bigtreetech/BIGTREETECH-SKR-PRO-V1.1/manual/SKR-PRO-V1.1-Wiring diagram.jpg

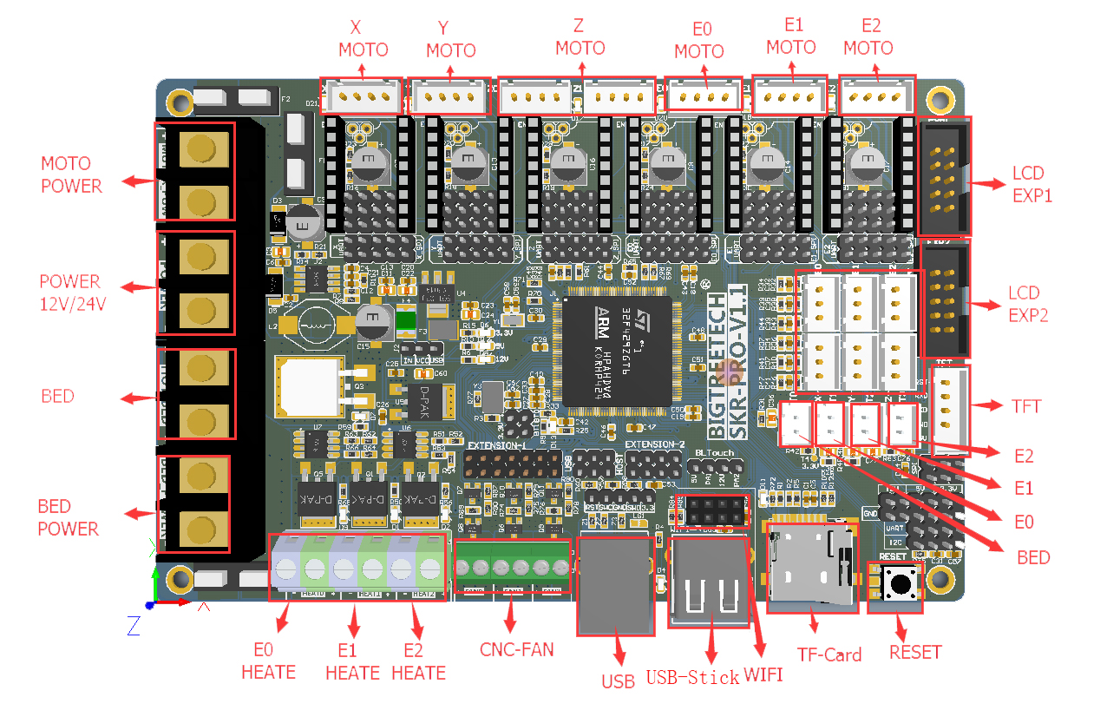
manual/SKR-PRO-V1.1-Wiring diagram.jpg
