bigtreetech/BIGTREETECH-SKR-PRO-V1.1/SKR-PRO-V1.2/manual/SKR-PRO-V1.2-Wiring diagram.jpg

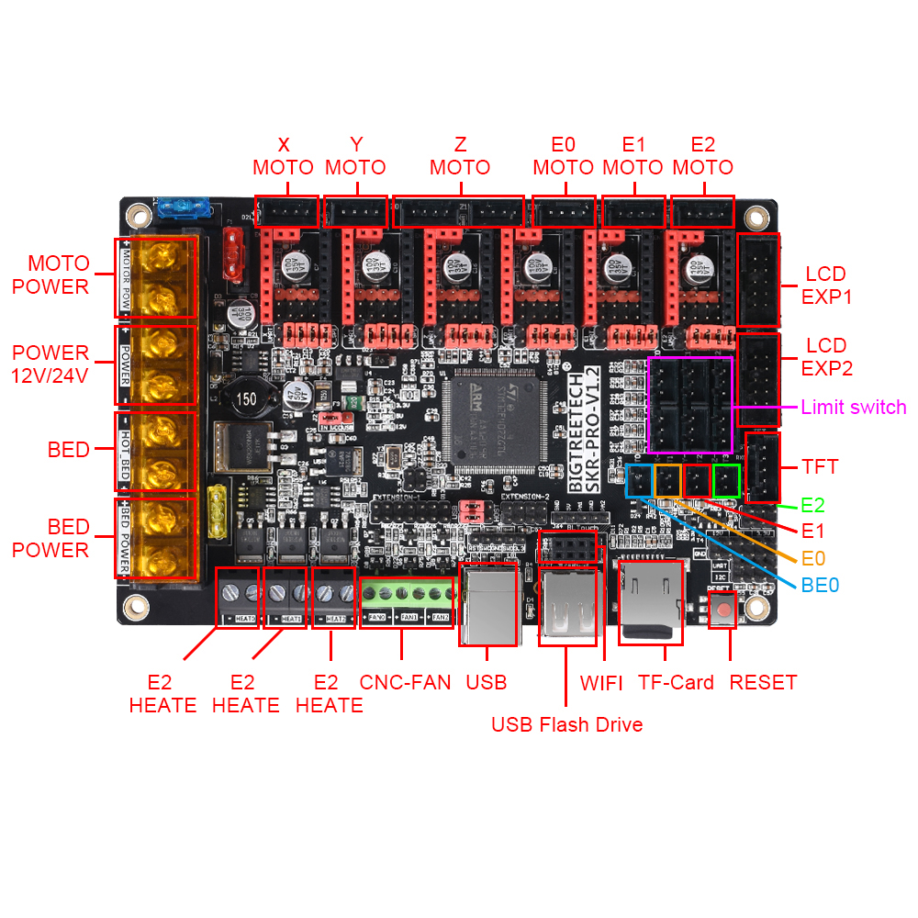
SKR-PRO-V1.2/manual/SKR-PRO-V1.2-Wiring diagram.jpg
