bigtreetech/BIGTREETECH-SKR-PRO-V1.1/README.md

# BIGTREETECH-SKR-PRO-V1.1
Aiming at some problems existing in 3D printed motherboards in the market. Bigtree Technology Co., Ltd. launched a high performance 3D printer master board with STM32F407ZGT6 as the core controller, BIGTREETECH-SKR-PRO-V1.1.
