bigtreetech/BIGTREETECH-SKR-PRO-V1.1/firmware/Readme.md

1. Sometimes an error occurs when compiling this branch for the first time. Please Close vscode and reopen, then compiling will be normal.
2. if you are downloaded from Marlin bugfix-2.0.x Official version. Please modify [here](https://github.com/bigtreetech/BIGTREETECH-SKR-PRO-V1.1/blob/9ae95e478c74dc1e5c7fec6d94e13c3bedf2169f/firmware/Marlin-SKR-Pro/platformio.ini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) from `TMCStepper@<1.0.0` to `https://github.com/bigtreetech/TMCStepper`. 
This is because the UART of tmc2208/2209 has not yet been merged into the official version, please use this method before merged

Note: if you want to design your own version naming rules, folder names must not exceed 64 characters in length, 
marlin 2.0 project files in other folders, folder nesting depth can not exceed 3, 
otherwise, when opening the project compilation project, there will be unexpected compilation errors!
It is recommended that the file name should not be named too long, the shorter the better. 
File nesting depth should not be too much, the less nesting, the better.
