bigtreetech/BIGTREETECH-SKR-PRO-V1.1/picture/BIGTREETECH-SKR-PRO-V1.1.jpg

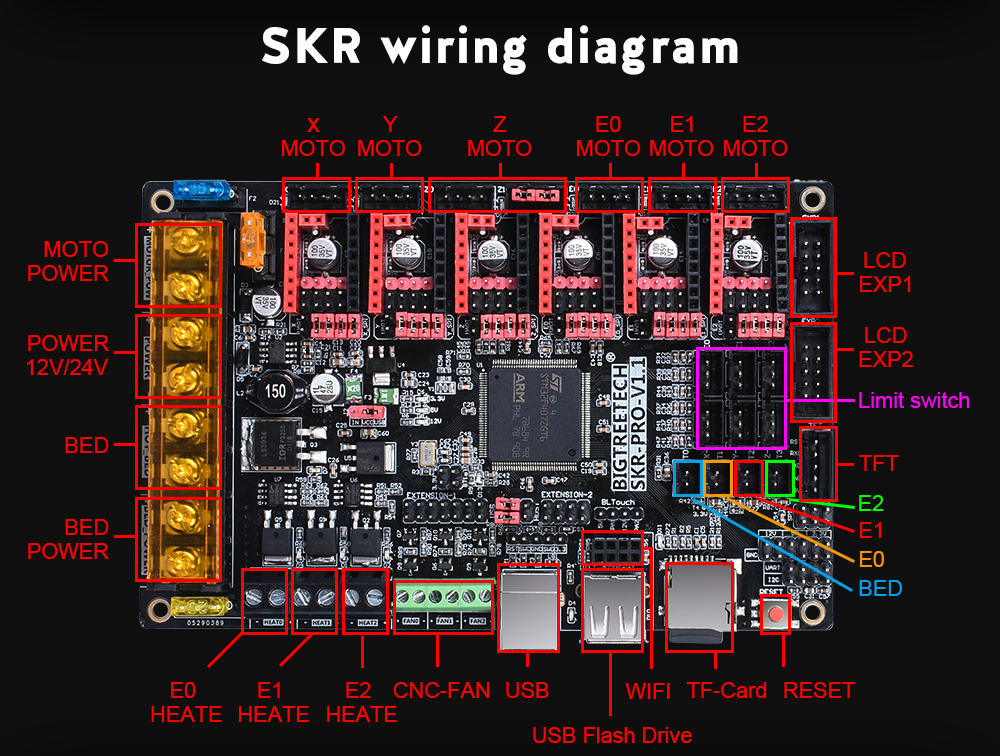
picture/BIGTREETECH-SKR-PRO-V1.1.jpg
