bigtreetech/BIGTREETECH-SKR-PRO-V1.1/picture/SKR PRO V1.1-1.png

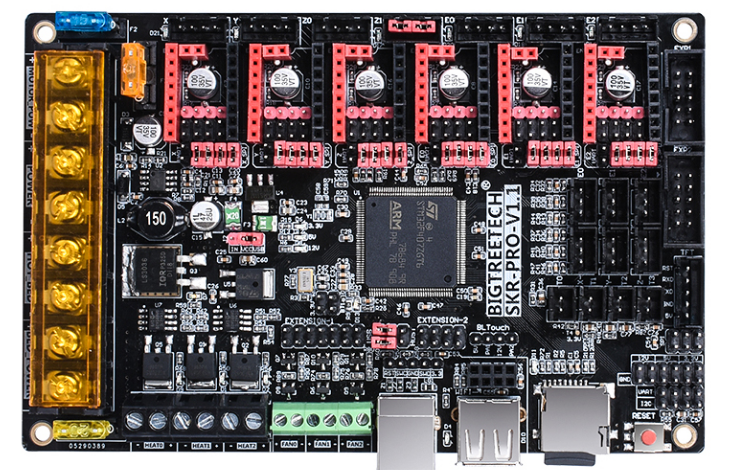
picture/SKR PRO V1.1-1.png
