bigtreetech/BIGTREETECH-SKR-PRO-V1.1/picture/SKR PRO V1.1-BOTTOM.png

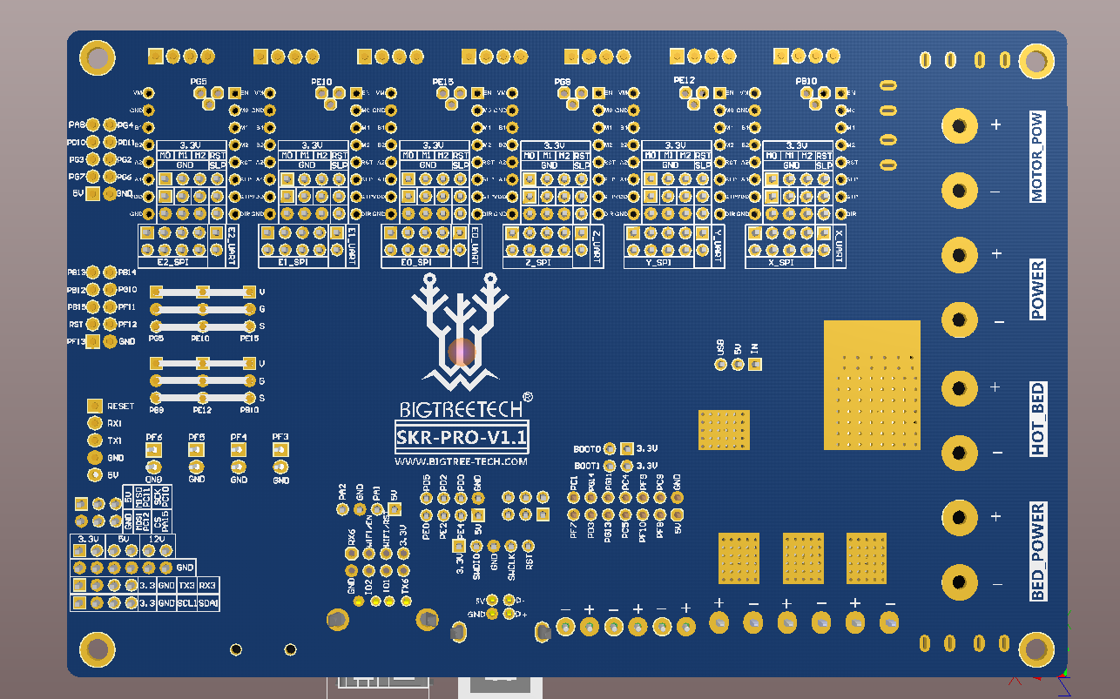
picture/SKR PRO V1.1-BOTTOM.png
