bigtreetech/BIGTREETECH-SKR-PRO-V1.1/picture/SKR PRO V1.1-TOP.png

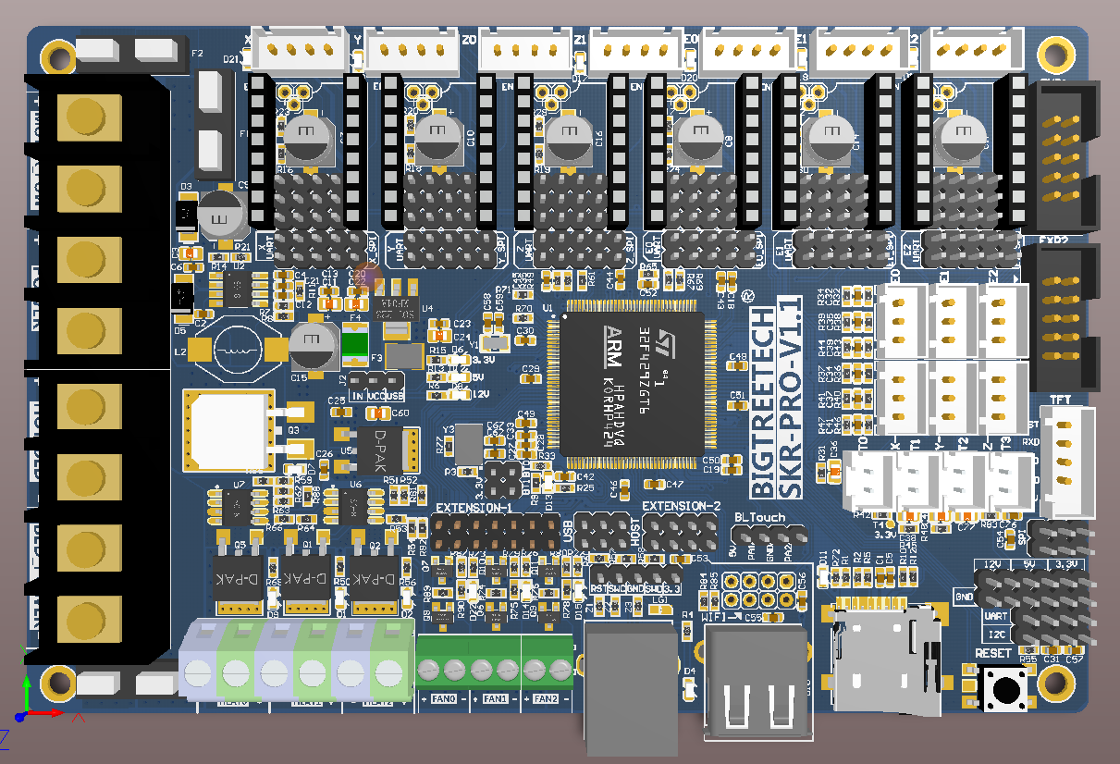
picture/SKR PRO V1.1-TOP.png
