bigtreetech/BIGTREETECH-SKR-PRO-V1.1/SKR-PRO-V1.2/picture/BIGTREETECH-SKR-PRO-V1.2_02.png

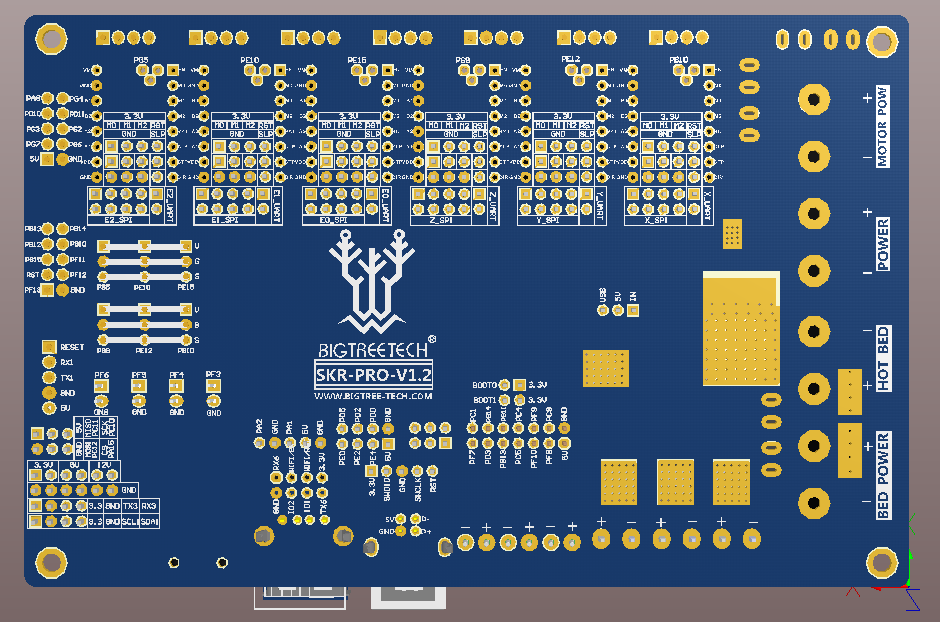
SKR-PRO-V1.2/picture/BIGTREETECH-SKR-PRO-V1.2_02.png
