bigtreetech/BIGTREETECH-SKR-PRO-V1.1/models/SKR-Pro-1.1-Complete-board.stl

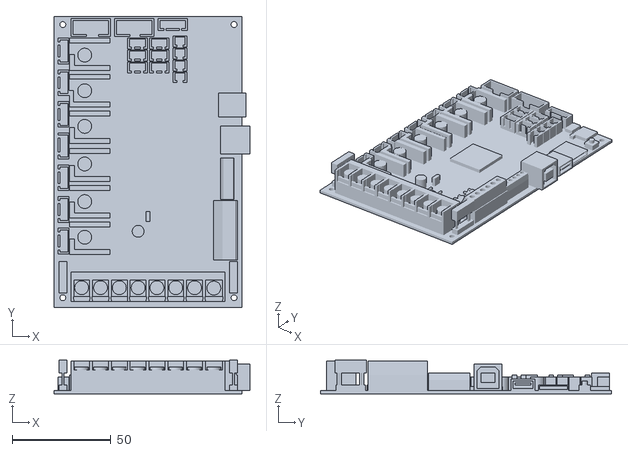
[picture p12: CAD file, 2019-07-18]
models/SKR-Pro-1.1-Complete-board.stl
99.0 x 147.0 x 17.1
