bigtreetech/BIGTREETECH-SKR-PRO-V1.1/SKR-PRO-V1.2/manual/SKR-PRO-V1.2-user manual.pdf

SKR-PRO-V1.2 User Manual Shenzhen Biqu Technology Co., Ltd.

Shenzhen City Fun Technology 1/18 | Website: www.BIGTREE-TECH.com

SHENZHEN BIGTREE TECHNOLOGY CO., LTDBIG TREE TECH

# BIGTREETECH

# SKR-PRO-V1.2

# user manual

SKR Pro V1.2 User Manual Shenzhen Biqu Technology Co., Ltd.

2 / 18

### Ⅰ、Product introduction

Aiming at some problems existing in 3D printed motherboards in

the market. Bigtree Technology Co., Ltd. launched a high

performance 3D printer master board with STM32F407ZGT6 as the

core controller, BIGTREETECH-SKR-PRO-V1.2.

### Ⅱ、the motherboard features

1) The main control uses the ARM-level Cortex-M4 series with a 32-bit dominant frequency of 168 MHz STM32F407ZGT6 chip, performance is greatly improved;
2) Equipped with highly modular open source firmware Marlin2.0, it

is convenient for users to DIY and further-development, to avoid

the worry of not being able to master the core code;

3) Visual Studio Code is a powerful development tool for Marlin2.0.

Its integrated development environment has the following

advantages: it supports online debugging, which is more helpful for

product development and performance optimization, and uses C

language for development, which is easy to get started.

4)The PCB board layout is rigorous and beautiful, and it is specially designed for heat dissipation.

5)Using a dedicated power chip, support 12-24V power input,

3 / 18

output current 3A.

6)With 24V input and the same power, the hot bed current can be

reduced to 1/4, effectively solving the heating problem of hot bed

MOS tube.

7) BIGTREETECH-2.8-inchTFT, and BIGTREETECH-3.5-inchTFT color touch screens are compatible, as are LCD2004 and LCD12864 screens.
8) The system supports Chinese simplified Chinese, English and other languages, which can be switched by itself.

9)The firmware is upgraded by SD card, which is simple, convenient and efficient.

10) Support Serial WIFI Online Printing.
11) 6 motor drives, 3 extruders, 3 CNC fans.
12) It has the following functions: data can be saved when power is cut off, materials can be discovered when broken, and works can be turned off when finished.
13) High performance MOSFET tube, better heat dissipation effect.
14) Using removable fuse to make the replacement process easier.
15) Reserve extended ports of BL Touch, PWM, ADC, UART, I2C and SPI.
16) Use the power supply option to separate the USB power supply from the switching power supply, which can effectively prevent the

4 / 18

computer USB port from being burnt due to a short circuit.
17) The special function interface uses a color-conspicuous row

pin to greatly reduce the error rate of the wiring.

18) As many as 20 expansion ports can be reserved, and extended ports can be used to add more features to the printer without worrying about the shortage of motherboard ports.

19)Support offline printing and online printing.

20) Support for dual Z axis printers (series dual Z).

### Ⅲ、Motherboard parameters

1)Appearance size: 147*95mm

2) Installation size:138 * 86.5 mm
3) Microprocessor: ARM 32-bit Cortex / M4 CPU
4) Input voltage: DC12V-DC24V

5)Motor driver support :TMC5160,TMC2208,TMC2130,ST820,LV8729,

DRV8825,A4988, etc.

6) Driving mode support: TMC2130SPI, TMC5160SPI, TMC2208 UART

5 / 18

7)Motor drive interface: X, Y, Z, E0, E1, E2,total 6 channels.

8) Temperature sensor interface: T0, T1, T2, T3 total 4 channels

100K NTC .(thermal resistance)

9) Display screen: BIGTREETECH- 2.8 inch TFT,BIGTREETECH-3.5

inch TFT, LCD2004,LCD12864

10) PC communication interface: square USB, convenient to plug and unplug, communication baud rate is 11520
11) Support Expansion Port: Automatic Shutdown Module After Printing , Power Off Resume Print Module , Filament break detection and Automatic leveling,
BL Touch, WIFI, PWM, ADC, UART, I2C and SPI,etc.

12)Support file format: g-code

13) Support machine structure: XYZ, delta, kossel, Ultimaker, corexy

14)Recommended software: Cura, Simplify3D, pronterface, Repetier-host, Makerware

15) multiple power supply, sharing the pressure of single power line under current.

### Ⅳ、Content of the upgrade

1） Change the hot bed interface screen printing;

6 / 18

2） | Change the position of the hot bed fuse, effectively deal
| with the overheating of the PCB at the bottom of the fuse
| when the hot bed is heated;
3） | Analog quantity (AD) input increased clamping diode,
| effectively protect the chip;

### Ⅴ、mainboard power selection

1. Power jumper cap selection
①USB power supply | ↓ | ②12/24 v power supply↓

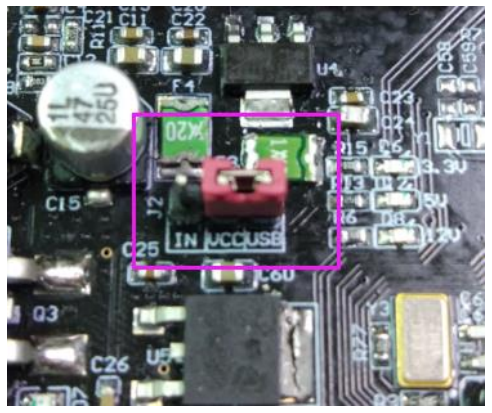
[picture p21: figure]
mainboard power selection
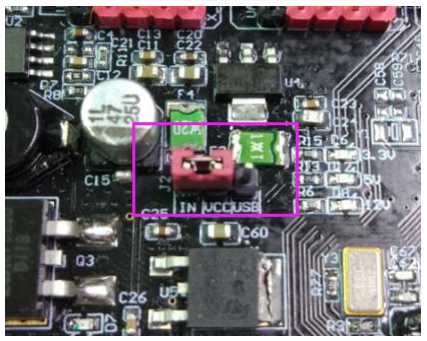
[picture p22: figure]

1)As shown in the red box, when the jumper cap is

connected to IN and VCC, the motherboard selects 12V/24V

power supply; when the jumper cap is connected to USB

and VCC, the motherboard selects USB power supply.

2) If the jumper cap has USB power selected, the 5V and

3.3V indicators will also light.

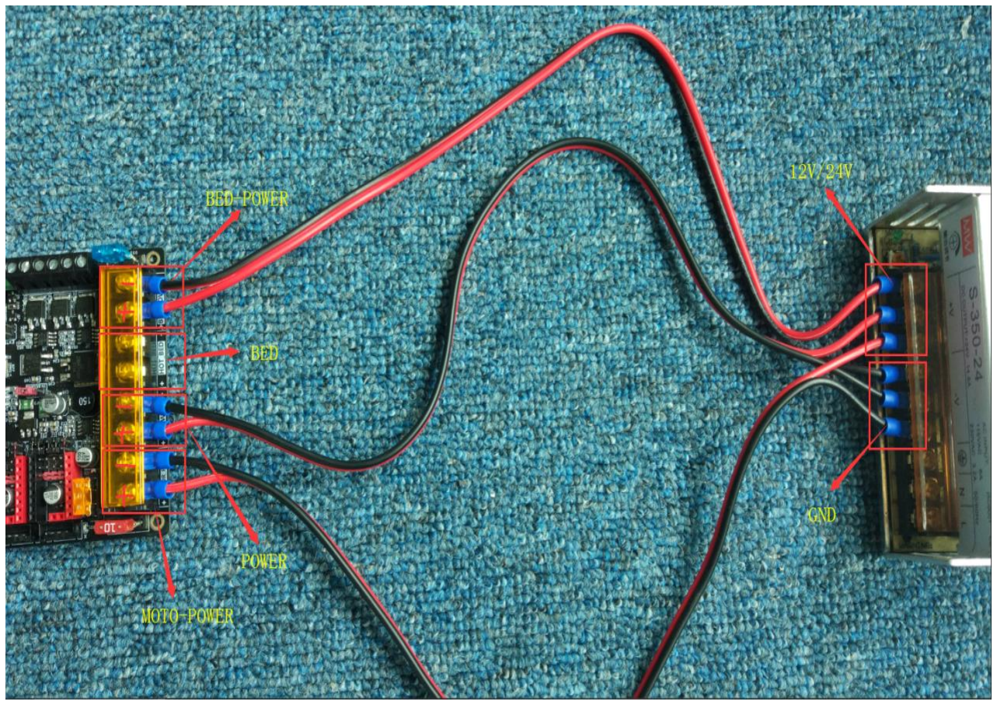
[picture p23: figure]

7 / 18

3) When the main board is powered by 12V/24V, the 12V

indicator will be lit. If the jumper cap has 12V/24V power

supply, the 3.3V, 5V and 12V indicators will be illuminated.

### Ⅵ、mainboard power wiring methods

1. Three Power supply method of switching Power supply

As shown above, three sets of power lines need to be

connected to the motherboard, namely, motor power supply,

hot bed power supply and motherboard power supply, and

the extra group is hot bed interface.

8 / 18

When connecting, be sure to disconnect the 220V power

supply and distinguish the positive and negative electrodes so

as not to burn out the motherboard.

### Ⅶ 、 Communication between motherboard and

### computer

After the motherboard is connected to the computer

through the USB cable, the computer will automatically install

the driver. In this case,the motherboard can be identified for

data transmission. If the installation fails, we can go to our

open source Web site:

https://github.com/bigtreetech?tab=repositories to find the

corresponding motherboard download driver.

After the drive installation is completed, open

the``Device Manager ”to see the port as shown in the figure

below, which indicates that the system board is properly

connected to the computer.

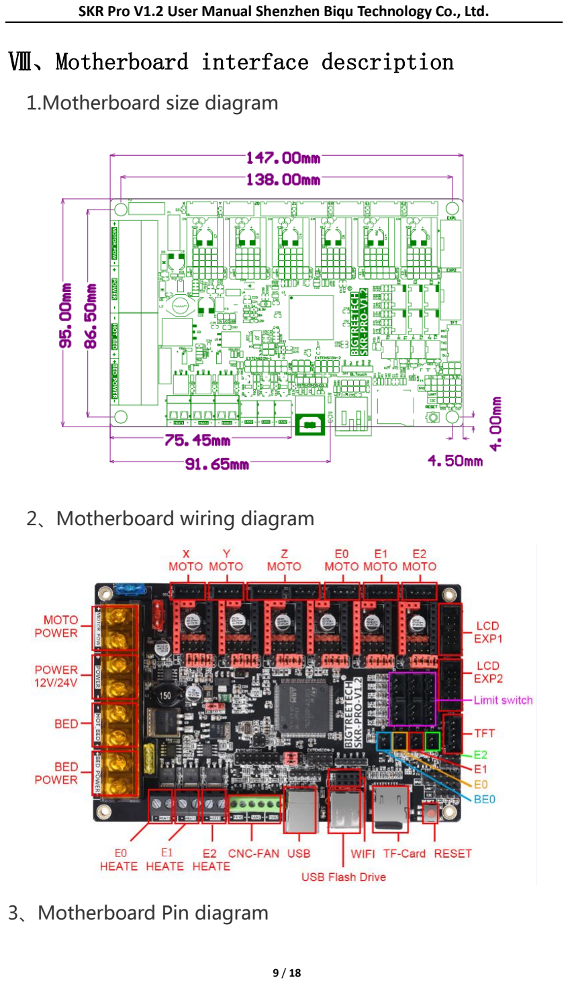
[picture p24: page 9]

9 / 18

### Ⅷ、Motherboard interface description

1.Motherboard size diagram

2、Motherboard wiring diagram

3、Motherboard Pin diagram

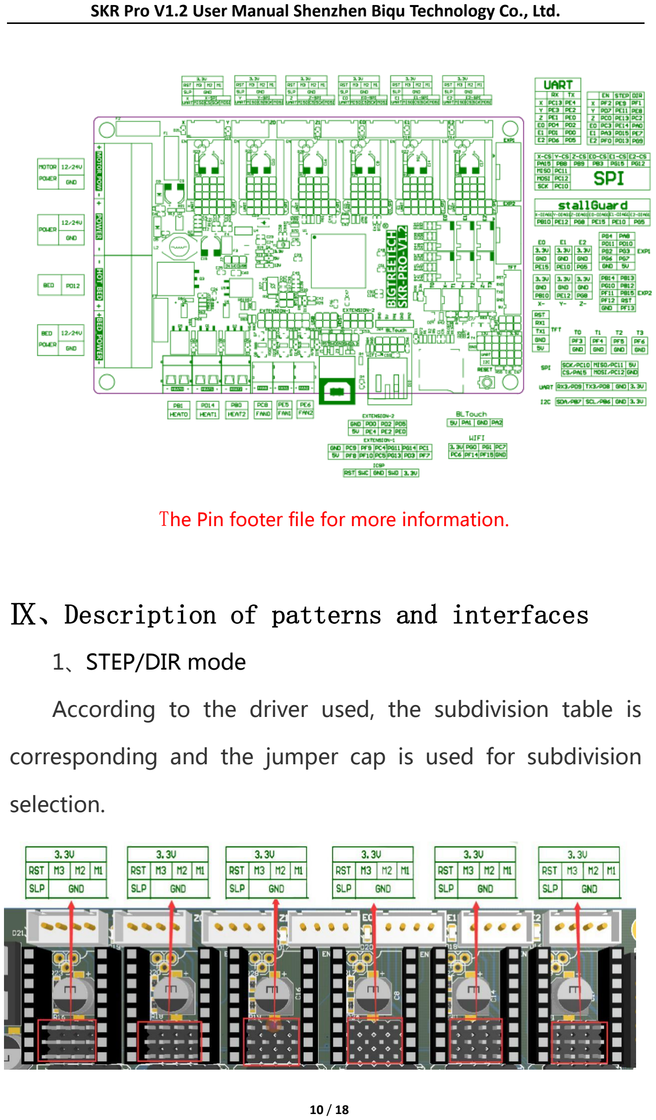
[picture p25: page 10]

10 / 18

The Pin footer file for more information.

### Ⅸ、Description of patterns and interfaces

1、STEP/DIR mode

According to the driver used, the subdivision table is

corresponding and the jumper cap is used for subdivision

selection.

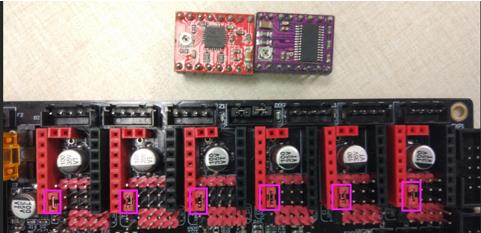
[picture p26: figure]

11 / 18

Note: the high level is connected to the above two row

needles, and the low level is connected to the following two

rows of needles.

2、A4988 and 8825 driver instructions

If the drive is using A4988 or 8825, it is necessary to short

the two pins in the purple box with the jumper cap (as shown).

If it is not A4988 or 8825, the jumper cap in the box needs to

be pulled out.

3、UART mode

When using UART mode, you need to short the needle in

the red box with a jumper cap.

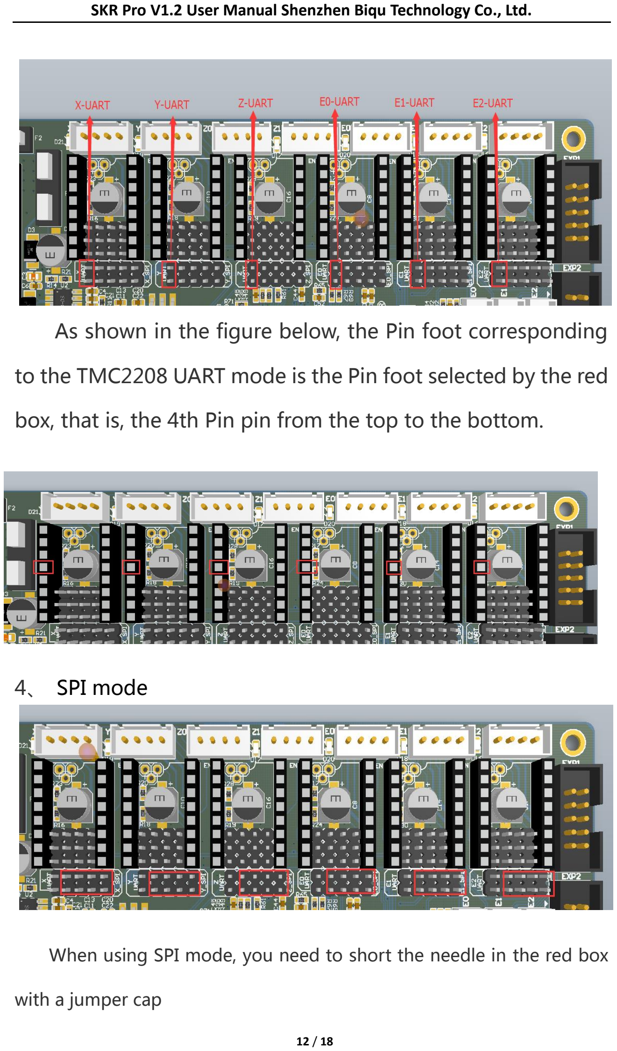
[picture p27: page 12]

12 / 18

As shown in the figure below, the Pin foot corresponding

to the TMC2208 UART mode is the Pin foot selected by the red

box, that is, the 4th Pin pin from the top to the bottom.

4、 SPI mode

When using SPI mode, you need to short the needle in the red box

with a jumper cap

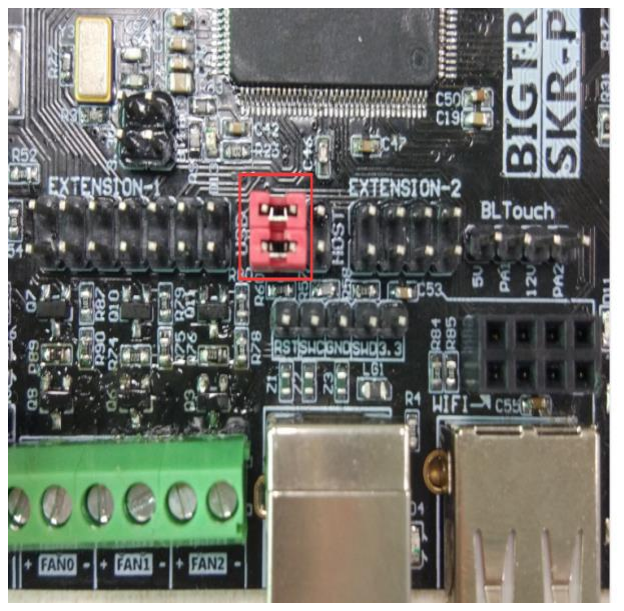
[picture p28: figure]

13 / 18

5, USB and U disk selection

As shown in the picture, when the jumper cap is

connected to the left, the USB function is turned on while

the USB flash drive function is turned off; when the jumper

cap is connected to the right, the USB flash drive function is

turned on, and the USB function is turned off.

Note: at present, the firmware does not support the USB disk

function for the time being.

①USB online printing function↓ | ② U disk function↓

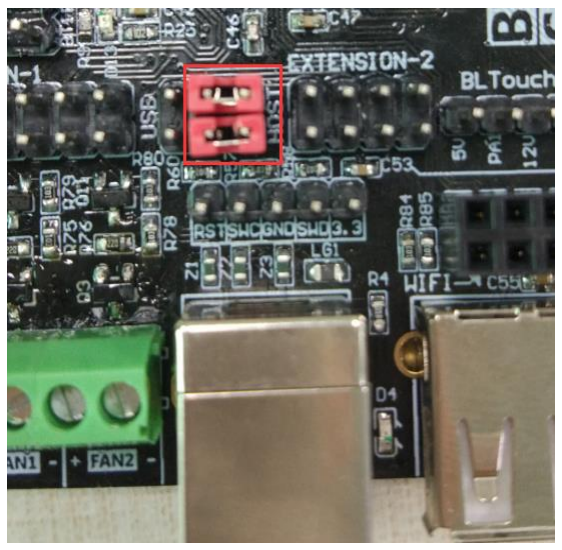
[picture p29: figure]

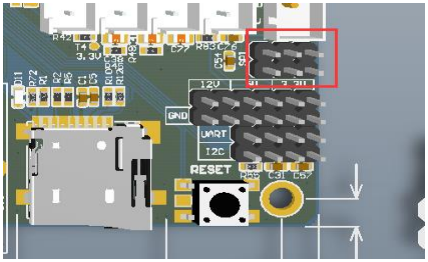
[picture p30: figure]
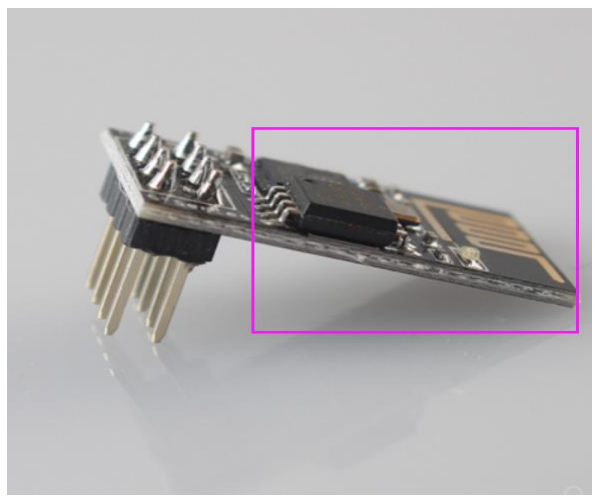
[picture p31: figure]

14 / 18

6、SPI expansion port.

The SPI expansion port shares IO with the SPI mode of the

driver and can only be used if the SPI mode driver is not used.

7、WIFI interface

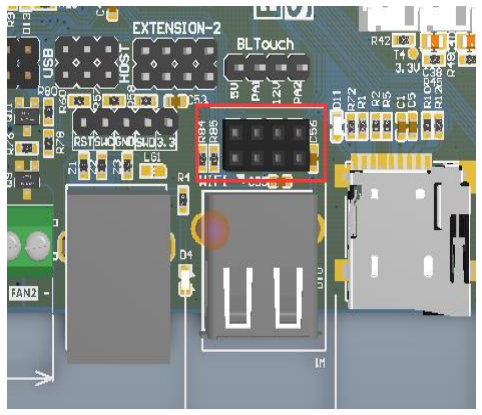
[picture p32: figure]

The WIFI interface is as shown in the picture above. When

the WIFI is inserted, the edge of the board shown by the purple

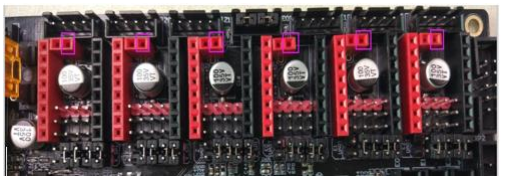
[picture p33: figure]
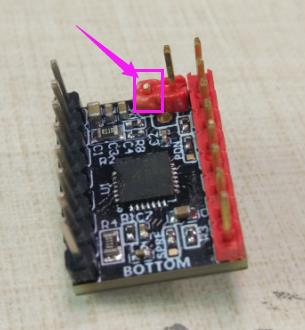
[picture p34: figure]

15 / 18

box on the right side faces outward and is inserted vertically.

8、stallguard pin description

As shown in the picture below, the purple box is the stall pin

corresponding to the stall detection.

Take the TMC2209 as an example. When the stallguard

function is not used, the stallguard pin of the TMC2209 needs

to be cut off so that the mechanical switch can work normally.

The operation method is as shown below:

①Before cutting↓ | ②After cutting↓

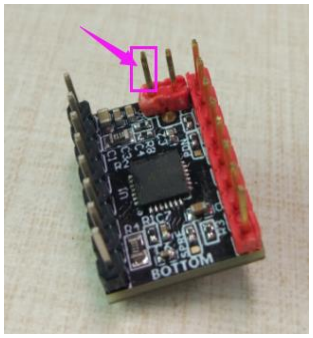
[picture p35: figure]

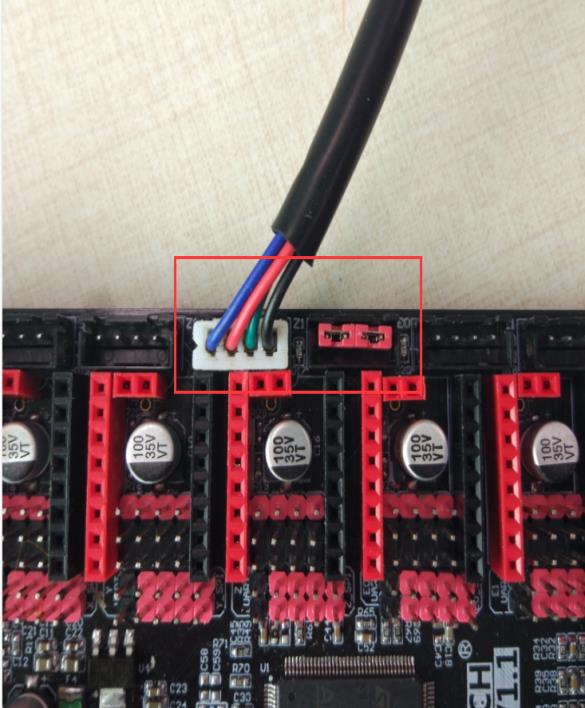
[picture p36: figure]
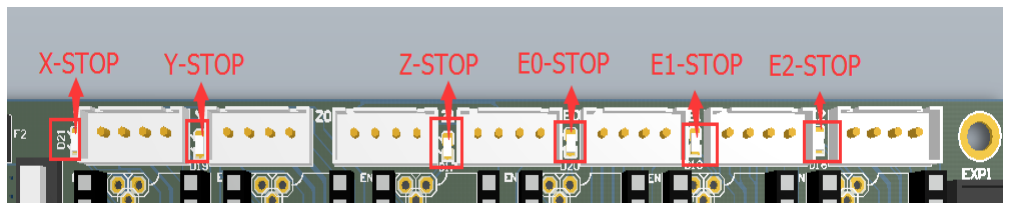
[picture p37: figure]

16 / 18

This function pin needs to be trimmed only when the

stallguard function is not used.

9、Double Z-axis connection description

①Single Z connection↓ | ②Double Z-axis connection ↓

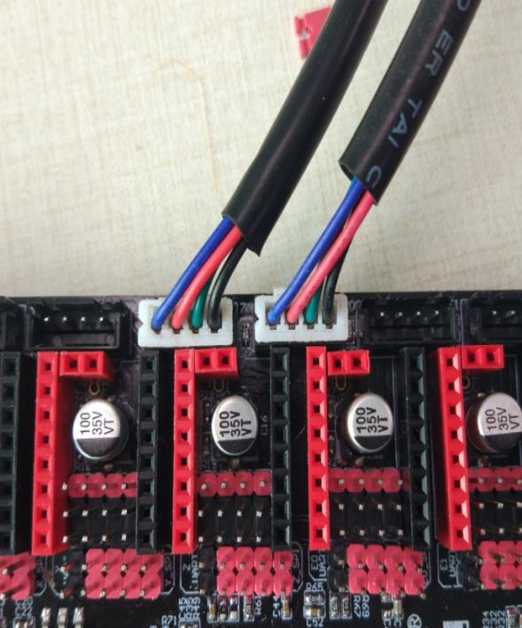
[picture p38: figure]

10、Description of the indicator light for the limit switch

The status indicator is the normally closed limit switch

indicator.

First: The indicator light is always on when the limit switch is

not connected

Second: When the normally closed limit switch is connected,

17 / 18

the indicator light is off, and when it is triggered, the indicator

light is illuminated.

Third: When the normally open limit switch is connected,

the indicator light is always on, and when it is triggered, the

indicator light is off.

### Ⅹ、motherboard firmware description

1) Currently only supports our open source Marlin2.0 firmware,

please go to our open source website:

https://github.com/bigtreetech?tab=repositories

Find the corresponding motherboard to download.

2) Marlin2.0 firmware update method:

After downloading our open source Marlin2.0 firmware, use

Visual Studio Code to open the project for compilation, then

find the firmware.bin file, copy it to the SD card, and then reset

the motherboard for about 10 seconds. (You can also

download firmware.bin directly)

For detailed steps, please refer to the tutorial:

https://www.dropbox.com/s/ppjfflhf3j5yzh2/MarlinV2.0%20SKRV

1.1%20instruction.docx?dl=0 (https://www.dropbox.com/s/ppjfflhf3j5yzh2/MarlinV2.0%20SKRV1.1%20instruction.docx?dl=0)

18 / 18

### XI 、Notes

1、Currently, only our company's open source firmware

Marlin2.0 is supported.

2、U-disk functionality is not supported for the time being.

so stay tuned!

3、 The power of the hot bed connected to the motherboard

must be less than or equal to 180W ( the thermal bed

resistance value is greater than 0.8)

4、when the motherboard is supplied with 12V/24V power

supply, be sure to pay attention to the positive and negative

poles of the power supply.

5、The firmware file name in the SD card cannot be changed,

including capitalization.

6. Ensure that all wires, jumper caps and drivers are correctly

plugged in before power-on.

7. Do not plug or unplug the drive module with power to

avoid damage.

8. When wiring the motherboard, be sure to pay attention to

the positive and negative power supply, drive direction, power

supply selection, etc., in order to power on.
