bigtreetech/BIGTREETECH-SKR-PRO-V1.1/(threads)

Thread 1 (2019-07-04):

I can not compile Marlin 2

sn0wrider, 2019-07-04:
Hello to all,
 I can not compile Marlin 2 for BIGTREETECH-SKR-PRO-V1.1:

In file included from Marlin\src\module/stepper.h:221:0,
from Marlin\src\Marlin.cpp:37:
Marlin\src\module/stepper_indirection.h:59:12: fatal error: TMCStepper.h: No such file or directory

********************************************************************
* Looking for TMCStepper.h dependency? Check our library registry!

*
* CLI  > platformio lib search "header:TMCStepper.h"
* Web  > https://platformio.org/lib/search?query=header:TMCStepper.h
*
********************************************************************

#include <TMCStepper.h>
^~~~~~~~~~~~~~
compilation terminated.
*** [.pioenvs\black_stm32f407ve\src\src\Marlin.cpp.o] Error 1
In file included from Marlin\src\core\utility.cpp:25:0:
Marlin\src\core\../Marlin.h:363:29: error: 'pin_t' does not name a type; did you mean 'pid_t'?
bool pin_is_protected(const pin_t pin);
^~~~~
pid_t
*** [.pioenvs\black_stm32f407ve\src\src\core\utility.cpp.o] Error 1
 [ERROR] Took 31.72 seconds

but if you do a search in platformi:

platformio lib search "header:TMCStepper.h"
>>
Found 1 libraries:

TMCStepper
==========
#ID: 5513
Arduino library for configuring Trinamic stepper drivers.

Keywords: tmc, trinamic, stepper, driver, spi, uart, tmc2130, tmc2160, tmc2208, tmc2224, tmc2660, tmc5130, tmc5160, tmc5161
Compatible frameworks: Arduino
Compatible platforms: Atmel AVR, Atmel SAM, Espressif 32, Espressif 8266, Infineon XMC, Intel ARC32, Kendryte K210, Microchip PIC32, Nordic nRF51, Nordic nRF52, ST STM3
2, ST STM8, Teensy, TI MSP430
Authors: teemuatlut

what could be the problem????
Best rgs
Alex

gyutacs0804, 2019-07-04:
I have the same issue.

gyutacs0804, 2019-07-04:
That is what I get when try to compile:

^~~~~
pid_t
*** [.pioenvs\BIGTREE_SKR_PRO\src\src\core\utility.cpp.o] Error 1
Marlin\src\Marlin.cpp:249:29: error: 'pin_t' does not name a type; did you mean 'pid_t'?
bool pin_is_protected(const pin_t pin) {
^~~~~
pid_t

Marlin\src\Marlin.cpp: In function 'bool pin_is_protected(int)':
Marlin\src\Marlin.cpp:250:16: error: 'pin_t' does not name a type; did you mean 'pid_t'?
static const pin_t sensitive_pins[] PROGMEM = SENSITIVE_PINS;
^~~~~
pid_t
In file included from Marlin\src\inc/MarlinConfigPre.h:32:0,
from Marlin\src\inc/MarlinConfig.h:28,
from Marlin\src\Marlin.h:24,
from Marlin\src\Marlin.cpp:31:
Marlin\src\Marlin.cpp:251:33: error: 'sensitive_pins' was not declared in this scope
for (uint8_t i = 0; i < COUNT(sensitive_pins); i++) {
^
Marlin\src\inc/../core/macros.h:193:37: note: in definition of macro 'COUNT'
#define COUNT(a)            (sizeof(a)/sizeof(*a))
^
compilation terminated due to -fmax-errors=5.
*** [.pioenvs\BIGTREE_SKR_PRO\src\src\Marlin.cpp.o] Error 1

yangwenxiong, 2019-07-05:
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

[](url)

yangwenxiong, 2019-07-05:
@gyutacs0804  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

yangwenxiong, 2019-07-05:
@gyutacs0804   In fact, this place should not be changed here. When using tmc2208uart mode, this place needs to be shielded.Since the original marlin 2.0 firmware does not support tmc2208 uart, it is now implemented in Pro. However, a new 2208 SoftwareSerial port driver file needs to be added. The files to be added are already in the SoftwareSerial folder.C:\Users\BiQu_\. PlatformIO \packages\framework-arduinoststm32\cores\arduino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

yangwenxiong, 2019-07-05:
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
@sn0wrider Hi, I have encountered this compilation error on your side. It is likely that there are other bugs in marlin 2.0. This may need to be tested by marlin officials, but I later found that the compilation passed by adding an electric hangar file.The files that need to be added are all uploaded to the firmware folder, and the add path is as follows 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

Msq001, 2019-07-05:
sorry, it be updated， and it should be ok now, please download the Latest version, and Pay attention to the Readme.md

gyutacs0804, 2019-07-05:
There is no Marlin in the Firmware folder now.

sn0wrider, 2019-07-05:
Hi i'm dowwnload latest Marlin from BIGTREETECH and fully compiled

Msq001, 2019-07-05:
Thank you for your patience. This weekend we will create a PR to merge SKR Pro into the main branch of marlin 2.0.x. and we will also create a PR to TMC library file to support the UART mode of tmc2208. Before this, you need to manually copy the files in the SoftwareSerial folder to the platformio library directory, see [readme.md](https://github.com/bigtreetech/BIGTREETECH-SKR-PRO-V1.1/blob/master/firmware/Readme.md)

Closed 2019-07-05.

Thread 3 (2019-07-06):

Compiling SUCCESSFULL

apohl23, 2019-07-06:
Hello,

I have some problems with compiling the firmware. I followed the instructions as they described. However, there are also errors (letters exchanged) within some files which I could correct to some extent.
I still don't get the board compiled because there is always a Collect2.exe error. Also in the line 166:40 in the tmc_util.h where it probably goes over the TX and RX channels...

Exact description:

Marlin\src\module\.../feature/tmc_util.h:166:40: error: no matching function for call to 'TMC2208Stepper: :TMC2208Stepper(const uint16_t&, const uint16_t&, const float&, const bool&)'
TMC2208Stepper(RX, TX, RS, has_rx)

Msq001, 2019-07-06:
hello.  are you use tmc2208 uart mode?  have you copy the 3 softwareserial files to platformio install path and comment out pin_t in hal.h file according the readme.md.

Msq001, 2019-07-06:
oh. maybe the sw_capability_platform need be updated too.  i will creat a pr for tmc220x uart in tmc library code. and it will solve this issue.   this pr will creat a softwareserial in tmc library. and it will be a generic code for most of 32 bit motherboard.

apohl23, 2019-07-07:
Hello and thank you for your reply.

I am using the Bigtreetech TMC2208 v3 UART driver
please help me thank you

I have reinstalled all libraries and PlatformIO...
i have followed all instructions as described in their description
I keep getting these mistakes

In file included from C:\users\apohl\.platformio\packages\framework-arduinoststm32\cores\arduino\SoftwareSerial.cpp:47:0:
C:\users\apohl\.platformio\packages\framework-arduinoststm32\cores\arduino/SoftwareSerial.h:52:3: error: 'pin_t' does not name a type; did you mean 'pid_t'?
pin_t _receivePin;
^~~~~
pid_t
C:\users\apohl\.platformio\packages\framework-arduinoststm32\cores\arduino/SoftwareSerial.h:53:3: error: 'pin_t' does not name a type; did you mean 'pid_t'?
pin_t _transmitPin;
^~~~~
pid_t
C:\users\apohl\.platformio\packages\framework-arduinoststm32\cores\arduino/SoftwareSerial.h:91:24: error: expected ')' before 'receivePin'
SoftwareSerial(pin_t receivePin, pin_t transmitPin, bool inverse_logic = false);
^~~~~~~~~~
C:\users\apohl\.platformio\packages\framework-arduinoststm32\cores\arduino\SoftwareSerial.cpp: In member function 'bool SoftwareSerial::listen()':
C:\users\apohl\.platformio\packages\framework-arduinoststm32\cores\arduino\SoftwareSerial.cpp:100:7: error: '_receivePin' was not declared in this scope
if (_receivePin >= 0) {
Compiling .Firmware\BIGTREE_SKR_PRO\FrameworkArduino\stm32\HAL\stm32yyxx_hal_flash.c.o^~~~~~~~~~~

C:\users\apohl\.platformio\packages\framework-arduinoststm32\cores\arduino\SoftwareSerial.cpp:100:7: note: suggested alternative: 'active_in'
if (_receivePin >= 0) {
^~~~~~~~~~~
active_in
C:\users\apohl\.platformio\packages\framework-arduinoststm32\cores\arduino\SoftwareSerial.cpp: In member function 'void SoftwareSerial::setTX()':
C:\users\apohl\.platformio\packages\framework-arduinoststm32\cores\arduino\SoftwareSerial.cpp:143:18: error: '_transmitPin' was not declared in this scope
digitalWrite( _transmitPin,   _inverse_logic ? LOW : HIGH);
^~~~~~~~~~~~
compilation terminated due to -fmax-errors=5.
Compiling .Firmware\BIGTREE_SKR_PRO\FrameworkArduino\stm32\HAL\stm32yyxx_hal_flash_ex.c.o
*** [.Firmware\BIGTREE_SKR_PRO\FrameworkArduino\SoftwareSerial.cpp.o] Error 1

davidbilly, 2019-07-07:
> oh. maybe the sw_capability_platform need be updated too. i will creat a pr for tmc220x uart in tmc library code. and it will solve this issue. this pr will creat a softwareserial in tmc library. and it will be a generic code for most of 32 bit motherboard.

@Msq001 what are the value for TMC 2009

#define SW_CAPABLE_PLATFORM defined(__AVR__) || defined(TARGET_LPC1768) || defined(ARDUINO_ARCH_ESP32) || defined(WHAT IS THE VALUE FOR THIS??)

It's ridiculous release product such way, I have to debug 1 by 1 and fixing ur bug.

davidbilly, 2019-07-07:
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

@apohl23 for this you have to uncomment typedef int16_t pin_t; at line 44 on SoftwareSerial.h

and go HAL_STM32/HAL.h line 135 change typedef int8_t pin_t;  to typedef int16_t pin_t;

apohl23, 2019-07-07:
@davidbilly I followed the instructions.

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

davidbilly, 2019-07-07:
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

Its remove errors for me, did you replace to C:\Users\xxxxx\.platformio\packages\framework-arduinoststm32\cores\arduino ?

Msq001, 2019-07-09:
have update firmware, tmc2208 now is tested ok, and tmc2009 Compiling success,  But the actual work seems abnormal.

apohl23, 2019-07-10:
Hi I'm still getting bugs for the TMC2208 UART drivers.

I'm already despairing if it works at all...

i also tested it with the DRV8825 because everything went through without problems, but it is not shown on the display after flashing. it only lights up, but no text

here is the complete error code

> Executing task: C:\Users\apohl\.platformio\penv\Scripts\platformio.exe run <

Processing BIGTREE_SKR_PRO (platform: ststm32; board: BigTree_SKR_Pro; framework: arduino)
---------------------------------------------------------------------------------------------------------------------------------------------------------------------------------------------------------------------------------------------------------------------------------------------------------------------
Verbose mode can be enabled via `-v, --verbose` option
CONFIGURATION: https://docs.platformio.org/page/boards/ststm32/BigTree_SKR_Pro.html
PLATFORM: ST STM32 > STM32F407ZG (192k RAM. 1024k Flash)
HARDWARE: STM32F407ZGT6 168MHz 192KB RAM (1MB Flash)
DEBUG: CURRENT(cmsis-dap) EXTERNAL(cmsis-dap, jlink, stlink)
Converting Marlin.ino
Library Dependency Finder -> http://bit.ly/configure-pio-ldf
LDF MODES: FINDER(chain) COMPATIBILITY(soft)
Collected 20 compatible libraries
Scanning dependencies...
Dependency Graph
|-- <U8glib-HAL> 0.4
|   |-- <SPI> 1.0
|   |-- <Wire> 1.0
|-- <LiquidCrystal> 1.3.4
|   |-- <Wire> 1.0
|-- <TMCStepper> 0.4.5 #7fda12f
|   |-- <SPI> 1.0
|-- <30aa480>
|   |-- <Wire> 1.0
|-- <Arduino-L6470> 0.7.0
|-- <SPI> 1.0
|-- <EEPROM> 2.0.1
|-- <IWatchdog> 1.0.0
|-- <Servo> 1.1.4
|-- <Wire> 1.0
Compiling .pioenvs\BIGTREE_SKR_PRO\FrameworkArduinoVariant\PeripheralPins.c.o
Compiling .pioenvs\BIGTREE_SKR_PRO\FrameworkArduinoVariant\variant.cpp.o
Compiling .pioenvs\BIGTREE_SKR_PRO\FrameworkArduino\HardwareSerial.cpp.o
Compiling .pioenvs\BIGTREE_SKR_PRO\FrameworkArduino\IPAddress.cpp.o
Compiling .pioenvs\BIGTREE_SKR_PRO\FrameworkArduino\Print.cpp.o
Compiling .pioenvs\BIGTREE_SKR_PRO\FrameworkArduino\RingBuffer.cpp.o
Compiling .pioenvs\BIGTREE_SKR_PRO\FrameworkArduino\Stream.cpp.o
Compiling .pioenvs\BIGTREE_SKR_PRO\FrameworkArduino\Tone.cpp.o
Compiling .pioenvs\BIGTREE_SKR_PRO\FrameworkArduino\USBSerial.cpp.o
Compiling .pioenvs\BIGTREE_SKR_PRO\FrameworkArduino\WInterrupts.cpp.o
Compiling .pioenvs\BIGTREE_SKR_PRO\FrameworkArduino\WMath.cpp.o
Compiling .pioenvs\BIGTREE_SKR_PRO\FrameworkArduino\WSerial.cpp.o
Compiling .pioenvs\BIGTREE_SKR_PRO\FrameworkArduino\WString.cpp.o
Compiling .pioenvs\BIGTREE_SKR_PRO\FrameworkArduino\abi.cpp.o
Compiling .pioenvs\BIGTREE_SKR_PRO\FrameworkArduino\avr\dtostrf.c.o
Compiling .pioenvs\BIGTREE_SKR_PRO\FrameworkArduino\board.c.o
Compiling .pioenvs\BIGTREE_SKR_PRO\FrameworkArduino\hooks.c.o
Compiling .pioenvs\BIGTREE_SKR_PRO\FrameworkArduino\itoa.c.o
Compiling .pioenvs\BIGTREE_SKR_PRO\FrameworkArduino\main.cpp.o
Compiling .pioenvs\BIGTREE_SKR_PRO\FrameworkArduino\new.cpp.o
Compiling .pioenvs\BIGTREE_SKR_PRO\FrameworkArduino\pins_arduino.c.o
Compiling .pioenvs\BIGTREE_SKR_PRO\FrameworkArduino\stm32\HAL\stm32yyxx_hal.c.o
Compiling .pioenvs\BIGTREE_SKR_PRO\FrameworkArduino\stm32\HAL\stm32yyxx_hal_adc.c.o
Compiling .pioenvs\BIGTREE_SKR_PRO\FrameworkArduino\stm32\HAL\stm32yyxx_hal_adc_ex.c.o
Compiling .pioenvs\BIGTREE_SKR_PRO\FrameworkArduino\stm32\HAL\stm32yyxx_hal_can.c.o
Compiling .pioenvs\BIGTREE_SKR_PRO\FrameworkArduino\stm32\HAL\stm32yyxx_hal_cec.c.o
Compiling .pioenvs\BIGTREE_SKR_PRO\FrameworkArduino\stm32\HAL\stm32yyxx_hal_comp.c.o
Compiling .pioenvs\BIGTREE_SKR_PRO\FrameworkArduino\stm32\HAL\stm32yyxx_hal_comp_ex.c.o
Compiling .pioenvs\BIGTREE_SKR_PRO\FrameworkArduino\stm32\HAL\stm32yyxx_hal_cortex.c.o
Compiling .pioenvs\BIGTREE_SKR_PRO\FrameworkArduino\stm32\HAL\stm32yyxx_hal_crc.c.o
Compiling .pioenvs\BIGTREE_SKR_PRO\FrameworkArduino\stm32\HAL\stm32yyxx_hal_crc_ex.c.o
Compiling .pioenvs\BIGTREE_SKR_PRO\FrameworkArduino\stm32\HAL\stm32yyxx_hal_cryp.c.o
Compiling .pioenvs\BIGTREE_SKR_PRO\FrameworkArduino\stm32\HAL\stm32yyxx_hal_cryp_ex.c.o
Compiling .pioenvs\BIGTREE_SKR_PRO\FrameworkArduino\stm32\HAL\stm32yyxx_hal_dac.c.o
Compiling .pioenvs\BIGTREE_SKR_PRO\FrameworkArduino\stm32\HAL\stm32yyxx_hal_dac_ex.c.o
Compiling .pioenvs\BIGTREE_SKR_PRO\FrameworkArduino\stm32\HAL\stm32yyxx_hal_dcmi.c.o
Compiling .pioenvs\BIGTREE_SKR_PRO\FrameworkArduino\stm32\HAL\stm32yyxx_hal_dcmi_ex.c.o
Compiling .pioenvs\BIGTREE_SKR_PRO\FrameworkArduino\stm32\HAL\stm32yyxx_hal_dfsdm.c.o
Compiling .pioenvs\BIGTREE_SKR_PRO\FrameworkArduino\stm32\HAL\stm32yyxx_hal_dfsdm_ex.c.o
Compiling .pioenvs\BIGTREE_SKR_PRO\FrameworkArduino\stm32\HAL\stm32yyxx_hal_dma.c.o
Compiling .pioenvs\BIGTREE_SKR_PRO\FrameworkArduino\stm32\HAL\stm32yyxx_hal_dma2d.c.o
Compiling .pioenvs\BIGTREE_SKR_PRO\FrameworkArduino\stm32\HAL\stm32yyxx_hal_dma_ex.c.o
Compiling .pioenvs\BIGTREE_SKR_PRO\FrameworkArduino\stm32\HAL\stm32yyxx_hal_dsi.c.o
Compiling .pioenvs\BIGTREE_SKR_PRO\FrameworkArduino\stm32\HAL\stm32yyxx_hal_eth.c.o
Compiling .pioenvs\BIGTREE_SKR_PRO\FrameworkArduino\stm32\HAL\stm32yyxx_hal_eth_ex.c.o
Compiling .pioenvs\BIGTREE_SKR_PRO\FrameworkArduino\stm32\HAL\stm32yyxx_hal_exti.c.o
Compiling .pioenvs\BIGTREE_SKR_PRO\FrameworkArduino\stm32\HAL\stm32yyxx_hal_fdcan.c.o
Compiling .pioenvs\BIGTREE_SKR_PRO\FrameworkArduino\stm32\HAL\stm32yyxx_hal_firewall.c.o
Compiling .pioenvs\BIGTREE_SKR_PRO\FrameworkArduino\stm32\HAL\stm32yyxx_hal_flash.c.o
Compiling .pioenvs\BIGTREE_SKR_PRO\FrameworkArduino\stm32\HAL\stm32yyxx_hal_flash_ex.c.o
Compiling .pioenvs\BIGTREE_SKR_PRO\FrameworkArduino\stm32\HAL\stm32yyxx_hal_flash_ramfunc.c.o
Compiling .pioenvs\BIGTREE_SKR_PRO\FrameworkArduino\stm32\HAL\stm32yyxx_hal_fmpi2c.c.o
Compiling .pioenvs\BIGTREE_SKR_PRO\FrameworkArduino\stm32\HAL\stm32yyxx_hal_fmpi2c_ex.c.o
Compiling .pioenvs\BIGTREE_SKR_PRO\FrameworkArduino\stm32\HAL\stm32yyxx_hal_gfxmmu.c.o
Compiling .pioenvs\BIGTREE_SKR_PRO\FrameworkArduino\stm32\HAL\stm32yyxx_hal_gpio.c.o
Compiling .pioenvs\BIGTREE_SKR_PRO\FrameworkArduino\stm32\HAL\stm32yyxx_hal_gpio_ex.c.o
Compiling .pioenvs\BIGTREE_SKR_PRO\FrameworkArduino\stm32\HAL\stm32yyxx_hal_hash.c.o
Compiling .pioenvs\BIGTREE_SKR_PRO\FrameworkArduino\stm32\HAL\stm32yyxx_hal_hash_ex.c.o
Compiling .pioenvs\BIGTREE_SKR_PRO\FrameworkArduino\stm32\HAL\stm32yyxx_hal_hcd.c.o
Compiling .pioenvs\BIGTREE_SKR_PRO\FrameworkArduino\stm32\HAL\stm32yyxx_hal_hrtim.c.o
Compiling .pioenvs\BIGTREE_SKR_PRO\FrameworkArduino\stm32\HAL\stm32yyxx_hal_hsem.c.o
Compiling .pioenvs\BIGTREE_SKR_PRO\FrameworkArduino\stm32\HAL\stm32yyxx_hal_i2c.c.o
Compiling .pioenvs\BIGTREE_SKR_PRO\FrameworkArduino\stm32\HAL\stm32yyxx_hal_i2c_ex.c.o
Compiling .pioenvs\BIGTREE_SKR_PRO\FrameworkArduino\stm32\HAL\stm32yyxx_hal_i2s.c.o
Compiling .pioenvs\BIGTREE_SKR_PRO\FrameworkArduino\stm32\HAL\stm32yyxx_hal_i2s_ex.c.o
Compiling .pioenvs\BIGTREE_SKR_PRO\FrameworkArduino\stm32\HAL\stm32yyxx_hal_irda.c.o
Compiling .pioenvs\BIGTREE_SKR_PRO\FrameworkArduino\stm32\HAL\stm32yyxx_hal_iwdg.c.o
Compiling .pioenvs\BIGTREE_SKR_PRO\FrameworkArduino\stm32\HAL\stm32yyxx_hal_jpeg.c.o
Compiling .pioenvs\BIGTREE_SKR_PRO\FrameworkArduino\stm32\HAL\stm32yyxx_hal_lcd.c.o
Compiling .pioenvs\BIGTREE_SKR_PRO\FrameworkArduino\stm32\HAL\stm32yyxx_hal_lptim.c.o
Compiling .pioenvs\BIGTREE_SKR_PRO\FrameworkArduino\stm32\HAL\stm32yyxx_hal_ltdc.c.o
Compiling .pioenvs\BIGTREE_SKR_PRO\FrameworkArduino\stm32\HAL\stm32yyxx_hal_ltdc_ex.c.o
Compiling .pioenvs\BIGTREE_SKR_PRO\FrameworkArduino\stm32\HAL\stm32yyxx_hal_mdios.c.o
Compiling .pioenvs\BIGTREE_SKR_PRO\FrameworkArduino\stm32\HAL\stm32yyxx_hal_mdma.c.o
Compiling .pioenvs\BIGTREE_SKR_PRO\FrameworkArduino\stm32\HAL\stm32yyxx_hal_mmc.c.o
Compiling .pioenvs\BIGTREE_SKR_PRO\FrameworkArduino\stm32\HAL\stm32yyxx_hal_mmc_ex.c.o
Compiling .pioenvs\BIGTREE_SKR_PRO\FrameworkArduino\stm32\HAL\stm32yyxx_hal_msp_template.c.o
Compiling .pioenvs\BIGTREE_SKR_PRO\FrameworkArduino\stm32\HAL\stm32yyxx_hal_nand.c.o
Compiling .pioenvs\BIGTREE_SKR_PRO\FrameworkArduino\stm32\HAL\stm32yyxx_hal_nor.c.o
Compiling .pioenvs\BIGTREE_SKR_PRO\FrameworkArduino\stm32\HAL\stm32yyxx_hal_opamp.c.o
Compiling .pioenvs\BIGTREE_SKR_PRO\FrameworkArduino\stm32\HAL\stm32yyxx_hal_opamp_ex.c.o
Compiling .pioenvs\BIGTREE_SKR_PRO\FrameworkArduino\stm32\HAL\stm32yyxx_hal_ospi.c.o
Compiling .pioenvs\BIGTREE_SKR_PRO\FrameworkArduino\stm32\HAL\stm32yyxx_hal_pccard.c.o
Compiling .pioenvs\BIGTREE_SKR_PRO\FrameworkArduino\stm32\HAL\stm32yyxx_hal_pcd.c.o
Compiling .pioenvs\BIGTREE_SKR_PRO\FrameworkArduino\stm32\HAL\stm32yyxx_hal_pcd_ex.c.o
Compiling .pioenvs\BIGTREE_SKR_PRO\FrameworkArduino\stm32\HAL\stm32yyxx_hal_pwr.c.o
Compiling .pioenvs\BIGTREE_SKR_PRO\FrameworkArduino\stm32\HAL\stm32yyxx_hal_pwr_ex.c.o
Compiling .pioenvs\BIGTREE_SKR_PRO\FrameworkArduino\stm32\HAL\stm32yyxx_hal_qspi.c.o
Compiling .pioenvs\BIGTREE_SKR_PRO\FrameworkArduino\stm32\HAL\stm32yyxx_hal_ramecc.c.o
Compiling .pioenvs\BIGTREE_SKR_PRO\FrameworkArduino\stm32\HAL\stm32yyxx_hal_rcc.c.o
Compiling .pioenvs\BIGTREE_SKR_PRO\FrameworkArduino\stm32\HAL\stm32yyxx_hal_rcc_ex.c.o
Compiling .pioenvs\BIGTREE_SKR_PRO\FrameworkArduino\stm32\HAL\stm32yyxx_hal_rng.c.o
Compiling .pioenvs\BIGTREE_SKR_PRO\FrameworkArduino\stm32\HAL\stm32yyxx_hal_rtc.c.o
Compiling .pioenvs\BIGTREE_SKR_PRO\FrameworkArduino\stm32\HAL\stm32yyxx_hal_rtc_ex.c.o
Compiling .pioenvs\BIGTREE_SKR_PRO\FrameworkArduino\stm32\HAL\stm32yyxx_hal_sai.c.o
Compiling .pioenvs\BIGTREE_SKR_PRO\FrameworkArduino\stm32\HAL\stm32yyxx_hal_sai_ex.c.o
Compiling .pioenvs\BIGTREE_SKR_PRO\FrameworkArduino\stm32\HAL\stm32yyxx_hal_sd.c.o
Compiling .pioenvs\BIGTREE_SKR_PRO\FrameworkArduino\stm32\HAL\stm32yyxx_hal_sd_ex.c.o
Compiling .pioenvs\BIGTREE_SKR_PRO\FrameworkArduino\stm32\HAL\stm32yyxx_hal_sdadc.c.o
Compiling .pioenvs\BIGTREE_SKR_PRO\FrameworkArduino\stm32\HAL\stm32yyxx_hal_sdram.c.o
Compiling .pioenvs\BIGTREE_SKR_PRO\FrameworkArduino\stm32\HAL\stm32yyxx_hal_smartcard.c.o
Compiling .pioenvs\BIGTREE_SKR_PRO\FrameworkArduino\stm32\HAL\stm32yyxx_hal_smartcard_ex.c.o
Compiling .pioenvs\BIGTREE_SKR_PRO\FrameworkArduino\stm32\HAL\stm32yyxx_hal_smbus.c.o
Compiling .pioenvs\BIGTREE_SKR_PRO\FrameworkArduino\stm32\HAL\stm32yyxx_hal_spdifrx.c.o
Compiling .pioenvs\BIGTREE_SKR_PRO\FrameworkArduino\stm32\HAL\stm32yyxx_hal_spi.c.o
Compiling .pioenvs\BIGTREE_SKR_PRO\FrameworkArduino\stm32\HAL\stm32yyxx_hal_spi_ex.c.o
Compiling .pioenvs\BIGTREE_SKR_PRO\FrameworkArduino\stm32\HAL\stm32yyxx_hal_sram.c.o
Compiling .pioenvs\BIGTREE_SKR_PRO\FrameworkArduino\stm32\HAL\stm32yyxx_hal_swpmi.c.o
Compiling .pioenvs\BIGTREE_SKR_PRO\FrameworkArduino\stm32\HAL\stm32yyxx_hal_tim.c.o
Compiling .pioenvs\BIGTREE_SKR_PRO\FrameworkArduino\stm32\HAL\stm32yyxx_hal_tim_ex.c.o
Compiling .pioenvs\BIGTREE_SKR_PRO\FrameworkArduino\stm32\HAL\stm32yyxx_hal_timebase_rtc_alarm_template.c.o
Compiling .pioenvs\BIGTREE_SKR_PRO\FrameworkArduino\stm32\HAL\stm32yyxx_hal_timebase_rtc_wakeup_template.c.o
Compiling .pioenvs\BIGTREE_SKR_PRO\FrameworkArduino\stm32\HAL\stm32yyxx_hal_timebase_tim_template.c.o
Compiling .pioenvs\BIGTREE_SKR_PRO\FrameworkArduino\stm32\HAL\stm32yyxx_hal_tsc.c.o
Compiling .pioenvs\BIGTREE_SKR_PRO\FrameworkArduino\stm32\HAL\stm32yyxx_hal_uart.c.o
Compiling .pioenvs\BIGTREE_SKR_PRO\FrameworkArduino\stm32\HAL\stm32yyxx_hal_uart_ex.c.o
Compiling .pioenvs\BIGTREE_SKR_PRO\FrameworkArduino\stm32\HAL\stm32yyxx_hal_usart.c.o
Compiling .pioenvs\BIGTREE_SKR_PRO\FrameworkArduino\stm32\HAL\stm32yyxx_hal_usart_ex.c.o
Compiling .pioenvs\BIGTREE_SKR_PRO\FrameworkArduino\stm32\HAL\stm32yyxx_hal_wwdg.c.o
Compiling .pioenvs\BIGTREE_SKR_PRO\FrameworkArduino\stm32\LL\stm32yyxx_ll_adc.c.o
Compiling .pioenvs\BIGTREE_SKR_PRO\FrameworkArduino\stm32\LL\stm32yyxx_ll_bdma.c.o
Compiling .pioenvs\BIGTREE_SKR_PRO\FrameworkArduino\stm32\LL\stm32yyxx_ll_comp.c.o
Compiling .pioenvs\BIGTREE_SKR_PRO\FrameworkArduino\stm32\LL\stm32yyxx_ll_crc.c.o
Compiling .pioenvs\BIGTREE_SKR_PRO\FrameworkArduino\stm32\LL\stm32yyxx_ll_crs.c.o
Compiling .pioenvs\BIGTREE_SKR_PRO\FrameworkArduino\stm32\LL\stm32yyxx_ll_dac.c.o
Compiling .pioenvs\BIGTREE_SKR_PRO\FrameworkArduino\stm32\LL\stm32yyxx_ll_delayblock.c.o
Compiling .pioenvs\BIGTREE_SKR_PRO\FrameworkArduino\stm32\LL\stm32yyxx_ll_dma.c.o
Compiling .pioenvs\BIGTREE_SKR_PRO\FrameworkArduino\stm32\LL\stm32yyxx_ll_dma2d.c.o
Compiling .pioenvs\BIGTREE_SKR_PRO\FrameworkArduino\stm32\LL\stm32yyxx_ll_exti.c.o
Compiling .pioenvs\BIGTREE_SKR_PRO\FrameworkArduino\stm32\LL\stm32yyxx_ll_fmc.c.o
Compiling .pioenvs\BIGTREE_SKR_PRO\FrameworkArduino\stm32\LL\stm32yyxx_ll_fsmc.c.o
Compiling .pioenvs\BIGTREE_SKR_PRO\FrameworkArduino\stm32\LL\stm32yyxx_ll_gpio.c.o
Compiling .pioenvs\BIGTREE_SKR_PRO\FrameworkArduino\stm32\LL\stm32yyxx_ll_hrtim.c.o
Compiling .pioenvs\BIGTREE_SKR_PRO\FrameworkArduino\stm32\LL\stm32yyxx_ll_i2c.c.o
Compiling .pioenvs\BIGTREE_SKR_PRO\FrameworkArduino\stm32\LL\stm32yyxx_ll_lptim.c.o
Compiling .pioenvs\BIGTREE_SKR_PRO\FrameworkArduino\stm32\LL\stm32yyxx_ll_lpuart.c.o
Compiling .pioenvs\BIGTREE_SKR_PRO\FrameworkArduino\stm32\LL\stm32yyxx_ll_mdma.c.o
Compiling .pioenvs\BIGTREE_SKR_PRO\FrameworkArduino\stm32\LL\stm32yyxx_ll_opamp.c.o
Compiling .pioenvs\BIGTREE_SKR_PRO\FrameworkArduino\stm32\LL\stm32yyxx_ll_pwr.c.o
Compiling .pioenvs\BIGTREE_SKR_PRO\FrameworkArduino\stm32\LL\stm32yyxx_ll_rcc.c.o
Compiling .pioenvs\BIGTREE_SKR_PRO\FrameworkArduino\stm32\LL\stm32yyxx_ll_rng.c.o
Compiling .pioenvs\BIGTREE_SKR_PRO\FrameworkArduino\stm32\LL\stm32yyxx_ll_rtc.c.o
Compiling .pioenvs\BIGTREE_SKR_PRO\FrameworkArduino\stm32\LL\stm32yyxx_ll_sdmmc.c.o
Compiling .pioenvs\BIGTREE_SKR_PRO\FrameworkArduino\stm32\LL\stm32yyxx_ll_spi.c.o
Compiling .pioenvs\BIGTREE_SKR_PRO\FrameworkArduino\stm32\LL\stm32yyxx_ll_swpmi.c.o
Compiling .pioenvs\BIGTREE_SKR_PRO\FrameworkArduino\stm32\LL\stm32yyxx_ll_tim.c.o
Compiling .pioenvs\BIGTREE_SKR_PRO\FrameworkArduino\stm32\LL\stm32yyxx_ll_usart.c.o
Compiling .pioenvs\BIGTREE_SKR_PRO\FrameworkArduino\stm32\LL\stm32yyxx_ll_usb.c.o
Compiling .pioenvs\BIGTREE_SKR_PRO\FrameworkArduino\stm32\LL\stm32yyxx_ll_utils.c.o
Compiling .pioenvs\BIGTREE_SKR_PRO\FrameworkArduino\stm32\PortNames.c.o
Compiling .pioenvs\BIGTREE_SKR_PRO\FrameworkArduino\stm32\analog.c.o
Compiling .pioenvs\BIGTREE_SKR_PRO\FrameworkArduino\stm32\clock.c.o
Compiling .pioenvs\BIGTREE_SKR_PRO\FrameworkArduino\stm32\core_callback.c.o
Compiling .pioenvs\BIGTREE_SKR_PRO\FrameworkArduino\stm32\hw_config.c.o
Compiling .pioenvs\BIGTREE_SKR_PRO\FrameworkArduino\stm32\interrupt.cpp.o
Compiling .pioenvs\BIGTREE_SKR_PRO\FrameworkArduino\stm32\low_power.c.o
Compiling .pioenvs\BIGTREE_SKR_PRO\FrameworkArduino\stm32\pinmap.c.o
Compiling .pioenvs\BIGTREE_SKR_PRO\FrameworkArduino\stm32\rtc.c.o
Compiling .pioenvs\BIGTREE_SKR_PRO\FrameworkArduino\stm32\spi_com.c.o
Compiling .pioenvs\BIGTREE_SKR_PRO\FrameworkArduino\stm32\startup_stm32yyxx.S.o
Compiling .pioenvs\BIGTREE_SKR_PRO\FrameworkArduino\stm32\stm32_def.c.o
Compiling .pioenvs\BIGTREE_SKR_PRO\FrameworkArduino\stm32\stm32_eeprom.c.o
Compiling .pioenvs\BIGTREE_SKR_PRO\FrameworkArduino\stm32\system_stm32yyxx.c.o
Compiling .pioenvs\BIGTREE_SKR_PRO\FrameworkArduino\stm32\timer.c.o
Compiling .pioenvs\BIGTREE_SKR_PRO\FrameworkArduino\stm32\twi.c.o
Compiling .pioenvs\BIGTREE_SKR_PRO\FrameworkArduino\stm32\uart.c.o
Compiling .pioenvs\BIGTREE_SKR_PRO\FrameworkArduino\stm32\usb\cdc\cdc_queue.c.o
Compiling .pioenvs\BIGTREE_SKR_PRO\FrameworkArduino\stm32\usb\cdc\usbd_cdc.c.o
Compiling .pioenvs\BIGTREE_SKR_PRO\FrameworkArduino\stm32\usb\cdc\usbd_cdc_if.c.o
Compiling .pioenvs\BIGTREE_SKR_PRO\FrameworkArduino\stm32\usb\hid\usbd_hid_composite.c.o
Compiling .pioenvs\BIGTREE_SKR_PRO\FrameworkArduino\stm32\usb\hid\usbd_hid_composite_if.c.o
Compiling .pioenvs\BIGTREE_SKR_PRO\FrameworkArduino\stm32\usb\usb_device_core.c.o
Compiling .pioenvs\BIGTREE_SKR_PRO\FrameworkArduino\stm32\usb\usb_device_ctlreq.c.o
Compiling .pioenvs\BIGTREE_SKR_PRO\FrameworkArduino\stm32\usb\usb_device_ioreq.c.o
Compiling .pioenvs\BIGTREE_SKR_PRO\FrameworkArduino\stm32\usb\usbd_conf.c.o
Compiling .pioenvs\BIGTREE_SKR_PRO\FrameworkArduino\stm32\usb\usbd_desc.c.o
Compiling .pioenvs\BIGTREE_SKR_PRO\FrameworkArduino\stm32\usb\usbd_if.c.o
Compiling .pioenvs\BIGTREE_SKR_PRO\FrameworkArduino\syscalls.c.o
Compiling .pioenvs\BIGTREE_SKR_PRO\FrameworkArduino\wiring_analog.c.o
Compiling .pioenvs\BIGTREE_SKR_PRO\FrameworkArduino\wiring_digital.c.o
Compiling .pioenvs\BIGTREE_SKR_PRO\FrameworkArduino\wiring_pulse.cpp.o
Compiling .pioenvs\BIGTREE_SKR_PRO\FrameworkArduino\wiring_shift.c.o
Compiling .pioenvs\BIGTREE_SKR_PRO\FrameworkArduino\wiring_time.c.o
Compiling .pioenvs\BIGTREE_SKR_PRO\src\src\HAL\HAL_STM32\HAL.cpp.o
Compiling .pioenvs\BIGTREE_SKR_PRO\src\src\HAL\HAL_STM32\HAL_Servo_STM32.cpp.o
Compiling .pioenvs\BIGTREE_SKR_PRO\src\src\HAL\HAL_STM32\HAL_spi_STM32.cpp.o
Compiling .pioenvs\BIGTREE_SKR_PRO\src\src\HAL\HAL_STM32\HAL_timers_STM32.cpp.o
Compiling .pioenvs\BIGTREE_SKR_PRO\src\src\HAL\HAL_STM32\fastio_STM32.cpp.o
Compiling .pioenvs\BIGTREE_SKR_PRO\src\src\HAL\HAL_STM32\persistent_store_impl.cpp.o
Compiling .pioenvs\BIGTREE_SKR_PRO\src\src\HAL\HAL_STM32\watchdog_STM32.cpp.o
Compiling .pioenvs\BIGTREE_SKR_PRO\src\src\HAL\shared\HAL_spi_L6470.cpp.o
Compiling .pioenvs\BIGTREE_SKR_PRO\src\src\HAL\shared\I2cEeprom.cpp.o
Compiling .pioenvs\BIGTREE_SKR_PRO\src\src\HAL\shared\SpiEeprom.cpp.o
Compiling .pioenvs\BIGTREE_SKR_PRO\src\src\HAL\shared\backtrace\backtrace.cpp.o
Compiling .pioenvs\BIGTREE_SKR_PRO\src\src\HAL\shared\backtrace\unwarm.cpp.o
Compiling .pioenvs\BIGTREE_SKR_PRO\src\src\HAL\shared\backtrace\unwarm_arm.cpp.o
Compiling .pioenvs\BIGTREE_SKR_PRO\src\src\HAL\shared\backtrace\unwarm_thumb.cpp.o
Compiling .pioenvs\BIGTREE_SKR_PRO\src\src\HAL\shared\backtrace\unwarmbytab.cpp.o
Compiling .pioenvs\BIGTREE_SKR_PRO\src\src\HAL\shared\backtrace\unwarmmem.cpp.o
Compiling .pioenvs\BIGTREE_SKR_PRO\src\src\HAL\shared\backtrace\unwinder.cpp.o
Compiling .pioenvs\BIGTREE_SKR_PRO\src\src\HAL\shared\backtrace\unwmemaccess.cpp.o
Compiling .pioenvs\BIGTREE_SKR_PRO\src\src\HAL\shared\persistent_store_api.cpp.o
Compiling .pioenvs\BIGTREE_SKR_PRO\src\src\HAL\shared\servo.cpp.o
Compiling .pioenvs\BIGTREE_SKR_PRO\src\src\Marlin.cpp.o
Compiling .pioenvs\BIGTREE_SKR_PRO\src\src\core\serial.cpp.o
Compiling .pioenvs\BIGTREE_SKR_PRO\src\src\core\utility.cpp.o
Compiling .pioenvs\BIGTREE_SKR_PRO\src\src\feature\I2CPositionEncoder.cpp.o
Compiling .pioenvs\BIGTREE_SKR_PRO\src\src\feature\Max7219_Debug_LEDs.cpp.o
Compiling .pioenvs\BIGTREE_SKR_PRO\src\src\feature\babystep.cpp.o
Compiling .pioenvs\BIGTREE_SKR_PRO\src\src\feature\backlash.cpp.o
Compiling .pioenvs\BIGTREE_SKR_PRO\src\src\feature\baricuda.cpp.o
Compiling .pioenvs\BIGTREE_SKR_PRO\src\src\feature\bedlevel\abl\abl.cpp.o
Compiling .pioenvs\BIGTREE_SKR_PRO\src\src\feature\bedlevel\bedlevel.cpp.o
Compiling .pioenvs\BIGTREE_SKR_PRO\src\src\feature\bedlevel\mbl\mesh_bed_leveling.cpp.o
Compiling .pioenvs\BIGTREE_SKR_PRO\src\src\feature\bedlevel\ubl\ubl.cpp.o
Compiling .pioenvs\BIGTREE_SKR_PRO\src\src\feature\bedlevel\ubl\ubl_G29.cpp.o
Compiling .pioenvs\BIGTREE_SKR_PRO\src\src\feature\bedlevel\ubl\ubl_motion.cpp.o
Compiling .pioenvs\BIGTREE_SKR_PRO\src\src\feature\bltouch.cpp.o
Compiling .pioenvs\BIGTREE_SKR_PRO\src\src\feature\caselight.cpp.o
Compiling .pioenvs\BIGTREE_SKR_PRO\src\src\feature\closedloop.cpp.o
Compiling .pioenvs\BIGTREE_SKR_PRO\src\src\feature\controllerfan.cpp.o
Compiling .pioenvs\BIGTREE_SKR_PRO\src\src\feature\dac\dac_dac084s085.cpp.o
Compiling .pioenvs\BIGTREE_SKR_PRO\src\src\feature\dac\dac_mcp4728.cpp.o
Compiling .pioenvs\BIGTREE_SKR_PRO\src\src\feature\dac\stepper_dac.cpp.o
Compiling .pioenvs\BIGTREE_SKR_PRO\src\src\feature\digipot\digipot_mcp4018.cpp.o
Compiling .pioenvs\BIGTREE_SKR_PRO\src\src\feature\digipot\digipot_mcp4451.cpp.o
Compiling .pioenvs\BIGTREE_SKR_PRO\src\src\feature\emergency_parser.cpp.o
Compiling .pioenvs\BIGTREE_SKR_PRO\src\src\feature\fanmux.cpp.o
Compiling .pioenvs\BIGTREE_SKR_PRO\src\src\feature\filwidth.cpp.o
Compiling .pioenvs\BIGTREE_SKR_PRO\src\src\feature\fwretract.cpp.o
Compiling .pioenvs\BIGTREE_SKR_PRO\src\src\feature\host_actions.cpp.o
Compiling .pioenvs\BIGTREE_SKR_PRO\src\src\feature\leds\blinkm.cpp.o
Compiling .pioenvs\BIGTREE_SKR_PRO\src\src\feature\leds\leds.cpp.o
Compiling .pioenvs\BIGTREE_SKR_PRO\src\src\feature\leds\neopixel.cpp.o
Compiling .pioenvs\BIGTREE_SKR_PRO\src\src\feature\leds\pca9632.cpp.o
Compiling .pioenvs\BIGTREE_SKR_PRO\src\src\feature\leds\printer_event_leds.cpp.o
Compiling .pioenvs\BIGTREE_SKR_PRO\src\src\feature\leds\tempstat.cpp.o
Compiling .pioenvs\BIGTREE_SKR_PRO\src\src\feature\mixing.cpp.o
Compiling .pioenvs\BIGTREE_SKR_PRO\src\src\feature\pause.cpp.o
Compiling .pioenvs\BIGTREE_SKR_PRO\src\src\feature\power.cpp.o
Compiling .pioenvs\BIGTREE_SKR_PRO\src\src\feature\power_loss_recovery.cpp.o
Compiling .pioenvs\BIGTREE_SKR_PRO\src\src\feature\prusa_MMU2\mmu2.cpp.o
Compiling .pioenvs\BIGTREE_SKR_PRO\src\src\feature\runout.cpp.o
Compiling .pioenvs\BIGTREE_SKR_PRO\src\src\feature\snmm.cpp.o
Compiling .pioenvs\BIGTREE_SKR_PRO\src\src\feature\solenoid.cpp.o
Compiling .pioenvs\BIGTREE_SKR_PRO\src\src\feature\spindle_laser.cpp.o
Compiling .pioenvs\BIGTREE_SKR_PRO\src\src\feature\tmc_util.cpp.o
Compiling .pioenvs\BIGTREE_SKR_PRO\src\src\feature\twibus.cpp.o
Compiling .pioenvs\BIGTREE_SKR_PRO\src\src\gcode\bedlevel\G26.cpp.o
Compiling .pioenvs\BIGTREE_SKR_PRO\src\src\gcode\bedlevel\G42.cpp.o
Compiling .pioenvs\BIGTREE_SKR_PRO\src\src\gcode\bedlevel\M420.cpp.o
Compiling .pioenvs\BIGTREE_SKR_PRO\src\src\gcode\bedlevel\abl\G29.cpp.o
Compiling .pioenvs\BIGTREE_SKR_PRO\src\src\gcode\bedlevel\abl\M421.cpp.o
Compiling .pioenvs\BIGTREE_SKR_PRO\src\src\gcode\bedlevel\mbl\G29.cpp.o
Compiling .pioenvs\BIGTREE_SKR_PRO\src\src\gcode\bedlevel\mbl\M421.cpp.o
Compiling .pioenvs\BIGTREE_SKR_PRO\src\src\gcode\bedlevel\ubl\G29.cpp.o
Compiling .pioenvs\BIGTREE_SKR_PRO\src\src\gcode\bedlevel\ubl\M421.cpp.o
Compiling .pioenvs\BIGTREE_SKR_PRO\src\src\gcode\calibrate\G28.cpp.o
Compiling .pioenvs\BIGTREE_SKR_PRO\src\src\gcode\calibrate\G33.cpp.o
Compiling .pioenvs\BIGTREE_SKR_PRO\src\src\gcode\calibrate\G34_M422.cpp.o
Compiling
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

Thread 8 (2019-07-11):

SKR PRO Ender 3 Display

ilakuli, 2019-07-11:
I fitted my SKR Pro to my Ender 3 with LV8729 Steppers. I connected the Ender 3 Display (1 Ribbon cable) to EXP 1 on the Board and used #define CR10STOCKDISPLAY in the Firmware. The Display lights up and shows something but it is full of graphical faults. Is this a Marlin bug? (Picture from Facebook Group for illustration)
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

Msq001, 2019-07-11:
this is because of delay of spi sequence
STM32F407 I have tested it [delay](https://github.com/MarlinFirmware/Marlin/blob/3218c4b33f5322e385eafb536bbcf3b557f2b04e/Marlin/src/pins/stm32/pins_BIGTREE_SKR_PRO_V1.1.h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)

>       #define ST7920_DELAY_1 DELAY_NS(96)
>       #define ST7920_DELAY_2 DELAY_NS(48)
>       #define ST7920_DELAY_3 DELAY_NS(600)

is worked ok.
but if defined `#define CR10STOCKDISPLAY`, this will set all delay in [`Conditionals_LCD.h`](https://github.com/MarlinFirmware/Marlin/blob/948c3f580b16c53f1f75f480fe7d9c028f94dd23/Marlin/src/inc/Conditionals_LCD.h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) to DELAY_NS(125),  it will not work
if you want to work normal, Please modify [here](https://github.com/MarlinFirmware/Marlin/blob/3218c4b33f5322e385eafb536bbcf3b557f2b04e/Marlin/src/pins/stm32/pins_BIGTREE_SKR_PRO_V1.1.h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)

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
to
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
and it will be ok,  I can't test this now, because I was at home and I don't have SKR Pro right now.  I will test this tomorrow. and create a PR to Marlin to fix this issue

ilakuli, 2019-07-11:
I will test tonight and report back. Thanks

ilakuli, 2019-07-11:
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

This change has worked perfectly. Stock Ender 3 Display is working fine now.

Msq001, 2019-07-13:
thanks for your test and feedback， I have created a PR in Marlin2.0 to fix this issue,  and update source code in this repository

ilakuli, 2019-07-14:
Perfect. Will close this. Thanks for your help :)

Closed 2019-07-14.

Thread 10 (2019-07-12):

if enable LASER_FEATURE compiling fail!!!

sn0wrider, 2019-07-12:
Hi if if enable LASER_FEATURE. Where is PIN PWM 5v?
Im try #define SPINDLE_LASER_PWM_PIN SERVO0_PIN
not working !!!!

.platformio\packages\framework-arduinoststm32\cores\arduino/pins_arduino.h:223:51: error: missing
binary operator before token "("
#define digitalPinHasPWM(p) (pin_in_pinmap(digitalPinToPinName(p), PinMap_PWM))
^
Marlin\src\HAL\HAL_STM32../../inc/../HAL/./HAL_STM32/fastio_STM32.h:83:33: note: in expansion of macro 'digitalPinHasPWM'
#define PWM_PIN(P) digitalPinHasPWM(P)
^~~~~~~~~~~~~~~~
Marlin\src\HAL\HAL_STM32../../inc/SanityCheck.h:2332:12: note: in expansion of macro 'PWM_PIN'
#elif !PWM_PIN(SPINDLE_LASER_PWM_PIN)
^~~~~~~
In file included from C:\users\administrator.home.platformio\packages\framework-arduinoststm32\cores\arduino/Arduino.h:48:0,
from Marlin\src\HAL\HAL_STM32../../inc/../HAL/./HAL_STM32/../shared/Marduino.h:34,
from Marlin\src\HAL\HAL_STM32../../inc/../HAL/./HAL_STM32/HAL.h:28,
from Marlin\src\HAL\HAL_STM32../../inc/../HAL/HAL.h:52,
from Marlin\src\HAL\HAL_STM32../../inc/MarlinConfig.h:30,
from Marlin\src\HAL\HAL_STM32\fastio_STM32.cpp:25:

Msq001, 2019-07-13:
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
hello， comment out here， Can compile normally
this issue is because of here
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

> digitalPinHasPWM(p)

It's a function, and the return value is a variable, not a const. So there are errors in precompiling.
You can also modifiy

> # define PWM_PIN (P) true

to fix this issue，  But not all pins of STM32 have PWM capability，So you need to use it carefully to make sure that the pins you use are PWM.
You can do this way before we find a better way to do it.

sn0wrider, 2019-07-13:
Thanks, PA1 or PA2 is a PWM pins?

Msq001, 2019-07-13:
both PA1 and PA2 is PWM pins

sn0wrider, 2019-07-13:
write the transcript of all the pins, there will be less stupid questions like mine

sn0wrider, 2019-07-13:
Thank for all, pls close the issue

Haschtl, 2019-10-17:
@sn0wrider
You can find all PWM-pins (and all other special pins) in this file:
buildroot\share\PlatformIO\variants\BIGTREE_GENERIC_STM32F407_5X\PeripheralPins.c

MinSoeVertex, 2019-12-30:
or you can set Fan speed to 255 and it will works fine

Closed 2019-07-15.

Thread 12 (2019-07-14):

Compile Error when using E0_AUTO_FAN_PIN.

SnowMB, 2019-07-14:
Hello,

I tried to use the 2nd fan pin as hotend cooling fan with the AUTO_FAN_PIN Feature. However this results in a compilation error:

Configuration_adv.h:
```
#define E0_AUTO_FAN_PIN PE5
```

Error:
```
...

In file included from Marlin/src/HAL/HAL_STM32/../../inc/MarlinConfig.h:41:0,
                 from Marlin/src/HAL/HAL_STM32/HAL_timers_STM32.h:29,
                 from Marlin/src/HAL/HAL_STM32/HAL.h:103,
                 from Marlin/src/HAL/HAL_STM32/HAL.cpp:26:
Marlin/src/HAL/HAL_STM32/../../inc/SanityCheck.h:1825:5: error: non-constant condition for static assertion
     static_assert(PWM_PIN(E0_AUTO_FAN_PIN), "E0" AF_ERR_SUFF);
     ^~~~~~~~~~~~~
In file included from /home/marc/.platformio/packages/framework-arduinoststm32/cores/arduino/Arduino.h:48:0,
                 from Marlin/src/HAL/HAL_STM32/../shared/Marduino.h:33,
                 from Marlin/src/HAL/HAL_STM32/HAL.h:32,
                 from Marlin/src/HAL/HAL_STM32/HAL.cpp:26:
/home/marc/.platformio/packages/framework-arduinoststm32/cores/arduino/pins_arduino.h:223:51: error: call to non-constexpr function 'bool pin_in_pinmap(PinName, const PinMap*)'
 #define digitalPinHasPWM(p)         (pin_in_pinmap(digitalPinToPinName(p), PinMap_PWM))
                                     ~~~~~~~~~~~~~~^~~~~~~~~~~~~~~~~~~~~~~~~~~~~~~~~~~~~
Marlin/src/HAL/HAL_STM32/fastio_STM32.h:83:33: note: in expansion of macro 'digitalPinHasPWM'
 #define PWM_PIN(P)              digitalPinHasPWM(P)
                                 ^~~~~~~~~~~~~~~~
Marlin/src/HAL/HAL_STM32/../../inc/SanityCheck.h:1825:19: note: in expansion of macro 'PWM_PIN'
     static_assert(PWM_PIN(E0_AUTO_FAN_PIN), "E0" AF_ERR_SUFF);
                   ^~~~~~~
In file included from Marlin/src/HAL/HAL_STM32/../../inc/MarlinConfig.h:41:0,
                 from Marlin/src/HAL/HAL_STM32/HAL_Servo_STM32.cpp:25:
Marlin/src/HAL/HAL_STM32/../../inc/SanityCheck.h:1825:5: error: non-constant condition for static assertion
     static_assert(PWM_PIN(E0_AUTO_FAN_PIN), "E0" AF_ERR_SUFF);
     ^~~~~~~~~~~~~
In file included from /home/marc/.platformio/packages/framework-arduinoststm32/cores/arduino/Arduino.h:48:0,
                 from Marlin/src/HAL/HAL_STM32/../../inc/../HAL/HAL_STM32/../shared/Marduino.h:33,
                 from Marlin/src/HAL/HAL_STM32/../../inc/../HAL/HAL_STM32/HAL.h:32,
                 from Marlin/src/HAL/HAL_STM32/../../inc/MarlinConfig.h:30,
                 from Marlin/src/HAL/HAL_STM32/HAL_Servo_STM32.cpp:25:
/home/marc/.platformio/packages/framework-arduinoststm32/cores/arduino/pins_arduino.h:223:51: error: call to non-constexpr function 'bool pin_in_pinmap(PinName, const PinMap*)'
 #define digitalPinHasPWM(p)         (pin_in_pinmap(digitalPinToPinName(p), PinMap_PWM))
                                     ~~~~~~~~~~~~~~^~~~~~~~~~~~~~~~~~~~~~~~~~~~~~~~~~~~~
Marlin/src/HAL/HAL_STM32/../../inc/../HAL/HAL_STM32/fastio_STM32.h:83:33: note: in expansion of macro 'digitalPinHasPWM'
 #define PWM_PIN(P)              digitalPinHasPWM(P)
                                 ^~~~~~~~~~~~~~~~
Marlin/src/HAL/HAL_STM32/../../inc/SanityCheck.h:1825:19: note: in expansion of macro 'PWM_PIN'
     static_assert(PWM_PIN(E0_AUTO_FAN_PIN), "E0" AF_ERR_SUFF);
                   ^~~~~~~
*** [.pioenvs/BIGTREE_SKR_PRO/src/src/HAL/HAL_STM32/HAL.cpp.o] Error 1
*** [.pioenvs/BIGTREE_SKR_PRO/src/src/HAL/HAL_STM32/HAL_Servo_STM32.cpp.o] Error 1
In file included from Marlin/src/HAL/HAL_STM32/../../inc/MarlinConfig.h:41:0,
                 from Marlin/src/HAL/HAL_STM32/HAL_spi_STM32.cpp:30:
Marlin/src/HAL/HAL_STM32/../../inc/SanityCheck.h:1825:5: error: non-constant condition for static assertion
     static_assert(PWM_PIN(E0_AUTO_FAN_PIN), "E0" AF_ERR_SUFF);
     ^~~~~~~~~~~~~
In file included from /home/marc/.platformio/packages/framework-arduinoststm32/cores/arduino/Arduino.h:48:0,
                 from Marlin/src/HAL/HAL_STM32/../../inc/../HAL/HAL_STM32/../shared/Marduino.h:33,
                 from Marlin/src/HAL/HAL_STM32/../../inc/../HAL/HAL_STM32/HAL.h:32,
                 from Marlin/src/HAL/HAL_STM32/../../inc/MarlinConfig.h:30,
                 from Marlin/src/HAL/HAL_STM32/HAL_spi_STM32.cpp:30:
/home/marc/.platformio/packages/framework-arduinoststm32/cores/arduino/pins_arduino.h:223:51: error: call to non-constexpr function 'bool pin_in_pinmap(PinName, const PinMap*)'
 #define digitalPinHasPWM(p)         (pin_in_pinmap(digitalPinToPinName(p), PinMap_PWM))
                                     ~~~~~~~~~~~~~~^~~~~~~~~~~~~~~~~~~~~~~~~~~~~~~~~~~~~
Marlin/src/HAL/HAL_STM32/../../inc/../HAL/HAL_STM32/fastio_STM32.h:83:33: note: in expansion of macro 'digitalPinHasPWM'
 #define PWM_PIN(P)              digitalPinHasPWM(P)
                                 ^~~~~~~~~~~~~~~~
Marlin/src/HAL/HAL_STM32/../../inc/SanityCheck.h:1825:19: note: in expansion of macro 'PWM_PIN'
     static_assert(PWM_PIN(E0_AUTO_FAN_PIN), "E0" AF_ERR_SUFF);
                   ^~~~~~~
In file included from Marlin/src/HAL/HAL_STM32/../../inc/MarlinConfig.h:41:0,
                 from Marlin/src/HAL/HAL_STM32/HAL_timers_STM32.h:29,
                 from Marlin/src/HAL/HAL_STM32/HAL.h:103,
                 from Marlin/src/HAL/HAL_STM32/HAL_timers_STM32.cpp:29:
Marlin/src/HAL/HAL_STM32/../../inc/SanityCheck.h:1825:5: error: non-constant condition for static assertion
     static_assert(PWM_PIN(E0_AUTO_FAN_PIN), "E0" AF_ERR_SUFF);
     ^~~~~~~~~~~~~
In file included from /home/marc/.platformio/packages/framework-arduinoststm32/cores/arduino/Arduino.h:48:0,
                 from Marlin/src/HAL/HAL_STM32/../shared/Marduino.h:33,
                 from Marlin/src/HAL/HAL_STM32/HAL.h:32,
                 from Marlin/src/HAL/HAL_STM32/HAL_timers_STM32.cpp:29:
/home/marc/.platformio/packages/framework-arduinoststm32/cores/arduino/pins_arduino.h:223:51: error: call to non-constexpr function 'bool pin_in_pinmap(PinName, const PinMap*)'
 #define digitalPinHasPWM(p)         (pin_in_pinmap(digitalPinToPinName(p), PinMap_PWM))
                                     ~~~~~~~~~~~~~~^~~~~~~~~~~~~~~~~~~~~~~~~~~~~~~~~~~~~
Marlin/src/HAL/HAL_STM32/fastio_STM32.h:83:33: note: in expansion of macro 'digitalPinHasPWM'
 #define PWM_PIN(P)              digitalPinHasPWM(P)
                                 ^~~~~~~~~~~~~~~~
Marlin/src/HAL/HAL_STM32/../../inc/SanityCheck.h:1825:19: note: in expansion of macro 'PWM_PIN'
     static_assert(PWM_PIN(E0_AUTO_FAN_PIN), "E0" AF_ERR_SUFF);
                   ^~~~~~~
*** [.pioenvs/BIGTREE_SKR_PRO/src/src/HAL/HAL_STM32/HAL_spi_STM32.cpp.o] Error 1
*** [.pioenvs/BIGTREE_SKR_PRO/src/src/HAL/HAL_STM32/HAL_timers_STM32.cpp.o] Error 1
========================================== [ERROR] Took 10.12 seconds ==========================================

================================================== [SUMMARY] ==================================================
Environment megaatmega2560              [IGNORED]
Environment megaatmega1280              [IGNORED]
Environment at90usb1286_cdc             [IGNORED]
Environment at90usb1286_dfu             [IGNORED]
Environment DUE                         [IGNORED]
Environment DUE_USB                     [IGNORED]
Environment DUE_debug                   [IGNORED]
Environment LPC1768                     [IGNORED]
Environment LPC1769                     [IGNORED]
Environment melzi                       [IGNORED]
Environment melzi_optiboot              [IGNORED]
Environment rambo                       [IGNORED]
Environment sanguino_atmega644p         [IGNORED]
Environment sanguino_atmega1284p        [IGNORED]
Environment STM32F1                     [IGNORED]
Environment fysetc_STM32F1              [IGNORED]
Environment BIGTREE_SKR_MINI            [IGNORED]
Environment STM32F4                     [IGNORED]
Environment ARMED                       [IGNORED]
Environment mks_robin                   [IGNORED]
Environment mks_robin_mini              [IGNORED]
Environment mks_robin_nano              [IGNORED]
Environment JGAURORA_A5S_A1             [IGNORED]
Environment black_stm32f407ve           [IGNORED]
Environment BIGTREE_SKR_PRO             [FAILED]
Environment teensy35                    [IGNORED]
Environment malyanm200                  [IGNORED]
Environment esp32                       [IGNORED]
Environment fysetc_f6_13                [IGNORED]
Environment linux_native                [IGNORED]
==================================== 1 failed, 0 succeeded in 10.13 seconds ====================================
The terminal process terminated with exit code: 1

Terminal will be reused by tasks, press any key to close it.

```

Msq001, 2019-07-15:
please according to here, https://github.com/bigtreetech/BIGTREETECH-SKR-PRO-V1.1/issues/10
This is because of PWM_PIN

ledfreak3d, 2019-07-30:
works just fine for me

MinSoeVertex, 2019-12-30:
Don't change fan speed from 255 and it will work fine.

oldman4U, 2020-06-08:
Hello snow.

@SnowMB Please close this ticket in case you do not need it any more.

Thank you

SnowMB, 2020-06-08:
sure. this is resolved :D

Closed 2020-06-08.

Thread 13 (2019-07-16):

SKR Pro v1.1

SkuterGaming, 2019-07-16:
### Help,
**how to fix this problem ?**

GNU MCU Eclipse OpenOCD, 64-bitOpen On-Chip Debugger 0.10.0+dev-00593-g23ad80df4 (2019-04-22-20:25)
Licensed under GNU GPL v2
For bug reports, read
        http://openocd.org/doc/doxygen/bugs.html
debug_level: 1
swd
adapter speed: 2000 kHz
adapter_nsrst_delay: 100
none separate
cortex_m reset_config sysresetreq
### **Error: unable to find CMSIS-DAP device**
### **Error: No Valid JTAG Interface Configured.**
### ***** [upload] Error -1**

Evg33, 2019-07-16:
> how to fix this problem ?

1. Build (only build. w/o upload)
2. Copy \firmware\Marlin-SKR-Pro\.pioenvs\BIGTREE_SKR_PRO\firmware.bin  to SD-Card.
3. Insert SD-Card into board
4. reboot board

golfromeo-fr, 2019-07-31:
please close this issue

jeffkarney, 2019-08-03:
This is by no means a solution to the problem.... do not close this until the problem is solved.

farmstar72, 2019-08-05:
I just got my SKR Pro and don't see the SD Card like I do with my SKR V1.3 (It shows up as drive D:). However, I can upload to the SKR Pro using Upload_Protocol = dfu . But that doesn't put the firmware on the SD - I guess it's going to the board's memory? I also copied the firmware directly to the SD card with a card reader then put it into the SKR Pro and that seemed to work.
I still feel like I'm missing something because I don't see the SD card as drive D: when I plug the board into my computer with the USB cable.
 - Is that by design or am I missing a step?

Scott

farmstar72, 2019-08-05:
Kingprint answered my question - It's by design. Unlike other Arm based control boards, you cannot access the SD Card via the boards USB

rflulling, 2019-10-13:
Going to kick up a bit of dust by saying that I have two SD cards. The internal is seen as a FLASH, and is set to behave in this way by pins_BIGTREE_SKR_PRO.h
```
// Use one of these or SDCard-based Emulation will be used
//#define SRAM_EEPROM_EMULATION   // Use BackSRAM-based EEPROM emulation
#define FLASH_EEPROM_EMULATION  // Use Flash-based EEPROM emulation
```

Neither show up on the desktop. This might also be due to the fact I have not configured SD communication I think are needed to talk to the storage device. In this case I honestly expect ONLY that SD card 1 will show if at all.

Honestly I care not if it shows, only that the software we use can see it to upload files. I care not if we can see SD card 0, but that PlatformIO or ArduinoIDE can program the card when we generate new firmware.

The reason we cannot flash the firmware is a factory installed bootloader that manages the Controller. I believe the presence of the bootloader is obvious. I believe the way to resolve this is to ask BIGTREETECH aka BIQU to fix the bootloader.

jgwinner, 2019-12-11:
I realize the instructions say to copy to the SD Card and put it in the Pro, but that is a PITA. It also doesn't allow developers to do on-device debugging or programming.

BIQU/BIGTREETECH, is there any way to make the device remote upload work? This is a much needed feature.

@farmstar72 I tried the dfu upload, but got the error "No DFU capable USB device available" Doing more research ...

Thread 14 (2019-07-16):

parts cooling fan control?

fenyx13, 2019-07-16:
I have hotend cooling on fan0 but when I have fans attached to fan 1 or 2 they don't start and I can't control them with m106.
thanks

rlvanhuis, 2019-09-14:
@fenyx13, What were the steps used to solve.  I am at the same point.

Thanks

fenyx13, 2019-09-15:
@rlvanhuis
I ended up using one of the sets of heater pins for the parts cooling fan and reassigning the pins in the firmware. Worked for me.

rlvanhuis, 2019-09-15:
Not fully understanding how to trace the input to the output yet.  I hope
this is what you did to solve your issue.
I will remap the pins located in the file "pins_BIGRTEE_SKR_RRO_V1.1.h".  I
will swap PE5 for PD14.  If I follow correctly the output will move to the
heater 1 location?

Thanks

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

fenyx13, 2019-09-16:
Yup, that’s what I did. Good luck! 🙂

Closed 2019-07-21.

Thread 15 (2019-07-17):

BLTOUCH

p1234321, 2019-07-17:
Hello,

I always get an error when using bltouch.

> Error:STOP called because of BLTouch error - restart with M999
[ERROR] Error:STOP called because of BLTouch error - restart with M999 <

please help

Tarot67, 2019-07-17:
There some explaination on this error:

http://marlinfw.org/docs/gcode/M999.html

p1234321, 2019-07-18:
thanks, but there is not really useful information. i still dont get it to work. I dont get an error, but nothing is happening when homing z axis. i can sied all bltouch commands and they work (M280 S0 P120....).
Anybody who has this setup working? SKR Pro and bltouch?
thanks
paul

Tarot67, 2019-07-18:
Ok! you say with M280 S0 P120 the pin of BLTouch move!.
Your BL-Touch work on SET mode the servo work
but there are another mode "GET" retrive information of your BL-Touch it's difficulte to test this feature. Perharps it's existe a sketch for testing BL-Touch retrive information on arduino uno for example.

There are a lot of issue with BL-Touch! even it's brand new!

You are tested another BL-Touch ?

I see that

This is a arduino sketch to test BL-Touch

#include <Servo.h>

Servo servo;

void setup(){
  Serial.begin(115200);
  servo.attach(D2);
}

void loop() {
  servo.write(120);
  Serial.println(servo.read());
  delay(5000);
  servo.write(121);
  Serial.println(servo.read());
  delay(5000);
}

The output result is like the following:

119
120
119
120
119
120
119
120

p1234321, 2019-07-18:
I tried two different BLtouch, wihich worked perfectly under marlin 1.1.4 and an mks gen board.
so i really dont know whats the issue. maybe its got something to do with marlin 2.0?

thanks

paul

dant220, 2019-07-18:
This seems an excellent Tutorial here:
https://www.youtube.com/watch?v=5cSzFCv7K4Q

On an SKR 1.3. covers settings and hardware config. (it will be a bit different on the pro board). But worth a watch.

albrk2902, 2019-07-21:
I do have a working solution. Just ignore the picture in the manual and connect the black wire to GND on the ZMin connector ( middle_Pin) and the with wire to ZMin Signal   and it will work, at least for me it does

p1234321, 2019-08-05:
Thanks! that also works for me!

Closed 2019-08-05.

Thread 16 (2019-07-20):

SKR PRO - ENV_DEFAULT = LCP1768 or BIGTREE_SKR_PRO?

ruttenfam, 2019-07-20:
Hi,

The manual states that in platfrom.io the default_env is set as LCP1768 but that the processor of the SKR 1.3 not the PRO. It now shows the BIGTREE_SKR_PRO as an environment so do I use this?
thanks

dant220, 2019-07-26:
See compile issues thread
https://github.com/bigtreetech/BIGTREETECH-SKR-PRO-V1.1/issues/17

Black6spdZ, 2019-08-16:
can't this be closed as its pretty well documented this uses an STM micro and not a LCP1768 like older SKR boars

omahena, 2019-08-20:
I vote that the issue remains opened until the documentation is fixed. The manual for SKR Pro 1.1 points to a dropbox file for Marlin building instructions:
https://www.dropbox.com/s/ppjfflhf3j5yzh2/MarlinV2.0%20SKRV1.1%20instruction.docx?dl=0

The document clearly states that LPC1768 should be used. It also suggests to use the obsolete `env_default` variable and not the `default_envs`. Documentation is pretty poor and increasingly obsolete.

Haschtl, 2019-08-20:
The referred building manual is for the SKR 1.1 Not the Pro. Its almost the same for the Pro. Maybe they will Update the building manual, even if Its almost identically

omahena, 2019-08-21:
I hear you and agree with you. But... The doc is referenced directly in the SKR Pro 1.1 manual and points to SKR 1.1 (Pro... one could assume) Marlin building instructions.

Even with 20+ years of (non arduino / platformio) development experience they had me staring at the LPC1768 value for a few seconds before I decided that it is likely for the SKR 1.1. Watching a few videos from Teaching Tech on YouTube on the subject also helped gather some hints.

So having a manual like this may be better than nothing... But when the manual is misleading in more than one way... The manual benefit becomes arguable. The manual is also increasingly obsolete and lacking. The English is fine as it is because my Chinese is definitely worst than the English in the manual - so thank you BTT for writing the manual in a language hopefully... More people can understand.

tphan26363, 2020-02-03:
I don't believe  that is the right chip.  defined here is STM32F407ZG
#
# BIGTREE_SKR_PRO (STM32F407ZGT6 ARM Cortex-M4)
#
[env:BIGTREE_SKR_PRO]
platform = ststm32@5.4.3
framework = arduino
board = BigTree_SKR_Pro
extra_scripts = pre:buildroot/share/PlatformIO/scripts/generic_create_variant.py
build_flags = ${common.build_flags}
  -DUSBCON -DUSBD_USE_CDC -DUSBD_VID=0x0483 -DUSB_PRODUCT=\"STM32F407ZG\"
  -DTARGET_STM32F4 -DSTM32F407_5ZX -DVECT_TAB_OFFSET=0x8000 -DHAVE_HWSERIAL6
lib_deps = ${common.lib_deps}
lib_ignore = Adafruit NeoPixel, c1921b4, TMC26XStepper, SailfishLCD, SailfishRGB_LED, SlowSoftI2CMaster
src_filter = ${common.default_src_filter} +<src/HAL/HAL_STM32> +<src/HAL/HAL_STM32_F4_F7> -<src/HAL/HAL_STM32_F4_F7/*> +<src/HAL/HAL_STM32_F4_F7/STM32F4>
monitor_speed = 250000

Thread 17 (2019-07-20):

Compile Error for environment BIGTREE_SKR_PRO

ruttenfam, 2019-07-20:
This is probably related to my previous issue.
Documentation doesn't seem to be quite up to date with the files here.

I used SKR PRO firmware files, and it uses; env_default  = BIGTREE_SKR_PRO

However, on compiling the file I get an error: Environment BIGTREE_SKR_PRO             [FAILED]
==================== 1 failed, 0 succeeded in 1.22 seconds ====================
See screenshot
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

Thanks

golfromeo-fr, 2019-07-21:
same here PinNames.h
error: 'PortA' (and others) undeclared here

Compiling .pioenvs\BIGTREE_SKR_PRO\FrameworkArduino\stm32\core_callback.c.o
In file included from C:\users\romagnyg\.platformio\packages\framework-arduinoststm32\cores\arduino\stm32/pinmap.h:22:0,
                 from C:\users\romagnyg\.platformio\packages\framework-arduinoststm32\cores\arduino\stm32/PeripheralPins.h:34,
Compiling .pioenvs\BIGTREE_SKR_PRO\FrameworkArduino\stm32\dwt.c.o
                 from C:\users\romagnyg\.platformio\packages\framework-arduinoststm32\variants\BIGTREE_GENERIC_STM32F407_5X/variant.h:37,
                 from C:\users\romagnyg\.platformio\packages\framework-arduinoststm32\system\STM32F4xx/stm32f4xx_hal_conf.h:4,
                 from C:\users\romagnyg\.platformio\packages\framework-arduinoststm32\system\Drivers\STM32F4xx_HAL_Driver\Inc/stm32f4xx_hal.h:30,
                 from C:\users\romagnyg\.platformio\packages\framework-arduinoststm32\system\Drivers\CMSIS\Device\ST\STM32F4xx\Include/stm32f4xx.h:250,
                 from C:\users\romagnyg\.platformio\packages\framework-arduinoststm32\cores\arduino\stm32\stm32_def.h:35,
                 from C:\users\romagnyg\.platformio\packages\framework-arduinoststm32\cores\arduino\stm32\PortNames.h:33,
                 from C:\users\romagnyg\.platformio\packages\framework-arduinoststm32\cores\arduino\stm32\PortNames.c:30:
C:\users\romagnyg\.platformio\packages\framework-arduinoststm32\cores\arduino\stm32/PinNames.h:16:12: error: 'PortA' undeclared here (not in a function)

ruttenfam, 2019-07-21:
UPDATE: Reinstalled GIT (soooo slow. not sure whats wrong with that software!) Finally managed to make ATOM the default reader and the code now ran a bit further. Still Not completing. Now the errors start with the Port packages.

Any support from Bigtreetech?

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

ruttenfam, 2019-07-21:
BIGTREETECH: pls update your manual for the SKR PRO inline with where your Marlin merge is up to. Also, should we use ATOM or Microsoft as the reader? Does it matter?

Thanks

Evg33, 2019-07-22:
platformio.ini

```
[env:BIGTREE_SKR_PRO]
#platform = ststm32
platform = ststm32@5.4.3

```

NickMilton, 2019-07-22:
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

I am having identical issue - very frustrating. Need help or the board goes in the bin!

ruttenfam, 2019-07-22:
Bigtreetech please respond with a full answer to allow customers to compile the firmware successfully.
Without proper customer support, the industry will turn their backs to your products and company pretty quickly. Already pretty pissed off customers in this thread!

golfromeo-fr, 2019-07-22:
I guess we can stop using this repository for now

I have managed to install vscode + plateformio and MarlinFirmware/Marlin
on bugfix-2.0.x

using
env_default  = BIGTREE_SKR_PRO
I can compile with
#define REPRAP_DISCOUNT_FULL_GRAPHIC_SMART_CONTROLLER
but my MKS version of the screen doesn't light up
I am trying to buy the
LCD 12864 LCD Control from BigTreeTech if case it works better

But anyway I can send Gcode command from the USB connection with pronterface
so there are positive things happening. I need a working screen

note : vscode and platformio can become very messy as all the configuration and stored package are much hidden. I have deleted .plateformio local folder

NickMilton, 2019-07-23:
> Bigtreetech please respond with a full answer to allow customers to compile the firmware successfully.
> Without proper customer support, the industry will turn their backs to your products and company pretty quickly. Already pretty pissed off customers in this thread!

To be fair - I am a first time user of VCS/Platformio so I might be making a basic mistake? However as I followed the Bigtreetech guides and used their version of Marlin 2.0 I would have expected it at leat to compile... I don't know enough about this error to be able to proceed -

NickMilton, 2019-07-23:
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

Ahh - I have a Bigtreetech LCD 12864 so I can test....once I can get the f/w to compile LOL

NickMilton, 2019-07-23:
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

Great news - I replicated what you did. I am getting Environment BIGTREE_SKR_PRO  [FAILED]. Can you tell me how you deleted the local folder and other things? I'll see if I can replciate on my end..

cheers

bigtreetech, 2019-07-23:
Please according to here https://github.com/MarlinFirmware/Marlin/issues/14672 and here https://github.com/MarlinFirmware/Marlin/pull/14674
this if because of the STM32 platform dependency libraries have be updated，But it's not sure whether the latest version is incompatible or have bugs.  so will Limited Version to 5.4.3， This will solve this issue.

bigtreetech, 2019-07-23:
https://github.com/bigtreetech/BIGTREETECH-SKR-PRO-V1.1/commit/21356040541a08aedf731c7e7be9c43f9250b678 have be updated

NickMilton, 2019-07-24:
> [2135604](https://github.com/bigtreetech/BIGTREETECH-SKR-PRO-V1.1/commit/21356040541a08aedf731c7e7be9c43f9250b678) have be updated

Thank you! This works now
Kind regards

dant220, 2019-07-26:
I am stuck...I am getting:
<command-line>:0:0: note: this is the location of the previous definition
*** [.pioenvs/BIGTREE_SKR_PRO/src/src/HAL/HAL_STM32/HAL_Servo_STM32.cpp.o] Error 1
*** [.pioenvs/BIGTREE_SKR_PRO/src/src/HAL/HAL_STM32/HAL_timers_STM32.cpp.o] Error 1
*** [.pioenvs/BIGTREE_SKR_PRO/src/src/HAL/HAL_STM32/HAL.cpp.o] Error 1
*** [.pioenvs/BIGTREE_SKR_PRO/src/src/HAL/HAL_STM32/HAL_spi_STM32.cpp.o] Error 1

[Configurations.zip](https://github.com/bigtreetech/BIGTREETECH-SKR-PRO-V1.1/files/3433649/Configurations.zip)

Any clues?

golfromeo-fr, 2019-07-26:
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

does your bigtreetech LCD 12864 work please?

NickMilton, 2019-07-26:
Yes it works fine and the SD card slot works too. What I found are 2 things:

1 The LCD lights up on power up but does not display boot screen until I plug the USB cable into  computer

2 The LCD will not move off the boot screen until I connect the host (In this case Repetier Host) running on the computer.

The board is configured for external power. Looking through forums to see if this problem is known

Ta

DavidThijs, 2019-07-29:
@NickMilton This is indeed my observation too. I'm wondering why it only starts working when the USB connector is plugged in. Tought about a ground loop, but +5v and GND are there on EXP1, but when using only EXP1 and EXP2, the display is dim. Only when adding the TFT connector, then it is bright. The 12864 emulation only seems to work when USB plugged in. Strange indeed.

chasinreno, 2019-07-31:
I downloaded the current BIGTREE_PRO firmware with the changes above but still get the BITGREE_SKR_PRO environment error.
ARGGG!  bigtreetech SKR v1.3 usb-driver won't install on my win8.1 so that board is wasted and now SKR PRO won't compile.

dant220, 2019-07-31:
Use the marlin latest release instead.

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

ruttenfam, 2019-08-01:
@Bigtreetech can you please ensure that the files available here are a combination of marlin 2.0 and the board specific changes are all reflected in the firmware. If the base file should still be the latest marlin 2.0 code from marlin and not the one you have posted here, then the files should be deleted from GitHub and only the required changes to the stock code should be shown.

Also please answer the USB/LCD question/above. The reason user post here on the @bigtreetech GitHub page and not a general Forum, is because we expect answers from the manufacturer to support their product all these users paid for. If other users can help that is great, but the answers should first come from @bigtreetech in the first place. Thank you.

chasinreno, 2019-08-01:
My issue was solved by deleting git in control panel.  I wonder if it was a conflict between git desktop and git client.  I can't explain it but bugfix 2.0 now compiles without error.
Thanks to everyone who helped including Bit Tree Tech support. ;)

rlvanhuis, 2019-08-02:
Unable to compile.  Keep getting numerous errors.
Windows 10 Home Edition
VSCode with Platformio
Approximately 20 minutes to have a fail.
I have tried just compiling the code as given from the Bigtreetech GitHub SKR V1.1 Pro location
Epic Fail.
Support from Bigtreetech is telling me the code is good and I am modifying it.
No to sure but unzip does not modify the code.
I have installed Git, VSCode, Platformio.  Am I missing something?
Pretty new to troubleshooting code problems.  Passable at entering parameter changes and pressing buttons.
Any help would be appreciated.  Thanks

RudiBlubb, 2019-08-02:
Dear All,
i just compile it minutes before with the the same Platformio and the results are 1 Warning (i am not sure if relevant) and 4 compile PROBLEMS (but all 4 the same thing)

I seems some one has use an outdated notation "boolean".
I corrected it to "bool" for times.
See attached pdf !

Bigtreetech guys, please check and change for all others the relevant file !

Happy programming !

wesk-ms, 2019-08-02:
Hard to help without knowing the errors or your config.  :)

Please zip your platformio.ini, configuration.h, configuration_adv.h, and the complete output from your compile attempt.

rlvanhuis, 2019-08-02:
I am very new at this, sorry for the unconventional approach.  Something
has changed from this morning.  I am now getting this error set.  I do not
even know where to start.  The project seemed simple at first, then nothing
wanted to compile.  So I tried to just compile the image from their site
...no changes.  still fails

Warning! `env_default` configuration option in section [platformio] is
deprecated and will be removed in the next release! Please use
`default_envs` instead
Processing BIGTREE_SKR_PRO (platform: ststm32@5.4.3; board:
BigTree_SKR_Pro; framework: arduino)
--------------------------------------------------------------------------------------------------------------------------------------------------------------
Verbose mode can be enabled via `-v, --verbose` option
CONFIGURATION:
https://docs.platformio.org/page/boards/ststm32/BigTree_SKR_Pro.html
PLATFORM: ST STM32 5.4.3 > STM32F407ZG (192k RAM. 1024k Flash)
HARDWARE: STM32F407ZGT6 168MHz, 192KB RAM, 1MB Flash
DEBUG: Current (cmsis-dap) External (cmsis-dap, jlink, stlink)
PACKAGES: framework-arduinoststm32 3.10500.190327 (1.5.0),
toolchain-gccarmnoneeabi 1.70201.0 (7.2.1)
Converting Marlin.ino
LDF: Library Dependency Finder -> http://bit.ly/configure-pio-ldf
LDF Modes: Finder ~ chain, Compatibility ~ soft
LibraryManager: Installing c1921b4
Using cache:
C:\Users\rlvan\.platformio\.cache\8c\f244bfa38b7bfff5e9042f5d9f9f5c8c
WindowsError: [Error 206] The filename or extension is too long:
'c:\\Users\\rlvan\\Desktop\\New folder
(2)\\BIGTREETECH-SKR-PRO-V1.1\\firmware\\Marlin-SKR-Pro\\.piolibdeps\\BIGTREE_SKR_PRO\\_tmp_installing-cr6pke-package\\TMC26XStepper-c1921b4856a5ef4b659b661b8cb5dd56f3075e57\\examples\\TMC26XMotorTester\\processing\\TMC26XMotorTest':
  File
"C:\Users\rlvan\.platformio\penv\lib\site-packages\platformio\builder\main.py",
line 126:
    env.SConscript("$BUILD_SCRIPT")
  File
"C:\Users\rlvan\.platformio\packages\tool-scons\script\..\engine\SCons\Script\SConscript.py",
line 541:
    return _SConscript(self.fs, *files, **subst_kw)
  File
"C:\Users\rlvan\.platformio\packages\tool-scons\script\..\engine\SCons\Script\SConscript.py",
line 250:
    exec _file_ in call_stack[-1].globals
  File "C:\Users\rlvan\.platformio\platforms\ststm32@5.4.3\builder\main.py",
line 91:
    target_elf = env.BuildProgram()
  File
"C:\Users\rlvan\.platformio\packages\tool-scons\script\..\engine\SCons\Environment.py",
line 224:
    return self.method(*nargs, **kwargs)
  File
"C:\Users\rlvan\.platformio\penv\lib\site-packages\platformio\builder\tools\platformio.py",
line 124:
    _build_project_deps(env)
  File
"C:\Users\rlvan\.platformio\penv\lib\site-packages\platformio\builder\tools\platformio.py",
line 49:
    project_lib_builder = env.ConfigureProjectLibBuilder()
  File
"C:\Users\rlvan\.platformio\packages\tool-scons\script\..\engine\SCons\Environment.py",
line 224:
    return self.method(*nargs, **kwargs)
  File
"C:\Users\rlvan\.platformio\penv\lib\site-packages\platformio\builder\tools\piolib.py",
line 1043:
    project.install_dependencies()
  File
"C:\Users\rlvan\.platformio\penv\lib\site-packages\platformio\builder\tools\piolib.py",
line 878:
    lm.install(uri)
  File
"c:\users\rlvan\.platformio\penv\lib\site-packages\platformio\managers\lib.py",
line 353:
    force=force)
  File
"c:\users\rlvan\.platformio\penv\lib\site-packages\platformio\managers\package.py",
line 724:
    track=True)
  File
"c:\users\rlvan\.platformio\penv\lib\site-packages\platformio\managers\package.py",
line 506:
    self.unpack(dlpath, tmp_dir)
  File
"c:\users\rlvan\.platformio\penv\lib\site-packages\platformio\managers\package.py",
line 214:
    return fu.unpack(dest_dir, with_progress=with_progress)
  File
"c:\users\rlvan\.platformio\penv\lib\site-packages\platformio\unpacker.py",
line 123:
    self._unpacker.extract_item(item, dest_dir)
  File
"c:\users\rlvan\.platformio\penv\lib\site-packages\platformio\unpacker.py",
line 38:
    self._afo.extract(item, dest_dir)
  File "C:\Users\rlvan\.platformio\python27\Lib\zipfile.py", line 1031:
    return self._extract_member(member, path, pwd)
  File "C:\Users\rlvan\.platformio\python27\Lib\zipfile.py", line 1082:
    os.mkdir(targetpath)
================================================================= [ERROR]
Took 1.36 seconds
=================================================================

=========================================================================
[SUMMARY]
=========================================================================
Environment megaatmega2560              [IGNORED]
Environment megaatmega1280              [IGNORED]
Environment at90usb1286_cdc             [IGNORED]
Environment at90usb1286_dfu             [IGNORED]
Environment DUE                         [IGNORED]
Environment DUE_USB                     [IGNORED]
Environment DUE_debug                   [IGNORED]
Environment LPC1768                     [IGNORED]
Environment LPC1769                     [IGNORED]
Environment melzi                       [IGNORED]
Environment melzi_optiboot              [IGNORED]
Environment rambo                       [IGNORED]
Environment sanguino_atmega644p         [IGNORED]
Environment sanguino_atmega1284p        [IGNORED]
Environment STM32F1                     [IGNORED]
Environment fysetc_STM32F1              [IGNORED]
Environment BIGTREE_SKR_MINI            [IGNORED]
Environment STM32F4                     [IGNORED]
Environment STM32F7                     [IGNORED]
Environment ARMED                       [IGNORED]
Environment alfawise_U20                [IGNORED]
Environment mks_robin                   [IGNORED]
Environment mks_robin_mini              [IGNORED]
Environment mks_robin_nano              [IGNORED]
Environment JGAURORA_A5S_A1             [IGNORED]
Environment black_stm32f407ve           [IGNORED]
Environment BIGTREE_SKR_PRO             [FAILED]
Environment teensy35                    [IGNORED]
Environment malyanm200                  [IGNORED]
Environment esp32                       [IGNORED]
Environment fysetc_f6_13                [IGNORED]
Environment linux_native                [IGNORED]
=========================================================== 1 failed, 0
succeeded in 1.50 seconds
===========================================================
The terminal process terminated with exit code: 1

Terminal will be reused by tasks, press any key to close it.

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

rlvanhuis, 2019-08-02:
Here are the other files you were looking for.

I really appreciate you looking at this for me.
I am using VScode Platformio.
Thank You!

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

wesk-ms, 2019-08-03:
@rlvanhuis I've tried two different browsers and I'm not seeing any attached files in your last response.  Are you sure they are getting attached to your message?
If you're attaching them in an email response, it doesn't appear to be working.  You might try attaching the files through the Github website.

What stepper drivers do you have plugged into the SKR pro board?  Platformio is trying to process anything and everything related to a long list of dependencies bigtreetech has specified in the platformio.ini file.  I doubt you actually need all that excess baggage.  The problem causing the compile failure is that platformio is trying to process the TMC26XStepper library and the folder structure is so nested that it's hitting a path limitation.

'c:\\Users\\rlvan\\Desktop\\New folder
(2)\\BIGTREETECH-SKR-PRO-V1.1\\firmware\\Marlin-SKR-Pro\\.piolibdeps\\BIGTREE_SKR_PRO\\_tmp_installing-cr6pke-package\\TMC26XStepper-c1921b4856a5ef4b659b661b8cb5dd56f3075e57\\examples\\TMC26XMotorTester\\processing\\TMC26XMotorTest':

The fix is probably real easy, we just need to know what stepper drivers you're using.

@bigtreetech , your most recent commit that changed the TMCStepper library to your branch is causing this folder to be created on the local disk:  **TMC26XStepper-c1921b4856a5ef4b659b661b8cb5dd56f3075e57**

jeffkarney, 2019-08-03:
Whats sad is this is the worst thread I have ever seen. Absolutely no information from anyone as to what their problem is.
"Failed"
is not a description of a problem. A screenshot of your config helps none without the real error.

Unfortunately I think this is the closest thing I can find to a possible problem I can not find anything on.

Trying to compile Marlin on OSX for this board...
```
AVAILABLE: dfu, jlink, stlink
CURRENT: upload_protocol = stlink
Uploading .pioenvs/BIGTREE_SKR_PRO/firmware.elf
GNU MCU Eclipse OpenOCD, 64-bitOpen On-Chip Debugger 0.10.0+dev-00593-g23ad80df4
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

Thread 18 (2019-07-23):

SKR PRO Serial Ports

ilakuli, 2019-07-23:
Hello

when I set the Serial Ports for the SKR Pro like in the Firmware provided here on GitHub, my board would not boot up until a USB Connection is established. It would wait for USB Connection to boot up.

Fixed this issue by changing the Serial Ports in Configuration.h [here](https://github.com/bigtreetech/BIGTREETECH-SKR-PRO-V1.1/blob/979d0b338d3f15887463eb8dcdb6ca13e3919f4a/firmware/Marlin-SKR-Pro/Marlin/Configuration.h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) as follows:

#define SERIAL_PORT -1
#define SERIAL_PORT_2 1

omahena, 2019-08-20:
This works. for me as well. But some hints are strewn in the issue #9 .

It is stated that it is better to use:
```
#define SERIAL_PORT 1   // Port for TFT
#define SERIAL_PORT_2 6  // Port 6 for ESP-01s
```

On the other hand the comment for `SERIAL_PORT` says:
`Select the serial port on the board to use for communication with the host.`

And for `SERIAL_PORT_2`:
`Select a secondary serial port on the board to use for communication with the host.`

Serial port:
-1 is for USB CDC
1 is for TFT
6 is for ESP-01S

So.. If one reads between the lines... I guess it is no surprise that with `SERIAL_PORT` defined as 1 and `SERIAL_PORT_2` as 6... This will connect Marlin's command interface to these two ports and accept commands from the TFT screen and the ESP3D WiFi module... But this will render the USB serial port useless so you cannot use Octoprint for example.

So...
```
#define SERIAL_PORT -1
#define SERIAL_PORT_2 1
```
Seems to make sense until SERIAL_PORT_3 is added and I can throw my BTT WiFi module in the waste BCPs box it seems for future use. The LCD seems more useful after all if you already have OctoPrint.

jimhiggs, 2020-04-18:
Glad I found this comment I was pulling my hair out trying to find the right combination to get both the usb and esp01 Wifi working together. So its one or the other onboard. Previously I had the esp01 plugged into the TFT and that gave me both . Problem I have been having is that running pronterface over USB it cant see files on the onboard sd and running ESP3D on wifi it cant read the SD card on the TFT.... I just want to be able to stop having to copy files by loading them onto an sd card on my PC and plugging it into the TFT.

TechnicalWorld2016, 2020-11-04:
I had uploaded marlin 2.0 firmware on my Bigtree tech SKR PRO V1.1 board successfully and connected with pronterface and checked the motor orientations. Next day I am about to do the PID tuning, but the board was not connecting to my PC, no COM port is detected my PC, I have tried to connect with other laptops in my office, but there is no result. The board is getting power on and taking input supply. When I try to press ENDSTOP manually, the respective led near stepper driver is blinking, resulting in normal functionality. But I am unable communicate with the board neither with Pronterface nor with TFT 2.8. I have tried changing the serial_port, Serial_port 2 in marlin and tried to upload the firmware, but no change in the result, finally I am unable to cummunicate with the Board.

If anyone have a solution, please do reply.

gafillll, 2021-04-04:
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
check the image

Thread 23 (2019-08-04):

E3D Thermocoule E1 Thermal Runaway

hopeinformer, 2019-08-04:
I'm not sure if this is a bug or operator error.
I have tried many combinations of setting up the thermocouple for the E3D V6 hotend on the Bigtreeteck MKR Pro board. I am using the thermocouple amplifier board and reassigned the pin for Temp Sensor 0 in the PINS.h to use one of the Expansion pins (PF8). I also tried to use the original sensor 0 pin (PF4) but none of these work.
I followed the E3D instructions found here: https://reprap.org/wiki/ExtThermoCouple_1.0

AnHardt, 2019-08-04:
Neither nor.
This part of Marlin was never ported to 3.3V processors.

This module needs 5V to work - 3.3V is not enough.
It also will produce up to 5V at its output.
5V is to much for the 3.3 processors and will destroy the processors ADC.

**Using this Modules with 3.3V processors is not a good idea!**

Even if we ignore that problem and never exceed 330°C and for that stay below 3.3V we do need an other table because now not 5V is 500°C == 1023ADC, but 3.3V is 330°C == 1023ADC.

Haschtl, 2019-08-04:
I have the same Problem with my E3d Pt100 amplifier Board.
I will supply this Board with 5V and add a voltage divider to the output, that the maximum output voltage is 3,3V. As I know, we wouldnt need to modify the LUT... But maybe i'm wrong.
Anyway I will calibrate my thermistors manually and adjust the lookuptable, so thats Not a Real Problem for me

hopeinformer, 2019-08-06:
Thank you for your comments AnHardt and Haschtl.
Based on that feedback, I'll stick with the traditional thermistor and forget about the higher temperatures until this gets worked out.

evandene, 2019-10-06:
> I have the same Problem with my E3d Pt100 amplifier Board.
> I will supply this Board with 5V and add a voltage divider to the output, that the maximum output voltage is 3,3V. As I know, we wouldnt need to modify the LUT... But maybe i'm wrong.
> Anyway I will calibrate my thermistors manually and adjust the lookuptable, so thats Not a Real Problem for me

Dear Haschtl,
I have the same problem but because I'm quite a hardware dummy, could you please explain how you installed the E3D PT100 sensors and the amplifier board to the SKR Pro v1.1?
What pins are you using for hooking up the amplifier(s)
I have two extruders and two hot-ends

tphan26363, 2019-10-06:
I did have the same problem with PT100 amp.  How ever this happen to all other hardware as well since the rail voltages of all chips are not the same.  For all 32 bit some of them max out and 3.2 V some of them is 3.25V ect. So the PT100 board can not really adapt to all of them.  It just an analog amplification so it is not accurate to scale with an AD converter.  I just use the 3.3V as the VCC for the PT100( it's ok the chip could works at much lower voltages) and compensate for the different of the AD voltage range(3.0 for some chip mine is 3.2V) by multiply the temperature table to a 3.2/3.3V ratio( you must look at the data sheet of your chip to find out max Voltage for you AD converter).  Or you can use 100 ohm resistor reference to recalculate the table.  Practically it is easier to use a buck converter to lower the 5V to 3.3V to PT100 board and adjust until you read correctly ADC values

hopeinformer, 2019-10-06:
Thank you tphan26363. That's the most helpful information on these PT100 and amp board. I will use the buck converter. Which pins are best used for this on the Pro v1.1?

tphan26363, 2019-10-06:
Just use the existing pin for e0.  it has a pull up resistor but should not
affecting the PT100  much since the board should be able to dive much more
current than that

On Sun, Oct 6, 2019 at 2:45 PM hopeinformer <notifications@github.com>
wrote:

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

evandene, 2019-10-08:
For your information: I use MARLIN 2.0 from BIGTREE-TECH because of some pin and stepper corrections. https://github.com/bigtreetech/BIGTREETECH-SKR-PRO-V1.1

It works, ... BUT do not connect the amplifier output signal with the thermistor input E1, E2, etc .. my board froze up.

I use E3D PT100 sensor and E3D amplifier.
Will change this later by a Adafruit amplifier because of the 5V input and the 3.3V output signal of the board.
T0 is responding on my E3D amplifier with PT100 sensor
I use PF8 from EXTENSION1 as signal pin.
I use GND and 3.3V from a free limit switch connector
Do not forget to change pin settings in the:
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

tphan26363, 2019-10-08:
That does not sound right.  Froze up when connect the amp to the T0 input?
I think it can't froze up when connect the amp board to the T0 input.
Unless your amp board is freaking weird.  But I think it more like a
firmware reaction to shutdown the board when it received weird temperature
reading from the amp board.  I have no problem with mine what so ever.  The
Adafruit look good to me because it does have a part number Max31865 and
clear label to the board.  That can help .  But for me I think this board
is  totally different from the amp board mine you.
This is actually is a A-D converter not an amp board. The T0 and T1
actually is a analog input so I don't know how you can configure it.  But
it probably that you have to change it to a digital input instead.  Good
luck.

On Mon, Oct 7, 2019 at 11:00 PM Ed van den Enden <notifications@github.com>
wrote:

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

evandene, 2019-10-08:
T0 is NOT responding on my E3D amplifier with PT100 sensor
I use PF8 from EXTENSION1 as signal pin.
I use GND and 3.3V from a free limit switch connector.

settings in configuration.h
#define TEMP_SENSOR_0 20
#define TEMP_SENSOR_1 20

ALL Works fine now. I installed also my second extruder and hot-end.
I also have my WiFi working
Good luck

emilhse, 2019-11-11:
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

Can you please explain what changes you made in pins_BIGTREE_SKR_PRO_V1.1.h?

emilhse, 2019-11-29:
> That does not sound right. Froze up when connect the amp to the T0 input? I think it can't froze up when connect the amp board to the T0 input. Unless your amp board is freaking weird. But I think it more like a firmware reaction to shutdown the board when it received weird temperature reading from the amp board. I have no problem with mine what so ever. The Adafruit look good to me because it does have a part number Max31865 and clear label to the board. That can help . But for me I think this board is totally different from the amp board mine you. This is actually is a A-D converter not an amp board. The T0 and T1 actually is a analog input so I don't know how you can configure it. But it probably that you have to change it to a digital input instead. Good luck.
> […](#)
> On Mon, Oct 7, 2019 at 11:00 PM Ed van den Enden ***@***.***> wrote: For your information: I use MARLIN 2.0 from BIGTREE-TECH because of some pin and stepper corrections. https://github.com/bigtreetech/BIGTREETECH-SKR-PRO-V1.1 It works, ... BUT do not connect the amplifier output signal with the thermistor input E1, E2, etc .. my board froze up. I use E3D PT100 sensor and E3D amplifier. Will change this later by a Adafruit amplifier because of the 5V input and the 3.3V output signal of the board. T0 is responding on my E3D amplifier with PT100 sensor I use PF8 from EXTENSION1 as signal pin. I use GND and 3.3V from a free limit switch connector Do not forget to change pin settings in the: [image: Amplifier signal pins] <https://user-images.githubusercontent.com/8578321/66370509-d939e500-e9a0-11e9-90e7-655c2f4c5d98.JPG> [image: adafruit amplifier] <https://user-images.githubusercontent.com/8578321/66370587-13a38200-e9a1-11e9-9bd9-9236b0a5f618.JPG> — You are receiving this because you commented. Reply to this email directly, view it on GitHub <#23?email_source=notifications&email_token=AMXYTRGFD4AJN67IWNNOJW3QNQOZDA5CNFSM4IJFILN2YY3PNVWWK3TUL52HS4DFVREXG43VMVBW63LNMVXHJKTDN5WW2ZLOORPWSZGOEAS46NI#issuecomment-539348789>, or mute the thread <https://github.com/notifications/unsubscribe-auth/AMXYTRDQ6Q3PZN2MKZSL24TQNQOZDANCNFSM4IJFILNQ> .

Can you please share, what amplifier board you used, and which pins you used?

AnHardt, 2019-11-29:
The Tx connectors are made for comparing a thermistors **resistance** to a on-board 4K7 pull-up resistor.

The E3d Pt100 amplifier Boards have an proportional to the temperature **voltage** at their output. You can connect them to the T connectors, but the measured temperature will be wrong because the pull up resistor changes the measured voltage. Better connect them to a ADC-pin with no pull-up resistor.

The MAX31865 are completely different and connected to a SPI-bus. They have an ADC on board.

evandene, 2019-11-29:
The Adafruit PT100 board do work fine for me as well as the E3D Pt100 board

emilhse, 2019-11-29:
Thank you very much guys. Did anyone tried connecting max31865? If yes how? I'm quite dummy in all of this .And which board is more accurate? The reason I'm asking because I have no choice, I have built pellet extruder which needs accurate and stable temperature. I can of course use external temperature regulator but I want to control directly from the board

emilhse, 2019-11-29:
> The Adafruit PT100 board do work fine for me as well as the E3D Pt100 board

What type of stepper drivers do you use , do you use spi for them at the same time?

evandene, 2019-11-29:
> > The Adafruit PT100 board do work fine for me as well as the E3D Pt100 board
>
> What type of stepper drivers do you use , do you use spi for them at the same time?

Okay,
Please find my configuration file, my configuration_adv and my pins_BIGTREE_SKR_PRO_V1,1 file.
I us TMC5160 drivers.
The pins file need to be renamed as ........ V1.1

[configuration.txt](https://github.com/bigtreetech/BIGTREETECH-SKR-PRO-V1.1/files/3906049/configuration.txt)
[configuration_adv.txt](https://github.com/bigtreetech/BIGTREETECH-SKR-PRO-V1.1/files/3906050/configuration_adv.txt)
[pins_BIGTREE_SKR_PRO_V11.txt](https://github.com/bigtreetech/BIGTREETECH-SKR-PRO-V1.1/files/3906053/pins_BIGTREE_SKR_PRO_V11.txt)

emilhse, 2019-11-29:
thank you very much sir.

emilhse, 2019-12-01:
do i need to remove pull up resistor?

evandene, 2019-12-01:
PF9 will be okay

emilhse, 2019-12-01:
thanks

AnHardt, 2019-12-01:
> do i need to remove pull up resistor?

You could - but using any of these ADC-pins is much easier.

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

evandene, 2019-12-01:
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

emilhse, 2019-12-04:
thank you very much guys for great support

johnny49r, 2020-03-17:
Hi, You can use the E3D PT100 board without modification on the BigTreeTech boards but should work for other 3.3V / 32 bit controllers.
First you need to run the E3D board at 3.3V since the BTT analog inputs are not 5V tolerant. The E3D PT100 [INA826] amp will run fine down to 3V.
Second you will need to compile the Marlin FW with the attached thermistor_22.h file. This has correct translation for 3.3V operation and also offset caused by the <standard> 4.7K pullup on the BTT thermistor inputs.
Limitations: Due to the limited voltage swing of the amplifier at 3.3V the max temperature it can report is approx 360 C but I think that is useful for most folks.
Please see the attached file for more details. You will need to change the file extension from .txt to .h.
[thermistor_22.txt](https://github.com/bigtreetech/BIGTREETECH-SKR-PRO-V1.1/files/4343517/thermistor_22.txt)

TheMiguelBi, 2020-04-13:
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

Thanks for this info **johnny49r** !
I am trying to operate my PT100 amplifier. But I use another card, **BTT GTR v1.0**
The no-load measurement is 31°C, when it should measure 20-21°C.
I am feeding the electronics with a powerbank via USB. The power supply of the amplifier is not 3.3v but slightly lower (3.25v).

_Something escapes me ....._

johnny49r, 2020-04-14:
Hi,

Please verify that you are using this PT100 amplifier:
https://wiki.e3d-online.com/E3D_PT100_Amplifier_Documentation#Schematic
This works fine with the BTT V1.3/V1.4 boards.

I couldn't find a schematic for the BTT GTR board but the thermistor table
calculation assumes that the thermistor analog input has a 4.7K ohm pullup
to VCC (in your case 3.25V). If the pullup value is different this would
account for the discrepancy.

I have attached the THERMISTOR_22.h file and it shows the calculations for
the Marlin lookup table using a PT100 temperature vs resistance chart as
described here:
http://www.manoraz.com/_Uploads/dbsAttachedFiles/PT-100_Table.pdf

The Marlin lookup table has data points for every 10 degrees C associating
raw ADC values for each point. Finer resolution is derived by
interpolation.
I hope this helps. Please let me know if you need further info.

John

On Mon, Apr 13, 2020 at 11:09 PM TheMiguelBi <notifications@github.com>
wrote:

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

johnny49r, 2020-04-14:
Hi,

Sorry, one small detail I might have forgotten to mention: You need to add
the following text to the thermistors.h file located in the
Marlin/src/module/thermistor directory:

#if ANY_THERMISTOR_IS(22) // Pt100 with E3D amp @ 3.3v w/4.7K pullup
(BigTreeTech, etc.). Abbycus 2020
  #include "thermistor_22.h"
#endif

Also make sure the thermistor_22.h file is installed in that same directory.

Then recompile with the latest Marlin 2.0.x bugfix.

Good luck!

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

Symbyos83, 2020-04-14:
> Hi, Sorry, one small detail I might have forgotten to mention: You need to add the following text to the thermistors.h file located in the Marlin/src/module/thermistor directory: #if ANY_THERMISTOR_IS(22) // Pt100 with E3D amp @ 3.3v w/4.7K pullup (BigTreeTech, etc.). Abbycus 2020 #include "thermistor_22.h" #endif Also make sure the thermistor_22.h file is installed in that same directory. Then recompile with the latest Marlin 2.0.x bugfix. Good luck!
> […](#)

Hi johnny49r, I have found perhaps the problem that says TheMiguelBi, in the GTR wiring diagram there is a 22 ohm resistor in series, perhaps it is what creates temperature differences ...
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

johnny49r, 2020-04-14:
Hi symbyos83,

The 22 ohm shouldn't make any difference since it is connected to the ADC
input which is high impedance. The 22 ohm resistor and the two diodes are
there to protect the analog input from incorrect voltages that could damage
the chip but normally there is almost no current flow through the resistor.
Maybe TheMiguelBi might be using a different PT100 amplifier or perhaps he
forgot to compile the firmware using my lookup table (thermistor_22.h).
If the lookup table is wrong I can make another if I know what the PT100
amp circuit looks like.

Thanks, John

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

tiros76, 2020-05-15:
@johnny49r

Man, a huge thanks to you for sharing this!  I was initially having the same issue with my SKR1.4 Turbo as @TheMiguelBi  was with my E3D pt100 board and your thermistor_22.h file and thermistor.h edit. I was consistently showing 7 degrees over ambient with the PT100 powered from the 3.3v rail.  So I decided to use an adjustable buck  converter connected to Vin to tune the supply voltage until I was getting correct temp. the PT100 board seems to be incredibly sensitive to variations in the 3.3v supply voltage.

I pulled Vin (in my case 12v) from one of the extra always-on fan headers on the SKR1.4. Connected the 12v supply to the input on the buck converter and output to the PT100 board.  You will need to tune the converter before you wire it up to avoid torching the thermistor inputs. I my case I just attached the converter to a benchtop power supply (you can use Vin)  and adjusted until I had exactly 3.3v on the output.  From there I connected it up to the printer and tweaked in real time so that it matched ambient on the LCD. All it took was around 0.03v  to bring it into spec.

Confirmed accuracy with a K-type thermocouple stuffed under the silicone sock. Compared and verified the temps from 80-220C to an identical hotend setup measured in the exact same fashion. The readings were spot on.

I got the adjustable buck converter from amazon. just search Mini MP1584EN DC-DC Buck Converter

Not sure if this is the safest setup considering the source of the 3.3 volts, although it seemed very steady on my meter. Perhaps someone else has a better idea for a cleaner power source for the PT100 board since the 3.3v from the SKR1.4 was not working.

Hopefully this provides something helpful. I will update when I get around to clearing out the PLA and testing to a higher temp with this setup.

panecki, 2020-05-18:
Hi, does anyone have a working version 2.0.5.3(skr pro 1.1) with the MAX31865 amplifier? I've been working on the launch for several days and I'm still getting Err MAXTEMP: E1. I've also tested MAX31855 and MAX6675 I get the same error everywhere.

GadgetAngel, 2020-07-28:
> Hi, does anyone have a working version 2.0.5.3(skr pro 1.1) with the MAX31865 amplifier? I've been working on the launch for several days and I'm still getting Err MAXTEMP: E1. I've also tested MAX31855 and MAX6675 I get the same error everywhere.

I would like this information also

GadgetAngel, 2020-07-28:
When using 21 as the setting for TEMP_SENSOR_0 in Configuration.h for Marlin 2.0.x, is the 4.7K ohm resistor on the T1 (E0) port taken into account when using this table at 3.3VDC (with PT100 and PT100 amplifier board)?

johnny49r, 2020-07-28:
Hi,

Please check here: https://github.com/johnny49r/BigTreeTech

The calculated table is for the E3D PT100 amp using the INA826 which has a
diff gain of 10. You can modify the calculations to create your own
thermistor table. Please let me know if you need help.
John H

On Tue, Jul 28, 2020 at 12:07 PM GadgetAngel <notifications@github.com>
wrote:

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

GadgetAngel, 2020-07-29:
> Hi, Please check here: https://github.com/johnny49r/BigTreeTech The calculated table is for the E3D PT100 amp using the INA826 which has a diff gain of 10. You can modify the calculations to create your own thermistor table. Please let me know if you need help. John H
> […](#)
> On Tue, Jul 28, 2020 at 12:07 PM GadgetAngel ***@***.***> wrote: When using 21 as the setting for TEMP_SENSOR_0 in Configuration.h for Marlin 2.0.x, is the 4.7K ohm resistor on the T1 (E0) port taken into account when using this table at 3.3VDC (with PT100 and PT100 amplifier board)? — You are receiving this because you were mentioned. Reply to this email directly, view it on GitHub <[#23 (comment)](https://github.com/bigtreetech/BIGTREETECH-SKR-PRO-V1.1/issues/23#issuecomment-664779528)>, or unsubscribe <https://github.com/notifications/unsubscribe-auth/AEY4LQ4U2BDRZZTHZZYVOYDR5ZMKPANCNFSM4IJFILNQ> .

@johnny49r In the newest version of Marlin 2.0.6 they added new temperature sensor tables to the firmware.  You use table number 22 when setting up your table.  Why not change your table number to 222?

Marlin version 2.0.6's  definitions for PT100:                                                     
 *    -5 : PT100 / PT1000 with MAX31865 (only for sensors 0-1)                                                                                                     
 *    20 : Pt100 with circuit in the Ultimainboard V2.x with 5v excitation (AVR)
 *    21 : Pt100 with circuit in the Ultimainboard V2.x with 3.3v excitation (STM32 \ LPC176x....)                                                    
 *   201 : Pt100 with circuit in Overlord, similar to Ultimainboard V2.x                                                                                         
 *   147 : Pt100 with 4k7 pullup
 *   110 : Pt100 with 1k pullup (non standard)

Newest edition to temperature sensor tables (but these do not affect PT100 sensor they just use number 22 and 23 and are for 100k Thermistor sensors):
*    22 : 100k (hotend) with 4.7k pullup to 3.3V and 220R to analog input (as in GTM32 Pro vB)
*    23 : 100k (bed) with 4.7k pullup to 3.3v and 220R to analog input (as in GTM32 Pro vB)

## BUT, I am confused, what are the differences between table 20, table 21, table 201,  table 147 and table 110 beyond the obvious pull-up resistors?
## What is table 201 used for??  What
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

Thread 25 (2019-08-07):

Bootloader

AnHardt, 2019-08-07:
I'm looking for the bootloader - ideally for its sources - even if not *Arduino*.

golfromeo-fr, 2019-08-12:
afaik you can only update the firmware from the sdcard as of now.
I am not sure you need a bootloader

AnHardt, 2019-08-12:
I also can upload software via ST-Link. But then the risk of overwriting the bootloader is high.
Would be nice if there would be a way to repair the board in that case. Especially for those who have not saved the bootloader before.

> I am not sure you need a bootloader

You do. The custom bootloader is the piece of software reading from SD and burning into flash. The build into all ST-processors bootloader can't do that.

----------------

The custom bootloader seems to be an interesting piece of software. According to the contained strings it's seemingly able to update the WiFi board.

golfromeo-fr, 2019-08-13:
>  WiFi board.

ok now you made the point, that's needed! no wifi firmware loaded, no wifi at all!

omahena, 2019-08-20:
I can confirm that the bootloader can update the ESD3D (or rather the ESP01S WiFi module) by placing the esp3d.bin file on the SD card. It still won't make the WiFi module work, but it results in a pretty light show.

I was actually contemplating on getting an ST-Link module to allow remote updates of firmware. Can you give any insights into ST-Link parameters / procedure? Thank you in advance.

I can't seem to convince the board to accept a firmware upload through the USB connection- not sure the BOOT0 pin and reset pins are connected to the USB serial link... Some hints here: https://github.com/OctoPrint/OctoPrint-FirmwareUpdater/blob/master/README.md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

But I also cannot get the USB drive to appear when I connect it to my PC / RaspberryPi. That actually never worked for me - not even out of the box. I always have to remove the SD card and plug it into my computer, copy the firmware.bin and back to the printer it goes... reset... wait... try... retry... It gets old fast.

Any hints would be very welcome. I am using the latest version of Marlin.

redone00, 2019-08-27:
trying to compile and send firmware to sd card get error
ploading .pio\build\BIGTREE_SKR_PRO\firmware.elf
GNU MCU Eclipse OpenOCD, 64-bitOpen On-Chip Debugger 0.10.0+dev-00593-g23ad80df4 (2019-04-22-20:25)
Licensed under GNU GPL v2
For bug reports, read
        http://openocd.org/doc/doxygen/bugs.html
debug_level: 1
embedded:startup.tcl:56: Error: Can't find scripts/interface/stlink.cfg

in procedure 'script'
at file "embedded:startup.tcl", line 56
*** [upload] Error 1

AnHardt, 2019-08-27:
Right.
But seems to be a PlatfornIO setup problem. Try "start debugging" - that worked for me. Else use the card method. That works out of the box.
To *work* with the bootloader better use ST-Link directly. At first save 0x0000 to 0x8000 somewhere - that's the bootloader. Than write protect these two blocks.

redone00, 2019-08-27:
cannot get it to load to the sdcard seen to be not looking for the card  works fine with other firmware just not the  ran debug only a watch dog error

AnHardt, 2019-08-27:
> But I also cannot get the USB drive to appear when I connect it to my PC ...

For the used core not even a example composite USB CDC/MSC device seems to exist. No wonder BTT can't do that now on this board.

redone00, 2019-08-27:
I can read the usb card in a adapter but refuses to put the firmware on it get the error above

AnHardt, 2019-08-27:
Don't click "run" or "upload but "verify" to avoid the error. Than copy the "firmware.bin" file by hand per explorer. The file resides in ...\Marlin\Marlin\.pio\build\BIGTREE_SKR_PRO\firmware.bin now. (I'm talking MarlinFirmware/Marlin always.)

redone00, 2019-08-27:
looks like it flashed it does it need full power for the lcd to work

AnHardt, 2019-08-27:
For me it works with RRDFGSC or RRDSC plus ESP01S but without stepsticks powered over USB only. TFT35 3.0 is still over the ocean.

redone00, 2019-08-27:
trying it with riprap screens still waiting on my steppers

nvip12041994, 2019-09-27:
Dear, my Micro processor get issues, I need to replace new one, can I use ST link to save bootloader and upload to other processor and replace broken processor on board?

rflulling, 2019-10-13:
Hello all. I be the newest sucker to invest in this board. So it seem that they have a very real and active bootloader that is factory installed. It handles of course the firmware.bin from SD card, or rather it stores the location needed for the hardware to look for the data. Basically, it's two sets of firmware. Theirs, then ours.

The problem I think we all see is that there is of course missing information that we all need to communicate with the Controller Card. This is at every level, effect every software we know.

But the less discussed is that this may be less a matter of missing data and more a mater of an intentionally locked door. I cannot even talk to the chip through STM32CubeProgrammer which should be able to at least read the chip, but it cannot. Attempts to open a link are rejected or lockup.

I think the quest we are on as users is to pursued BIGTREETECH aka BIQU to adjust the bootloader so that we are able to flash/upload firmware files, even if it is just a copy to the onboard SD card through drag and drop to the device from desktop.

I think we can mostly agree that we do not want to pull the card every time we update firmware. I update often as Marlin is being developed. I know from experience that constant removal of any device including SD cards increases the odds of ESD, damage to the card, or the slot. I also have a SD card on the LCD that works just fine, and is far easier to access.

From this point forward, I am going to push for this fix. I hope all of you are with me.

Franchelli, 2019-10-29:
@bigtreetech
I hope bigtreetech does something very soon, otherwise I will have to change the card with another company's product

rflulling, 2019-10-30:
I cannot say what BTT is doing. They have ignored all attempts to contact. However, I can say that gears are turning and there are more than a few coders working on this from various angles. For the moment there is I think no more pushing I can do. I can only ask we all be patient for now. Hour by hour, they are working on the fixes.

However, apart from whatever unknown code lurks in the BTT bootloader that we cannot know... I have noticed conversation that may indicate that BTT has left off resistors needed for communication of serial lanes. This could be to support the jumpers that switch between SD card and USB card. I don't know. With luck a IEEE gets a look at the hardware and determine if the resisters need to be added (MOD) to enable desired functions.

Anyway. Help is coming. We just need to hold out.

sjasonsmith, 2019-10-30:
> BTT has left off resistors needed for communication of serial lanes.

If you are referring to my comments, it was regarding the TX lines documented as going to the stepper drivers. You just have to use the RX pin in half-duplex mode. TMC drivers use half-duplex serial anyway.

robustini, 2019-12-22:
@bigtreetech it would be useful if you could release the bootloader sources, thanks.

rflulling, 2019-12-22:
You may find more on this in the Marlin/Marlin git

On Sun, Dec 22, 2019, 7:02 AM Marco Robustini <notifications@github.com>
wrote:

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

Bob-the-Kuhn, 2020-04-01:
Thanks for the bootloader info.

I tanked my board by using ST-Link to upload Marlin.  I have a second board so I was able to download the bootloader and move it to the tanked board.  After inserting a disk with firmware.bin on it the board is now fully functional.

FYI - here's the bootloader:
[bootloader_0x_0000_0000.zip](https://github.com/bigtreetech/BIGTREETECH-SKR-PRO-V1.1/files/4411937/bootloader_0x_0000_0000.zip)

npmomchev, 2020-04-03:
Is possible send bootloader.bin.
Thank You

skypuppy, 2020-04-03:
What if you use the 32k offset to store your functions?  Read how klipper does it.

pecherskiy-v, 2020-04-05:
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

I tried to flash your bootloader, but got an error: "Programming error @: 0x00000000."
maybe I'm doing something wrong.
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

pecherskiy-v, 2020-04-05:
https://www.youtube.com/watch?v=cUn_A5N9mMc - working dump.

microhell, 2020-04-10:
> https://www.youtube.com/watch?v=cUn_A5N9mMc - рабочий дамп.
> https://www.dropbox.com/s/dd4r8n2oo4v00qn/SKR_PRO.zip?dl=0

осенило меня после просмотра твоего видео. и заливки твоего дампа(я понял что плата жива ну или по крайней мере  com port).
у меня gtr плата. в момент прошивки марлина пропало питание. и начались приключения.
при подсовывании на sd карте прошивки марлина - boot диод мигает, файл на карте переименовывается, диод остается гореть зеленым а не тухнет. плата не видит дисплей, компьютер не видит плату.
 я логично предположил что испортился bootloader. пришлось купить st-link.  но оригинальный bootloader не найдет, китайцы мило улыбаются на просьбы выслать.
хотел уже заказывать новую плату.
не буду описывать весь процесс метода научного тыка скажу лишь выводы.
1. что бы заработал марлин, нужно привести, перед передачей управления марлину, плату в какое то определенное состояние.
2. этим занимается bootloader. иначе марлин не работает.
3. если bootloader во flash процессора есть. то он передает управление по определенному адресу и там должен быть марлин. тогда все работает даже если прописать марлин программатором. для gtr это 0x08008000.
4. сняв дамп после сбоя питания я выяснил что при перепрошивке с sd, bootloader почему то прописывал марлин с 0x0800A000. а управление передавал на 0x08008000. не совсем уверен в этом выводе но выглядит все именно так. загадочная китайская душа программиста.
5. вылечил следующим образом. нашел в дампе где заканчивается bootloader и обрезал файл.
обнулил flash. записал загрузчик с 0x080000000. и прописал марлин по 0x08008000. (можно записать с sd)

pecherskiy-v, 2020-04-13:
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

я не заметил в прошивке марлина инициализации проца, думаю как раз этим и занимается бутлоадер. с помощью st-link можно получить информацию о том что было инициализировано в момент его запуска. думаю нужно попробовать подключиться и пройти по шагам и посмотреть что делаем загрузчик или попробовать дисасамблером пройти по бутлоадеру ( но это нее самая приятная процедура )

Bob-the-Kuhn, 2020-04-13:
I don't quite know what is going on here but just in case it's of any use ...

Here are binary dumps of the bootloader section (0800 0000 - 0800 7FFF) and of all of flash with a Marlin 2.0.5.3 image in it ( 0800 0000 - 08040 3FFFF).
[BTT.zip](https://github.com/bigtreetech/BIGTREETECH-SKR-PRO-V1.1/files/4472171/BTT.zip)

These files were created by the STM32 ST-LINK Utility using a ST-Link V2.1 dongle.

Yes, there are two levels of bootloader.  The ROM based bootloader starts the application at location 0800 0000.  In the our case a FLASH based bootloader has been programmed at 0800 0000 - 0800 552F by BTT.  It's the FLASH based bootloader that eventually starts the user application starting at 0800 8000.

---

Предоставлено Google Translate

Я не совсем знаю, что здесь происходит, но на всякий случай это пригодится ...

Вот двоичные дампы раздела загрузчика (0800 0000 - 0800 7FFF) и всего флэш-памяти с изображением Marlin 2.0.5.3 (0800 0000 - 08040 3FFFF).
[BTT.zip](https://github.com/bigtreetech/BIGTREETECH-SKR-PRO-V1.1/files/4472171/BTT.zip)

Эти файлы были созданы утилитой STM32 ST-LINK с использованием ключа ST-Link V2.1.

Да, есть два уровня загрузчика. Загрузчик на основе ПЗУ запускает приложение в местоположении 0800 0000. В нашем случае загрузчик на основе FLASH был запрограммирован на 0800 0000 - 0800 552F с помощью BTT. Это загрузчик, основанный на FLASH, который в конечном итоге запускает пользовательское приложение, начиная с 0800 до 8000.

microhell, 2020-04-14:
> I don't quite know what is going on here but just in case it's of any use ...
 спасибо. но моя плата gtr v 1.0.  я искал bootloader от моей платы. выше я описал свою проблему с загрузчиком при пропадании питания в момент прошивки с sd.
а pecherskiy-v  хочет прошивать marlin c помощью st-link, без bootloader от btt.

pecherskiy-v, 2020-04-14:
> > I don't quite know what is going on here but just in case it's of any use ...
> > спасибо. но моя плата gtr v 1.0.  я искал bootloader от моей платы. выше я описал свою проблему с загрузчиком при пропадании питания в момент прошивки с sd.
> > а pecherskiy-v  хочет прошивать marlin c помощью st-link, без bootloader от btt.

да все верно, я планирую прошивать его через ST-Link так как планирую производит удаленное обновление прошивки с возможностью свободно сменить прошивку например на smoothy или ещё что. и мне не удобно извлекать плату из устройства для прошивки, также наличие bootloader упрощает обновление марлина, но "закрывает" возможность работать с другими прошивками.
плату удобно использовать для целей не только 3Д печати и хотелось бы оставить возможность легко вернуть её к марлину.

Closed 2024-02-12.

Thread 27 (2019-08-12):

Error on serial connection

Haschtl, 2019-08-12:
I just got my new SKR Pro 1.1 and now tried to flash the marlin firmware.

I cloned the BIGTREETECH-SKR-PRO-V1.1 marlin firmware and made some adjustments in Configuration.h, Configuration_adv.h and pins_BIGTREE_SKR_PRO_V1.1.h.

I have SDSUPPORT and EEPROM enabled. My baudrate is 250000. My serial ports are configured as followed:
#define SERIAL_PORT 1
#define SERIAL_PORT_2 -1

When I try to connect it over serial USB with my PC (host mode), the serial device is recognized by my PC, **but** I cannot connect any client like Pronterface. Here is the serial response:

```
Connecting Machine @ USB,COM3,250000baud
 Machine connected
 echo:EEPROM version mismatch (EEPROM= Marlin=V67)
 echo:Hardcoded Default Settings Loaded
 No supported firmware detected. Closing port COM3
```

I need to say, that I have nothing connected to the board. I just got it and wanted to test Marlin. Btw. Flashing seems to work, as a green led is blinking on the board, when i upload a new firmware to the sd-card.

Haschtl, 2019-08-12:
This is the serial output of the arduino IDE serial monitor
```
start
echo: External Reset
Marlin bugfix-2.0.x

echo: Last Updated: 2019-07-07 | Author: HASCHTL
echo:Compiled: Aug 12 2019
echo: Free Memory: 100199  PlannerBufferBytes: 1792
echo:EEPROM version mismatch (EEPROM=? Marlin=V67)
echo:Hardcoded Default Settings Loaded
```

After this the arduino IDE gets stuck. It reacts again after I push the reset button or disconnect the USB cable

Haschtl, 2019-08-12:
I am now able to connect to the board over serial.
But I needed to disable SDSUPPORT and EEPROM_SETTINGS

Seems that the initialization stucks at EEProm initialization. Did I miss anything?

golfromeo-fr, 2019-08-12:
somewhere it is says 115200 bauds not 250000

from memory
#define SERIAL_PORT -1
#define SERIAL_PORT_2 1

Haschtl, 2019-08-13:
Thanks for your reply!
I can connect to the printer, when setting the serial ports the other way around:
#define SERIAL_PORT 6
#define SERIAL_PORT_2 -1

But I also need to disable
//#SDSUPPORT
and
//#EEPROM_SETTINGS

Do you have EEProm or SD enabled?

golfromeo-fr, 2019-08-13:
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

I have forgotten about something important: I am using MarlinFirmware/Marlin, no longer bigtreetech/BIGTREETECH-SKR-PRO-V1.1

from my config file
#define SERIAL_PORT -1
#define SERIAL_PORT_2 1
(I have tried SERIAL_PORT_2  as 1 or 6)
 I have
#define SDSUPPORT
#define EEPROM_SETTINGS
but I am not sure yet if it is eeprom emulation or real eeprom as I have a file eeprom.dat on the sdcard

Haschtl, 2019-08-13:
Ah! I didn't knew, that the SKR Pro 1.1 is already supported by the official MarlinFirmware repo!
I'm switching right now to the other repo.

I think the default is the eeprom emulation on sdcard as you can see in pins_BIGTREE_SKR_PRO_V1.1.h:

```
// Use one of these or SDCard-based Emulation will be used
//#define SRAM_EEPROM_EMULATION   // Use BackSRAM-based EEPROM emulation
//#define FLASH_EEPROM_EMULATION  // Use Flash-based EEPROM emulation
```
I tried these options on the BIGTREETECH fork, but they didn't change anything - it was not working, but maybe it will work with the official repo

Haschtl, 2019-08-13:
I'm now using MarlinFirmware/Marlin and it is working somehow!

I think the problem was, that I had PRINTCOUNTER enabled, which caused the problems.

I have now SDSUPPORT and EEPROM_SETTINGS enabled, but after connecting over serial, marlin says:

`echo:SD init fail`

And if I try to save the config to the EEProm with M500, it says:

`echo:No EEPROM.`

Any ideas?

dant220, 2019-08-13:
Printcounter has a dependency on EEPROM according to:
https://github.com/MarlinFirmware/Marlin/pull/11689

I am sidelined right now because my board died and I am waiting for a replacement. But I also ordered an "AT24C256 I2C Interface EEPROM Memory Module". I can apparently use this as an EEPROM instead of the SDCARD.

AnHardt, 2019-08-13:
SDSUPPORT seems to work always with an external SDcard - never with the on-board.

Haschtl, 2019-08-13:
Thanks for your reply!

Do you mean, i cannot use the integrated sd-slot, which is used to Flash the stm32, for SDSUPPORT??

Haschtl, 2019-08-14:
My initial problem has been solved.

I now also enabled EEProm Emulation on SD card by uncommenting #define FLASH_EEPROM_EMULATION in pins_BIGTREE_SKR_PRO_V1.1.h, which didn't work before. (I'm now using MarlinFirmware/Marlin)

SDSUPPORT is still not possible

dineshvyas, 2019-10-08:
FLASH EEPROM EMULATION WORKING. NO SDSUPPORT!

Baltazart, 2019-11-05:
Hello, this text is translated to English.
the following is a copy / paste.
Used on the Bigtree-tech SKR PRO V1.1 to deal with saving and remembering EEPROM settings. There was no instructions but I muddled through.

Leave WP jumper to the right, and remove all other jumpers.
Disable SRAM in **Board pins** and enable I2C EEPROM

//#define SRAM_EEPROM_EMULATION
#define I2C_EEPROM
That is all it takes.

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
>>> M500
SENDING:M500
echo:Settings Stored (602 bytes; crc 14044)
>>> M501
SENDING:M501
echo:EEPROM version mismatch (EEPROM=? Marlin=V68)
echo:Hardcoded Default Settings Loaded

it's just the beginning of my tests

LehrChristoph, 2020-01-11:
Hi  @Baltazart ,
I have the same board at home, do you have some documentation how to configure the I2C-EEPROM?

Baltazart, 2020-01-12:
> Hi @Baltazart ,
> I have the same board at home, do you have some documentation how to configure the I2C-EEPROM?

Hello, I configured as written on this link, https://github.com/sky8000/SKR-Pro-TMC5160-Ender-5-Config-Files-Marlin-2

Closed 2019-08-14.

Thread 28 (2019-08-12):

My SKR pro v1.1 with 2130 SPI steppers...

Anehall, 2019-08-12:
Hi!

Just got my Bigtreetech SKR Pro v1.1 with 2130 SPI steppers... my problem is that ive connected the 5 steppers as it show in the manual. 4 jumpers connected on the board for each axis and extruder (X, Y, Z, Z2 and E0)... But it wont work... Got the libs from here to, like it says but all 5 show this:
testing x connection error: all high
testing y connection error: all high
testing z connection error: all high
testing z2 connection error: all high
testing e0 connection error: all high

What am I missing?

Anehall, 2019-08-12:
Forgot to mention that i baught everything from Biqu as a package... Tmc2130 v3.0 spi...

Potociny444, 2019-08-13:
Need #define TMC_USE_SW_SPI in Configuration_adv.h, because TMC is not connected to default SPI (default PB15/PB14/PB13, used for SD card connected to EXP2, declared in ..\Marlin\buildroot\share\PlatformIO\variants\BIGTREE_GENERIC_STM32F407_5X\variant.h,
but TMC uses PC12/PC11/PC10 - declared in pins_BIGTREE_SKR_PRO_V1.1.h)

Also do not use auto power control for motor power, because [https://github.com/MarlinFirmware/Marlin/issues/14558](url)

Haschtl, 2019-08-19:
I fixed this by enabling the 12/24V power supply. With only 5V the TMC (in my case 5160) SPI communication did not work for me

bidmangler, 2019-11-06:
@Potociny444 has nailed it for me (thanks). I uncommented the #define mentioned in his post and all started working.
@bigtreetech - you could easily add this advice to your manual and save people time

GLGShadow, 2020-05-03:
So, I'm having the same issue with my motors not moving, and I also have 2130s but don't understand the explanation/fix. Help?

Thread 29 (2019-08-13):

SKR PRO v1.1 w/TMC2130 = no stall guard

chasinreno, 2019-08-13:

chasinreno, 2019-08-13:
I have my corexy printer xyz moving in the correct directions and have setup the board for TMC2130 SPI according to the manual.  I also have Marlin 2.0-bugfix setup for sensor less  homing but stall guard doesn't work.
Has anyone gotten this work?  Am I missing a library?
configuration.h & configuration_adv.h attached.

[Configuration.zip](https://github.com/bigtreetech/BIGTREETECH-SKR-PRO-V1.1/files/3498786/Configuration.zip)

Potociny444, 2019-08-14:
Try increasing the sensitivity by reducing the STALL_SENSITIVITY value. In my setup is working value '1'

Evovita, 2020-01-18:
Experiencing same issue as @chasinreno. I also tried setting the STALL_SENSITIVITY value to 1 without success. Running Marlin 2.0.1, with TMC2130 V3.0 SPI drivers on SKR Pro V1.1 board.

oldman4U, 2020-06-08:
Hello chasinreno.

Seems this ticket has not been used for a while, so please close it.

Thank you

chasinreno, 2020-06-09:
Thanks for the help. I eventually went back to sensors.  I got it working at a sensitivity setting of 6 but without notice it just quit working again.

oldman4U, 2020-06-09:
Hi.

Maybe it would be worth to give it a try using a newer version of Marlin. I mean it is almost a year ago and Marlin has changed a lot since then.

But the most important thing is that you can use your printer and that you enjoy your hobby.

Thank you for closing the ticket

;-)

Closed 2020-06-09.

Thread 31 (2019-08-15):

3D Touch stows, when homing

christianger, 2019-08-15:
Hello guys,

i connected my 3DTouch to my SKR PRO as shown in the manual.
I have also connected a Z-endstop.

When i go into the config menu and deploy the 3DTouch manually it deploys normally and M119 says the probe is not triggered.
Manually stowing work also as i expect it and M119 returns triggered the whole time. I think this is also not correct. It should send triggered just as a short pulse.

But when i press homing, the printer homes XY first and then stows the 3DTouch and moves the Z-axis downwards.
I tried everything, but i cant get the 3DTouch to deploy while homing.

christianger, 2019-08-15:
M43 S
Servo probe test
. using index:  0, deploy angle: 10, stow angle:   90
. Probe Z_MIN_PROBE_PIN: 11
. Z_MIN_PROBE_ENDSTOP_INVERTING: false
. Check for BLTOUCH
= BLTouch Classic 1.2, 1.3, Smart 1.0, 2.0, 2.2, 3.0, 3.1 detected.
** Please trigger probe within 30 sec **
. Pulse width (+/- 4ms): 4
FAIL: Noise detected - please re-run test
ok

budi67, 2019-08-16:
Hello

How do you active M43 ?
I have try to active #define PINS_DEBUGGING, but i have this error !!
Thanks

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

golfromeo-fr, 2019-08-16:
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

try to use MarlinFirmware/Marlin instead
at least the PINS_DEBUGGING option compiles

budi67, 2019-08-16:
I have already try to compile with the Marlin Firmware but i always have error with TMC26x

golfromeo-fr, 2019-08-16:
>
>
> I have already try to compile with the Marlin Firmware but i always have error with TMC26x
uninstall platformio and close vscode.
save your files Marlin\Configuration.h Marlin\Configuration_adv.h
remove c:\Users\YourName\.vscode and c:\Users\YourName\.platformio folders
restart with a fresh copy of Marlin with a clean platformio.ini
open vscode and install platformio
put in platformio.ini the line
"default_envs  = BIGTREE_SKR_PRO"

budi67, 2019-08-16:
Thanks golfromero-fr
Soryy for this question but how do i close vscode ?

golfromeo-fr, 2019-08-16:
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

I mean : closing the application
File > Exit

budi67, 2019-08-16:
I have download a new Marlin/firmware and it compile fine (i don't know while)
My bfptouch work fine, G29 too

But as the SKR Pro as no Eeprom, where to save the Mesh ?

Servo probe test
. using index:  0, deploy angle: 200, stow angle:   70
. Probe Z_MIN_PIN: 106
. Z_MIN_ENDSTOP_INVERTING: false
. Deploy & stow 4 times
= Mechanical Switch detected
  DEPLOYED state: LOW (logic 0)  STOWED (triggered) state: HIGH (logic 1)

budi67, 2019-08-16:
My G29

      0      1      2      3      4      5      6
 0 +0.449 +0.033 -0.341 -0.583 -0.652 -0.643 -0.602
 1 +0.488 +0.157 -0.123 -0.294 -0.368 -0.371 -0.372
 2 +0.509 +0.227 +0.002 -0.155 -0.225 -0.240 -0.241
 3 +0.547 +0.328 +0.173 +0.027 -0.044 -0.100 -0.169
 4 +0.549 +0.369 +0.244 +0.101 +0.021 -0.042 -0.097
 5 +0.557 +0.419 +0.312 +0.182 +0.107 +0.020 -0.090
 6 +0.482 +0.353 +0.246 +0.131 +0.062 -0.029 -0.120

golfromeo-fr, 2019-08-16:
@christianger
issue solved on my side: the connector on the bltouch (clone) was half disconnected, the signal was connected but no longer connected the z- pin

budi67, 2019-08-16:
@christianger
yes whith your help and another I’m almost at the end

basilfx, 2019-08-30:
@christianger I have the same issue, and this is what they told me on the Marlin support channel (Discord):

"You're trying to do conflicting things. If you're homing with the BLTouch you want Z_MIN_PROBE_USES_Z_MIN_ENDSTOP_PIN to be set and you want to connect the BLTouch to the z-min pin. If you're homing with Stallguard (Z_MIN_PIN) you don't want the BLTouch deploying when homing Z - only when using it to create a leveling mesh."

So, it's not used during homing.

christianger, 2019-08-31:
i thought it would make no difference, whether i use the Z-Min Pin with Z_MIN_PROBE_USES_Z_MIN_ENDSTOP_PIN option
or the PG8-Pin.

But using the Z-Min Pins solved my problem.

Closed 2019-08-31.

Thread 32 (2019-08-16):

Skr Pro v1.1 from GitHub not working

Formation3D, 2019-08-16:
Hello, I am having some issues trying to get the bigtreetech SKR Pro V 1.1 master firmware from GitHub 2 work properly on Visual Studio code. I'm not sure why I'm having such a major issue with this. I have deleted all files and reinstalled all the programs a couple of times. I have looked at different stuff on the forms to try to figure it out and I'm having issues still. For whatever reason I get different errors at different times and my summary ends up being the big tree SKR pro has failed in the environment. Attached are the photos from the terminal and the problems that arise when I try to build Marlin. I'm in need of assistance if anybody has time that they would be able to help me out with the situation.
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

Evg33, 2019-08-16:
https://github.com/MarlinFirmware/Marlin/commits/bugfix-2.0.x

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

Potociny444, 2019-08-16:
Try run VSCode as administrator

Evg33, 2019-08-16:
Use short path to sources.
Move source to c:\Marl\ as example.

golfromeo-fr, 2019-08-16:
you can try this
https://github.com/bigtreetech/BIGTREETECH-SKR-PRO-V1.1/issues/31#issuecomment-521911559

NickMilton, 2019-08-17:
I used the Marlin supplied Marlin 2.0, (not the BBT supplied one).

Of course I had to set up the configuration files myself but it all part of the learnign expereince.

[Configs.zip](https://github.com/bigtreetech/BIGTREETECH-SKR-PRO-V1.1/files/3511466/Configs.zip)

Works fine

Formation3D, 2019-08-17:
Ok, so I have done everything so far that was given to me as advice. Python and Git are both working properly. This is where I am at. I am only working with Marlin 2.0 bug fix. I was trying to use the Marlin by GitHub but was getting to many errors with it. I figure I could build in Marlin everything I need. So, I tried to set Marlin up for my board, the SKR Pro v1.1... once I configured the basics I hit build. I get a couple of errors. The main one is the environment, its saying that BIGTREE_SKR_PRO is a bad env, and that I am to use LPC1768. Now, the funny thing is when I changed the env to the LPC1768 it built the program and it was successful. But this is not my board, and I am confused as to why changing one thing like that it will complete. In closed is some photos of the completed build and the failed build with my board in.
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

NickMilton, 2019-08-17:
The  LPC1768 is for another board/chipset. You must define
#define MOTHERBOARD BOARD_BIGTREE_SKR_PRO_V1_1

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

Formation3D, 2019-08-17:
NickMilton, funny you say that, because in both configurations MOTHERBOARD BOARD_BIGTREE_SKR_PRO_V1_1 is defined as my board in cofiguration.h. All I did was change the environment. That's why I said I dont understand why changing the environment to LCP1768 it works and if I have the env set to BIGTREE_SKR_PRO it dont work.

NickMilton, 2019-08-18:
Ahh...
I defined environment as
default_envs = BIGTREE_SKR_PRO

Noting that platformio.ini has...
#
# BIGTREE_SKR_PRO (STM32F407ZGT6 ARM Cortex-M4)
#
[env:BIGTREE_SKR_PRO]
platform = ststm32@5.4.3
framework = arduino
board = BigTree_SKR_Pro
extra_scripts = pre:buildroot/share/PlatformIO/scripts/generic_create_variant.py
build_flags = ${common.build_flags}
  -DUSBCON -DUSBD_USE_CDC -DUSBD_VID=0x0483 -DUSB_PRODUCT=\"STM32F407ZG\"
  -DTARGET_STM32F4 -DSTM32F407_5ZX -DVECT_TAB_OFFSET=0x8000 -DHAVE_HWSERIAL6
lib_deps = ${common.lib_deps}
lib_ignore = Adafruit NeoPixel, c1921b4, TMC26XStepper, SailfishLCD, SailfishRGB_LED, SlowSoftI2CMaster
src_filter = ${common.default_src_filter} +<src/HAL/HAL_STM32>
monitor_speed = 250000

Formation3D, 2019-08-18:
Got it, thanks for all your help. Now to try an configure the rest in Marlin 2.0

Closed 2019-08-18.

Thread 33 (2019-08-17):

ESP-01S WIFI Module ESP8266 For SKR PRO - No setup guides or documentation?

NickMilton, 2019-08-17:
Problem - lack of documentation so cannot use the WSP-01S WiFi module. The SKR PRO itself is a great board and working properly with Marlin 2.0.

Testing to date - Successfully installed the ESP-01S onto the SKR PRO and loaded the BBT supplied esp3d.bin via the microSD card. I also set up Configuraiton.h for the SKR PRO with
#define SERIAL_PORT_2 6 // (1 for BIQU TFT or 6 for WiFi adapter?)

Problem - The WiFi module blue LED comes on but that's it - what do we do next? How do we access the WiFi and how do we use it!

PS I  am aware of:
https://github.com/luc-github/ESP3D
and
https://github.com/luc-github/ESP3D-WEBUI

but have not gone down that track yet!
kind regards

NickMilton, 2019-08-21:
Bigtreetech - can you please give us some guidance or recommendaitons on this? Loaded with the BTT supplied binary, the WSP-01S does not appear as an access point so there in nothing to wirelessly connect to....

Appreciated

NickMilton, 2019-08-23:
I slogged through this problem over several nights. Now I have an SKR Pro serving webpages to my local network. Way better than a notebook PC and USB cable...

MASSIVE THUMBS UP AND GREAT THANKS to Chris Riley - without who I would have given up!

https://www.youtube.com/watch?v=pJGBRriNc9I

Attached are some notes I made - in part from following Chris' video and in part from the https://github.com/luc-github/ESP3D/wiki/Install-Instructions

Go welll

[Nick guide R000.pdf](https://github.com/bigtreetech/BIGTREETECH-SKR-PRO-V1.1/files/3534588/Nick.guide.R000.pdf)

rlvanhuis, 2019-09-14:
https://github.com/NickMilton
Many thanks for the guide.  After installing and connecting over WiFi, it appears I am only able to get about 1 command per minute to the printer.  I have verified the com rate at 115200 for both the ESP and the main board.  Have I missed anything?

NickMilton, 2019-09-14:
Hmmm

Some commands of course need to complete (eg G29 - a 25point bed level process) before the printer willl act on a subsequent command (eg change hot end temperature). It could be something else too...

I have 2 printers with the BIQU SQK Pro v1.1board. One of them had similar 'slow' WiFi problems - which seemed to 'go away' after plugging the WiFi module in and out a few times. May have been poor electrical contact??? Never found cause.

rlvanhuis, 2019-09-15:
I will try.  I have all but given up on getting the ESP to work on this
board.  Pretty certain I am enhancing the definition of insane.

Thanks for the feedback.

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

NickMilton, 2019-09-15:
Hmmm.....

Maybe try reloading the ESP firmware and file system. Maybe try a different
ESP module in case yours is faulty.

In general I would also check how clean your power supply is. Ripple can do
weird thinks. Run off a battery to test ripple free power.

Just a thought

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

Snakefreak, 2019-10-08:
With esp3d loaded on the esp-01 only red light.   after plugging in.  We have to set enable pin high or something else?

NickMilton, 2019-10-08:
Don't really have enough information from your description of the problem to help...

Snakefreak, 2019-10-09:
Hello Nick my esp01 modul is prepared runs fine on usb serial converter.       when i plug the modul in the 8pin heade,r only the red led lights up.  the ch_pd (enable) pin is not on a high level. (should be high for opperation)  its PG1/FSMC_A11 on the stm32

Snakefreak, 2019-10-13:
Found the error my module is a esp-01   not a esp-01s  so i have to manual pull the pin high trough a 12k resistor  or  make the boot up trough marlin aviable.

jbaribeault, 2019-10-16:
What's the bootup option through marlin look like?

Snakefreak, 2019-10-16:
PIN pg1 high  think someone can code it in the skr pro 1.1 PIN Definition.   Should be compatible with both esp01 and esp01s .

kamahat, 2019-12-02:
I had an issue with esptoll 2.6.2 , I was not able to push it via de Ardunio IDE.
So i've done it manually from the directory where the esptool.py is installed.
Using the infromation from the error windows in the IDE (port, flash start, pathc to bin file)
`cd ~/.arduino15/packages/esp8266/hardware/esp8266/2.6.2/tools/esptool
python ./esptool.py --before default_reset --after hard_reset --port /dev/ttyUSB0 write_flash 0xBB000 /tmp/arduino_build_373729/esp3d.spiffs.bin
`

xkongox, 2020-04-29:
Hi, I have SKR 1.4 mainboard with Marlin 2.0.5 + BT touch and REPRAP_DISCOUNT_FULL_GRAPHIC_SMART_CONTROLLER
I followed instructions with changing options in HardwareSerial.h.
I have tried install ESP-01S. It works in programator I can login via WIFI. But when install to the board, sth goes wrong. Sympthoms.

1. Normally during booting LCD buzzer is loud and annoying. With WIFI it is rather silent, so I suspect it is some power problem or short circuit.
2 .Menu is jumping from Info screen to main screen. I hear clicking and it is loop. I can't stop it.
3. ESP-01S within 10-15 seconds is extremely hot.
When I remove module, all works fine. When I change HardwareSerial definition to default, the problem is still excists.

Maybe somone can say what is relation between LCD and WIFI on SKR 1.4? I work on 12V power.

mattster98, 2020-06-09:
> PIN pg1 high think someone can code it in the skr pro 1.1 PIN Definition. Should be compatible with both esp01 and esp01s .

Looks like the fix is making into the base Marlin repo.  Going to try and merge it into this one and see if it works. :)

https://github.com/MarlinFirmware/Marlin/pull/17679

rudranshsinghmahra, 2024-10-12:
> Found the error my module is a esp-01 not a esp-01s so i have to manual pull the pin high trough a 12k resistor or make the boot up trough marlin aviable.

I have the same issue I have SKR 1.4 board and ESP01 wifi module, module turn on but no wifi light. Between which two pins I have to solder the 12K resistor? If you could share the image it would be great

Snakefreak, 2024-10-12:
> > Found the error my module is a esp-01 not a esp-01s so i have to manual pull the pin high trough a 12k resistor or make the boot up trough marlin aviable.
>
> I have the same issue I have SKR 1.4 board and ESP01 wifi module, module turn on but no wifi light. Between which two pins I have to solder the 12K resistor? If you could share the image it would be great

PG01 from mcu goes to  WiFi en in esp01 Modul (pin3). So solder IT from Pin 3 to vcc 3.3v pin 7 in esp01 Modul

rudranshsinghmahra, 2024-10-12:
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

Thanks for your reply. I am too weak at electronics. I am sharing the image of the connection I could understand from your reply. Please let me know if it is correct.

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

Snakefreak, 2024-10-12:
Yes itstge right place

rudranshsinghmahra, 2024-10-12:
> Yes itstge right place

Thanks, will let you know if it works or not.

rudranshsinghmahra, 2024-10-14:
> Yes itstge right place

Thanks, It's working perfectly. I need a little help from you on my other issue.
The issue I am facing while using the SKR 1.4 board is that when I connect an **optical end-stop** to the X, Y, or Z end-stop port it does not trigger. The red LED on the optical end-stop remains constantly illuminated and the end-stop itself is not functioning as expected it never triggers and always shows open while using M119 command in pronterface.

I have tested the same setup with a **microswitch end-stop, and it works without any issues**. I have double-checked the wiring for the optical end-stop, and everything seems to be correct. I am using this optical endstop.
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

Could you please provide guidance on how to troubleshoot this issue or suggest any steps to resolve it?

Closed 2019-08-31.

Thread 34 (2019-08-18):

Z Homeing not working

bmarl, 2019-08-18:
This happens with both the original Marlin 2.0 branch as well as this.
On sending G28 X1, X2 and Y  home fine, Z moves up, then down and triggers the endstop and just stops. Only after a reset Z move again and only on homing or if i set the Z position to something negative.
After exchanging Y/Z motor and endstop for a test i can rule out electrical problems.

bmarl, 2019-08-19:
Just for clarification, i don't have BLTouch or similar activated.

bmarl, 2019-08-19:
The issue seems to be the board itself. The same Marlin version works fine on the printer with the SKR 1.3

oldman4U, 2020-06-08:
Hi bmarl.

Do we still need this ticket? If not, it would be great if you could close it.

Thank you

oldman4U, 2020-06-15:
@bigtreetech Could you please close this unneeded ticket. Thank you

Closed 2020-06-15.

Thread 35 (2019-08-19):

Printing from SD-Card

Haschtl, 2019-08-19:
As
> SDSUPPORT seems to work always with an external SDcard - never with the on-board.
>
> _Originally posted by @AnHardt in https://github.com/bigtreetech/BIGTREETECH-SKR-PRO-V1.1/issues/27#issuecomment-520928652_

How is it possible to print from SD-Card with the SKR Pro 1.1?
The internal SD-slot does not work (till now?)
I also have an SD-expansion board with SPI-communication, but i'm using the TMC5160, which only support SPI mode, and as the manual says:

> The SPI expansion port shares its I/O pins with the SPI pins of the stepper motor drivers. It can only be used if you are not using a stepper motor driver in SPI mode.

So in the end it is not possible to use an SD-card with the SKR-Pro?

AnHardt, 2019-08-19:
Please verify in the [schematics](https://github.com/bigtreetech/BIGTREETECH-SKR-PRO-V1.1/blob/master/Schematic/SKR-PRO-V1.1%EF%BC%88SCH%EF%BC%89.pdf).
External SD-card (on display panel) schould connect to EXP2-port.
This is not the same SPI-bus as on the dedicated SPI-connector.
The dedicated SPI-port has the same bus as the stepper sockets, but not the same as EXP2 socket.

omahena, 2019-08-20:
OK, great, so it is at least possible in HW. Any clues on how to configure and use either the SD card in the BTT TFT35 3.1 or the on board one? The pins file seems very lacking....

Evg33, 2019-08-21:
@omahena You can see pins on scheme
https://github.com/bigtreetech/BIGTREETECH-SKR-PRO-V1.1/blob/master/Schematic/SKR-PRO-V1.1%EF%BC%88SCH%EF%BC%89.pdf

  SD_DETECT   PB11
  SCK        PA5
  MISO         PA6
  MOSI         PB5
  SS               PA4

Haschtl, 2019-08-23:
Thanks!
This solved my issue.

omahena, 2019-08-23:
@Evg33 Thanks for the pinout and the SD_DETECT hint. Since I am not sure we have a clear understanding, what I was talking about is the Marlin **pins** file:
`Marlin\src\pins\stm32\pins_BIGTREE_SKR_PRO_V1.1.h`
file in particular.

Let's say I would like to enable Marlin to use the on board SD Card. How does one do that?

Since the `pins_BIGTREE_SKR_PRO_V1.1.h `file has just the very basics in there and if I look at `pins_BIGTREE_SKR_MINI_V1.1.h` for inspiration... The following block seems appropriate:

```
  #define SDCARD_CONNECTION ONBOARD
  #define ENABLE_SPI1
  #define SD_DETECT_PIN    PB11
  #define SCK_PIN          PA5
  #define MISO_PIN         PA6
  #define MOSI_PIN         PB5
  #define SS_PIN           PA4
```

The ENABLE_SPI1 is probably wrong or even without meaning. I see no mention of it in the Marlin source files or any other file in the entire Marlin repository. This brings doubts into how legit the pins_BIGTREE_SKR_MINI_V1.1.h file is as well... But being new to the Marlin scene, please correct me if I am wrong.

Next if we look at the SDCARD_CONNECTION usage... It is also just mentioned in mostly config and verification headers:
```
C:\Marlin>findstr /s "SDCARD_CONNECTION" *.h | find /v "examples" | find /v "src\pins"
config\default\Configuration_adv.h:  #if HAS_SDCARD_CONNECTION
config\default\Configuration_adv.h:    //#define SDCARD_CONNECTION LCD
Marlin\Configuration_adv.h:  #ifdef HAS_SDCARD_CONNECTION
Marlin\Configuration_adv.h:    #define SDCARD_CONNECTION ONBOARD
Marlin\Configuration_adv.h:  #endif // HAS_SDCARD_CONNECTION
Marlin\src\core\drivers.h:#define SD_CONNECTION_IS(V) (_SDCARD_ID(SDCARD_CONNECTION) == _SDCARD_ID(V))
Marlin\src\inc\Conditionals_LCD.h:#define HAS_SDCARD_CONNECTION EITHER(TARGET_LPC1768, ADAFRUIT_GRAND_CENTRAL_M4)
Marlin\src\inc\SanityCheck.h:  #error "LPC_SD_(LCD|ONBOARD|CUSTOM_CABLE) are now SDCARD_CONNECTION. Please update your Configuration_adv.h."
```

And no cpp files:
```
C:\Users\alesom\source\SKR Pro 1.1\firmware\Marlin>findstr /s "SDCARD_CONNECTION" *.cpp
```

Furthermore it looks like the condition for the HAS_SDCARD_CONNECTION is limited to LPC1768 and ADAFRUIT_GRAND_CENTRAL_M4:
```
#define HAS_SDCARD_CONNECTION EITHER(TARGET_LPC1768, ADAFRUIT_GRAND_CENTRAL_M4)
```
Hmm... But... There is a `Marlin\Marlin\src\sd\cardreader.cpp` file that gets compiled if `SDSUPPORT` is defined, which I enabled in my `configuration.h`.

Unfortunately the `CardReader::initsd()` function aborts with an error. After a few hours of log based instrumentation and carrying the SD card between my computer and the board... I can see the `sd2card.init(SPI_SPEED, SDSS)` fails to initialise the SPI connection to the SD card and returns an `SD_CARD_ERROR_CMD0`.

```
// Set pin modes
  extDigitalWrite(chipSelectPin_, HIGH);  // For some CPUs pinMode can write the wrong data so init desired data value first
  pinMode(chipSelectPin_, OUTPUT);        // Solution for #8746 by @benlye
  spiBegin();

  // Set SCK rate for initialization commands
  spiRate_ = SPI_SD_INIT_RATE;
  spiInit(spiRate_);

  // Must supply min of 74 clock cycles with CS high.
  for (uint8_t i = 0; i < 10; i++) spiSend(0xFF);

  // Initialization can cause the watchdog to timeout, so reinit it here
  #if ENABLED(USE_WATCHDOG)
    watchdog_reset();
  #endif

  // Command to go idle in SPI mode
  while ((status_ = cardCommand(CMD0, 0)) != R1_IDLE_STATE) {
    if (ELAPSED(millis(), init_timeout)) {
      error(SD_CARD_ERROR_CMD0);
      goto FAIL;
    }
  }
```

`SD init fail. CPU Pins: SS: P13 SCLK: P14 MISO: P15 MOSI: P46 Code: 0x01`

Any ideas?

@Haschtl How did you make it work?

Evg33, 2019-08-23:
Maybe try to change the speed in Configuration.h ?

```
/**
 * SD CARD: SPI SPEED
 *
 * Enable one of the following items for a slower SPI transfer speed.
 * This may be required to resolve "volume init" errors.
 */
//#define SPI_SPEED SPI_HALF_SPEED
//#define SPI_SPEED SPI_QUARTER_SPEED
//#define SPI_SPEED SPI_EIGHTH_SPEED

```

@Haschtl How did you make it work?

Haschtl, 2019-08-23:
I had an old SDCard expansion from my old RAMPS lying around, which i connected to the EXP2-port, as @AnHardt clearified.

I still would like to use the onboard sd-slot, but for now it's ok

omahena, 2019-08-24:
@Haschtl Ah, of course. The EXP2 port SD card alternative. I didn't think of that being too focused on the on-board SD card.

I also read what @AnHardt wrote. If I understand him correctly there are three HW SPI buses on the system. SPI1 is dedicated for motor control (as well as the SPI dedicated port on the board that is just exposing the motor control SPI bus for external wiring or alternative use if SPI is not used to control motors).

Then SPI2 is routed to the EXP2 port to allow connections for (an LCDs with) a SD card or just an external SD card like you are using.

And SPI3 seems to be dedicated to the on-board SD card... That fails to initialise. I have a feeling the SPI3 is in conflict with some CPU feature that was turned on first and that is preventing successful initialisation of the SPI3 bus.

omahena, 2019-08-24:
@AnHardt Considering what we learned in issue #36 ... I tried cleaning up the SPI section.

I think this is correct now:

```
//*** SPI ***

#ifdef HAL_SPI_MODULE_ENABLED
const PinMap PinMap_SPI_MOSI[] = {
  //{PA_7,  SPI1, STM_PIN_DATA(STM_MODE_AF_PP, GPIO_PULLUP, GPIO_AF5_SPI1)},
  {PB_5,  SPI1, STM_PIN_DATA(STM_MODE_AF_PP, GPIO_PULLUP, GPIO_AF5_SPI1)}, // TF_MOSI
  //{PB_5,  SPI3, STM_PIN_DATA(STM_MODE_AF_PP, GPIO_PULLUP, GPIO_AF6_SPI3)},
  {PB_15, SPI2, STM_PIN_DATA(STM_MODE_AF_PP, GPIO_PULLUP, GPIO_AF5_SPI2)},   // EXT2_MOSI
  //{PC_3,  SPI2, STM_PIN_DATA(STM_MODE_AF_PP, GPIO_PULLUP, GPIO_AF5_SPI2)},
  {PC_12, SPI3, STM_PIN_DATA(STM_MODE_AF_PP, GPIO_PULLUP, GPIO_AF6_SPI3)},   // MOTO_MOSI
  {NC,    NP,    0}
};
#endif

#ifdef HAL_SPI_MODULE_ENABLED
const PinMap PinMap_SPI_MISO[] = {
  {PA_6,  SPI1, STM_PIN_DATA(STM_MODE_AF_PP, GPIO_PULLUP, GPIO_AF5_SPI1)}, // TF_MISO
  //{PB_4,  SPI1, STM_PIN_DATA(STM_MODE_AF_PP, GPIO_PULLUP, GPIO_AF5_SPI1)},
  //{PB_4,  SPI3, STM_PIN_DATA(STM_MODE_AF_PP, GPIO_PULLUP, GPIO_AF6_SPI3)},
  {PB_14, SPI2, STM_PIN_DATA(STM_MODE_AF_PP, GPIO_PULLUP, GPIO_AF5_SPI2)}, // EXP2_MISO
  //{PC_2,  SPI2, STM_PIN_DATA(STM_MODE_AF_PP, GPIO_PULLUP, GPIO_AF5_SPI2)},
  {PC_11, SPI3, STM_PIN_DATA(STM_MODE_AF_PP, GPIO_PULLUP, GPIO_AF6_SPI3)}, // MOTO_MISO
  {NC,    NP,    0}
};
#endif

#ifdef HAL_SPI_MODULE_ENABLED
const PinMap PinMap_SPI_SCLK[] = {
  {PA_5,  SPI1, STM_PIN_DATA(STM_MODE_AF_PP, GPIO_PULLUP, GPIO_AF5_SPI1)},  // TF_SCLK
  //{PB_3,  SPI1, STM_PIN_DATA(STM_MODE_AF_PP, GPIO_PULLUP, GPIO_AF5_SPI1)},
  //{PB_3,  SPI3, STM_PIN_DATA(STM_MODE_AF_PP, GPIO_PULLUP, GPIO_AF6_SPI3)},
  //{PB_10, SPI2, STM_PIN_DATA(STM_MODE_AF_PP, GPIO_PULLUP, GPIO_AF5_SPI2)},
  {PB_13, SPI2, STM_PIN_DATA(STM_MODE_AF_PP, GPIO_PULLUP, GPIO_AF5_SPI2)},  // EXP2_SCLK
  {PC_10, SPI3, STM_PIN_DATA(STM_MODE_AF_PP, GPIO_PULLUP, GPIO_AF6_SPI3)},  // MOTO_SCLK
  {NC,    NP,    0}
};
#endif

#ifdef HAL_SPI_MODULE_ENABLED
const PinMap PinMap_SPI_SSEL[] = {
  {PA_4,  SPI1, STM_PIN_DATA(STM_MODE_AF_PP, GPIO_PULLUP, GPIO_AF5_SPI1)},   // TF_SS?
  //{PA_4,  SPI3, STM_PIN_DATA(STM_MODE_AF_PP, GPIO_PULLUP, GPIO_AF6_SPI3)},
  //{PA_15, SPI1, STM_PIN_DATA(STM_MODE_AF_PP, GPIO_PULLUP, GPIO_AF5_SPI1)},
  {PA_15, SPI3, STM_PIN_DATA(STM_MODE_AF_PP, GPIO_PULLUP, GPIO_AF6_SPI3)},   // MOTO_SS
  //{PB_9,  SPI2, STM_PIN_DATA(STM_MODE_AF_PP, GPIO_PULLUP, GPIO_AF5_SPI2)},
  {PB_12, SPI2, STM_PIN_DATA(STM_MODE_AF_PP, GPIO_PULLUP, GPIO_AF5_SPI2)}, // EXP2_SS
  {NC,    NP,    0}
};
#endif
```

Unfortunately still no joy on the SD card SPI. It looks like SD card is actually on SPI1 and not SPI3 as I thought since I could only resolve the pins from the schematic in this way.

Everything else appears to still be working (at least motor control). Any more ideas?

@Evg33 I have tried half speed already but not any of the slower speeds. Will do that when I get the next timeslice.

omahena, 2019-09-11:
@Evg33 Tried Full, Half, Quarter and Eigth. No joy.

I realised I forgot a lot of the other pin conflicts outside the SPI section, so I cleaned those out as well.

Yesterday a completely new pin definition was pushed to this repository in the `variant.h`. Here are just a few of the changes:

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

The pin number changes include the pins for the SD card... So until they figure out the pinout of the CPU they are using I am no longer investing my time into this.

piotrekm7, 2019-10-11:
@omahena
Any progress with it ? I'm struglling too.

omahena, 2019-10-13:
@piotrekm7 Sorry, Piotr, I gave up on the issue. I finished cleaning up the `buildroot\share\PlatformIO\variants\BIGTREE_GENERIC_STM32F407_5X\PeripheralPins.c` and removed all overlapping pins and kept only the stuff that the SKR Pro 1.1 uses... And there was no improvement. Just a huge waste of time.

I also still have "entangled" HEAT0 and HEAT1 mosfets - both get driven by the HEAT0 logic. This also kind of puts a damper on my dual extruder plan.

I did just receive two SD card expansion boards and thought I'd give them a try some time this week.

So from my perspective, we should just give realistic feedback when rating BTT products and perhaps then BTT will listen to their customers and deliver what they promised.

jbaribeault, 2019-10-17:
Any luck with the external SD expansions? I'm trying to get one working on what amounts to SPI3 since I'm using UART for the steppers (2209) and not SPI, I've assigned:
```
// Custom SDCard on SPI3
#define SCK_PIN          PC10
#define MISO_PIN         PC11
#define MOSI_PIN         PC12
#define SS_PIN           PA15
```
But no joy....

AnHardt, 2019-10-17:
@jbaribeault
That's likely the same problem as when trying to redirect the SD to the on-board-slot. If the one is solved also the other.

piotrekm7, 2019-10-17:
I received this reply from customer service:
"Hello，friend.
Sorry, the onboard SD card printing function and the SD card printing function of the display cannot be in the same firmware. If you want to print on an onboard SD card, you will need to modify the firmware.We have no such revision manual yet, sorry."

I have to admit I'm disappointed of this purchase.

jbaribeault, 2019-10-17:
That implies that the onboard function can work....

skypuppy, 2019-10-21:
I tried to avoid all that development with no documentation headache by using octoprint and letting the RPi handle the files.

piotrekm7, 2019-10-21:
@skypuppy I decided for the same solution. I recommend.

jbaribeault, 2019-11-07:
So far that's my solution as well, but I'd love to be able to use an SDCARD - whether internal or external for long printjobs. The Serial tends to drop randomly sometimes ( I think I've got a loose/badly soldered  USB port on the board)

YaMoef, 2019-12-26:
Hello as I bought this board I'm also expirementing with it to get the onboard sd working. So the only thing I got working is that the lcd of my printer shows media insterted when I put my sd in and media removed when I remove the sd card. What I did is put the SD_DETECT_PIN to PB11 and comment the SD_DETECT_INVERTED. But I'm think at this point maybe the pins are not properly configured in the files of marlin since I saw many people use other pins like I did and I lookt into the schematic. What I've got is:
SPI1 (onboard TF)

	MOSI	PB5
	SS	PA4
	MISO	PA6
	CLK	PA5

	TF_SW	PB11

SPI2 (external connector)

	MOSI	PB15
	SS	PB12
	MISO	PB14
	CLK	PB13

	EXP2_SW	PF12

SPI3 (TMC SPI)

	MOSI	PC12
	SS	-> CS	PA15
	MISO	PC11
	CLK	PC10

Can anyone confirm is this is correct? Also is it possible right now to use an external sd slot? because if you maybe change the spi pins from the external sd to the onboard sd you maybe could get it working. Also I found in the marlin folder some files which look very interesting to me: I've found some spi pins in Marlin/src/HAL but I'm not sure which on the SKR Pro uses. Is it also maybe possible to define the spi pins in the pins file in some way like @omahena did? I think this could also make it a bit easier.

YaMoef, 2019-12-26:
Also I forgot to mention:
-I use the Marling bugfix 2.0
-when I instert the SD card it still shows no media
-I put the SD connection to onboard

Evg33, 2019-12-27:
https://github.com/MarlinFirmware/Marlin/pull/16260

YaMoef, 2019-12-27:
Thank you this solves a lot! I didn't think about that it would be this hard to fix the problem.

Closed 2019-08-23.

Thread 36 (2019-08-20):

M42 I P30 S1

tna11, 2019-08-20:
By entering M42 I P30 S1, both Heater2 and Fan0 come on, M42 I P30 S0 switches both off. Only Fan0 should come on.

Entering M42 I P19 S1, Heater 2 only flashes on and off.

Any idea what causes this? All the other heaters and fans are OK using the M42 command

omahena, 2019-08-21:
Hmm... On my SKR Pro 1.1 the
`M42 I P30 S1`
will only turn on the FAN0 (Part cooling fan in my case) to the minimal PWM level - the fan actually stands still as there is not enough power to turn it. Setting it to 255 will turn it on full blast:
`M42 I P30 S255`

I have also verified that no other fans or heaters come on. And LED indicators turn on as expected for all pins:
```
P19	HEAT2
P20	HEAT0
P30	FAN0
P71	HEAT1
P54	FAN1
P55	FAN2
```
So if what you describe happens on your board it is definitely not normal behaviour. I don't think it is firmware related since I believe that pin functions can only be defined in software in terms of what they do... And it is not possible to configure pins to bind two of them together. But... Since you are using firmware that is interpreting gcode... it is in theory possible that the firmware will not allow you to turn on the fan without the heater. Although assuming you are running an extruder on Heater2 then one would expect the Fan2 to come on and also that this would only happen when you turn on Heater2 GPIO pin P19.

Sigh... Actually... Just as I have written all that, I did a board reset and I was retesting the P30 pin it started to behave the way you describe. And now it works correctly again after a second restart and some more gcode...

OK.. I may have discovered a pattern. After a fresh reset the
```
M42 I P30 S1
M42 I P30 S255
M42 I P30 S0
```
works as expected. Then if you do a `M42 I P19 S1` by accident... P19 gets "bound" to P30. So when you are controlling the P30 it will also turn on the Heater2 and provide 12V on the heater pins. It looks like we won't be able to use that third extruder after all... Then again we are also out of fan connectors for cooling it. :P

Looking at the Marlin code:
```
void GcodeSuite::M42() {
  if (!parser.seenval('S')) return;
  const byte pin_status = parser.value_byte();

  const int pin_index = PARSED_PIN_INDEX('P', GET_PIN_MAP_INDEX(LED_PIN));
  if (pin_index < 0) return;

  const pin_t pin = GET_PIN_MAP_PIN(pin_index);

  if (!parser.boolval('I') && pin_is_protected(pin)) return protected_pin_err();

  pinMode(pin, OUTPUT);
  extDigitalWrite(pin, pin_status);
  analogWrite(pin, pin_status);

  #if FAN_COUNT > 0
    switch (pin) {
      #if HAS_FAN0
        case FAN0_PIN: thermalManager.fan_speed[0] = pin_status; break;
      #endif
      #if HAS_FAN1
        case FAN1_PIN: thermalManager.fan_speed[1] = pin_status; break;
      #endif
      #if HAS_FAN2
        case FAN2_PIN: thermalManager.fan_speed[2] = pin_status; break;
      #endif
    }
  #endif
}
```
I can see that you are bypassing the pin protection with the undocumented I(gnore) parameter? We can also see that thermalManager is concerned about the fan speed. So thermalManager is likely binding the fan with the heater trying to protect you from burning down your house in a clumsy and incorrect way...

Controlling the cooling in an incorrect way might be risky and `M42 I` is looking... fishy. M106 might offer a more mainstream approach that Marlin handles in a better way?

That is as deep as I went. I can't tell precisely why that heater 2 behaves the way it does. Perhaps someone with more experience with Marlin and STM32 platform can answer this question better.

tna11, 2019-08-22:
Hello, thanks for taking a look at this.

Will look into it more, but must be a bug somewhere. I changed the #define HEATER_2_PIN to another pin, so in theory marlin isn't controlling P19(PB0) but the same thing is happening.

I'm not using the board on a 3d printer, so no worries about overheating and causing a fire

omahena, 2019-08-22:
My pleasure. I am happy to hear you are not using the board with a 3d printer and are taking proper safety precautions.

Cool idea, to feed a different pin to Marlin's thermalManager. What is interesting is that the HEATER_2_PIN doesn't seem to be mentioned much in the source files anywhere. It is initialised in Temperature::init. Other than that it is not referenced much and mostly in the context of BARICUDA.

I am sure I missed something because HEATER_0_PIN is also hardly mentioned outside the #define scope and heating obviously works on 3D printers. 😋 It would require a lot more time to figure this stuff out. And not having a debugger is also not helping.

Best of luck. I hope you figure it out.

tna11, 2019-08-23:
Think I've sorted the problem, both pins were tied to timer 3 channel 3 output, commenting out line 192 in PeripheralPins.c ( pc_8 tim3) has got it to work. PC_8 is then using timer 8 channel 3

AnHardt, 2019-08-23:
Excellent hint!
Looks as if also in the SPI sections a bit of cleanup is needed .

omahena, 2019-08-24:
@tna11 Ha! Wow. Good catch. How did you find this conflict?

@AnHardt Could this be the problem with SPI3 and the SD card? You seem to have experience with the STM32 platform and configuration. Do the SPI arrays dedicate/configure (multi-purpose) pins to a specific purpose?

So for example:
```
const PinMap PinMap_SPI_SSEL[] = {
  {PA_4,  SPI1, STM_PIN_DATA(STM_MODE_AF_PP, GPIO_PULLUP, GPIO_AF5_SPI1)},
  {PA_4,  SPI3, STM_PIN_DATA(STM_MODE_AF_PP, GPIO_PULLUP, GPIO_AF6_SPI3)},
  {PA_15, SPI1, STM_PIN_DATA(STM_MODE_AF_PP, GPIO_PULLUP, GPIO_AF5_SPI1)},
  {PA_15, SPI3, STM_PIN_DATA(STM_MODE_AF_PP, GPIO_PULLUP, GPIO_AF6_SPI3)},
  {PB_9,  SPI2, STM_PIN_DATA(STM_MODE_AF_PP, GPIO_PULLUP, GPIO_AF5_SPI2)},
  {PB_12, SPI2, STM_PIN_DATA(STM_MODE_AF_PP, GPIO_PULLUP, GPIO_AF5_SPI2)},
  {NC,    NP,    0}
};
```
Says that PA4 can be either SPI1 or SPI3 SS pin? And defining both leaves it up to "chance" what you get in the end (probably first match)?

bmxorcist, 2020-01-27:
Can anyone tell me how to determine what pin number to enter for the letter/number pins on an STM32 based board (SKR Mini E3)?  Trying to activate the HEATBED(PC9), HE0(PC8), and Fan0(PA8) pins on an SKR Mini for a custom application. Entering "M42 PC9 Sxx" just echos "M42 P0 Sxx". Any other combination of numbers that I've tried doesn't work either. Looking in fastio.h led me to try "P29" for PC9... but no luck.

Closed 2019-09-02.

Thread 38 (2019-08-21):

Remote firmware update

omahena, 2019-08-21:
How can the firmware be updated remotely over the USB connection?

That is without having to remove the SD card, take it over to the computer, write the firmware on it and take it back to the board, plug it in and restart the board?

golfromeo-fr, 2019-08-25:
afaik, it is not planned for now. Later?

Evg33, 2019-09-18:
* M997 - Perform in-application firmware update
If you can put the file on the card, then you can use 997.

Evg33, 2019-09-18:
I also think you can connect the st-link to a anoter usb of raspberry/comp.

omahena, 2019-09-24:
I am sorry I wasn't clear in my initial issue report. I am talking about a remote firmware update that is possible to do for the average user. For the SKR Pro 1.1 it would likely require two steps.
1. Uploading the file to the SKR Pro 1.1
2. Flashing the firmware into the right spot in flash memory.

Step 1 is already the problem here. Marlin cannot in any way use the SD card so uploading the file is not possible.

I agree it would require just a reset after the file is placed on the SD card. Did you test if the M997 actually resets your board? Marlin documentation doesn't mention the M997 directly so that usually means it is a little H4x0r.
http://marlinfw.org/meta/gcode/

I do have an ST-Link in the mail and when it arrives I hope I will be able to remote flash a firmware image to the board. But I think we both agree that the manufacturer didn't envision the end users to flash new firmware using ST-Link.

So to be clear, I am sure there is a way to hack the image in remotely. We could for example try to connect the SD card SPI to a RasPi that pretends it's an SD card. That might work. And a reset could be done with a relay controlling the power delivery to the board that is also controlled from the RasPi.

It's just... The SKR Pro 1.1 is the highest priced board from BTT and the board is lacking basic functionality that was promised at the time of sale. A Creality Melzi board will let you use an SD card and offer prints protected from power failure as well as remote flashable firmware if you install a bootloader. One pays money for a high end upgrade expecting more... Not less.

Evg33, 2019-09-25:
M997 - https://github.com/bigtreetech/BIGTREETECH-SKR-PRO-V1.1/blob/master/firmware/Marlin-2.0.x-SKR-Pro/Marlin/src/gcode/gcode.h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
But this does not work with this board. I was wrong.

omahena, 2019-09-26:
I happened to see some changes in Marlin recently that were related to M997 and BTT. Got all excited and then realised that they were for the SKR v1.3. I guess the message is that real professionals don't need a board reset.

We could try for a "in soviet Russia" type joke: "With the SKR Pro board the operator doesn't reset the board, the board resets the operator." Meh.

I suppose the M997 wouldn't be too hard to implement. I am sure the functions are there in HAL.

darknode, 2019-09-28:
M997 has been [added](https://github.com/MarlinFirmware/Marlin/pull/15394), but still we need  USBComposit support to have a full solution :(
I've found [implementation](https://github.com/grafalex82/GPSLogger/tree/master/Libs/USB) for stm32f4 with stm32+cmsis, but I'm not sure how to apply it for Marlin.

sl1pkn07, 2019-09-28:
Hi

other solution (witch i use in my rearm) is install a Toshiba Flashair (SD+WiFi module), put the firmware in it via WebDAV and then reset the machine for update the firmware

robustini, 2019-12-22:
No solution?

Closed 2020-10-12.

Thread 39 (2019-08-24):

TMC5160 not moving

Haschtl, 2019-08-24:
I have an issue with my TMC5160.

The motors are not moving, if i command a movement or homing. They feed some current to the motors if i enable them with M17 (doesnt feel very strong), but they will not move.

I have configured Rsense to 0.075, microstepping to 256 and the current to 1700mA in configuration_adv.h

SENSORLESS_HOMING is not active, but SQUARE_WAVE_STEPPING and TMC_USE_SW_SPI is.

The is the TMC-debug output:
```
Send: M122
Recv: 		X	Y
Recv: Enabled		false	false
Recv: Set current	1000	1000
Recv: RMS current	990	990
Recv: MAX current	1396	1396
Recv: Run current	19/31	19/31
Recv: Hold current	9/31	9/31
Recv: Global scaler	133/256	133/256
Recv: CS actual	14/31	14/31
Recv: PWM scale	13	13
Recv: stealthChop	true	true
Recv: msteps		0	0
Recv: tstep		max	max
Recv: pwm
Recv: threshold	0	0
Recv: [mm/s]		-	-
Recv: OT prewarn	false	false
Recv: OT prewarn has
Recv: been triggered	false	false
Recv: off time	15	15
Recv: blank time	54	54
Recv: hysteresis
Recv: -end		12	12
Recv: -start		8	8
Recv: Stallguard thrs	0	0
Recv: DRVSTATUS	X	Y
Recv: stallguard
Recv: sg_result	0	0
Recv: fsactive
Recv: stst		*	*
Recv: olb
Recv: ola
Recv: s2gb
Recv: s2ga
Recv: otpw
Recv: ot
Recv: Driver registers:
Recv: 		X	0x80:0E:40:00
Recv: 		Y	0x80:0E:40:00
Recv:
Recv:
Recv: Testing X connection... OK
Recv: Testing Y connection... OK
Recv: ok
[...]
Send: M17
Recv: ok
[...]
Send: M122
Recv: 		X	Y
Recv: Enabled		true	true
Recv: Set current	1000	1000
Recv: RMS current	990	990
Recv: MAX current	1396	1396
Recv: Run current	19/31	19/31
Recv: Hold current	9/31	9/31
Recv: Global scaler	133/256	133/256
Recv: CS actual	13/31	13/31
Recv: PWM scale	15532281	15532281
Recv: stealthChop	true	true
Recv: msteps		0	0
Recv: tstep		max	max
Recv: pwm
Recv: threshold	0	0
Recv: [mm/s]		-	-
Recv: OT prewarn	false	false
Recv: OT prewarn has
Recv: been triggered	false	false
Recv: off time	15	15
Recv: blank time	54	54
Recv: hysteresis
Recv: -end		12	12
Recv: -start		8	8
Recv: Stallguard thrs	0	0
Recv: DRVSTATUS	X	Y
Recv: stallguard
Recv: sg_result	0	0
Recv: fsactive
Recv: stst		*	*
Recv: olb
Recv: ola
Recv: s2gb
Recv: s2ga
Recv: otpw
Recv: ot
Recv: Driver registers:
Recv: 		X	0x80:0D:40:00
Recv: 		Y	0x80:0D:40:00
Recv:
```

omahena, 2019-08-24:
@Haschtl I use TMC5160s. I want to say without issues, but it was hard to find the right current settings.

I did not use SQUARE_WAVE_STEPPING so no idea if that will influence it. 1700mA sounds like a lot of current (unless you have about 3.5A stepper motors).

SENSORLESS_HOMING doesn't work for me at all. Just moves the printer head a little in X and Y axis and then stops. If I repeat homing it will reach home position at which point the skipped steps grinding starts.

Which stepper driver modules are you using? BTT V1.1?

Tell us more about your stepper motors (current rating, etc).

Haschtl, 2019-08-24:
My stepper motors are rated at 2.4A. Stepper type: 17HM5424
They are fine, I used them before with DRV8266.
My SKR Board is running at 24V. Therefore i have `#define CHOPPER_TIMING CHOPPER_DEFAULT_24V`.

I did not desolder the stallguard pins, i have only disabled sensorless_homing and am using normal endstops, which are working with M119

My stepper driver modules are from Watterott. I am only using them on X and Y axis till now. The other drivers are DRV8266.
Did you try to increase the X_STALL_SENSITIVITY ? This could fix your sensorless homing issues.

omahena, 2019-08-25:
If you used the same steppers with DRV8266, this means that the connectors, wires and motors are likely working and connected properly.

You M122 output actually shows 1000mA configuration on both steppers and at this point more importantly that SPI communication is enabled and working.

I am currently using:
```
  #define HOLD_MULTIPLIER    0.5  // Scales down the holding current from run current
  #define INTERPOLATE       true  // Interpolate X/Y/Z_MICROSTEPS to 256

  #if AXIS_IS_TMC(X)
    #define X_CURRENT      400  // 760mA still very hot // (mA) RMS current. Multiply by 1.414 for peak current.
    #define X_MICROSTEPS   256  // 0..256
    #define X_RSENSE     0.075
  #endif

#if AXIS_IS_TMC(Y)
    #define Y_CURRENT      400
    #define Y_MICROSTEPS   256
    #define Y_RSENSE     0.075
  #endif

  #if AXIS_IS_TMC(Z)
    #define Z_CURRENT      400 // 800
    #define Z_MICROSTEPS   256 // 16
    #define Z_RSENSE     0.075
  #endif

  #if AXIS_IS_TMC(E0)
    #define E0_CURRENT     500 // With 500 slightly warm to touch //800 reasonable  // 900
    #define E0_MICROSTEPS  256
    #define E0_RSENSE    0.075
  #endif

  #define TMC_USE_SW_SPI

  #define STEALTHCHOP_XY
  #define STEALTHCHOP_Z
  #define STEALTHCHOP_E

  #define CHOPPER_TIMING CHOPPER_DEFAULT_12V
  #define MONITOR_DRIVER_STATUS

  #define HYBRID_THRESHOLD

  //#define SENSORLESS_HOMING // StallGuard capable drivers only

  //#define SQUARE_WAVE_STEPPING
  #define TMC_DEBUG
```

I find myself wondering if perhaps you need to have a Z axis enabled since... Marlin usually drives a 3D printer... Since it is easier to disconnect and test rather than vice versa, I tested X, Y mode for you.

It is definitely outside of normal operation. For me M122 displays:

```
Recv: Driver registers:
Recv: 		X	0x00:00:00:00	 Bad response!
Recv: 		Y	0x00:00:00:00	 Bad response!
Recv:
Recv:
Recv: Testing X connection... Error: All LOW
Recv: Testing Y connection... Error: All LOW
```
Despite that, motors work... A little. Kind of... Well - erratic. It might make an X move immediately and then wait for 15s before allowing an Y move.

I have just empirical evidence to support this... But would you humour me by connecting a Z and E motor as well. I tried X, Y, Z motors only and things also didn't work much better until I connected the E motor as well.

In my case, I had to have all four of them before things got normal again:
#define X_DRIVER_TYPE  TMC5160
#define Y_DRIVER_TYPE  TMC5160
#define Z_DRIVER_TYPE  TMC5160
#define E0_DRIVER_TYPE TMC5160

I find it interesting you got a successful SPI connection reported by M122 at all.

Haschtl, 2019-08-25:
I have now connected all other TMC5160, now no axis is working (before the Z-Axis with the DRV8266 worked fine)

I also decreased the current to 500mA and have the same configuration as you now... only CHOPPER_TIMING  is CHOPPER_DEFAULT_24V in my case.
I think I will need to test the drivers with some simple examples first.

Here is the M122 output

```
Send: M122
Recv: 		X	Y	Z	E
Recv: Enabled		false	false	false	false
Recv: Set current	500	500	500	500
Recv: RMS current	490	490	490	490
Recv: MAX current	691	691	691	691
Recv: Run current	9/31	9/31	9/31	9/31
Recv: Hold current	4/31	4/31	4/31	4/31
Recv: Global scaler	133/256	133/256	133/256	133/256
Recv: CS actual	31/31	4/31	4/31	4/31
Recv: PWM scale	4294967295	4	4	4
Recv: stealthChop	true	true	true	true
Recv: msteps		0	256	256	256
Recv: tstep		4294967295	max	max	max
Recv: pwm
Recv: threshold	0	396	2111	241
Recv: [mm/s]		-	100	3	30
Recv: OT prewarn	true	false	false	false
Recv: OT prewarn has
Recv: been triggered	false	false	false	false
Recv: off time	15	4	4	4
Recv: blank time	54	24	24	24
Recv: hysteresis
Recv: -end		12	2	2	2
Recv: -start		8	1	1	1
Recv: Stallguard thrs	0	0	0	0
Recv: DRVSTATUS	X	Y	Z	E
Recv: stallguard		*
Recv: sg_result	1023	0	0	0
Recv: fsactive		*
Recv: stst		*	*	*	*
Recv: olb		*
Recv: ola		*
Recv: s2gb		*
Recv: s2ga		*
Recv: otpw		*
Recv: ot		*
Recv: Driver registers:
Recv: 		X	0xFF:FF:FF:FF	 Bad response!
Recv: 		Y	0x80:04:40:00
Recv: 		Z	0x80:04:40:00
Recv: 		E	0x80:04:40:00
Recv:
Recv:
Recv: Testing X connection... Error: All HIGH
Recv: Testing Y connection... OK
Recv: Testing Z connection... OK
Recv: Testing E connection... OK
Recv: ok
```

omahena, 2019-08-25:
Thanks for trying what I suggested. I mean... it all looks right. Just no motion you say... Short of offering you my firmware build (or vice versa) as a  ultimate firmware test... I am not sure what to suggest.

We do use different modules though and although I think BTT made an exact copy of Watertott modules (and there was even an angry comment somewhere about atribution)... There could be a difference somewhere.

There... was some talk about certain stepper modules and having to add or remove a certain pin or add a connection... Which version of the Wattertott modules do you have?

https://learn.watterott.com/silentstepstick/pinconfig/tmc5160/

Haschtl, 2019-08-26:
I found the solution for my problem!

I have PSU_CONTROL active. I already figured out, that the SPI communication is dead, if the 24V supply is off. If I enable the PSU, the SPI communication seems correct (M122) but I think the drivers are not initialized correctly, if the power supply was off.
Here is an related issue: https://github.com/MarlinFirmware/Marlin/issues/15055
Btw: I'm using MarlinFirmware/Marlin and not this fork.

I also have a hardware button, which cuts the power for the motors (a safety switch). If i toggle it, the motors will not move.

Now that the motors are moving, I have another problem.
@omahena: You have configured your steppers to run with 256 microstepping.
I encountered some issues, when I had this configuration. The stm32 crashed and rebooted after a fast and long Z-movement. I think this is related to the high step/second rate in this movement. The Z-axis has the biggest step/mm configuration (2000 at 16 microstepping and 32000 at 256 microstepping). If the velocity is high, e.g. 30 mm/s, the steps/second will be 960000, so 960 kHz.
With this list  https://reprap.org/wiki/Step_rates, i think the maximum frequency will be around 96-120kHz. But this is still not enough. Could this cause the firmware crash?

This problem could be solved, if the marlin firmware was capable of using the TMC5160's "Motion Controller" via SPI. This would reduce the workload of the controller board a lot.

omahena, 2019-08-26:
I am glad you figured it out. PSU_CONTROL would mess with your drivers, yes. The issue with driver initialization seems a likely problem in retrospect. I am also now completely on Marlin and only use this fork to double check stuff if something isn't working correctly. Essentially, just to check if BTT had something working but then the future Marlin development broke it.

@Haschtl Thanks for the heads up on the 256 microstepping. So far I didn't have any issues wit it. I did read about interpolation issues on the older version of TMC drivers due to motion extrapolation.

You could be right on the high step rate but I do not know enough to comment on the subject with certainty. I think there are differences between modes of interfacing with the stepper driver. I think that if you use the old STEP/DIR interface the issue you describe is likely to occur since you need to provide one step pulse for any type of move. So I guess that if you want to do a full step with say 1/16 microstepping you need to provide 16 pulses. I thought that in SPI/UART mode things are different. You can probably send a packet to "do 16 microsteps" and the stepper driver IC does that for you. Things would get less convenient for SPI/UART driving when you would want to do non-linear precise motion using full precision. So I'd be surprised if motion controller of the TMC5160 is not already in use for SPI control.

Since I didn't have any issues until now... I didn't put too much thought into microstepping other than more sounds better. Already finding the optimal driving current took waaay too much of my time. :/ But maybe the issues are actually related.

Closed 2019-09-18.

Thread 41 (2019-08-25):

SKR PRO PWM Pins?

Rics3D, 2019-08-25:
Hi,

can someone tell me the PWM Pins for the Partcollingfan?
FAN0 and FAN1 is used for hotendcooling.
So i choose FAN2 for the Partcooling, but they just start working @80% and this is full blast...
Ist there a list with all PWM Pins?

Thank you

Haschtl, 2019-08-26:
You can have a Look AT the datasheet of the stm32
https://www.mouser.de/datasheet/2/389/stm32f405rg-956214.pdf

Rics3D, 2019-08-26:
Okay, but where are the pins located on the board?

Haschtl, 2019-08-27:
Have a Look here: https://github.com/bigtreetech/BIGTREETECH-SKR-PRO-V1.1/blob/master/manual/SKR-PRO-V1.1-Pin.pdf

dineshvyas, 2019-09-19:
pine_STM32F4.h
look at these lines.
#ifndef FAN_PIN
  #define FAN_PIN          PC6
#endif
#define FAN1_PIN           PC7
#define FAN2_PIN           PC8

defalkner, 2019-09-24:
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

This is a huge help. I know the hardware side but the software, programming and setting locations for the pins in the software I have no idea where the locations are.  The pine_STM32F4.h was the information I needed otherwise Id be hunting around the pins.h all day. Thanks!

Formation3D, 2019-09-24:
What I ended up doing was making the part cooling fan0 the part cooling fan, fan1 for the hotend fan and fan2 for 3 fans cooling the stepper drivers...type in fan in the search bar in configuration adv.h.... scroll to controller fan uncomment define use controller fan and uncomment define controller fan pin and put PE6 in its place, this is where you control the fan to cool stepper drivers.  Scroll down to define E0 auto fan pin and put PE5. You can set the temp you want for the extruder fan to come on at. Leave it at 255. Scroll down to define fanmux0 pin and type in PC8, this is your part cooling fan and can be controlled by you. If you go in Marlin to src, pins, stm32, pins bigtreetech skr pro v1.1 it will give you the pin numbers you need.

jkdesignz, 2019-09-27:
I think what he is saying is that the fan only comes on when it is set to 80%.
what you need to do is go into Configuration_Adv.h  and set the PWM
here  line 304 -305 or around that line,
#define FAN_MIN_PWM 0
#define FAN_MAX_PWM 255

also set the kick start, it is just above line 304
uncomment =  #define FAN_KICKSTART_TIME 1000
set to 1000

that should fix the problem. i know it fixed mine. now i can use it all the way down to 5%. but i have ball bearing fans. hope that helps

martins6413, 2019-10-06:
Hallo,
die CNC Lüfter Pins (SKR Pro V1.1) sind Frequenz gesteuert und sind in niedriger Drehzahl sehr laut und bleiben manchmal auch stehen.Das Slicerprogramm kann diesen Lüfter nicht ordentlich regeln und somit ist ein Druck mit PETG oder ABS fast nicht möglich.
Gibt es hierfür einen Lösungsvorschlag ?

martins6413, 2019-10-06:
Hi,
The PWM pins in the SKR Pro V1.1 are frequency controlled. The parts fan (24V) sometimes stops at low RPM and is very noisy. The slicer program also does not get the fan properly controlled and thus PETG or ABS printing is very difficult as the fan rotates either too fast or not at all.
Is there a solution for this ?

AnHardt, 2019-10-06:
```
// When first starting the main fan, run it at full speed for the
// given number of milliseconds.  This gets the fan spinning reliably
// before setting a PWM value. (Does not work with software PWM for fan on Sanguinololu)
//#define FAN_KICKSTART_TIME 100

/**
 * PWM Fan Scaling
 *
 * Define the min/max speeds for PWM fans (as set with M106).
 *
 * With these options the M106 0-255 value range is scaled to a subset
 * to ensure that the fan has enough power to spin, or to run lower
 * current fans with higher current. (e.g., 5V/12V fans with 12V/24V)
 * Value 0 always turns off the fan.
 *
 * Define one or both of these to override the default 0-255 range.
 */
//#define FAN_MIN_PWM 50
//#define FAN_MAX_PWM 128
```

martins6413, 2019-10-06:
Thanks for the tip, I've read over. Exchange the fan probably broken.

Lyr3x, 2019-12-19:
I am trying to find free PWM pins for RGBW Leds. All pins i tested (Checked the timer pins in the datasheet). However only `PC9`is working correctly. All other Pins are just fully on or off.

Any ideas here?

AnHardt, 2020-01-04:
If not using SPI stepper drivers on Y and Z the Y_CS (PB8 on TIM4_CH3 or TIM10_CH1) and Z_CS (PB9 on TIM4_CH4 or TIM11_CH1) could be usable and are relative accessible. That will need some additions in the PWM/Timer section of 'Marlin\buildroot\share\PlatformIO\variants\BIGTREE_SKR_PRO_1v1\PeripheralPins.c'

```diff
const PinMap PinMap_PWM[] = {
  {PB_1,  TIM3,   STM_PIN_DATA_EXT(STM_MODE_AF_PP, GPIO_PULLUP, GPIO_AF2_TIM3, 4, 0)}, // TIM3_CH4    HEATER0
+ //(PB_8, TIM4,  STM_PIN_DATA_EXT(STM_MODE_AF_PP, GPIO_PULLUP, GPIO_AF2_TIM4, 3, 0)}, // TIM4_CH3 already used for HEATER_1 id hardware PWMd
+ (PB_8, TIM10,  STM_PIN_DATA_EXT(STM_MODE_AF_PP, GPIO_PULLUP, GPIO_AF2_TIM10, 1, 0)},
+ //(PB_9, TIM4,  STM_PIN_DATA_EXT(STM_MODE_AF_PP, GPIO_PULLUP, GPIO_AF2_TIM4, 4, 0)}, // TIM4_CH4 chanel 4 is free but the timer is already in use for heaters. So the PWM-freqency is already fixed if one heater is on hardware PWM
+ (PB_9, TIM11,  STM_PIN_DATA_EXT(STM_MODE_AF_PP, GPIO_PULLUP, GPIO_AF2_TIM11, 1, 0)},
  {PD_14, TIM4,   STM_PIN_DATA_EXT(STM_MODE_AF_PP, GPIO_PULLUP, GPIO_AF2_TIM4, 3, 0)}, // TIM4_CH3    HEATER1
  {PB_0,  TIM3,   STM_PIN_DATA_EXT(STM_MODE_AF_PP, GPIO_PULLUP, GPIO_AF2_TIM3, 3, 0)}, // TIM3_CH3    HEATER2
  {PD_12, TIM4,   STM_PIN_DATA_EXT(STM_MODE_AF_PP, GPIO_PULLUP, GPIO_AF2_TIM4, 1, 0)}, // TIM4_CH1    BED
  {PC_8,  TIM8,   STM_PIN_DATA_EXT(STM_MODE_AF_PP, GPIO_PULLUP, GPIO_AF3_TIM8, 3, 0)}, // TIM8_CH3    FAN0
  {PE_5,  TIM9,   STM_PIN_DATA_EXT(STM_MODE_AF_PP, GPIO_PULLUP, GPIO_AF3_TIM9, 1, 0)}, // TIM9_CH1    FAN1
  {PE_6,  TIM9,   STM_PIN_DATA_EXT(STM_MODE_AF_PP, GPIO_PULLUP, GPIO_AF3_TIM9, 2, 0)}, // TIM9_CH2    FAN2
  {PC_9,  TIM8,   STM_PIN_DATA_EXT(STM_MODE_AF_PP, GPIO_PULLUP, GPIO_AF3_TIM8, 4, 0)}, // TIM8_CH4    EXTENSION1-4
```

AnHardt, 2020-01-04:
If you can swap the probe away from PA1 and PA2 (for exaple to any of the EXTENSION2 pins) you can use them following the same scheme.

```
PA1/TIM5_CH2/TIM2_CH2
PA2/TIM9_CH1/TIM2_CH3
```
Just check if the timers are used somewhere else.

AnHardt, 2020-01-04:
If someone of the Marlin developers is around:

Usually we use only one servo - for the probe.
How about a single servo library using hardware PWM on pin PA1 with timer 5 channel 2 for the BTT SKR PRO V1.1?
That would have exceptional low jitter and would not use more timers than the normal library.

AlexanderLL95, 2020-01-16:
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
Thanks for the tip. I was searching a couple of months for this solution to implement a RGB led strip!

Now my skr pro board has a bltouch and RGB led strip onboard with tmc2209. Pins PC9, PB8 and PB9 are user for the RGB led strip.

dineshvyas, 2020-02-22:
// These pins have been defined for something else on the board but they MIGHT be
  // used by the user as PWM pins if they aren't used for their primary purpose.
  {PC_6,  TIM3,   STM_PIN_DATA_EXT(STM_MODE_AF_PP, GPIO_PULLUP, GPIO_AF2_TIM3, 1, 0)}, // TIM3_CH1    ESP8266 connector. Available if 8266 isn't used
  {PC_7,  TIM3,   STM_PIN_DATA_EXT(STM_MODE_AF_PP, GPIO_PULLUP, GPIO_AF2_TIM3, 2, 0)}, // TIM3_CH2    ESP8266 connector. Available if 8266 isn't used
how about these pins?
I am not using ESP8266.

DroneMang, 2020-05-09:
I have an SKR PRO, and I am having the issue that the part cooling fan which I have set as below from pins (stock):

#define FAN_PIN                             PC8   // Fan0

will jump from a low speed to basically full blast when changing from S246 to S247.  As in there is not a gradual increase in fan speed.  Below S246 there is some adjustment to the speed that I can hear.  There may be some flight increase in speed from S247 to S255.

I am running TMC5160's with sensorless homing, I can reply with other enabled features if needed.

Thanks!
DroneMang

defalkner, 2020-05-09:
I believe PWM needs to be enabled

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

DroneMang, 2020-05-09:
Do you mean:

FAN_SOFT_PWM

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

defalkner, 2020-05-09:
Yes, I have the SKR pro 1.1  and this was a bit of a nightmare for me to
figure out but it can be corrected. This is from my marlin code

*configuration.h*
#define FAN_SOFT_PWM
#define SOFT_PWM_SCALE 0

configuration_adv.h
#define USE_CONTROLLER_FAN
#if ENABLED(USE_CONTROLLER_FAN)
  #define CONTROLLER_FAN_PIN PE6           // Set a custom pin for the
controller fan
  #define CONTROLLERFAN_SECS 30             // Duration in seconds for the
fan to run after all motors are disabled
  #define CONTROLLERFAN_SPEED 255           // 255 == full speed
  //#define CONTROLLERFAN_SPEED_Z_ONLY 127  // Reduce noise on machines
that keep Z enabled

#define FAN_MIN_PWM 0
#define FAN_MAX_PWM 255

i dont know if any of this will help, just adjust as needed

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

DroneMang, 2020-05-09:
Perfect!  I just set

#define CONTROLLER_FAN_PIN FAN2_PIN

but FAN2_PIN is PE6 in pins so same thing.

So do you still use M106 S255 down to 0 as usual?

aliman1, 2022-02-25:
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

how exactly do you modify the PeripheralPins.c file .

Thread 44 (2019-09-01):

Extension-1 ADC inputs not functioning

Paul47, 2019-09-01:
I'm using the SKR PRO v1.1/Marlin 2 bugfix, for a 4 extruder printer. For the 4th temp sensor I have tested the ADC pins on Ext-1: Pins PF7, PF8, PF10, PF9 (all identified as ADC capable) using a tested thermistor circuit design from RAMPS as input. Defining TEMP_3_PIN to any of these pins I get only zero temp reported.  (I've also tried re-defining TEMP_1,2, and 3).

The other 3 extruders and steppers are operating correctly. Other settings: extruders=4, Sensor types=5, single hotend disabled. I have used this same Marlin setup on my RE-ARM controller and can map 4 termistors successfully, but am running out of pins and power for motors and heaters.

omahena, 2019-09-11:
It is a bit of a long shot. But I have custom temp sensors running on PF5 and PF6. They are intended for hotend temp sensors so... I was only mildly surprised to see them working.

But if we look at the `buildroot\share\PlatformIO\variants\BIGTREE_GENERIC_STM32F407_5X\PeripheralPins.c` the PF_5  pin in only defined as part of the PinMap_ADC. On the other hand PF_6 is also defined as a member of PinMap_PWM so perhaps I was lucky to see values from PF_6.

But since PF_7 and PF_8 are defined as both members of PinMap_ADC as well as PinMap_PWM PinMaps... So... Maybe... Just maybe if you comment out lines 211 and 212, your temp sensors will start to work:

```
{PF_7,  TIM11,  STM_PIN_DATA_EXT(STM_MODE_AF_PP, GPIO_PULLUP, GPIO_AF3_TIM11, 1, 0)}, // TIM11_CH1
{PF_8,  TIM13,  STM_PIN_DATA_EXT(STM_MODE_AF_PP, GPIO_PULLUP, GPIO_AF9_TIM13, 1, 0)}, // TIM13_CH1
```

If you look at issue [36](https://github.com/bigtreetech/BIGTREETECH-SKR-PRO-V1.1/issues/36#issuecomment-524234963) there have been some similar type of problems with pins solved the same way.

@Paul47 I am really curious how your 4 extruder printer will work with this board. I would expect a lot of problems. Keep an eye on your HEATER1 and HEATER2 channels as they may turn on as a side effect of some other pin change. Have a look at this [video](https://www.youtube.com/watch?v=pVOuqxbJl3w) of how my board behaves with a single extruder. Definitely do not leave the board unattended and have a fire extinguisher handy.

Paul47, 2019-09-11:
Thanks @omahena I will test each of these recommendations. My SKR PRO is still breadboarded until I get all the electronics working. I use a stepper expander for the additional motor. I use external MOSFET boards on ALL my heaters to reduce current draw through the Controller. I found this also greatly speeds the heat up cycles. These are so cheap now days I recommend it to everyone. I have a smoke+fire detector in the room and a fire extinguisher at the door.

The 4 steppers and extruders work, but I've assigned temp sensor 4 to 3 for now. This could lead to problems as you mentioned. For Marlin 2.0 I modified the various override settings for the heater/sensor/stepper #defines  so I can change them in all configuration.h.  This way I can re-configure from 1 to 4 extruders and their pin assignments quickly for testing.

evandene, 2019-10-07:
Hi,
Question from a total dummy. I would like to use my PT100 amplifier board(s) with PT100 sensor(s) were the out put go's to 5V
Are the pins from extension 1 & 2 5V tolerant? Can I hooked-up the PT100 f.e. at PC4 and an other one at PC5?
I hooked-up PS_ON at PC9 and that worked perfect

AnHardt, 2019-10-07:
There are **NO** 5V tolerating ADC inputs on the ST processors.

evandene, 2019-10-07:
Thanks for the info

evandene, 2019-10-07:
I will use PF8 and PF10 as signal pin
I will use GND and 3.3V form the free limit switch connectors
Now i still need to find out the PID settings

Just for your info:
According the PIN schematics from Bigtree-tech. The I2C rail of the SKR PRO v1.1 should be powered by 3.3V but be careful, it is 4.95V. the same story for the UART rail.

Paul47, 2019-10-08:
After trying the suggestions from omahena on these ADC pins, I have still not been able to get them to function. evandene, if you have success, please report back with your configuration. I would like to find out if it's my board or in my Marlin setup.

evandene, 2019-10-08:
> After trying the suggestions from omahena on these ADC pins, I have still not been able to get them to function. evandene, if you have success, please report back with your configuration. I would like to find out if it's my board or in my Marlin setup.

It works,
T0 is responding on my E3D amplifier with PT100 sensor
I use PF8 from EXTENSION1 as signal pin
I use GND and 3.3V from a free limit switch connector
Do not forget to change pin settings in
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

evandene, 2019-10-08:
For more trustful measuring, I will buy me an Adafruit PT100 amplifier with 3.3V output signal
https://www.adafruit.com/product/3328
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

ktotomskru, 2019-10-25:
> For more trustful measuring, I will buy me an Adafruit PT100 amplifier with 3.3V output signal
> https://www.adafruit.com/product/3328
> 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

This one is supposed to be connected via SPI bus. I use it with SKR pro without any issues.

evandene, 2019-10-25:
Great, thanks.
I will implement this in my new design

Closed 2019-10-08.

Thread 46 (2019-09-02):

Pins still wrong? BIGTREE_GENERIC_STM32F407_5X /variant.h

carl1961, 2019-09-02:
#define PB4   45 //0:NJTRST  1:SPI3_MISO / TIM3_CH1 / SPI1_MISO
 #define PB5   **45** //1:TIM3_CH2 / SPI1_MOSI / SPI3_MOSI
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

omahena, 2019-09-11:
@carl1961 Awesome find. However the variant.h was updated yesterday... And if you compare the files it is pretty much a completely different pinout definition. I resorted the first part to match pin names and see differences in values.

I spent a lot of time trying to get the on-board SD card working. And PB5 is the TF_MOSI in the SPI3 pin set.

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

I can explain the error you found: coding error. It happens. To all of us. But the differences between original and current pin numbers are just deeply disturbing. For a moment I thought that the file is perhaps not used in the build... But it sure is. I now deeply regret having invested any time into this firmware.

The `pins_BIGTREE_SKR_PRO_V1.1.h` is still a wasteland devoid of all promised features like SD card support, printing protected from power failure, WiFi module, filament runout sensors...

The `buildroot\share\PlatformIO\variants\BIGTREE_GENERIC_STM32F407_5X\PeripheralPins.c` is still a complete mess of overlapping pin definitions that will lead to problems like the MOSFET for HEATER2 to turn on when you are controlling the FAN0. Imagine you actually had something connected to HEATER2. Firmware has no clue the heater is turned on, because it was never turned on by the thermal management code of Marlin.

Same thing goes for HEATER1 actually. [Here](https://www.youtube.com/watch?v=pVOuqxbJl3w&lc) you can see it blinking in unison with HEATER0.

(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)

I only have one hotend configured in Marlin... Yet power is directed to HEATER1.

Considering that any and all reports here are simply ignored. No response is ever offered. No acknowledgement of error or help with user error from BTT side.

It looks like the community will simply have to resort to the only language they understand - honest user reviews.

LinoBarreca, 2019-11-14:
I fixed them. go check now on official marlin

Thread 47 (2019-09-09):

Limit switch and TMC2209 driver

theWituch, 2019-09-09:
Hi,
I have SKR PRO board with TMC2209 v1.1 stepper drivers and when i connect driver into board, suitable limit switch seems stop working. Without driver in slot, led shows switch state (led is on when switch is opened, and off when closed). With driver in slot, nothing happened.

I checked schematics of board and TMC driver and i think TMCs GND pin is connected to limit switch ouput signal. This signal is connected to uC too, so pin is always pulled down and will never work.

Im right? Is any solution for this issue?

Meddleglitch, 2019-09-20:
Aha! I've been having this issue too, and I hadn't considered that my 2209s were the problem, but now that you mention it, I did happen to notice that the limit switch for my E2 driver (which doesn't exist / isn't installed) works fine, while the other five won't work even if I use an external pullup (oh jeez, I sure hope I didn't break anything! >_<)

..........wait.......... hang on a minute... Are WE the problem, here!?
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
Is THIS why they tell us to castrate our poor 2209 drivers? o_o
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

omahena, 2019-09-24:
Hmm. I have the TMC5160 drivers. I had to add the  stallGuard pin to actually be able to use the sensorless homing feature. However I only get into trouble when I use a stallGuard feature AND try to use the endstop switches as well. The endstops worked fine if I disabled sensorless homing even with the diag pin of the steppers connected to the board.

But... TMC2209 might be a little different and I suppose they wouldn't dedicate a part of the manual to tell you to cut that pin off.

Btw... You don't have to cut the pin. You can also just heat it up to melt the solder and push it through the board so it doesn't make contact with the socket below it. When you need it again... push it through again to the bottom side. Not sure how many cycles of this modification your connector pin can take though.

Personally I find the stallGuard based sensorless homing overrated. Or maybe it just doesn't work well on my system. With a lot of tuning of the sensitivity parameter I still get grinding. Especially for example when homing an already homed hotend. I only keep it enabled because it was so hard to enable it and it refused to work for weeks.

Meddleglitch, 2019-10-06:
Yeah, I don't think they can work together unless you can somehow assign two different pins to the same endstop, because it seems like the TMC drivers connect that pin to ground, and whichever way I set up my endstops before I realized what was going on (or rather, before I remembered what I had read about weeks in advance and then forgotten to actually *do* when the time came) I couldn't get the mechanical ones to trigger/un-trigger with that extra ground wired in, even with a jumper cap directly from 3.3V/GND to the sense pin. I saw the value rising and falling when I checked it with a voltmeter, but only by about 0.3V in either direction.

I suppose if you *really* wanted to use both at the same time (assuming that it's not currently possible to condigure a whole extra set of endstop pins and wire the mechanical ones to them instead), you could have the standard normally-closed endstop (+pullup) signal pass through a PNP mosfet before draining to ground (either side of the switch ought to be fine, I think) with the normally-grounded TMC StallGuard pin (clipped/pushed through/not connected to the board) controlling the gate, so that when either it goes high or the switch gets pushed, the circuit breaks just like it would with only one or the other.

(I doubt the few nanoseconds of rise (no wait: *fall*) time would significantly affect the StallGuard's accuracy, but then that's the whole reason for wanting the endstops to keep doing their jobs in the first place.)

I ca't say for certain whether that would actually work (the driver would certainly need to output enough voltage to deactivate the PNP mosfet, at least.), but to my somewhat-trained eye, it seems like that ought to isolate the two switches while keeping them on the same circuit, although I'm not entirely sure whether or not the StallGuard would mess with the repeatability of the mechanical endstops during a normal home operation... however, I do strongly suspect that the spring-action switches would trigger "long" before the motors would ever actually stall out. Like, entire *microseconds* beforehand... Ages, really.

I might just try this myself sometime, if the day ever comes where I actually have nothing better to do & don't have a dozen other neglected projects cluttering up my desk. <_<

Thread 48 (2019-09-11):

No USB serial

UnderXirox, 2019-09-11:
Hello
sorry for my english ^^
(That's when I draw the card on my card
There is Probe! NOT BlTouch and no com usb port)
 

sorry for my english ^^
(That's when I draw the card on my card
There is Probe! NOT BlTouch and no com usb port) clone ?

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
 
here is my concern I can not have a com usb port with the SKR-PRO (in fete ca depuit the beginning of the acha of the card)
with the maj Marlin nothing nothing changes

            #define SERIAL_PORT -1 // USB
/ **
         *Select a secondary serial port on the board to use for communication with the host.
                 * This allows the connection of wireless adapters (for instance) to non-default port pins.
                 * Serial port -1 is the USB emulated serial port, if available.
            *
        *: [- 1, 0, 1, 2, 3, 4, 5, 6, 7]
        * /

            #define SERIAL_PORT_2 6 // Wifi

for the esp any function with Proterface and the esp with the addres 192.168.0.1:8888 to paste in pronterface instead of the COM port

here are the files that I use

Thank you

dsl je n'arrive pas a upload my Configuration.zip dsl

omahena, 2019-09-11:
I am not sure I completely understand your post. But here is what I know...

The
```
#define SERIAL_PORT -1
```
Will only give you a serial port to control the printer. SD card is not working with Marlin... at all. You can only use if for flashing the board by removing the SD card, plugging it into an SD card reader in your computer, writing on the firmware and plugging it back into your printer.

Defining the
```
#define SERIAL_PORT_2 6
```

Should connect your ESP-01s to Marlin's command interpreter, but since the firmware delivered on the ESP-01s is not working and the firmware in the repository `BIGTREETECH-SKR-PRO-1.1/firmware/esp-01s/` isn't working either, you will have to build it yourself from scratch. Try these [instructions](https://www.youtube.com/watch?v=pJGBRriNc9I). You can flash the firmware file to the WiFi module directly using the SD card. I haven't built the ESP-01s firmware myself, since I cannot use it in parallel with USB serial and LCD serial... Marlin only supports two COM ports.

UnderXirox, 2019-09-11:
[FR]
pour moi   ESP-01 fonction tres bien avec le port

    #define SERIAL_PORT_2 6

avec ip dans pronterface 192.168.0.1:8888  via  ESP-01

je ne veux pas avoir la sd avec l'USB juste

le port com USB

    #define SERIAL_PORT_1 -1

ne fonction pas et ca depuis le debut (achat de la carte)

je veux juste pouvoir contrôler ma carte pas octoprint ou via le pc avec pronterface

Will only give you a serial port over the USB cable to control the printer

[EN]
for me ESP-01 function very well with the port

    #define SERIAL_PORT_2 6

with ip in pronterface 192.168.0.1:8888 yes via ESP-01

i do not want to have sd with usb

the USB com port

    #define SERIAL_PORT_1 -1
    //#define SERIAL_PORT_2 6

does not function and that since the beginning (purchase of the card)

i just want to be able to control my card via octoprint or via pc with pronterface

omahena, 2019-09-11:
I see what you mean. I am using OctoPrint over USB.

My exact define is as follows:
```
#define SERIAL_PORT -1   // Port for USB
```

Please note it is not `SERIAL_PORT_1` in case you have the _1 in there by mistake.

Your issue may also be in the platformio.ini file:
```
#
# Bigtreetech SKR Pro (STM32F407ZGT6 ARM Cortex-M4)
#
[env:BIGTREE_SKR_PRO]
platform = ststm32@5.4.3
framework = arduino
board = BigTree_SKR_Pro
extra_scripts = pre:buildroot/share/PlatformIO/scripts/generic_create_variant.py
build_flags = ${common.build_flags}
  -DUSBCON -DUSBD_USE_CDC -DUSBD_VID=0x0483 -DUSB_PRODUCT=\"STM32F407ZG\"
  -DTARGET_STM32F4 -DSTM32F407_5ZX -DVECT_TAB_OFFSET=0x8000 -DUSE_USB_HS_IN_FS
# -DHAVE_HWSERIAL6
lib_deps = ${common.lib_deps}
lib_ignore = Adafruit NeoPixel, SailfishLCD, SailfishRGB_LED, SlowSoftI2CMaster
src_filter = ${common.default_src_filter} +<src/HAL/HAL_STM32>
monitor_speed = 250000
```
I removed the HAVE_HWSERIAL6 and added USE_USB_HS_IN_FS to lower the chance of any potential GPIO pin conflicts.

Is the `-DUSBCON` missing in your config? It looks like it may be needed...

UnderXirox, 2019-09-11:
je viens de test idem avec votre solus   le probleme ne change pas

toujours pas de carte detecte par les pc

juste que la carte n'est pas reconnu pare les pc deja a la base
les pc  Windows 10 /7 et (Linux no virtual machine linux installer sur un pc)  ne  détecte meme pas comme  news  périphérique
pour linux que se soit avec lsusb et demsg ideme rien pas de périphérique connecter

UnderXirox, 2019-09-12:
oki
measure the USB D+ and
D- to see if there is a short circuit

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

omahena, 2019-09-13:
Pas de problème! Bonne journée.

jbaribeault, 2019-10-14:
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

Est-ce que le probleme etait un "short" entre D+ et D- sur le USB? A tu retournez la carte aux vendeur?

UnderXirox, 2019-10-14:
bonjour
pour le port  com entre la carte skr-pro et le pc
je passe par le wifi esp-01 avec esp3d dessus et avec Printrun via 192.168.0.1:8888

  `#define SERIAL_PORT_2 6`

 `A tu retournez la carte aux vendeur?`
oui

Hello
for the com port between the skr-pro card and the pc
I go through the wifi esp-01 with esp3d above Printrun via 192.168.0.1:8888

    `Do you return the card to the seller?
Yes

Pardon my English mad in FR ^^

HugeMissedSteak, 2019-11-08:
Your USB jumpers are wrong, you need to turn them 90 degrees.
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
As previously stated: currently you cannot access the SD-card through the pc, but you should see the board as COM device and be able to connect to it.

UnderXirox, 2020-01-26:
### Sorry for the response time

**yes** i noticed ... i changed place like on the doc and nothing nor changes
but I had the concern of the card received since
I go through ESP and it rolls except uploads gcode via esp I pass the lcd sd card (cr-10s)
I received a 2nd card and the USB function works well.

sorry for my english ...

abdulrehaman72, 2020-11-04:
Hi all, I have an issue while using BIGTREETECH SKR-PRO-1.1. After uploading the MARLIN 2.0 in to the board, I checked with each and every motor orientation using Pronterface.exe by connecting with USB (serial port's) . The motors were working fine. Now I'm trying to connect the board through pronterface, it's giving an issue like no serial port is connected. I checked thoroughly, no short-circuit in board, no wrong connections to the board,checked by connecting it with many laptops. Its showing the same issue like ' SERIAL  PORT NOT FOUND '.BL TOUCH is probing fine and input to the board is fine even TFT is glowing but it's not functioning. I tried resetting and rebooting the board still my issue was not resolved yet. My doubt is whether any internal issue with communication chip. I request you to give me a solution for this issue. Will be waiting for your support. Thank you.

ujfe71, 2021-12-17:
> Your USB jumpers are wrong, you need to turn them 90 degrees. 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 As previously stated: currently you cannot access the SD-card through the pc, but you should see the board as COM device and be able to connect to it.

Sorry but you are wrong.
The jumpers are ok, as mentioned in the manual of the board.
Now the user can acces the board over USB cable and Printerface for example. If the jumpers are in the direction you mentioned, there is no USB connaction...

Closed 2019-09-13.

Thread 49 (2019-09-11):

Unable to control fan1 or fan2 with M106/M107 commands

rlvanhuis, 2019-09-11:
Looking for the location of code lines to allow control of the parts cooling fans.  I was able to locate the extruder fan controls.
Thanks

omahena, 2019-09-16:
You didn't provide any configuration details, so that is probably why nobody responded so far. It is not even clear if you are running a CNC machine or a 3D printer and how many fans you wish to drive. I am betting you have a 3D printer, please correct me if I am wrong. Also I will assume you are looking in the main Marlin repository (not sure what state the code is in here).

I use `Marlin\src\pins\stm32\pins_BIGTREE_SKR_PRO_V1.1.h`:
```
#define FAN_PIN            PC8  // Fan0
#define FAN1_PIN           PE5  // Fan1
#define FAN2_PIN           PE6  // Fan2
```

`Marlin\Configuration_adv.h`
```
#define E0_AUTO_FAN_PIN PE5
...
#define EXTRUDER_AUTO_FAN_TEMPERATURE 50
#define EXTRUDER_AUTO_FAN_SPEED 255   // 255 == full speed
```

The code you are looking for is likely in `Marlin\src\module\temperature.cpp`. What felt really annoying to me and significantly lowers the maintainability of the Marlin code (yet makes it more "human readable" if that is a factor important to you) was the marco magic that is used to handle PIN defines.

In other words you may have specified `FAN1_PIN` somewhere in the code and you can tell that if you change the value it has an influence on the resulting firmware. But... if you search for `FAN1_PIN` in the code it is not used ANYWHERE. It was driving me nuts. Then I noticed that macros for pin defines were declared like PIN_EXISTS(FAN1)  and ANY_PIN(FAN1, FAN2) ... that are to be used without the _PIN postfix to make the code... prettier and save 4 bytes while wasting countless human hours... :D

From some of your other comments on the other issues, I think you simply connected the fans to fan0, fan1 and fan2 connectors and wish to control them using the M106 and M107 commands. Your wish seems reasonable but there are some reasons why this won't and shouldn't work.

Because of thermal management of Marlin not all fans may be controllable by G code. For example I can control my fan0 (part fan) and fan2 (not connected on my board - was surprised that worked). However Fan1 (hotend fan) will not respond to manual control but it will turn on during a print and function correctly.

M42 command may also be of interest to you and the undocumented I flag. See: `Marlin\src\gcode\control\M42.cpp`. But quite honestly I'd avoid using it on hotend fans for safety reasons.

Also keep in mind the `buildroot\share\PlatformIO\variants\BIGTREE_GENERIC_STM32F407_5X\PeripheralPins.c` seems to be all messed up and full of conflicts.

See: issue #36

P.s.: You may not wish to drive a fan with a heater channel. It looks like it works... But... To me it feels like using a bulldozer to remove a leaf from the road. You may wish to also save the heater channels for say a case heater. PWM pins on the STM32F4 CPU will apparently have enough power to drive an LED but for a DC fan you'll need to step up the current a bit. See: [here](https://circuitdigest.com/microcontroller-projects/stm32f103c8t6-pwm-tutorial-fan-speed-control).

rlvanhuis, 2019-09-16:
I am trying to keep up with a very steep learning curve.  My apologies for
the lack of info.
System Information
3D Printer
SKR PRO V1.1
BIQU 5160 Drivers V1.2
Anet A8 Plus (X,Y, ZZ, E).
Single Hot End
Hot End Cooling Fan
Parts Cooling Fan
Heated Bed.
24V System Power Supply. (common to each supply point x3)
Logic power supplied by the board
ESP-01S, not working
TFT35 V3.0 not working
USB comms to PC, working normally.
System prints normally

Bed Heat connected to Hot Bed +/-
Hot End Heater to Heat0 +/-
Hot End Cooling Fan to Fan0 +/-
Parts Cooling Fan to Fan1 +/-

You have given me much to look into.
First, I noticed you used Fan1 for your Hot End Cooler.  I could not find
any reference to it in the literature.  Just thought I would follow
convention Heat0/Fan0, Heat1/Fan1.

I really appreciate the input.

Thank you

Randy

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

omahena, 2019-09-17:
No problem, thanks for the info. It is indeed a steep learning curve. I was aiming for a drop-in board replacement for my CR-10 mini mobo... You know... 2 days max. LOL! And now two months later I'm still tweaking the system... More of a DIY...

Our systems are very similar. The CR-10 mini is a (X,Y,Z,E) system and 12V on the bed heater. For now I am powering the board with the Printer PSU but RaspberryPi USB might be powering it later. I can't decide on how to include power delivery control into the system (RasPi driven relay vs. SKR driven). I don't think this will influence things too much unless the source doesn't provide enough power. A USB power meter might be useful here. I think the stepper drivers are then also powered by the mobo power source, but the motor power comes through the separate power in (obviously).

I got the ESP-01S integrated well enough to know it is seen by Marlin and that the mobo will flash the firmware to the WiFi board. However since I can't have 3 serial ports (WiFi, PC and TFT35) I gave up on the WiFi interface in favour of OctoPrint on a RasPi and TFT35 LCD control interface. Yesterday I realised that had I bought a newer version of the TFT35 like you have, I could plug the WiFi directly into the TFT35 and this way daisy chain the serial ports in effect having only 2 ports registered in marlin and the WiFi serial in the TFT35 LCD. I would recommend you try that... You will need to recompile the TFT firmware (BTT repos here on github) and the ESP-01S firmware as well I think. I couldn't make either publicly accessible firmwares work. The one delivered on the WiFI module offered an AP but failed to respond to HTTP and the second one didn't offer an AP and didn't connect to my WiFi as expected. I hope it doesn't require an old 2.4GHz AP. I wouldn't be surprised...

Your wiring looks fine. My OCD was also bending me towards convention Heat0/Fan0, Heat1/Fan1... But... Too many plugs, too few holes to satisfy the OCD so I just left them the way they were by default... I think. Technically I wouldn't mind a case fan as well, but for that I'd need a case... So... :D And no idea what I'll do if I'll ever switch to dual extruder. But your fan situation should be covered as well. If the fans or heater MOSFETs behave strangely it is probably due to conflicting PIN configurations of the platform.

We could exchange config files, but this thread is probably not the place.

My pleasure.

Ales.

rlvanhuis, 2019-09-17:
@omahena, attached is a complete file set.  It is my 31st iteration.  So far the best running.  Still have small issues.  I have most of it working now.  I am beginning to understand more of the board construction (regretfully).  I have been on this journey for about 2 months.  Not sure yet, but it appears the pin for Fan1 may not be connected.  Was able to get fan2 to work as my hotend fan with fan0 as the parts cooling fan.  I will assess if board/driver cooling is needed, if so I will parallel with the hotend fan.
[RLV31Marlin-bugfix-2.0.x.zip](https://github.com/bigtreetech/BIGTREETECH-SKR-PRO-V1.1/files/3623002/RLV31Marlin-bugfix-2.0.x.zip)

Good Luck

Randy

omahena, 2019-09-18:
@rlvanhuis You seem to have the Marlin code from 2019-09-04, mine is a week newer, so there are some other differences.

I included both configs and `pins_BIGTREE_SKR_PRO_V1.1.h` with some "pin conflicts removed". It works for me (tm). Make a backup of your file and try using mine and in platformio.ini also add `-DUSE_USB_HS_IN_FS` in your build_flags for BIGTREE_SKR_PRO. I also don't have the `-DHAVE_HWSERIAL6` define in there and it might add pin conflicts. Maybe try removing it just for fun.

I checked and PE_5 (aka PE5 elsewhere) is only used for the PWM pinmap. I **think** this means that it cannot be used for anything else. But... HAVE_HWSERIAL6 might use it for serial. I am not sure where and how this define is used and I can't find a mention in the source ode. It shouldn't have an influence on the PE5 pin... But my trust levels in this platform are pretty low atm. It's one of the differences we have between our repos. If you will move your WiFi to your TFT35 3.0... You don't need the Serial6 enabled anyway.

I seriously doubt the PE5 pin has an electrical issue... You could check the trace (on a powered off board).

Cooling doesn't seem to be needed on the electronics. Just my stepper motors get very hot on higher currents... So I added temp probes to E an Y axis steppers.

As a side note. I noticed your threshold settings for Hybrid mode are very high. For me this caused skipped steps and layer shifts. Trinamic support recommends stealthChop2 to be used up to 1 RPM. So my value of 50 is still to high. Ah, but I just noticed you also have HYBRID_THRESHOLD disabled and use stealthChop2 all the way. Any... print issues? I get perfect prints in prints restricted to spreadCycle. Boosting the current doesn't really help with skipped steps in SC2 on my system. I think I just need to finetune the hybrid threshold.

I hope this helps.

[config.zip](https://github.com/bigtreetech/BIGTREETECH-SKR-PRO-V1.1/files/3625108/config.zip)

rlvanhuis, 2019-09-22:
For anyone looking.
I was able to get the expected response from my system using the following:
Fan0 for my parts cooling fan, controlled by program and TFT make no changes
Fan2 for my hotend cooling fan controlled by program in Auto (set the auto pin to PE6)
I have not tested yet, but just a SWAG...Fan1 is for the case if no changes are made.

Closed 2019-09-22.

Thread 50 (2019-09-12):

fan0 pin PC8 not compiling

djshrapnel, 2019-09-12:
I'm fairly new to this, I've dabbled in the past with programming tho. My setup is an ender 3 pro, mainboard skr pro with TMC5160 on X&Y, LV8729 on Z&E.
I've gotten a majority of it working, still having a little bit of overheating issues (didn't reach overtemp yet tho)

When trying to add PC8 pin to use_controller_fan, I get a compiling error within 10secs. I tried switching switching fan_pin to fan0_pin in skr pro pins file and it compiled but I get a bunch of warnings.

Is this a fix or is there some other issue going on?

Also I found a section regarding part cooling fans and would like to assign it to the 3rd set of pins but im not sure if I understand how fanmux0_pin works.

omahena, 2019-09-13:
What is the error you get reported? Are you compiling this repository or the main Marlin repository?

I am compiling the main repository and get a successful build when I use the PE6 pin. I get an error if I (re)use the PC8, because I am already using it for the hotend fan. So the build naturally complains with:
```
#error "You cannot set CONTROLLER_FAN_PIN equal to FAN_PIN."
```

I never used the FANMUX pins. But an educated guess is that it will use the pins you provided as bits for a counter/ fan selector. So let's say you just need two fans and you use FANMUX0_PIN and bind it to PC8. Then when the board would set the pin to low the FAN0 would come to life, when the pin would be set to high the FAN1 would come to life. If you use two pins - you get to count to four and with three pins to eight.

But such a solution would require a fan controller. A board that can take in 3 bits of info in and drive a few fans.

djshrapnel, 2019-09-13:
I'm using the main marlin repo. I guess I did have the exact same error as you.

My setup and plan was to use pin PE5 on my extruder setup on E0 auto fan pin and works fine, PE6 would be part cooling fan which compiled fine on fanmux0 pin, however I don't have a fan on it or mounted yet so I haven't tested it yet.

I was going to use PC8 as controller fan but hense my issue.

Is PC8 a hardware specific pin that marlin won't let me use?

omahena, 2019-09-13:
The error simply means that the PC8 pin is already in use elsewhere. So it is not hardware specific in a way that Marlin wouldn't let you use it. But it is hardware specific in a way that it allows a fan to be connected to it.

Your problem should be a simple allocation decision question. I went with the default. These are defined in `Marlin\src\pins\stm32\pins_BIGTREE_SKR_PRO_V1.1.h`:
```
#define FAN_PIN            PC8  // Fan0 - part cooling
#define FAN1_PIN           PE5  // Fan1 - extruder
```

And in `Marlin\Configuration_adv.h` I configured to start cooling the hotend when it reaches 50C:
```
#define E0_AUTO_FAN_PIN PE5
...
#define EXTRUDER_AUTO_FAN_TEMPERATURE 50
#define EXTRUDER_AUTO_FAN_SPEED 255   // 255 == full speed
```

This leaves you PE6 for case cooling. The number of (convenient) fan connectors is my only complaint about the board. But you should be able to use any PWM capable pin in the EXTENSTION-1 connector with some custom wiring (although the provided power likely will not suffice to drive a fan directly).

You can of course also change pin assignments as you wish. I agree Marlin could use different names for the pins to make things more obvious.

djshrapnel, 2019-09-13:
Yea I kind of noticed the lack of fan pins, I guess I will have to wire things the other way or look into the extensions if I really have to. Thanks for clearing some of this up

omahena, 2019-09-13:
@djshrapnel You are very welcome. I hope we didn't have a misunderstanding... Because with a single extruder (hotend + part fan) and case fan, you need three fans... And the three fan connectors should cover your Ender 3 Pro. Unless... mods. :)

Closed 2019-09-13.

Thread 51 (2019-09-25):

[BUG] Part-Cooling fan always on

Haschtl, 2019-09-25:
Since the latest update the part-cooling fan is on after the board is started up.

My fan-configuration is as followed:

Configuration:
#define USE_CONTROLLER_FAN

Configuration_adv:
#define E0_AUTO_FAN_PIN PD3
#define E1_AUTO_FAN_PIN PD3
#define E2_AUTO_FAN_PIN -1
#define E3_AUTO_FAN_PIN -1
#define E4_AUTO_FAN_PIN -1
#define E5_AUTO_FAN_PIN -1
#define CHAMBER_AUTO_FAN_PIN PE6

pinfile:
#define FAN_PIN            PC8  // Fan0
#define FAN1_PIN           PE6 //PE5  // Fan1
#define FAN2_PIN           -1 //PE6  // Fan2
#define CONTROLLER_FAN_PIN PE5        // Set a custom pin for the controller fan

So fan1, chamber fan, controller fan and E0/E1 Auto fans are working. Only Fan0 is always on.

I don't know if it's an electrical issue or software. I have an ultimaker 2 printhead with 2x 30mm 12V fans in series (because i'm running at 24V) and one fan died some time ago... I hope that didn't destroy the FAN0 mosfet

Btw: I have currently updated to the latest Marlin-Firmware

Haschtl, 2019-09-26:
Has anybody encountered similar issues with multiple fans like me?

JJHMARR2020, 2019-09-26:
//#define USE_CONTROLLER_FAN
#if ENABLED(USE_CONTROLLER_FAN)
  //#define CONTROLLER_FAN_PIN -1           // Set a custom pin for the controller fan

What is the pin for this setting in Configuration_adv? Whatever pin it is set to will automatically turn on because it thinks it will cool stepper controllers or mosfets.

Haschtl, 2019-09-26:
I have uncommented the CONTROLLER_FAN_PIN in the Configuration_adv.
I will change the fan0 with fan1 to check if its an hardware issue or software.

Haschtl, 2019-09-27:
I now replaced the damaged 12V fan and the second one with two 24V fans parallel.
The green fan led on the SKR Pro lights up immediately after i connect the SKR to the 5V-supply.

I think the mosfet got damaged. Could this happen due to the broken fan? The fan has a short circuit so the current increases, which kills the mosfet? It's the [AO3400](https://www.digikey.de/product-detail/de/alpha-omega-semiconductor-inc/AO3400/AO3400-ND/7560344), am I right?

Haschtl, 2019-09-30:
I have found the problem. I didn't connect the two 12V fans in series but parrallel. The current must have been too high sometime and killed the mosfet for the FAN0. I'm now using an old Ramps RRD fan expansion board to control two fans with these pins: PD2, PE0

Closed 2019-09-30.

Thread 52 (2019-09-26):

Endstops not working with TMC5160

MtPegasus, 2019-09-26:
Hello,

I have set up the board with TMC5160 on X/Y/Z-axis.
I use mechanical switches like before on my old board.
When the endstops switch the LED on the board goes on but the axis continues to move.

I tried different things like changing the logic, changing the pin and the port.
It does not work
Sensorless homing is off!

MtPegasus, 2019-09-26:
additional info: the diag pin is not connected

JJHMARR2020, 2019-09-26:
Does the Z axis acknowledge the endstops?

MtPegasus, 2019-09-26:
no she does not

JJHMARR2020, 2019-09-26:
Are the drivers running in SPI?

JJHMARR2020, 2019-09-26:
In the section where motor drivers are defined you should try changing from TMC5160 to TMC5160_Standalone; this disables SPI for the motors. This setting is found starting on line 650 in Configuration.h
There is a possibility it might fix the issue, but it doesn't explain why it was happening. I originally had a similar issue with my TMC2130's. I run all in SPI with Stallgaurd 2 on X and Y with two physical endstops for the dual Z axis. This board requires inverted logic for endstops.

MtPegasus, 2019-09-26:
Yes they are running in SPI. Im compiling now with TMC5160_Standalone.

MtPegasus, 2019-09-26:
ok, now the axes are not moving

JJHMARR2020, 2019-09-26:
I would connect to the board with Pronterface and send the command M119.
Share your results to see the states of your endstops

emilhse, 2019-09-30:
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

can you please share how did you setup tmc5160 ?
some how i can't get it working please help

emilhse, 2019-09-30:
@MtPegasus can you please share your config files to set up tmc5160 with skr pro?

evandene, 2019-10-12:
Could it be you are using the row of connectors closest to de stepper drivers?
X Y Z is the other row

bdxgrs, 2019-10-30:
Bonjour, j'ai une erreur de compilation sur le firmware fourni  sur le site bigtreeteck pro v1.1 avec atom. Pourriez-vous partager firmware marlin  fonctionnel pour bigtreetech pro v1.1 SVP. ? J'ai des stepper 5160 et bl touch. Mais ce que je cherche, c'est déjà un firmware complet que je puisse copiler sans erreur pour bigtreeteck pro et qui ne plante pas de base parce qu'il ne reconnait la carte, ou qu'il manque le dossier build ..etc... merci d'avance

emilhse, 2019-11-29:
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

Please check if you have inverted endstops in Marlin settings because most likely board sees them as they are triggered ,that can cause the problem

dineshvyas, 2019-12-07:
can you post photoghtaph of your board with jumpers? this might give some clue.

emilhse, 2019-12-07:
Ok I will do that tomorrow

evandene, 2019-12-07:
> can you post photoghtaph of your board with jumpers? this might give some clue.
No need for jumpers when in SPI mode = standard. Works out of the box including end stops

MrLAtt, 2019-12-15:
I am having the same issue, but I am using sensorless homing with TMC2209 drivers.

the sensorless homing on the X and Y axis works perfectly, but the endstop on the Z Axis doesn't work at all.

I'm sure I'm plugged into the right port, and that my endstop is triggering the correct way ( I've tried all the ports, and have switched between the endstop pulling low, and high)

When I send an M119 it says that all three are open, regardless of actual endstop status

can anyone help?

HugeMissedSteak, 2019-12-15:
If you use sensorless homing compatible drivers, then usually the stallguard pin needs to be disconnected (cut off) so that the mechanical switches will work. Alternatively you can change the firmware to use the endstops of a different input that is not shared with the stallguard (i.e. from an unsed axis)

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

MrLAtt, 2019-12-15:
Perfect, that (and then reversing the triggering of the endstop) solved the problem!

however, now i have a new problem, my extruder motor isnt moving. i've tried swapping driver boards, extruder motors, and switching the pins of E0 and E1 and then using the E1 'slot' instead, and nothing has solved it.
As far as i can tell, i have ruled out the board, the driver and the motor. What could it be?

And its not the cold extrusion prevention, I am preheating the nozzel ;)

MrLAtt, 2019-12-15:
(the motor doesn't even seem to be powered up, since it doesn't have any holding strength either)

MrLAtt, 2019-12-16:
also, I've just noticed that when i have the extruder setup in the 'E1 Slot' the motor still wont move, but it will hold position, whereas it wont hold position in the 'E0 Slot'.

not sure if that helps in any way though

evandene, 2020-05-22:
It's now a few months ago and I wonder if you have managed to run you SKR PRO V1.1 board with the TMC5160 drivers

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

It's now a few months ago and I wonder if you have managed to run you SKR PRO V1.1 board with the TMC5160 drivers, did you? Could you please share your solution(s)?
Thanks

oldman4U, 2020-06-09:
Seems this ticket is not in use any more.

@thinkyhead (Could you please close this ticket due to inactivity)

Thank you

thinkyhead, 2020-06-14:
Only @trendelkamp or @bigtreetech can close this issue.

oldman4U, 2020-06-15:
@bigtreetech Could you please close this unneeded ticket. Thank you

oldman4U, 2020-10-10:
Please help the community and close the ticket once you do not need it anymore. Thank you

Closed 2020-10-10.

Thread 54 (2019-09-28):

TMC2208 and Z-homing

Livenmach, 2019-09-28:
I have SKR_Pro_V1.1 and TMC2208v3 drivers in uart mode using the dual z connection. I've gotten all 3 axis moving with commands in Pronterface properly. when I home the X,Y axis they seem to work ok however the Z-axis homes 1 motor at a time. 1 moves about 5mm then the other moves about 5mm then back to the other until it hits the limit switch. its also really loud. after that it moves fine and sounds great.??

HaythamB, 2019-10-05:
Hey. I have mine set up with individual Z drivers (one on the Z and the other on E1) and it works perfectly. Have you tried this setup? Or are you using a dual Z with a single driver?

Livenmach, 2019-10-14:
this board has the dual Z connectors with a single driver built into it. it works fine with the single driver and a separate splitter board.

oldman4U, 2020-06-08:
Hi Livenmach.

Would you please be so kind to close this ticket.

Thank you

Closed 2020-06-09.

Thread 55 (2019-09-30):

Tmc5160 Cannot connect to Skr pro

emilhse, 2019-09-30:
tried everything can not somehow manage to make it work
please help

extesy, 2019-09-30:
This is the same issue as in https://github.com/MarlinFirmware/Marlin/issues/15415

piotrekm7, 2019-10-01:
They're working for me. You can check my configs [here](https://github.com/piotrekm7/Marlin/tree/dev-2.1.x/Marlin), maybe you'll notice some differences.

extesy, 2019-10-04:
@piotrekm7 I see that you are using `dev-2.1.x` branch which is a few weeks old and is not maintained anymore. Can you try reapplying your configs on top of the latest `bugfix-2.0.x` branch?

ogsv, 2019-10-08:
I'm also having this issue. Power is connected to both POWER and MOTOR_POW, and VCC jumper is set to IN, not USB, if that matters... Running the Marlin build from this repo, not from the MarlinFirmware repo.
M122 gives:
`Driver registers:
		X	0xFF:FF:FF:FF	 Bad response!
		Y	0xFF:FF:FF:FF	 Bad response!
		E	0xFF:FF:FF:FF	 Bad response!
Testing X connection... Error: All HIGH
Testing Y connection... Error: All HIGH
Testing E connection... Error: All HIGH`

piotrekm7, 2019-10-11:
@extesy I used tmc 5160 with 2.0 before. About power supply, I have 28V on MOTOR_POW. Should work with 12V, but who knows, maybe that's an issue.

piotrekm7, 2019-10-11:
You can even flash my firmware and check if motors are working.
Note that it's corexy kinematics, will be fine for test though.
I have usb connection disabled, but can recompile if you wish.
[firmware.zip](https://github.com/bigtreetech/BIGTREETECH-SKR-PRO-V1.1/files/3719483/firmware.zip)

SlavaAn, 2019-11-24:
In my case it (firmware.zip) work! Big thanks piotrekm7. But USB-PC link don't work.

emilhse, 2019-11-29:
thank you very much i have sorted the problem

piotrekm7, 2019-12-03:
> In my case it (firmware.zip) work! Big thanks piotrekm7, I try to make my code 2 week without result. But USB-PC link don't work.

I have setup for lcd and esp8266. If you want to use USB you will have to change serial configuration and rebuild the project.
You can clone https://github.com/piotrekm7/Marlin and in Configuration.h change:
**#define SERIAL_PORT 6**
to:
**#define SERIAL_PORT -1**

Closed 2019-11-29.

Thread 56 (2019-10-04):

Third serial port possible?

Haschtl, 2019-10-04:
Hello,
I am using the Skr pro with a raspberry running octoprint as the main host. I'm using the ESP3D as a host, too.
And i also have a touchscreen connected to the raspberry. Until now I'm using the Octoprint API to send Gcode via the touchscreen to the Skr pro. But this API has very limited possibilities, as i cannot read the serial output.

So i can only rely on some octoprint-flags like "printing" oder "operational". But I cannot get the position or any serial output from marlin.

Is it possible to use the UART-connector on the skr pro for a third serial interface? Or is there another way using spi or i2c?

extesy, 2019-10-04:
@Haschtl Marlin doesn't currently support 3 serial ports. It doesn't have anything to do with a board, it's a firmware limitation. Feel free to create a feature request for Marlin team.

omahena, 2019-10-05:
@Haschtl I am not sure I follow how you use the OctoPrint API via the touchscreen. Also not sure what touchscreen you are using. But considering the current limitation of Marlin to only support two serial ports at the time, I recently saw the option to plug the ESP3D WiFi module into the TFT35 V2.0 and V3.0 LCDs. This should let you use OctoPrint using the USB Serial interface, the TFT35 probably allows direct touch control and I assume the ESP3D WiFi module also functions when plugged into the TFT35 board.

**PLEASE NOTE:** I currently do not believe a single claim put forward by BigTreeTech since in my experience a lot of these claims are just hot air. So if it not verified and confirmed by me or a trusted 3rd party - I just don't believe them.

I have a TFT35 V1.2 that they "bundled" into my AliExpress purchase... So I cannot verify the TFT35 V2.0 and V3.0 work. From what I hear from a trusted 3rd party, the TFT35 V3.0 firmware experience is just as problematic as the SKR Pro 1.1 experience. USB key insertion will freeze the device and ESP3D WiFi apparently doesn't work. I bring up the potential solution because I do not have any info on the V2.0 device and well... Perhaps we missed something when testing the V3.0 version.

My recommendation is that if you intend to try this, that you buy your BTT stuff somewhere where you can send them back if they don't work as advertised. Please double check everything before you spend money.

If anyone can provide additional test results... I am all ears.

Haschtl, 2019-10-08:
Btw. My opinion to the SKR Pro 1.1 is very good... its a good boad with a lot of additional gpio's.
I have connected 3 fans + two fans with external mosfets, 4 temperature sensors, two hotends, one light, a BLTouch sensor, an SPI Oled, an encoder, speaker, sd-extention, esp3d, a laser, two filament sensors and all is working properly now (only the esp3d hotspot is not avilable when connected to the skr).
I have also most of the marlin-features activated. For e.g. the power-supply control, automatic controller and hotend fans.

The only things I dont like is:
- flashing with sd-card (over usb would be much easier in my setup)
- the lack of support and incomplete  pins-file

But with my huge setup i need to adjust the pins manually anyway, as a predefined pin-configuration would not fit my needs probably.

extesy, 2019-10-08:
@Haschtl Since you have so many external inputs enabled and working, do you mind sharing your full config files and any Marlin modification you've done to make it all work?

Haschtl, 2019-10-09:
Just have a look at my [MarlinFirmware-Fork](https://github.com/Haschtl/Marlin/tree/bugfix-2.0.x)

I have edited the following files:
**General configuration:**
- Marlin/Configuration.h
- Marlin/Configuration_adv.h
- Marlin/src/pins/stm32/pins_BIGTREE_SKR_PRO_V1.1.h

**Custom modifications**
I have calibrated all of my temperature sensors by it's own. Therefore I have replaced some thermistor-Lookup-tables

- Marlin/src/module/thermistor/thermistor_11.h
- Marlin/src/module/thermistor/thermistor_12.h
- Marlin/src/module/thermistor/thermistor_13.h
- Marlin/src/module/thermistor/thermistor_20.h

** PID - Fan - scaling **
I added an additional PID-value to compensate temperature drops, if the part fan is enabled/disabled.
Therefore I made changes in the following files:

- Marlin/src/module/temperature.cpp
- Marlin/src/module/temperature.h
- Marlin/src/lcd/menu/menu_advanced.cpp
- Marlin/src/module/configuration_store.cpp
- Marlin/src/gcode/config/M301.cpp
- Marlin/src/inc/SanityCheck.h

** Laser modifications **
I have also some changes made in Marlin/src/HAL/HAL_STM32/fastio.h. I had problems to define the SPINDLE_LASER_PWM_PIN. I don't know If this is still needed.
```
//#define PWM_PIN(P)              digitalPinHasPWM(P)
#define PWM_PIN(P)              true
```

** Added a custom controller **
I have a selfmade controller with an encoder and an I2C-OLED Display.

Therefore I added `#define U8GLIB_SSD1306_CONTROLLER`, which enables the following in Marlin/src/inc/Conditionals_LCD.h:
```
#define U8GLIB_SSD1306
#define IS_ULTIPANEL
```

** Other stuff you will not need **
- Marlin/_Bootscreen.h
- Marlin/src/lcd/language/language_de.h
- Marlin/src/lcd/language/language_en.h

I have also added the ESP3D Firmware to my repository. I can flash the firmware with the ArduinoIDE and it is also running, while connected to the PC, but when I connect it to the SKR, the hotspot doesn't show up.

Short pin overview:
```
#define X_MIN_PIN          PB10
#define X_MAX_PIN          -1 //PE15 - is used for filament sensor
#define Y_MIN_PIN          -1 //PE12
#define Y_MAX_PIN          PE12 //PE10  - is used for filament sensor
#define Z_MIN_PIN          PG5 //PG8
#define Z_MAX_PIN          PG8 //PG5

#define Z_MIN_PROBE_PIN  PA2

//
// Steppers
//
#define X_STEP_PIN         PE9
#define X_DIR_PIN          PF1
#define X_ENABLE_PIN       PF2
#ifndef X_CS_PIN
  #define X_CS_PIN         PA15
#endif

#define Y_STEP_PIN         PE11
#define Y_DIR_PIN          PE8
#define Y_ENABLE_PIN       PD7
 #ifndef Y_CS_PIN
  #define Y_CS_PIN         PB8
#endif

#define Z_STEP_PIN         PE13
#define Z_DIR_PIN          PC2
#define Z_ENABLE_PIN       PC0
#ifndef Z_CS_PIN
  #define Z_CS_PIN         PB9
#endif

#define E0_STEP_PIN        PE14
#define E0_DIR_PIN         PA0
#define E0_ENABLE_PIN      PC3
#ifndef E0_CS_PIN
  #define E0_CS_PIN        PB3
#endif

#define E1_STEP_PIN        PD15
#define E1_DIR_PIN         PE7
#define E1_ENABLE_PIN      PA3
#ifndef E1_CS_PIN
  #define E1_CS_PIN        PG15
#endif

//
// Software SPI pins for TMC2130 stepper drivers
//
#if ENABLED(TMC_USE_SW_SPI)
  #ifndef TMC_SW_MOSI
    #define TMC_SW_MOSI    PC12
  #endif
  #ifndef TMC_SW_MISO
    #define TMC_SW_MISO    PC11
  #endif
  #ifndef TMC_SW_SCK
    #define TMC_SW_SCK     PC10
  #endif
#endif

#define TEMP_0_PIN         PF9
#define TEMP_1_PIN         PF5  // T2 <-> E1
#define TEMP_BED_PIN       PF3  // T0 <-> Bed
#define TEMP_CHAMBER_PIN   PF6

#define HEATER_0_PIN       PB1  // Heater0
#define HEATER_1_PIN       PD14 // Heater1
#define HEATER_2_PIN       PB0  // Heater1
#define HEATER_BED_PIN     PD12 // Hotbed
#define FAN_PIN            PD2 //RRD-Expansion1     //PC8  //Fan0
#define FAN1_PIN           PE6 //                     PE5  // Fan1
#define FAN2_PIN           PE0  //RRD-Expansion2 //PE6  // Fan2

#define SDSS               PB12
#define BEEPER_PIN       PG4
#define BTN_ENC          PA8

#define PS_ON_PIN          PG13
#define FIL_RUNOUT_PIN     PE15
#define FIL_RUNOUT2_PIN     PE10

#define SPINDLE_LASER_ENA_PIN     PG11   // Pin should have a pullup/pulldown!
#define SPINDLE_LASER_PWM_PIN     PC9   // MUST BE HARDWARE PWM ?
#define SPINDLE_DIR_PIN           PC1

#define CASE_LIGHT_PIN  PF8   // MUST BE HARDWARE PWM

#define CONTROLLER_FAN_PIN PE5        // Set a custom pin for the controller fan

#define BTN_EN1        PG10
#define BTN_EN2        PF11  // A2 - rotary encoder B
#define BTN_ENC        PA8  // A3 - rotary encoder push switch

#define CALIBRATION_PIN PC5 // Override in pins.h or set to -1 to use your Z endstop

#define HEATER_CHAMBER_PIN       PD11

#define E0_AUTO_FAN_PIN PD3
#define E1_AUTO_FAN_PIN PD3
#define CHAMBER_AUTO_FAN_PIN PE6
```

Some pins in my configuration are switched with no practical sense. Like the heater, temp or fan pins. These should be the default-pins more or less to be less disheveling

Haschtl, 2019-10-13:
https://youtu.be/9TnhRrMQPQw

I made a video demonstrating what is possible with a touch interface using the octoprint serial log.
I have all settings included in the gui including a visualization of the bed-level mesh.
The octoprint serial log costs a lot of ressources, so having an extra serial connection would be better. But for now its pretty good

extesy, 2019-10-13:
@Haschtl Very impressive! What are you using for that UI?

Haschtl, 2019-10-13:
I have a raspberry pi 4 running Octoprint
I'm using PyQt for the GUI together with the OctoprintAPI to send gcode to the controller and the serial-log to parse the output.
Ah... and I have included another piece of software from me ([RTOC](https://github.com/Haschtl/RealTimeOpenControl)) to collect data and create the graph for the temperatures, etc.

The GUI itself is a dirty piece of software... There is a lot hardcoded stuff especially for my printer-setup (dual extruder, chamber, TMC's, ...) and also the stuff connected to the raspberry pi (power-consumption, switches for the enclosure-doors, camera, two temperature sensors, smoke sensor).

Closed 2019-10-09.

Thread 57 (2019-10-08):

SKR Pro V1.1 issue with labeling of hotbed output

Reick, 2019-10-08:
I have connected the output of the hotbed to a SSR and the SSR dont work, because minus and plus are twisted. There are a labeling issue on the documents and pcb. See the picture: https://imgur.com/KfVhJQn
https://imgur.com/y4b2Drl
https://imgur.com/NMEPPR2

Meddleglitch, 2019-10-09:
Yep. Mine is exactly like this, too.
Glad somebody else pointed it out.

viper93458, 2019-10-12:
I determined the same and never thought to post it. :(

UnderXirox, 2019-10-14:
Hello

Mine is exactly like this too

dingbatca, 2019-10-24:
Bumping this.  Also confirming this issue.

Haschtl, 2019-10-25:
Can confirm this too.
But I did simply switch the connectors because I thought I connected it wrong. Didn't think of that issue

dch1921, 2019-11-09:
Originally posted about this on July 20 in the Bigtreetech SKR Pro user group.

DroneMang, 2019-12-06:
Yep, just figured this out myself!

sneakym8, 2019-12-08:
Must be all like that. Mine is also.

turnali, 2020-01-23:
I m having a problem with my heatbed. My skr pro card is attached to a ssr and to a silicon heatbed. The problem is, as soon as i turn on the card, the silicon bed starts to heat up. The connection between bed and the ssr is correct. The ssr is working properly because i used another ssr and still have same problem. The ssr is connected to the hotbed input on the card and the bedpower input is to the power supply. I even tried to get the bed power directly from the power supply but still have the same problem. I used a normal 12v heatbed on the card to check if the problem is on the card but it heats normally so the problem is the connection i think. Do you have any suggestions to my problem?

PaschyS, 2020-01-23:
> I m having a problem with my heatbed. My skr pro card is attached to a ssr and to a silicon heatbed. The problem is, as soon as i turn on the card, the silicon bed starts to heat up. The connection between bed and the ssr is correct. The ssr is working properly because i used another ssr and still have same problem. The ssr is connected to the hotbed input on the card and the bedpower input is to the power supply. I even tried to get the bed power directly from the power supply but still have the same problem. I used a normal 12v heatbed on the card to check if the problem is on the card but it heats normally so the problem is the connection i think. Do you have any suggestions to my problem?

What SSR do you use? I had similar problems with an AC Silicon heating bed in combination with the original SSR in my printer. What firmware configuration do you made?

turnali, 2020-01-23:
i use ''fotek ssr 40 da''. my friend made the configuration for me. can you send a screenshot of your config. please? maybe its because of the config.

turnali, 2020-01-23:
how did you solve your problem?

turnali, 2020-01-23:
> > I m having a problem with my heatbed. My skr pro card is attached to a ssr and to a silicon heatbed. The problem is, as soon as i turn on the card, the silicon bed starts to heat up. The connection between bed and the ssr is correct. The ssr is working properly because i used another ssr and still have same problem. The ssr is connected to the hotbed input on the card and the bedpower input is to the power supply. I even tried to get the bed power directly from the power supply but still have the same problem. I used a normal 12v heatbed on the card to check if the problem is on the card but it heats normally so the problem is the connection i think. Do you have any suggestions to my problem?
>
> What SSR do you use? I had similar problems with an AC Silicon heating bed in combination with the original SSR in my printer. What firmware configuration do you made?

i use ''fotek ssr 40 da''. my friend made the configuration for me. can you send a screenshot of your config. please? maybe its because of the config.
how did you solve your problem?

PaschyS, 2020-01-23:
Do you use a 12v DC heatbed? You have the wrong SSR when you use the DA this means DC input for control and AC for output. DD means DC control input DC output.  You must use a 40Amper or better more Amps. And do you need a heat sink.

turnali, 2020-01-23:
> Do you use a 12v DC heatbed? You have the wrong SSR when you use the DA this means DC input for control and AC for output. DD means DC control input DC output. You must use a 40Amper or better more Amps. And do you need a heat sink.

my heatbed is a 5mm aluminum plate with a silicon heatbed under it. on top, its a magnetic pei spring steel plate from Twotrees. My power supply is a Meanwell LRS-350-12 12VDC 29.0A AC/DC. I have the same setup in two different printers but they have different control boards. This is the first time i am having this problem. i dont need a heatsink

PaschyS, 2020-01-23:
When you use a 12v Silicon Heatbed then is the Fotek DA the wrong SSR. I had the same problem with a 230V Heatbed, then I changed the SSR to a AC Version instead of a DC version and it works great.

turnali, 2020-01-23:
> When you use a 12v Silicon Heatbed then is the Fotek DA the wrong SSR. I had the same problem with a 110-230V AC Heatbed, then I changed the SSR to a AC Version instead of a DC version and it works great. And Importend when you use a 12v/24v Heatbed do you need a heatsink for the ssr, it will reach high Temps with no cooling.
> 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

i understand  but the ssr i use is the same one in two different printers with the same silicon beds. they have no problems. even my friend who made fixed the firmware for me uses the same ssr and silicon bed in his machines as well and he owns 3d printer service store.  with this one, when i turn on the machine, the bed starts to heat up and continue to heat up. it doesnt stop if set it at a certain degree from the screen or even by gcode. before it wasnt getting any power because the wiring connection was wrong until i read this post. so i switch the +- wire positions. its getting power now but it heats up by itself. ssr wires goes to ''hotbed'' output and ''bedpower'' output goes to the power supply. so the connection is right. My friend couldnt solve this problem either because he never worked on a SKR Pro board before. the board output connections are different than other boards

PaschyS, 2020-01-23:
I understand you and your problem. That I don't get you wrong now.  Are you using a 12v heating bed or a 110 / 230v? And which one, have you a link?
You can messure that input at the ssr. When the board don't switch on the ssr and the Heatbed works, than im right. When not the board switch on the ssr. My ssr have a led where can I look if the ssr works or not.

turnali, 2020-01-23:
the silicon bed is 220v 250W. my ssr has a led as well. it turns on as soon as i turn on the printer and start heating up the bed. in my other printers, the led turns on only when the bed is heating and when its not heat, the led turns off

> I understand you and your problem. That I don't get you wrong now. Are you using a 12v heating bed or a 110 / 230v? And which one, have you a link?
> You can messure that input at the ssr. When the board don't switch on the ssr and the Heatbed works, than im right. When not the board switch on the ssr. My ssr have a led where can I look if the ssr works or not.

the silicon bed is 220v 250W. my ssr has a led as well. it turns on as soon as i turn on the printer and start heating up the bed. in my other printers, the led turns on only when the bed is heating and when its not heat, the led turns off

PaschyS, 2020-01-23:
Can you measure up the bed output from the board without ssr?
At the Board are leds for the outputs, when the output is green , then is the mosfet on.
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

The only thing what I use in the configs is PID for the bed with bang bang.

AnHardt, 2020-01-23:
@turnali
You did find this issue. Did you read it? Did you understand the consequences?

Did you try to connect the SSR with the opposite polarity?
Did you power the bed-mosfet on its own connector to the power supply?

turnali, 2020-01-23:
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

ofcourse i connected the ssr with opposite polarity. if you read my conversation with ''PaschyS '', i couldnt make the heatbed and ssr work until i found this post.
And yes to your other question as well. its also in my conversation with ''PaschyS''. you can read it

turnali, 2020-01-23:
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

i will measure up the bed output without the ssr tomorrow and let you know the result. But as i mentioned before, i attached a 12v heatbed without the ssr to the skr pro board from another printer  just to see if the board and bed connections are working properly. And it was working fine with no issues. i think mosfet led was green but i will again tomorrow

turnali, 2020-01-29:
I was able to stop the heating by itself problem but this time the bed doesnt heat at all :))).  Everything works fine on the board; output connections, current, leds....  I connected the no 1 output of the SSR and other bed wire together to L or N on the power supply and it stopped the heating but...
Before, the connection was like the diagram below.
Still couldnt fixed this stupid problem

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

GadgetAngel, 2020-01-30:
@turnali Here is how I would hook up your situation: see image below.  What I see are two problems. You do not have Neutral hooked up to the SSR AC side.  Also You do not need to hook to the BED POWER terminals.  The whole point of using an SSR is to power the AC Silicon Heatbed from the wall AC. The connection to the SKR Pro is just to control the SSR switch side. The SSR switch side will allow AC Voltage and current to flow into the AC Silicon Heated Bed.  Therefore, DO NOT use the Bed Power terminals on the SKR PRO (those are meant to hook up to the Bed directly without an AC SSR).  You need to power the MCU (SKR PRO) so that the board can control the SSR, so add the 12VDC power to the POWER termials on the SKR PRO.  Now plug up to the AC and the MCU will control the SSR and heat up the BED only when the SKR Pro turns on the SSR.
[SSR Hookup -needs Neuutral hooked to SSR and 12vdc power hooked to BOARD power.pdf](https://github.com/bigtreetech/BIGTREETECH-SKR-PRO-V1.1/files/4133697/SSR.Hookup.-needs.Neuutral.hooked.to.SSR.and.12vdc.power.hooked.to.BOARD.power.pdf)

GadgetAngel, 2020-01-30:
Here is how I would hook up your situation: see image below. What I see are two problems. You do not have Ground hooked up to the SSR AC side. Also You do not need to hook to the BED POWER terminals. The whole point of using an SSR is to power the AC Silicon Heatbed from the wall AC. The connection to the SKR Pro is just to control the SSR switch side. The SSR switch side will allow AC Voltage and current to flow into the AC Silicon Heated Bed. Therefore, DO NOT use the Bed Power terminals on the SKR PRO (those are meant to hook up to the Bed directly without an AC SSR). You need to power the MCU (SKR PRO) so that the board can control the SSR, so add the 12VDC power to the POWER termials on the SKR PRO. Now plug up to the AC and the MCU will control the SSR and heat up the BED only when the SKR Pro turns on the SSR.
[SSR Hookup -needs Ground hooked to SSR and 12vdc power hooked to BOARD power.pdf](https://github.com/bigtreetech/BIGTREETECH-SKR-PRO-V1.1/files/4133987/SSR.Hookup.-needs.Ground.hooked.to.SSR.and.12vdc.power.hooked.to.BOARD.power.pdf)
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

GadgetAngel, 2020-01-30:
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

@turnali Here is how I would hook up your situation: see image below. What I see are two problems. You do not have Ground hooked up to the SSR AC side. Also You do not need to hook to the BED POWER terminals. The whole point of using an SSR is to power the AC Silicon Heatbed from the wall AC. The connection to the SKR Pro is just to control the SSR switch side. The SSR switch side will allow AC Voltage and current to flow into the AC Silicon Heated Bed. Therefore, DO NOT use the Bed Power terminals on the SKR PRO (those are meant to hook up to the Bed directly without an AC SSR). You need to power the MCU (SKR PRO) so that the board can control the SSR, so add the 12VDC power to the POWER termials on the SKR PRO. Now plug up to the AC and the MCU will control the SSR and heat up the BED only when the SKR Pro turns on the SSR.
[SSR Hookup -needs Ground hooked to SSR and 12vdc power hooked to BOARD power.pdf](https://github.com/bigtreetech/BIGTREETECH-SKR-PRO-V1.1/files/4134000/SSR.Hookup.-needs.Ground.hooked.to.SSR.and.12vdc.power.hooked.to.BOARD.power.pdf)
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

turnali, 2020-01-30:
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

The green ground wire output connection you draw from the ssr is a mounting screw hole. Its the same as the one below. Its not a output hole. There are only 4 outputs on the ssr. Numbers 1,2,3 and 4. Number 1 goes from the ssr to the power supply L or N. Number 2 comes from the silicon heat bed and the other part of that wire goes to the power supply as well to L or N. Numbers 3 and 4 are Positive and Negative outputs that goes to the control boards Hotbed outputs.

turnali, 2020-01-30:
But power connections you mentioned, i will try them

turnali, 2020-01-30:
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

The green ground wire output connection you draw from the ssr is a mounting screw hole. Its the same as the one below. Its not a output hole. There are only 4 outputs on the ssr. Numbers 1,2,3 and 4. Number 1 goes from the ssr to the power supply L or N. Number 2 comes from the silicon heat bed and the other part of that wire goes to the power supply as well to L or N. Numbers 3 and 4 are Positive and Negative outputs that goes to the control boards Hotbed outputs.
The board is already connected to the power supply. I just didnt draw that. I also try only use Hotbed output and left the Bed Power empty but this time the heat bed didnt get power. Its a 220v silicone heat bed, i have to use Main Power connections( L and N ) to power it.

GadgetAngel, 2020-01-31:
The back part of the SSR should be a grounding plate. So if the connection on the other side is a Hole use that one. Just because the connection on the side of the AC is an open hole does not mean you should not connect up the ground. Connecting up ground is a safety precaution. If you do not connect ground you do it at your own risk. The SSR will still work with or without ground hooked up. Good luck! Did you try disconnecting the power to the input Power bed and connect up the power to the Board input power only? Did that work?

Sent from my iPhone

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

turnali, 2020-01-31:
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

i tried that but the board didnt heat up the bed

dch1921, 2020-02-01:
You still need to hook up the bed power or you will not power the SSR control. Review the schematic and it will make sense

GadgetAngel, 2020-02-01:
> You still need to hook up the bed power or you will not power the SSR control. Review the schematic and it will make sense

You mean you still have to connect up the input Bed power??? So all the power connection have to be made?? I will look at the schematic tomorrow to see what you are saying

GadgetAngel, 2020-02-01:
@turnali Do you have a 12VDC bed to hook up to the SKR pro just to see if the board can heat a 12V bed. Maybe you have a bad SKR pro board or a bad  SSR

turnali, 2020-02-01:
> @turnali Do you have a 12VDC bed to hook up to the SKR pro just to see if the board can heat a 12V bed?? Maybe you have a bad SKR pro board or a bad SSR.

The board works with a 12V bed i checked that. I also tried the ssr and the bed with a SKR v1.3 board and they work fine as well. Tried another SSR on Pro board but same problem again.
I think its the Pro boards unique bed powering inputs with the SSR is causing the problem. Seperation of the Bed Power and Hot Bed connections on the board might be it. its not working with the SSR.
I even thought it might be a faulty On/Off switch so i cancelled it and connected the Main power(220v) directly to the power supply but didnt work as well.
I sent a message to BigTree but because of the Chinese New Year holiday they hvent answered it yet.

GadgetAngel, 2020-02-01:
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

Did you send a message to BIGTREETECH support via their Facebook page? Please post their response back here because I am planning on powering my bed with AC power and SSR too. I am still testing out my SKR Pro and I am still waiting for parts to test out the SSR configuration. I am testing out the Driver hookup on my board now. I hope BIGTREETECH helps.

turnali, 2020-02-01:
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

I contact BigTree via their Aliexpress store. They respond faster from there.
If they give me a solution for my problem, I will definitely post it here

GadgetAngel, 2020-02-01:
@turnali Did you wire the CLK pin to GND pin on your TMC5160 driver boards?? Here is a .pdf that shows the driver configuration for the SKR Pro board https://doc-0k-c4-docs.googleusercontent.com/docs/securesc/seim4417k8n16rvc6rl28ib17otc3iek/3ohsos0r5999avqtuin34rmgbvo6bq7t/1580551200000/06483777329211841429/05169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

turnali, 2020-02-01:
> @turnali Did you wire the CLK pin to GND pin on your TMC5160 driver boards?? Here is a .pdf that shows the driver configuration for the SKR Pro board https://doc-0k-c4-docs.googleusercontent.com/docs/securesc/seim4417k8n16rvc6rl28ib17otc3iek/3ohsos0r5999avqtuin34rmgbvo6bq7t/1580551200000/06483777329211841429/05169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

I am using TMC2209 V3.0 drivers and your link doesnt open

GadgetAngel, 2020-02-01:
> > @turnali Did you wire the CLK pin to GND pin on your TMC5160 driver boards?? Here is a .pdf that shows the driver configuration for the SKR Pro board
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

Thread 58 (2019-10-11):

SKR Pro v1.1 with A4988

oldman4U, 2019-10-11:
Hi. Hope someone can help me. The board works fine, which mens i can upload new firmware and i can control fans and other hardware devices using PrintRun for Mac. But when i try to control the stepper motor, all i get is a vibrating motor which does not spin. Changing the Vref did not help. The same motor with the same cable works fine using a SKR E3 DIP. I use the fw from this github and changed only the stepper motor section to A4988. Any help would be appreciated. Georg

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

cobrettee, 2019-10-12:
I am having the same issues with my CoreXY build on A4988s and DRV8825s. Everything else about the board works but steppers are a huge problem right now - VREF changes not helping and if I put my ramps card back in the steppers are fine. If it wasn't for the fact that I already order 2209's I would have put the card back in the box and asked for refund. I did get a little further though after several hours testing - if I lower my steps and feed rate to certain values then they actually move albeit incorrect steps - e.g I say move 10mm it moves 100mm. Now you would think simple math would apply and I could adjust my steps and rate accordingly based on that but as soon as I change the values to the correct ones the steppers refuse to move. If I try values in between it makes jerk movements or beeps and sometimes even just goes into kill mode because the stepper sounds like it is trying to move and heats up. Very frustrating to say the least. Is it that maybe we should have a different jumper configuration that actually correctly enables microstepping for these 4988/8825s?

cobrettee, 2019-10-12:
That was it - you have to use the MS1,MS2 and MS3 pins according to your stepping. Works now.

oldman4U, 2019-10-12:
Hello cobrettee.

Thank you for your answer.

According to the data sheet, I have to shorten 1, 2 and 3 to get 16 micro steps.

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

Anyway, I also tried all the other combinations and nothing changed. So you believe switching to 2209 will solve the problem. I tried 2208s from a working SKR E3 DIP and had the same problem, but please let me know in case it makes a difference for you. Finally I believe the board is broken and now I do not know if I should order the same board again or something else. It would be great to know if there is a single user out there, using the SKR v1.1 PRO with A4988 successfully. If so it would be great to know the jumper setting and maybe to get a Firmware file, so I can upload it to my board.

Georg

cobrettee, 2019-10-12:
No I just happened to have ordered 2209s at the same time. There is no reason these 4988/8825s should not work. I can only tell you that I set my jumpers according to what was in the Marlin configuration_adv.h file and now my steppers move and more importantly correctly move. When I say 10mm it moves 10mm as per the calculations for belt driven(xy) and leadscrew(z) driven 1/32 steppings. Did you try the order if looking from right to left at the pins L,L,H?

RudyBenner, 2019-10-13:
Looking at your cable, I would say that you have moved 2 wires incorrectly. The windings as shown are in series which leads to low torque and ambiguous rotation.

RudyBenner, 2019-10-13:
An ohmmeter check at the dupont connector should show continuity between red/blue and green/black but should be open between red/green and black/blue.

oldman4U, 2019-10-13:
Hi corbrettee.

Sorry for the late answer, but weekend is family time, so my hobby has to wait;-)

So you mean you have the dip switches set like this and the adv. config file in Marlin like this and this makes your steppers rotate correctly?

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

Would you be so kind to send me your Marlin files and/or the FIRMWARE.CUR file from your SKR so I can make sure I use absolutely the same setup board and firmware wise. And do you use the cables like shown on my pictures with green and blue twisted or like shown on the picture from Rudy?

Georg

oldman4U, 2019-10-13:
Hi Rudy.

Also a big thank you to you. I started with a cable exactly like shown on your picture, but this did not work at all - also not on the SKR E3 DIP. Then I checked the pins on the motors to see which one belongs to which coil (and also checked the data sheet) and after changing the green and blue wire the motor and the cable works on the E3 DIP and at least it generates the vibes using the v1.1 Pro. But what I really learned the last few weeks is, that there is always a little surprise waiting for you around the next corner;-) So I will test it again and let you know.
Georg

RudyBenner, 2019-10-13:
Do the ohmmeter checks, and verify the pinouts on the board.

cobrettee, 2019-10-13:
Hi Georg...my DRV8825's are working - I had some time this morning so I also tested with working A4988s(from another printer) and I am seeing same behavior you see. No matter what settings I choose the A4988s won't turn the motors and it is not a motor wiring issue at least for me since I am using the 8825s with no issue. You can also do a simple led test to confirm you have the correct pairings.

oldman4U, 2019-10-13:
Hi Rudy.

Twisting the cable I get most of the time no sound and no vibration and sometimes a bit of one or the other;-(

I will do more multimeterwork as soon as I have the time to do so, but so far I trusted the documentations.... Maybe I should stop doing so.

Thank you again

oldman4U, 2019-10-13:
Hi cobrettee.

AH, you are using a different driver and this works, but not the A4988. Slowly it makes sense to me that the support does not answer any more. Thank you for the time you spent to verify my problem. May I ask you which 2209s you ordered? I would then order the same and we could work on the firmware together - if it is ok for you. The amount of time I spent to try to make it work is nothing compared to the costs of new drivers.

RudyBenner, 2019-10-13:
I may have confused the issue, if so, I apologize.

cobrettee, 2019-10-13:
Sure - they should be delivered next week [https://www.aliexpress.com/item/33028054557.html?spm=a2g0s.9042311.0.0.23de4c4dpthCwf](url)

When I have more time I may take another stab at the 4988's and will let you know if any success.

oldman4U, 2019-10-13:
;-)

Nothing to worry. Double check can never be wrong.

Georg

Rudolf Benner <notifications@github.com> schrieb am So. 13. Okt. 2019 um
20:47:

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

oldman4U, 2019-10-14:
Hi cobrettee.

I ordered the same, thank you.

Rudy.
I tested the connectors on the board and the connectors at the motor and the two middle wired has to be twisted. A is 1 and 4, B is 3 and 6. Thank you again for the input.

Georg

RudyBenner, 2019-10-14:
Can you close this?

oldman4U, 2019-10-15:
Hi Rudy.

Unfortunately not.

So far we can exclude almost 100% that the problem is not the motor or the cable to the motor and I would say after days testing and searching - the problem also does not sit in front of the computer.

On the other hand we have 2 independent systems with the same issue and the two manufacturers most likely responsible for the issue do not care.

I would like to keep this ticket opened until it is solved or at least to tell others to look for another solution.

In case there is someone out there using the SKR v1.1 PRO mainboard successfully with the A4988 motor driver it would be great to let me know. So far we haven't heard from a single user.

It would be great if I would be able to close this ticket soon and I will do so, once the issue is solved.

Thank you

Georg

RudyBenner, 2019-10-15:
**_* A4988 is assumed for unspecified drivers._**
 *
//#define X_DRIVER_TYPE  A4988
//#define Y_DRIVER_TYPE  A4988
//#define Z_DRIVER_TYPE  A4988
//#define X2_DRIVER_TYPE A4988
//#define Y2_DRIVER_TYPE A4988
//#define Z2_DRIVER_TYPE A4988
//#define Z3_DRIVER_TYPE A4988
//#define E0_DRIVER_TYPE A4988
//#define E1_DRIVER_TYPE A4988
//#define E2_DRIVER_TYPE A4988
//#define E3_DRIVER_TYPE A4988
//#define E4_DRIVER_TYPE A4988
//#define E5_DRIVER_TYPE A4988

**_Leave them all undefined, A4988 is the default. It's worth a try._**

RudyBenner, 2019-10-15:
also E0 is the first extruder, you have E0, E1, E2.

DJKyomi, 2019-10-21:
Hello,
Looking for a more modern board I found this picture, can it be due to that?
https://cdn.shopify.com/s/files/1/1619/4791/files/BIGTREETECH-SKR-PRO-V11_09.jpg?v=1561201378

oldman4U, 2019-10-22:
Hello DJKyomi.

Thank you for your input. Using the A4988 with the SKR v1.1 PRO the jumper to connect the RST and SLP has to be set plus the jumpers for MS1 - MS3 depending on the number of micro steps you want to use. You can see in the first and the last picture i have sent, that the jumper you mentioned is always set, but with different settings for the micro steps. So according to the description from BTT, this should be fine.

In the meantime i ordered a new SKR v1.1 PRO as well as 2209 drivers to see if i can get this baby work somehow. I also got some help from tech support, but nothing since one week. Its strange.

Regards

Georg

oldman4U, 2019-10-30:
Hi cobrettee.

Have you got your TMC2209 in the meantime?

I got mine today and after approximately 10 minutes, a basic test with a single stepper driver and motor has been made successfully. This is exactly how I would have been expecting it also with the A4988....

For me it seems to be more and more that the SKR Pro v1.1 is sold with A4988, but that this combination of board, driver an software simply does not work.

Please let me know

Thank you

Georg

cobrettee, 2019-10-31:
yes got mine a week ago and they have been working very well. I simply won't bother with the A4988s any longer but it should be fixed for others. I think they assume if you are going with this board you are going with better steppers as it is the "pro" version so won't be to eager to fix it.

oldman4U, 2019-10-31:
Hi.

Thank you for the update. For me it is fine as it is, now that i have a working solution. But how can we inform others to avoid this combination? I think it is enough that i wasted my time.

rflulling, 2019-11-29:
Hello all. I understand this is an old post. But it's been left open. I noticed some work being done By BTT on several new revisions of default firmware configurations, since the onboard SD card has been made to work for them. I am a user. I have direct experience with this setup. I have since moved to ST820, and plan to change to Trinamic later.

So. 1st thing. A4988 works just fine with the SKR PRO 1.1 and Marlin 2.0.x

2nd. A) Jumpers are not the same pattern as with other Drivers and no assumptions can be made. I generated a informative PDF to help users with Jumper configurations for SKR PRO. But even this should not be taken as absolute. Please for sure compare notes with the ACTUAL manufacturer of your driver. Not just one that makes the same chip. It matters! B) The A4988 are not well suited to all motors. Check the math. Check the specifications for the driver and the Motor to be sure that the driver can handle it. It is possible to make a motor run that the driver doesn't like and this will cause the driver, or motor, or both to get very hot. A well configured combination might get warm, but not hot. Other drivers will get very hot no mater what. C) Check the specifications for the the driver and chosen motor make sure the wires match correctly.

3rd. Once your jumpers are configured then you need to either manually do the math and calibrate the POT on the driver, one at a time or set each one slightly clock wise. That is if you note that there is a max left and max right. Set the POT to dead center between those points. This may even have been done for you by factory. Now turn it slightly to the right. This should be good for testing.

4rth. Some defaults for A4988 from Configuration.h
It is more than probably that one or more of these may need to be tweaked for your setup.
Bear in mind too. I am not sampling End stop defines or config. But having that set wrong may literally deny you ability to move an axis, even if you have the right motor driver config. So check your work. You will need to configure your motion yourself. Jerk, acceleration, max speed can come later but do require tweaking.
#define X_ENABLE_ON 0
#define Y_ENABLE_ON 0
#define Z_ENABLE_ON 0
#define E_ENABLE_ON 0 // For all extruders
#define INVERT_X_DIR false
#define INVERT_Y_DIR false
#define INVERT_Z_DIR true
#define INVERT_E0_DIR false
#define INVERT_E1_DIR false
#define INVERT_E2_DIR false
#define INVERT_E3_DIR false
#define INVERT_E4_DIR false
#define INVERT_E5_DIR false

5th. Configuration.adv defaults
#define AXIS_RELATIVE_MODES { false, false, false, false }
#define INVERT_X_STEP_PIN false
#define INVERT_Y_STEP_PIN false
#define INVERT_Z_STEP_PIN false
#define INVERT_E_STEP_PIN false

6th. I have never seen the options for setting microstep from the firmware do any good. Simpler to leave it disabled. So as to not complicate setup, introduce over ride or bugs.

7) When you have a good compile and the firmware is saved to the SD card, and the printer is reset.
You can try to move an axis.

8) To set the POT you can configure on the fly with a small screw driver. But it is recommended to do this only with a ceramic tool. Because the risk of touching anything else is very high and this can damage the chip, or power regulators by shorting VSS to ground.

9) If you try to move the motor and it's very noisy, or shudders. A) Check the pins on the cable and make sure they are configured correctly to the motor. B) If you can be 100% certain the wires and jumpers are right. (this is kind of a big deal, do your homework). Then you can consider adjusting the POT further. C) from the LCD send the motor in a direction where it has some room to travel and the firmware is willing to let you do this. Say 50 to 100mm. Now adjust the POT slightly until the motion is smooth. It is very unlikely that you will need to adjust much at all. If you have to rotate more the 1/4 turn its likely that some thing is very wrong in your hardware setup, likely the motor, the jumpers, cables, or even your chosen DEFAULT_AXIS_STEPS_PER_UNIT.

oldman4U, 2019-11-29:
Hello rflulling.

THANK YOU for your help and all the time you spent to answer this ticket.

Could you please send me a picture of the jumper setup of your SKR Pro v1.1 using an A4988 successfully as well as the FIRMWARE.CUR file of your machine, so i can do another test.

It is not that the motors need a bit of adjustment when using A4988, but they do not move at all or only piep a bit. 2 different motors with the same cables work fine with the original Ender-3 mainboard which has A4988 on board as far as i know, work fine with the SKR E3 DIP with 2208, 2209 and also work fine with the SKR Pro v1.1 using 2208 or 2209. In the meantime i am able to use 2209 based sensorless homing, using the same motor/cable combination. I believe they are fine. In general, everything works fine, as long as i do not combine the Pro v.1.1 with the A4988 and i am not the only one who is not able to get it work.

So in case you use this combination successfully, i am more than willing to test it again and to close the ticket, the same time it works. Otherwise i think it would be important to let the others know, that this combination does not work, so i would like to keep this ticket opened.

Kind regards

rflulling, 2019-11-29:
Attached are the jumper config I meant to attache to the last.

*I will have to double check on the Compiled firmware.* This one, although
I have a running record of every compile done. They are the Folders and in
the begging for the SKR PRO most were hybrid A4988 + ST820. My X Axis, and
Z if I recall were both A4988. That is because the ST820 have been
unpopular and they only sell them in 4 packs... So I had to order a total
of 8 for my 6 seats, and the second batch came later. I upgraded from an
MKS 1.4 to the SKR PRO, and the MKS was 5 slots of A4988.

*I am also not sure if it is legal for me to just distribute a compiled
firmware* as apposed to the "configuration" files. I have not read the
various legal documents well enough.

I will venture that two distinct advantages of the A4988 over the ST820.
Quieter, and generate less heat.

The ST820 driver do everything in backwards world. So they spend more time
on than off, and every setting in Marlin for this driver must be reversed
to a mirror of what the A4988 are set.

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

oldman4U, 2019-12-02:
Hello rflulling.

Unfortunately there is still nothing attached, at least i can not see it.

I spent several weeks of my time to try to get this to work, so i would need pictures and a firmware which makes the SKR Pro v1.1 work with the  A4988 drivers. Once i have both, i will test it again. Until then i will enjoy my SKR Pro v1.1 with the 2209's which are working very very nice without spending days and weeks to get them to work.

Thank you

Georg

rflulling, 2019-12-07:
[driver seat pins SKR PRO.pdf](https://github.com/bigtreetech/BIGTREETECH-SKR-PRO-V1.1/files/3935226/driver.seat.pins.SKR.PRO.pdf)

Not sure how its been over looked. I know it was attached. Sorry it did not get through. Hope this helps. Will try to get time to offer better this weekend. Sorry been very busy with job. 9-8 and fighting to get my dual extruder behaving the way I need.

oldman4U, 2019-12-07:
Hi.

No hurry, but the pdf is 6 empty pages.

rflulling, 2019-12-07:
Ack....

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

rflulling, 2019-12-07:
Ok, this one works... sorry for the trouble. Realy I am.

https://drive.google.com/file/d/1CR7NcZsWs012gB1fWaCSrZSwWh_6bvzq/view?usp=drivesdk

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

oldman4U, 2019-12-09:
Hello rflulling.

No reason to be sorry, you try to help and that's great, thank you.

The pdf is a great summary of all driver related options for the SKR Pro, but the information is not new to me. In addition to all the options you listed i also tried all settings without the jumper shortening STEP and DIR, i tried different cables, motors, even different Marlin settings and this over several weeks, spending all my spare time. So in case you have an SKR Pro v1.1 with A4988 successfully working on your side, please send me also the firmware. Otherwise there is no reason for me to believe that repeating a test which i have already done several times will result in something different. In the meantime i use this board without any problem with 2209's and i also ordered a new SKR Pro v1.1 which i will use for additional tests to make sure that it is not the current board which has a problem with this particular driver.

Until then i must expect that this combination simply does not work. Even more, because there is at least another user with the same issue and so far not a single user using exactly this combination (SKR Pro v1.1, A4988 driver with Marlin v2) successfully.

Kind regards

keyser187, 2019-12-16:
i have the exact same problem. has anyone got this working yet?

DJKyomi, 2019-12-16:
Ich hätte eine Idee, aber ich kann sie nicht testen.
Am Ramps 1.6 Plus muss man bei den A4988 und DRV8825 die Pins SLP und RST verlöten. vielleicht löst das auch Eurer Problem ?
scroll down on the page

https://www.biqu.equipment/products/biqu-3d-printer-parts-ramps-1-6-plus-upgrade-from

oldman4U, 2019-12-16:
Hi.

Unfortunately we have 3 users where this combination does not work and so far not a single user using the A4988 successfully on the SKR Pro v1.1.

On the SKR Pro v1.1 you have to set a jumper to connect SLP and RST and at least I did it exactly like this.

Thank you DJKyomi for trying to help.

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

keyser187, 2019-12-16:
im following the same guide and the pics you posted, as i say, i get no movement just a very hot driver. even tried it with just the one jumper as in the guide but nothing.  i cant afford new stepper drivers after buying the fricking board! so would really like to get this to work (and its my BD 2mora :$  ) im still waiting for a reply to my email from bigtree support. if i hear anything new ill let you know

rflulling, 2019-12-16:
I cannot upload a fully compiled firmware. Doing so puts me in a vendor
position where by the terms of the contract we all agree to, knowingly or
not, I become liable to you for updates. Thats not going to happen. I can
however offer copies of my config, so long as you know and understand that
it is NOT currently configured for your machine. I did reconfigure an older
mixed file. That was set up to run both A4988, and ST820. FYI they are
mostly the same thing but the ST820 operates 100% inverse the A4988 in
every possible way. Anyway I test compiled that build several times with
100% success. If not being advised to liability of vendor status, I would
have already offered that compile. I also know that when I grabbed the a
copy of Marlin from BTT for the SKR PRO and merged it with my MKS 1.4 the
only issues, were my own.

The Only thing I have not done, is to switch out the Drivers on my PCB for
a test. This I think I can do today, snow day... Probably a good time to
grab the current and OFFICIAL release version of Marlin 2.0. I think I will
generate two branches. One for the ST820 and one for the A4988. I will take
the time to test both flavors. I can and will offer a zip folder with the
Configuration used. Its high time I official mount the SKR PRO anyway. It's
been floating on a billing envelope to keep it from touching the Heat syncs
on the A4988 standing on the MKS 1.4 behind it...

I think perhaps you might take this complaint over to the actual
conversation on Marlin.

BigTree listens but for sure picks and chooses who to listen and reply too.
Getting a reply from BTT is very unlikely, unless they believe you have an
actual issue.
So maintaining this topic here is a bit like shouting in frustration to the
coats on a closet. Sometimes the other tenants in the building show back,
but that's about the best you can hope for.

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

oldman4U, 2019-12-16:
Helle rflulling.

Thank you for Your continuous support.

Seems you are the only one able to make this combination of drivers and
boards work. So please provide a firmware OR the config files and a picture
of your board showing the jumper setting and i will give it another try.
This issue is now the one with the most replies. It would be great to be
able to say - now it works and here is what you have to do to make it work
and to close it the same time.

rflulling <notifications@github.com> schrieb am Mo. 16. Dez. 2019 um 22:49:

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

Thread 60 (2019-10-16):

How to connect a 12v auto leveling sensor

mooner1022, 2019-10-16:
I have a auto leveling sensor which uses 6V~36V(rated voltage of 12V) and I have no idea how to connect this sensor on the SKR PRO. It worked with 5v on my old Anet board, but It doesn't turn on on this board's 5v power.

mooner1022, 2019-10-19:
Solved it by adding a npn transistor for switching

sneakym8, 2020-01-10:
I think you could also wire it to 12v on the motherboard to get full sensitivity and then wire the signal through a potential divider to the input.
or even if you are good with your maths , through a current limiting resister.

Mariu86, 2020-02-06:
Hello @mooner1022  can you please tell me if you used the limit switch pins or the Bltouch pins ?

mooner1022, 2020-02-07:
> Hello @mooner1022 can you please tell me if you used the limit switch pins or the Bltouch pins ?

I used limit swich pins and 12v output pin.

Mariu86, 2020-02-07:
But the pin from the limit switch it's 5v tolerant I think, how do you put 12v in there? I have an induction sensor and tmc2209, but I can not get the sensor to work. if I put a mechanic switch and i desolder the diag pin form tmc2209 the mechanical switch it's working, but the induction sensor it's not working. Sorry for my bad English.

mooner1022, 2020-02-07:
> But the pin from the limit switch it's 5v tolerant I think, how do you put 12v in there? I have an induction sensor and tmc2209, but I can not get the sensor to work. if I put a mechanic switch and i desolder the diag pin form tmc2209 the mechanical switch it's working, but the induction sensor it's not working. Sorry for my bad English.

Your english is good bro :)
I plugged my sensor to 12v out pin and a npn transistor(in my case, 2n3904 worked.) to the limit switch pin. When the sensor on 12v triggers, it turns on the transistor and the board recognizes the triggered sensor. If you have something more to ask, feel free to ask any time :D

Mariu86, 2020-02-07:
@mooner1022 sorry but I don't have so much experience with npn transistors , can you be more explicit how do you do it please! From what pin do you take the 12v? And do you connect the signal pin to the PG8 pin? What settings do yo do In Marlin ? My old board is a MKS gen L 1.0 and the sensor was connected to the z- limit switch and I checked the pin configuration and I have the same configuration like the skr pro the only diference is the voltage in the skr pro we have the 3.3v and the MKS has 5v. Today I was looking in the marlin pin configuration for skr pro and I see mention the PA2 pin for probing.
// Z Probe must be this pins
#ifndef Z_MIN_PROBE_PIN
  #define Z_MIN_PROBE_PIN  PA2
#endif
I will try tomorrow to use the Bltouch pins 5v, ground and PA2 to see if it's working. Thanks

mooner1022, 2020-02-09:
@Mariu86 Sorry for the late reply, my alarm for github didn't work. I'll show you my board settings when I go home. I think I'll be able to show you in 2~3 hours.

mooner1022, 2020-02-09:
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

This is the  schematic of my circuit. (Sry for the bad visibility of the circuit. I'm not good at drawing things D:) I didn't change any firmware things, just attatched this circuit to the board and sensor. I don't know if I'm explaining it well, so ask me if you have something not understanding.

GadgetAngel, 2020-02-09:
@mooner1022 Here is a nice write up. Just change the resistor across the sense pin for 3.3 V logic instead of 5V logic. https://mertarauh.com/2017/01/18/dont-trust-the-internet-and-how-to-add-an-inductive-proximity-sensor-to-your-3d-printer-the-proper-and-easiest-way/

mooner1022, 2020-02-09:
> @mooner1022 Here is a nice write up. Just change the resistor across the sense pin for 3.3 V logic instead of 5V logic. https://mertarauh.com/2017/01/18/dont-trust-the-internet-and-how-to-add-an-inductive-proximity-sensor-to-your-3d-printer-the-proper-and-easiest-way/

Thx for telling a way simpler way!

Mariu86, 2020-02-09:
Thanks, for all the info I will measure the output signal of the sensor and I will see what's the voltage to see if it's to low . I have been trying to use the Bltouch pins but i don't have a complete success yet , the PA2 pin it's not trigger, I try different settings in the Marlin but maybe I do something wrong. Latter I tried to use the 5v pin and ground from the Bltouch pins and the signal pin from the z-pin I bend the diag pin form tmc2209 and the inductiv sensor it's working. I will try to see what it's the problem with Bltouch signal pin. Can you share the config.h and and adv.h files ?

GadgetAngel, 2020-02-10:
@Mariu86 i am still testing my SKR PRO board and writing a manual on how to do the Stepper Diver Configurations for the SKR PRO (now over 70 pages long). I plan on putting a BLtouch and or a TH3D inductive sensor onto my printer but I have not got that far yet. When I do, if someone else has not posted the files, I will post mine here

Mariu86, 2020-02-10:
I tested the inductiv sensor but I don't have any success on the PA2 pin ! I tried every setting in the marlin but I don know what's the problem, I'm not a expert but I don't understand whats the problem, if anybody has a config file using the PA2 pin for probing will be very useful for me ! Thanks

mooner1022, 2020-02-10:
> I tested the inductiv sensor but I don't have any success on the PA2 pin ! I tried every setting in the marlin but I don know what's the problem, I'm not a expert but I don't understand whats the problem, if anybody has a config file using the PA2 pin for probing will be very useful for me ! Thanks

[Marlin.zip](https://github.com/bigtreetech/BIGTREETECH-SKR-PRO-V1.1/files/4180640/Marlin.zip)
Here's my configuration.h and adv.

Mariu86, 2020-02-13:
Thanks for all the help , I manage to use the PA2 pin for inductiv sensor but i must use the limit switch for z min, I do the homing with limit switch and UBL leveling with inductiv sensor .

Thread 61 (2019-10-17):

PC9 not PWM-capable - but it should

Haschtl, 2019-10-17:
The PC9 pin is a PWM-pin.

In buildroot\share\PlatformIO\variants\BIGTREE_GENERIC_STM32F407_5X\PeripheralPins.c I commented the I2C usage of PC9 and uncommented the PC9 definition for TIM8_CH4 (which isn't used by any other pin). But anyway the behavior of the pin is not as expected.

I connected a mosfet+fan to PC9. If I enable the fan, it runs immediatly at fullspeed and if i turn the fan off, it remains running.

The STM32F4 is a good microcontroller with a lot IO. But why are a lot of PWM-pins not available onboard (PB11, PB5, PB4, PA11, PA10, PA9, PA7, PA6, PA5) ? The only PWM-pins on the two extension-blocks are PF8, PF9. PF7 shares its TIMER with the Z_CS_PIN and is not useable for PWM.

So in the end, if you want to connect an LED and a LASER to the two additional PWM-pins you cannot connect any other PWM-device. Am i right? (I'm using the E2_STEP_PIN PD13 as I do not have 3 extruders)

omahena, 2019-10-18:
The PeripheralPins.c has been the focus of my attempts to get the SD card working and to remove a weird "entanglement" between the HEAT0 (PB1) and HEAT1 (PD14) pins. On a single extruder system they are always blinking in unison - as soon as the HEAT0 starts to be driven by Marlin, both LEDs for HEAT0 and HEAT1 are blinking as one.

The changes you did agree with my understanding of the file. Also I share your sentiments about the board. The support for it sucks. Only the absolutely basic single extruder Marlin based 3D printer system seems to have been (sloppily) tested... And the EXT1 and EXT2 headers leave a lot to be desired. I think they didn't expose other GPIO pins on the board to not make it too crowded with pin headers. Also the board would probably benefit from a different version of the MCU with more pins to reduce some of the collisions of alternate PIN usage.

The behavior of the PC9 pin you describe is a little surprising to me as well. I see PC8 shares TIM8 (FAN0) with PC9, but from the MCU documentation I think that should be OK as the timer offers 4 independent channels...

I see some MOSFETs also have a max input frequency. Only 44kHz in this case:
[MOSFET module](https://www.aliexpress.com/item/32950922168.html)

Now what also surprised me during testing and cleanup of this file, is that after I removed all the conflicting definitions the PB1 - PD14 entanglement remained. Next to do a sanity check, I removed the PWM definition for one of the used pins (it might have been PB1 for the heater0) and Marlin still compiled and worked without and issues. At that point I decided that I have more important stuff to do and aborted the endeavor.

The PeripheralPins.c code definitely gets compiled, but I cannot say how, where or if it gets used. :/

Haschtl, 2019-10-18:
Strange behavor of heater0 and 1.
Luckily I have two hotends connected and do not need to face this issue.

I must say, i really use a lot of the pins from this board and now everything is working. But the pins are indeed a bit confusing and there exists no documentation of how they are configured.

I think Marlin doesnt check if the pins are pwm-pins. Only for the Laser-PWM pin. But also there are some precompiler problems in marlin for stm32 boards, thats why i needed to disable the PWM check manually to use the laser.

I also saw that this file gets compiled. Maybe i will clear the file completely and check if marlin can still be compiled. Then these definitions are somehow redundant in another place

Haschtl, 2019-11-26:
I will close this, as some time has passed and i dont know if this problem still exists as i'm using a different pin

Closed 2019-11-26.

Thread 64 (2019-10-27):

Activate StealthChop with TMC2209

curvi, 2019-10-27:
I am compiling for my new SKR Pro v1.1 board, which by now does not have any motors attached, but I have drivers for X,Y,Z,E0 installed. I've plugged the 4 TMC 2209 drivers, with cut Stallguard pins, into the headers and put in the UART jumpers.
I activated `#define MONITOR_DRIVER_STATUS` and `#define TMC_DEBUG`.
I compiled the code and put the firmware.bin alongside the FIRMWARE.cur on the sd card and it runs. I can change the maximum current per driver, as I see using a M122 commad via pronterface. However the full response is:

```
M122
SENDING:M122
		X	Y	Z	E
Address		0	0	0	0
Enabled		false	false	false	false
Set current	780	780	780	950
RMS current	1381	1381	1381	939
MAX current	1947	1947	1947	1324
Run current	24/31	24/31	24/31	16/31
Hold current	12/31	12/31	12/31	8/31
CS actual	0/31	0/31	0/31	0/31
PWM scale	0	0	0	0
vsense		0=.325	0=.325	0=.325	0=.325
stealthChop	false	false	false	false
msteps		256	256	256	256
tstep		0	0	0	0
pwm
threshold
[mm/s]
OT prewarn	false	false	false	false
OT prewarn has
been triggered	false	false	false	false
off time	0	0	0	0
blank time	16	16	16	16
hysteresis
-end		-3	-3	-3	-3
-start		1	1	1	1
Stallguard thrs	0	0	0	0
DRVSTATUS	X	Y	Z	E
stst
olb
ola
s2gb
s2ga
otpw
ot
157C
150C
143C
120C
s2vsa
s2vsb
Driver registers:
		X	0x00:00:00:00	 Bad response!
		Y	0x00:00:00:00	 Bad response!
		Z	0x00:00:00:00	 Bad response!
		E	0x00:00:00:00	 Bad response!
Testing X connection... Error: All LOW
Testing Y connection... Error: All LOW
Testing Z connection... Error: All LOW
Testing E connection... Error: All LOW
```
The connection is ALL LOW, sure, because no motor is attached and I'm running on USB power. But stealthChop is false for all axes. Is this a expected response? I can change the set current individually, but not this entry!

I also tried
```
#define STEALTHCHOP_XY
#define STEALTHCHOP_Z
//#define STEALTHCHOP_E
```
and still, all responses are false.
The expected response would be a driver register code and stealthchop for the specified axes.
Am I doing something wrong?
I've attached the
[configuration.zip](https://github.com/bigtreetech/BIGTREETECH-SKR-PRO-V1.1/files/3776047/configuration.zip)

AnyM2k, 2019-10-29:
USB is wrong. Connect 12-24V(to motors too). Read more info. 2209 soldered ? RX-TX ?

Closed 2019-11-10.

Thread 66 (2019-10-28):

Current Marlin 2.0 Fails to Compile with TMCStepper 0.5.2 and STM32 5.7.0

DroneMang, 2019-10-28:
Hi,

I am trying to get the most current Marlin 2.0 working from the official Marlin 2.0 page.  The main issue seems to be that the newest TMCStepper 0.5.2 and STM32 5.7.0 do not work together and SoftwareSerial.cpp references need to be taken out because the newest STM32 5.7.0 already has SoftwareSerial built-in.  Some are using STM32 5.6.0 and TMCStepper 0.5.1 to compile but there are still errors.

Below are some applicable pages:
https://github.com/MarlinFirmware/Marlin/pull/15655
https://github.com/MarlinFirmware/Marlin/issues/15538
https://github.com/MarlinFirmware/Marlin/issues/15496

From this page https://github.com/MarlinFirmware/Marlin/pull/15530, it seems that official Marlin 2.0 will not include the version of TMCStepper hosted here at https://github.com/bigtreetech/TMCStepper

Would it be possible for someone from Bigtreetech to try to work on these issues as well? Thank you.

bidmangler, 2019-11-06:
Seconded from me. I get the same errors when trying to compile the latest Marlin - and don't have the skills to fix the SoftwareSerial.cpp references.

Please could @bigtreetech please give us an update?

Haschtl, 2019-11-06:
I can now compile with the latest TMCStepper library due to this pullrequest: https://github.com/MarlinFirmware/Marlin/pull/15796

SoftwareSerial is taken from another repository.
Check if this fixes your problem, too.

sjasonsmith, 2019-11-06:
The SoftwareSerial in STM32 5.7 is broken, at least for half-duplex stepper communication. The issues are fixed, but are not yet released.

You should probably continue to use STM32 5.6 for now, if you need SoftwareSerial. You can then use whatever worked for you before, such as the BTT version of TMCStepper

> I can now compile with the latest TMCStepper library due to this pullrequest: [MarlinFirmware/Marlin#15796](https://github.com/MarlinFirmware/Marlin/pull/15796)

That change was specific to the SKR Pro, which still uses STM32 5.6. The fork of SoftwareSerialM I created is not compatible with STM32 5.7. It is only intended as a very temporary solution while @LinoBarreca finishes the changes needed to mode the SKR Pro to STM32 5.7.

I intend to go back and try building and figure out solutions for my SKR E3 DIP/Mini boards, but I am still actively working on SKR Pro issues.

LinoBarreca, 2019-11-07:
@DroneMang if you have TMC2209 you can actually pull [this](https://github.com/MarlinFirmware/Marlin/pull/15655) which should be working without issues for you.
Updated to the latestestestest packages available to you or as Jason said stick to the BTT's version.

LinoBarreca, 2019-11-14:
This can be closed. Since it has been solved.

oldman4U, 2020-10-10:
Please help the community and close the ticket once you do not need it anymore. Thank you

Closed 2020-10-10.

Thread 67 (2019-10-29):

Upload firmware via USB port?

Franchelli, 2019-10-29:
Is it possible to load the firmware on the card through the USB socket without using the SD card?
I tried to use Atom and Visual Studio Code but at the end of the compilation there is an error in the loading in the card.
Sorry for my bad English ...

bidmangler, 2019-11-04:
@Franchelli  - As a beginner, it took a while to understand what was in the thread correctly pointed to by @Evg33 - but the simple answer is "No" - it is not possible to upload the firmware through the USB socket yet.

As an owner of a shiny new SKR PRO 1.1 that's been confusing me as well.

LinoBarreca, 2019-11-14:
it should be possible according on how the bootloader is configured.

jgwinner, 2019-12-11:
I took a  look at that thread and offered to help.

I'm working with a CR-10 converted to a "Crearibo", 4 TMC2209's, and 2 TMC2208's, working on dual Z motor (not just split), dual extruder. BLTouch.

        == John ==

oldman4U, 2020-10-10:
Please help the community and close the ticket once you do not need it anymore. Thank you

jgwinner, 2020-10-11:
I could still use it. Swapping SD cards around is a PITA.

oldman4U, 2020-10-11:
Others swap sd cards for being able to print.

This hardware can not do it.

theopensourcerer, 2020-10-11:
There is a suitable bootloader. Not tried it personally but here you go: https://github.com/Arksine/STM32_HID_Bootloader

oldman4U, 2020-10-11:
This is great.

Now we need someone, this feature is important enough, to flash the bootloader and try it out.

👍🏻

i-make-robots, 2021-01-11:
I just started writing code in the hopes of using a skr pro 1.2.  commenting for the day when someone shows how to upload via usb.  until then this board is a no-go for me, and I wish I'd known before buying.

jgwinner, 2021-01-11:
I did the sd card reboot thing a LOT, it does work, but I'll agree it's a PITA.

Other than that, it's a fantastic board.  There are hackery ways to do it; I bought an STM debugger USB connector that'll do it but never got it hooked up. It worked for some people.

        == John ==

frizzle101101, 2021-01-12:
Anyone still looking for a solution to this can use the marlin binary file transfer protocol to upload the firmware.bin through usb to sd card then use m997 to reset the board, where it will then upload the firmware. Enable it in firmware with #BINARY_FILE_TRANSFER

Because the binary file protocol uses the command intefrace one needs to have access to a programatical way of uploading the file where there is a m28 b1 called then the file is written through the command interface.

The best solution i have found to utilize this functionality is the marlinmtb plugin for octoprint...if you dont use octoprint you will need to find another program that utilizes the BINARY_FILE_TRANFER

frizzle101101, 2021-01-12:
Skr pro sd card hosting is not possible in current marlin version 2.0.7.2 , there is an issue with the hardware data mode of the sd card slot that does not allow for the sd card hosting feature when sd card is unmounted from marlin, like when using skr1.3, i will edit this post when i find the git hub issue in marlin where they identified this issue but yea the solution i mentioned above is the best workaround

jgwinner, 2021-01-12:
@frizzle101101 What about the STM debugger add-on boards? Sorry, hope that wasn't vague, I haven't worked on Marlin in months, but I though that was one way to do it. If you don't know what I mean I'll dig up the info. Honestly, I couldn't quite figure out how to attach it, the docs were hard to find.

        == John ==

frizzle101101, 2021-01-12:
Im sure you can go about it that way too if you want, its a direct way to do it from your pc...youd need to locate the rts cts 5v and grnd prins but yea its an f4 so i dont think theres any reason why not, unless bootloaders are locked...but i dont know about that area I've been sd card swapping to load firmware

jgwinner, 2021-01-12:
Thanks @frizzle101101 - your idea of uploading straight to the card, then rebooting is excellent though, I may try that. I have Octoprint on a different printer than my SKR though.

Do you know of any PC programs that will do it? I've looked at a few but like S3D for slicing, so I usually have that connected to the printer. I don't know if it'll do the Marin transfer. I assumed binary was binary.

        == John ==

frizzle101101, 2021-06-14:
I have not found a program to do this but there must be something out there that can use it...maybe pronterface https://github.com/kliment/Printrun project

Thread 69 (2019-11-05):

SPI problem when running Klipper on SKR Pro with TMC5160

Spacemarine2018, 2019-11-05:
The manual does not contain any information on how to wire the TMC5160 V1.2 drivers from BTT to the SKR Pro. Please improve the manual!

I simply plugged the drivers into the SKR Pro without any changes in the jumper configuration, so I have no jumpers underneath the driver and 4 jumpers below the driver on the right side. I can run Klipper and drive my steppers and also set microsteps and current. This means that I can successfully write via SPI. The problem is that I can not read via SPI, I only receive 00000 when doing DUMP_TMC STEPPER=stepper_x

Does anybody else have this problem? Is my wiring wrong?

BastR, 2019-11-07:
I'm running TMC 5160 but with marlin without an issues, simply plug them like TMC2130 but I had to cut a pin like in this issue: https://github.com/MarlinFirmware/Marlin/issues/15296

Spacemarine2018, 2019-11-09:
@BastR Thanks, I tried, but It doesn't make a difference. You are also on SKR Pro and TMC5160 V1.2 from BTT?

BastR, 2019-11-09:
@Spacemarine2018 I've got SKR PRO with TMC5160 from Watterott for X & Y, Z & E are TMC2130.

Spacemarine2018, 2019-11-09:
@BastR

Ok, so my config might need some other tricks. It seems not a lot of people are running this config. I hope someone from BTT will respond.

Baltazart, 2019-11-12:
a link that might interest you,  https://github.com/sky8000/SKR-Pro-TMC5160-Ender-5-Config-Files-Marlin-2

johngianni, 2019-11-12:
@Spacemarine2018 I'm running Klipper with v1.2 5160s with no problems. Attaching my config.
Still working on the LCD, which is not even giving signs of live :)

`stepper_x]
step_pin: PE9
dir_pin: !PF1
enable_pin: !PF2
step_distance: .0125
endstop_pin: PB10
position_endstop: 0
position_max: 300
homing_speed: 100

[stepper_y]
step_pin: PE11
dir_pin: !PE8
enable_pin: !PD7
step_distance: .0125
endstop_pin: PE12
position_endstop: 0
position_max: 300
homing_speed: 100

[stepper_z]
step_pin: PE13
dir_pin: PC2
enable_pin: !PC0
step_distance: .0025
#endstop_pin: PG8
endstop_pin: probe:z_virtual_endstop
position_min: -5
position_max: 400

[extruder]
step_pin: PE14
dir_pin: PA0
enable_pin: !PC3
#step_distance: .002
step_distance: 0.000236
nozzle_diameter: 0.400
filament_diameter: 1.750
heater_pin: PB1 # Heat0
sensor_pin: PF3 # T0 Header
sensor_type: ATC Semitec 104GT-2
control = pid
pid_kp = 16.310
pid_ki = .701
pid_kd = 63.680
min_temp: -100
max_temp: 300
#max_extrude_only_velocity: 35
max_extrude_only_accel: 80
max_extrude_only_distance: 120.0
#max_extrude_cross_section=1.28
pressure_advance: 0.06`

`########################################
# tmc5160 configuration
########################################

[tmc5160 stepper_x]
cs_pin: PA15
spi_bus: spi3a
#diag1_pin: PB10
microsteps: 16
run_current: 0.800
hold_current: 0.500
stealthchop_threshold: 250
sense_resistor = 0.075

[tmc5160 stepper_y]
cs_pin: PB8
spi_bus: spi3a
#diag1_pin: PE12
microsteps: 16
run_current: 0.950
hold_current: 0.7500
stealthchop_threshold: 300
sense_resistor = 0.075

[tmc5160 stepper_z]
cs_pin: PB9
spi_bus: spi3a
#diag1_pin: PG8
microsteps: 16
run_current: 1.100
hold_current: 0.450
stealthchop_threshold: 30
sense_resistor = 0.075

[tmc5160 extruder]
cs_pin: PB3
spi_bus: spi3a
#diag1_pin: PE15
microsteps: 16
run_current: 0.700
hold_current: 0.400
stealthchop_threshold: 5
sense_resistor = 0.075`

oldman4U, 2020-10-10:
Please help the community and close the ticket once you do not need it anymore. Thank you

Spacemarine2018, 2020-10-10:
Has BTT improved the manual? Then it can be closed.

oldman4U, 2020-10-10:
Not sure you know that you as a part of the community can do so.

Spacemarine2018, 2020-10-10:
I know that, thanks. My issue has been solved, but I'd like to point out, that although BTT makes great products, their documentation is really bad.

oldman4U, 2020-10-10:
I agree 100%. But waiting for BTT does not help other users. Giving a bit back by contributing helps.

Thank you for closing this ticket

Closed 2020-10-10.

Thread 70 (2019-11-07):

[No Issue] Alternative Pin Map

EsserPrototyping, 2019-11-07:
This is an alternative graphic for the pins of the SKR PRO 1.1
Maybe bigtreetech want to copy it to the repo.. ?
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

AnHardt, 2019-11-07:
The places for the resistors R61, R65, R67, R69, R70, R71 seem to be not populated on all boards.
(the not populated pads are (in the drawings orientation) near the top and left top of the processor)
They should connect the stepper serial RX and RX pines.
The TX pins PE4, PE2, PE0, PD2, PD0, PD5 do end at the pads for the resistors. They are nor usable for steppers serial connection.

CleoDarius, 2019-11-08:
Just to mention that since many hotbeds have a led to indicating heating is on the reversed labels for HOT BED mean that the LED indicator does not work since the led needs the correct polarity.

EsserPrototyping, 2019-11-08:
@AnHardt thanks for the info! I don´t know much about using uart with drivers. Are the missing resistors leading to a problem, or are the just not needed (because of one wire uart eventually)?
@CleoDarius good point! Didn´t thought about that!

AnHardt, 2019-11-08:
At the current implementations the TX pins are not used - so currently not a problem.
But in the future someone could try to use them - and will wonder why they don't work.
It would be better to not mention them in the drawing, like they don't in the pin-files.

rflulling, 2019-11-08:
We do not all need these pins. But @AnHardt as you say some one might in the future. So I wonder if they CAN be modded by the user and connected as needed. Or if due to enabled features, etc. There is no reason or connecting would be a bad idea. IE this requires a manufacturers revision for full implementation due to other designs?

EsserPrototyping, 2019-11-08:
I added and changed some things.. thanks for the feedback!
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

Pagan-Wizard, 2023-05-12:
Is the endstop pin out for the SKR Pro v1.2 the same as the SKR Pro v1.1?? Specifically, I am asking about voltage, ground, and signal. I am upgrading from a Creality board, and know which wires are which, but I cannot find which pins to plug them into my SKR Pro v1.2. I know where the sockets are on the SKR, but I am asking specifically about the pins within the sockets. The Creality board only uses V and G, but the BTT board uses V, G, and S. I don't have wires for the S, and just want to be sure I am plugging the V and G wires onto the correct pins. I know if I accidentally, or unknowingly, invert them, I can short the mainboard out, so I want to be 110% clear as to where to plug the wires in. Thanks in advance.
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

Thread 71 (2019-11-24):

TMC2209 - E0 - TMC Connection Error

trendelkamp, 2019-11-24:
Hi Guys,

i´am not able to get a TMV 2209 v1.2 from BigTree on E0. Already switched drivers between slots so i can assure that the Hardware Driver is working.
Any Ideas what is the cause for this issue?

M122 state the following

> Send: M122
Recv: 		X	Y	Z	E
Recv: Address		0	0	0	0
Recv: Enabled		false	false	false	false
Recv: Set current	800	800	800	800
Recv: RMS current	795	795	795	1436
Recv: MAX current	1121	1121	1121	2025
Recv: Run current	25/31	25/31	25/31	25/31
Recv: Hold current	12/31	12/31	12/31	12/31
Recv: CS actual	12/31	12/31	12/31	0/31
Recv: PWM scale	14	14	14	0
Recv: vsense		1=.18	1=.18	1=.18	0=.325
Recv: stealthChop	true	true	true	false
Recv: msteps		16	16	16	256
Recv: tstep		max	max	max	0
Recv: pwm
Recv: threshold	98	98	658	4347
Recv: [mm/s]		100	100	3	30
Recv: OT prewarn	false	false	false	false
Recv: OT prewarn has
Recv: been triggered	false	false	false	false
Recv: off time	0	0	0	0
Recv: blank time	24	24	24	16
Recv: hysteresis
Recv: -end		-1	-1	-1	-3
Recv: -start		1	1	1	1
Recv: Stallguard thrs	8	8	0	0
Recv: DRVSTATUS	X	Y	Z	E
Recv: stst		*	*	*
Recv: olb
Recv: ola
Recv: s2gb
Recv: s2ga
Recv: otpw
Recv: ot
Recv: 157C
Recv: 150C
Recv: 143C
Recv: 120C
Recv: s2vsa
Recv: s2vsb
Recv: Driver registers:
Recv: 		X	0xC0:0C:00:00
Recv: 		Y	0xC0:0C:00:00
Recv: 		Z	0xC0:0C:00:00
Recv: 		E	0x00:00:00:00	 Bad response!
Recv:
Recv:
Recv: Testing X connection... OK
Recv: Testing Y connection... OK
Recv: Testing Z connection... OK
Recv: Testing E connection... Error: All LOW
Recv:

>

pins_BTT_SKR_PRO_V1_1.h states the following

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

kamahat, 2019-11-24:
can you post the other files in a pastbin

trendelkamp, 2019-11-25:
For sure:
[platformio.ini](https://pastebin.com/PmVtPdTy)
[Configuration.h](https://pastebin.com/uU05diWe)
[Configuration_adv.h](https://pastebin.com/Fk3scccu)

Also, if i replace the TMC2209 with a LV8729 in E0 everything works fine.

oldman4U, 2019-12-06:
Hi trendelkamp.

This is maybe a stupid question, but have you ever tried to swap the TMC of E0 and E1 to see if the problem moves with driver.

I have a setup with one extruder, but using the same board and TMC. Would it be helpful for you if i provide the config files and/or a compiled firmware.bin?

MikaistPilot, 2019-12-12:
I have the same Problem. I can connect to E0. But as the Printer starts too print i can not connect to E0. XYZ works still fine.

oldman4U, 2019-12-12:
I removed the StallGuard pin for E0 but left it active for the other 3. Have you tried to remove it to see if it solves the problem.

"Can not connect" you mean the E0 stepper motor does not rotate, right? This works on my machine.

MikaistPilot, 2019-12-12:
No the stepper works. Only the Uart connection not. I removed the Stallgard pins. The Uart works when the printer is not printing. As soon as the print starts the connection ist lost for E0 the rest works fine.

kamahat, 2019-12-12:
Dont' you have something connected on the 2nd expansion port ? because PD2 & PD4 are used for the UART of the E0 and PD2 is also connected on the pin 4 on the 2nd expansion port

MikaistPilot, 2019-12-12:
Fixed the Problem. Withe the latest Marlin Bugfix everxthing works fine.

oldman4U, 2019-12-20:
@trendelkamp
Have you also been able to fix the reported issue using the latest version of Marlin? Something i found in your Config file which is probably wrong:
#define TEMP_SENSOR_BED 5
I do not believe this causes your issue, but to be sure...

oldman4U, 2020-02-12:
Hello @trendelkamp.

Could you please let us know if the problem is solved in the meantime. If so, kannst du das Ticket bitte schließen, danke.

battlezone, 2020-04-24:
I am having the same issue but on the X-axis. Switching drivers did not help either. Marlin 2.0.5.1

oldman4U, 2020-06-08:
@thinkyhead (Please close this ticket due to inactivity)

Thank you

thinkyhead, 2020-06-14:
Only @trendelkamp or @bigtreetech can close this issue on their repository.

oldman4U, 2020-06-15:
@thinkyhead

Sorry Scott, this makes sense - my fault. Thank you

@bigtreetech Could you please close this unneeded ticket. Thank you

oldman4U, 2020-10-10:
Please help the community and close the ticket once you do not need it anymore. Thank you

Closed 2020-10-10.

Thread 72 (2019-11-28):

CPU some how is dead. Changed. Board is on but no usb or sd read.

AnyM2k, 2019-11-28:
CPU some how is dead. Changed. Board is on but no usb or sd read.
Any help ? What and how write to new cpu ? Red light is on . Blue light SD card on if connected.
All endstops is on.

Thank you.

holgin, 2019-11-28:
You need to flash the bootloader to the MCU with ST-LINK. Im trying to do it now, I will let you know if I succeed.

AnyM2k, 2019-11-28:
Thank you for quick answer !
May be you have link where to buy and how to use(checked) ?

Thank you very much !

rflulling, 2019-11-29:
do you have the jumper for the USB / 5V power set? Do you have power set right to each of the supply lines? There are 3 supply lines. Plus USB supply if enabled.

Baltazart, 2019-11-29:
If you need a SKR-Pro v1.1 bootloader, there is a dropbox link, bootloader TFT35v3.0 and SKR-Pro v1.1 to load with STM32CubeProgrammer, USB ST LINK v2 on the SWD connector of SKR-PRO .
https://github.com/bigtreetech/BIGTREETECH-TFT35-V3.0/issues/20

AnyM2k, 2019-11-30:
Leds for all 3 power lines on. on usb only 2 on 5V and 3.3V .
Thank you for bootloader ! Ordered ST-Link v2 ... waiting.

holgin, 2019-12-01:
I have used this bootlader and STM32 ST-LINK Utility to upload it and it works, the board is alive :)
[fw_stlink.zip](https://github.com/bigtreetech/BIGTREETECH-SKR-PRO-V1.1/files/3908434/fw_stlink.zip)

AnyM2k, 2020-02-04:
Have st-link V2 on table. At last.
Any idea how to connect it to SKR-Pro-v1.1 ?
Soldering to legs ?  Any other ways ?
Thank you.

AnyM2k, 2020-02-04:
Have some one step by step howto ?
Too many pins , to many errors may occur .

Thank you.

GadgetAngel, 2020-02-07:
Can I use the STM32CubeProgrammer, USB ST LINK v2 on the SWD connector of SKR-PRO to burn a bootloader to the SKR PRO board so I can upload firmware to the board through the USB connection?

Nyxtegida, 2020-02-07:
I received mine with problems, at first it connected to serial but didn't respond to any commands through pronterface. Nor did any difference after trying another firmware in the sd card. Later it didn't even show as a serial but did a read with the st-link. I tried flashing the bootloader from stm32cubeProgrammer, it shown download complete, but didn't confirm the write. After that, reading the mcu gives me full FFFF. Great! XD

AnyM2k, 2020-02-08:
It alive.
Thank you holgin for fw_stlink file. Connect USB ST LINK v2 to SWD connector of SKR-PRO , ignore reset pin. I use STM32 ST-LINK utility. Open fw , write.
Thank you.

Closed 2020-02-08.

Thread 75 (2019-12-08):

Several servomotor and BL-Touch incompatible ?

yopla31, 2019-12-08:
I installed my SKR Pro 1.1 and the probe BL-Touch with "Marlin 2.0 with bug fixes" and TFT3.5 v2.0. It works fine. Note that the probe use the Zmin (PG8) with this commented lines of pins_BIGTREE_SKR_PRO_V1.1.h :
```
//#ifndef Z_MIN_PROBE_PIN
  //#define Z_MIN_PROBE_PIN  PA2
//#endif
```
the PA2 is unused now !
But now I'm trying to declare a servo to drive the change of hotend :
```
#define SERVO0_PIN         PA1  // P0 => BL-Touch
#define SERVO1_PIN         PG5  // P1 => Pour piloter le servo de commande de dual tete
```
The probe does not work, the command M280 P0 Sxxx is interpreted by servomotor, even if I set up another pin. I tried several pins without sucess !
Someone would have tested this configuration? What solution if there is one?
Is there a pin that can be used to drive a servomotor without blocking the probe and how to declare it? (pins tried and KO : PE0, PE2, PE15, PG5, PF7, PC9) :(

yopla31, 2019-12-11:
The solution was found at the firmware level ([Fix multiple servos with STM32 #16151](https://github.com/MarlinFirmware/Marlin/pull/16151)).

dineshvyas, 2020-02-28:
PF8 wokred but motors stopped working.

Closed 2019-12-11.

Thread 76 (2019-12-11):

Stepper Drivers TMC5160 ver1.3 is not working in SPI or URTA Mode on BIGTREETECH-SKR-PRO-V1.1 Board

georgev1456, 2019-12-11:
Bought the BIGTREETECH-SKR-PRO-V1.1 Board w/ TMC5160 ver1.3 Drivers.
I cant get it to work, i have tired everything , switching jumpers in SPI Mode or URTA, edited Marlin the Configuration.h , Configuration_adv.h, platformio.ini  i get problems when i change CS Pins  in the Marlin \src \pins directory file "pins_BTT_SKR_PRO_V1_1.h"  i cant build firmware the error come
on.
 Also i have problem with USB Port , i cant connect it to my computer, I see red light on, but no com port available on my PC .
https://youtu.be/yBzPaFKoo_o

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

i used this manual for steppers.
 https://github.com/bigtreetech/BIGTREETECH-TMC5160-V1.0/blob/master/manual/BIGTREETECH%20TMC5160-V1.0%20manual.pdf

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

NEED HELP......................

oldman4U, 2019-12-12:
Hi george.

I believe you have to use "TMC5160_STANDALONE" with the jumpers set like shown especially on the second picture.

Georg

oldman4U, 2019-12-12:
Sorry, you are using SPI mode, so the jumpers should be fine.....

I write this instead of deleting the message above. Because i use 2209 in UART mode successfully, but had a similar issue using A4988, i believed i could help, but i have no experience with SPI and 5160, so sorry for the confusion.

wesk-ms, 2019-12-17:
Post both of your configuration files and someone might be able to help.

dineshvyas, 2019-12-17:
there are lots of changes to be made. compare my configration_adv.h with yours
[Configuration_adv.zip](https://github.com/bigtreetech/BIGTREETECH-SKR-PRO-V1.1/files/3973672/Configuration_adv.zip)
working configration_adv.h
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

dineshvyas, 2019-12-25:
sorry I did't know it was for TMC5160 v1.3
mine are TMC5160 v1.2

georgev1456, 2019-12-26:
so the problem was in the BIGTREETECH-SKR-PRO-V1.1 board , i have received board replacement , now everything works.
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
[MARLINE CODE FOR TMC5160.zip](https://github.com/bigtreetech/BIGTREETECH-SKR-PRO-V1.1/files/4001516/MARLINE.CODE.FOR.TMC5160.zip)

Closed 2019-12-26.

Thread 79 (2019-12-16):

Temprature Reading Incorrect For Bed and Hotend

MrLAtt, 2019-12-16:
After a few issues, I've managed to get my SKR Pro V1.1 working, but still with one problem.

The temprature reading for both the Heat bed and the Hotend are incorrect, I have selected the correct temp sensor (#5, ATC Semitec 104GT-2) and this setup was working perfectly before on my ramps 1.4 board and reading accurate temps.

The reported temprature never goes below 60*c (as on display and in pronterface) even when both the bed and the hotend are at ambient temprature, but once the temprature reaches 60*c its seems to be reported reasonably accurately (only 5-10*c off, as measuresd with an IR Temp sensor).

I have somewhat been able to solve this problem by adding a 1k resistor between the temprature sense pins and 5v, but it still displays 35*c at ambient, and now my temprature readings at higher tempratures are inacurate.

Has anyone else had this problem?

oldman4U, 2020-06-08:
Hello MrLAtt.

Seems this ticket has not been used for a while, so i ask you to close it.

Thank you

Closed 2020-06-08.

Thread 80 (2019-12-17):

Everything works except extruders

JulianSimpsonWork, 2019-12-17:
I've pretty much got everything working with my custom corexy printer, x/y/dual z homing and bed-leveling with 3d touch, original CR10 display and original MKS TFT35.  I've got TMC2208's in x/y/z/e/e1 with soldered UART pins and TMC status of OK on all.  I've even got an RGB LED ring working on the hot end but for the life of me I cannot get the extruder steppers to do anything at all.  They both worked fine with the old Lerdge board I had and convinced its not hardware.  Hotend gets up to temperature as expected so despite disabling the extrude_when_cold function for testing its still not doing anything, with debug all seems well before and after an extrude even though the motors dont move.  This is the output of M122 with 1 extruder set in Marlin, using latest SKR Marlin rather than new release 2.0

Send: M122
Recv: echo:M122
Recv: 		X	Y	Z	E
Recv: Enabled		false	false	false	false
Recv: Set current	800	800	800	800
Recv: RMS current	795	795	795	795
Recv: MAX current	1121	1121	1121	1121
Recv: Run current	25/31	25/31	25/31	25/31
Recv: Hold current	12/31	12/31	12/31	12/31
Recv: CS actual	12/31	12/31	12/31	12/31
Recv: PWM scale	14	14	14	255
Recv: vsense		1=.18	1=.18	1=.18	1=.18
Recv: stealthChop	true	true	true	true
Recv: msteps		32	32	32	32
Recv: tstep		max	max	max	max
Recv: pwm
Recv: threshold
Recv: [mm/s]
Recv: OT prewarn	false	false	false	false
Recv: OT prewarn has
Recv: been triggered	false	false	false	false
Recv: off time	3	3	3	3
Recv: blank time	24	24	24	24
Recv: hysteresis
Recv: -end		-1	-1	-1	-1
Recv: -start		1	1	1	1
Recv: Stallguard thrs
Recv: DRVSTATUS	X	Y	Z	E
Recv: stst		*	*	*	*
Recv: olb
Recv: ola
Recv: s2gb
Recv: s2ga
Recv: otpw
Recv: ot
Recv: 157C
Recv: 150C
Recv: 143C
Recv: 120C
Recv: s2vsa
Recv: s2vsb
Recv: Driver registers:
Recv: 		X	0xC0:0C:00:00
Recv: 		Y	0xC0:0C:00:00
Recv: 		Z	0xC0:0C:00:00
Recv: 		E	0xC0:0C:00:00
Recv:
Recv:
Recv: Testing X connection... OK
Recv: Testing Y connection... OK
Recv: Testing Z connection... OK
Recv: Testing E connection... OK
Recv: ok

When I run an extrude/retract I get this from debug

Send: G91
Recv: echo:G91
Send: G1 E10 F300
Recv: ok
Recv: echo:G1 E10 F300
Send: G90
Recv: ok
Recv: echo:G90
Recv: ok
[...]
Send: G91
Recv: echo:G91
Send: G1 E-10 F300
Recv: ok
Recv: echo:G1 E-10 F300
Send: G90
Recv: ok
Recv: echo:G90
Recv: ok

Anyone having similar issues, the x/y/z motors are running beautifully (first time using 2208's)

JulianSimpsonWork, 2019-12-17:
[Configuration.h.txt](https://github.com/bigtreetech/BIGTREETECH-SKR-PRO-V1.1/files/3973038/Configuration.h.txt)
[Configuration_adv.h.txt](https://github.com/bigtreetech/BIGTREETECH-SKR-PRO-V1.1/files/3973039/Configuration_adv.h.txt)

JulianSimpsonWork, 2019-12-17:
Just looking in pins_BTT_SKR_PRO_V1.1.h, for the TMC220x we have the definition below but the pins diagram shows the transmits connected to different pins.  My x/y/z do work fine though, just e0/e1 don't move

//
  // Software serial
  //
  #define X_SERIAL_TX_PIN  PC13
  #define X_SERIAL_RX_PIN  PC13

  #define Y_SERIAL_TX_PIN  PE3
  #define Y_SERIAL_RX_PIN  PE3

  #define Z_SERIAL_TX_PIN  PE1
  #define Z_SERIAL_RX_PIN  PE1

  #define E0_SERIAL_TX_PIN PD4
  #define E0_SERIAL_RX_PIN PD4

  #define E1_SERIAL_TX_PIN PD1
  #define E1_SERIAL_RX_PIN PD1

  #define E2_SERIAL_TX_PIN PD6
  #define E2_SERIAL_RX_PIN PD6

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

JulianSimpsonWork, 2019-12-17:
I can confirm the original is correct, I lose comms completely if I change these

JulianSimpsonWork, 2019-12-18:
I've found the problem was with some shorty stepper cables I think have had wires swapped.  My configuration also has the speed of the steppers set too slow and when it did work it was difficult to tell they were turning.

Closed 2019-12-18.

Thread 82 (2019-12-19):

Power selection pins details

frizzle101101, 2019-12-19:
I do not understand why there are 2 jumper pins on the board for the usb host power selection when in the schematics https://github.com/bigtreetech/BIGTREETECH-SKR-PRO-V1.1/blob/master/Schematic/SKR-PRO-V1.1%EF%BC%88SCH%EF%BC%89.pdf they only describe a 3 pin header so why is there 2 jumpers or why is it a 6 pin header, what are the pins not described.

AnHardt, 2019-12-19:
Are you sure you are looking at the `power-select-jumper` J2 and not on the `USB-slave/host-jumper` J49 ?

frizzle101101, 2019-12-19:
What is the usb disk...why does the board power off usb only with the connection to the usb port and not the usb disk

AnHardt, 2019-12-19:
The 6 pin-jumper J49 has nothing to do with power. It switches the 2 USB-data-lines either to the left USB-connector (right from the green terminals) then acting as a USB-slave (connection to the host), or to the right USB-connector (left from the SD-Card-slot) then acting as a USB-host (for example to read a USB-stick (up to now not implemented in software and probably never will be)).
The 3-pin jumper J2 either connects the internal 5V users to the USB-slave plug (only slaves are allowed to pull power - hosts have to source power), or to the onboard power regulator what makes 5V from the external 12-24V connection.
Open your eyes. Everything is in https://github.com/bigtreetech/BIGTREETECH-SKR-PRO-V1.1/blob/master/Schematic/SKR-PRO-V1.1%EF%BC%88SCH%EF%BC%89.pdf. You just have to read it.

frizzle101101, 2019-12-19:
Thanks for pointing out the obvious my eyes are open... how about you
create a schamatic that relates the headers to the physical board before
you accuse ppl of not reading. J49 like comon this is terrible documents if
not explained correctly or printed on the board that way

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

Closed 2019-12-19.

Thread 85 (2019-12-24):

ESP01 WiFi not enabled

akarnaukh, 2019-12-24:
Specified in the firmware serial port 6. But there is a problem, according to the scheme on the connector pins ch_en, RESET, etc. at start on a pin PG0-CH_EN 0, because of what Wifi Does not start. If you give the command M42 P99 S255, which translates this pin to 1, then everything works.
Question 1 - how to do it automatically at start, what to change in Marlin.
Question 2-why did you bring pins to control the Wifi module from the processor?

UnderXirox, 2020-03-10:
Bonjour
pour active le mode wifi sur ma SKR-PRO

voici a tester pour vous aussi
crée un fichier  nome  et le placer avec les fichier avec les fichier

Configuration.h
Configuration_adv.h
and
Configuration_Secure.h

1.  Crée un fichier Configuration_Secure.h
ceci dedans

         /**
          * * To set a default WiFi SSID / Password, create a file called Configuration_Secure.h with
          * * the following defines, customized for your network. This specific file is excluded via
          * * .gitignore to prevent it from accidentally leaking to the public.
          * *
          * *   #define WIFI_SSID "WiFi SSID"
          * *   #define WIFI_PWD  "WiFi Password"
         */
        //#include "Configuration_Secure.h" // External file with WiFi SSID / Password
              #ifndef CONFIGURATION_SECURE_H
                 #define CONFIGURATION_SECURE_H

                #define WIFI_SSID "xxxx-xxx-xxx-xxx"  // votre Mots non du reso wifi
                #define WIFI_PWD  "xxxx-xxxx-xxxx-xxx-xxx-xxx-xxx#" // votre mots de passe wifi
          #endif   //Configuration_Secure.h

2. Activer dans le fichier de configuration de Marlin
 Configuration.h

        /**
           * Select the serial port on the board to use for communication with the host.
           * This allows the connection of wireless adapters (for instance) to non-default port pins.
           * Note: The first serial port (-1 or 0) will always be used by the Arduino bootloader.
           *
            * :[-1, 0, 1, 2, 3, 4, 5, 6, 7]
            */
             #define SERIAL_PORT 6  // pour le Wifi car Carte Buguer (1 for TFT uart)

          /**
             * Select a secondary serial port on the board to use for communication with the host.
             * This allows the connection of wireless adapters (for instance) to non-default port pins.
             * Serial port -1 is the USB emulated serial port, if available.
             *
             * :[-1, 0, 1, 2, 3, 4, 5, 6, 7]
           */
               #define SERIAL_PORT_2 1  // -1 for USB 6 pour esp sur la carte mere
             // Je branche les 3 cable EXP1 EXP2 et l'uart de cette facon je peux basculer entre le mode

               #define BAUDRATE 115200

3. Puis dedans le fichier
Configuration_adv.h

       /**
          * Host Action Commands
          *
          * Define host streamer action commands in compliance with the standard.
          *
          * See https://reprap.org/wiki/G-code#Action_commands
          * Common commands ........ poweroff, pause, paused, resume, resumed, cancel
          * G29_RETRY_AND_RECOVER .. probe_rewipe, probe_failed
          *
          * Some features add reason codes to extend these commands.
          *
          * Host Prompt Support enables Marlin to use the host for user prompts so
         * filament runout and other processes can be managed from the host side.
         */
         #define HOST_ACTION_COMMANDS
              #if ENABLED(HOST_ACTION_COMMANDS)
              //#define HOST_PROMPT_SUPPORT
          #endif

        /**
          * WiFi Support (Espressif ESP32 WiFi)
          */
          // Marlin embedded WiFi managenent
          #define WIFISUPPORT
          // ESP3D Library WiFi management (https://github.com/luc-github/ESP3DLib)
          #define ESP3D_WIFISUPPORT

       #if EITHER(WIFISUPPORT, ESP3D_WIFISUPPORT)
            #define WEBSUPPORT          // Start a webserver (which may include auto-discovery)
            #define OTASUPPORT          // Support over-the-air firmware updates
           //#define WIFI_CUSTOM_COMMAND
          // Accept feature config commands (e.g., WiFi ESP3D)  from  the host

       /**
          * To set a default WiFi SSID / Password, create a file called Configuration_Secure.h with
          * the following defines, customized for your network. This specific file is excluded via
          * .gitignore to prevent it from accidentally leaking to the public.
          *
          *   #define WIFI_SSID "WiFi SSID"
          *   #define WIFI_PWD  "WiFi Password"
          */
          #include "Configuration_Secure.h" // External file with WiFi SSID / Password
       #endif

voila.

PS:  Sans Ca pour moi rien ne fonction pour mon esp-1s  ne fonctionne pas

### et pardon pour ne pas avoir répondue en EN

> Question 2-pourquoi avez-vous apporté des broches pour contrôler le module Wifi à partir du processeur?

Surement pour flache l'esp via la carte SD

Bon Courage.

oldman4U, 2020-06-08:
Hi again.

Same for this ticket. Do you need any further help or can you close it?

Thank you

oldman4U, 2020-06-15:
@bigtreetech Could you please close this unneeded ticket. Thank you

Dosi-Innovate, 2020-07-08:
@UnderXirox thank you. IT WORKED!!! only if i can get the @bigtreetech BTT TFT35 to stop freezing randomly

oldman4U, 2020-10-10:
Please help the community and close the ticket once you do not need it anymore. Thank you

Thread 87 (2019-12-30):

SKR PRO V1.1. TMC2208 not working

Lucano99, 2019-12-30:
Hello,

I am struggling with following issue. I have uploaded a firmware (zip attached). i can connect ot the machine, but I cannot move with steppers. It says all the time: "echo:busy: processing"

I have 5x TMC2208, Dual Z, and 1x Extruder. Would you be please so kind and tell me, where is the issue? :(

Thank you!
[Marlin-2.0-Anycubic-Chiron-master.zip](https://github.com/bigtreetech/BIGTREETECH-SKR-PRO-V1.1/files/4010785/Marlin-2.0-Anycubic-Chiron-master.zip)

Klinenator, 2019-12-30:
I have the same exact issue with 2130 drivers

MacBraky, 2019-12-31:
you don't have any powercables connected to the motor or bed connecter, only to the power!? The pro has separate powerinputs.

JulianSimpsonWork, 2019-12-31:
I can confirm a working 2208 configuration on my pro board.  If Marlin started working with my hotend fan properly then I would have everything working I've tried with so far.  You have soldered the pins on the underside of the 2208 haven't you?  I'd start with MacBraky's suggestion as I've always had power to all three supplies from my initial wiring.

oldman4U, 2020-01-15:
Hi Lucano99.

Have you been able to solve the problem in the meantime?

I got my second Pro yesterday and i have A4988, 2208 and 2209 from BTT available for a test. The 2208 and 2209 worked fine on my test system, but i agree, you will have to connect power to the board first.

On your picture i see two "strange" things. First, you have a stepper motor for E1 but no motor connected and second, you have a white cable connected to the USB Host. What is it good for?

kurtisane, 2020-01-18:
Lucano could you please upload your marlin project folder with firmware.bin. I'm facing issues connecting to my board. Maybe your firmware.bin could help me figure out wether or not my board is bricked.

Skippy1488, 2020-01-20:
Looking at your config.h - TMC2280 is what you have defined. Get that inline and it may work.

oldman4U, 2020-02-12:
Seems @Lucano99 does not respond to this ticket. Would it be possible for an admin to close this ticket, please.

oldman4U, 2020-06-08:
@thinkyhead (Please close this ticket due to inactivity)

Thank you

Skippy1488, 2020-06-08:
If I could close it I probably wood.

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

oldman4U, 2020-06-09:
Well Skippy1488, even you are a good person - for sure, you are not Lucano99 and he/she can close it as you know;-)

I would also close it if i could.....

thinkyhead, 2020-06-14:
Only @Lucano99 or @bigtreetech can close this issue.

oldman4U, 2020-06-15:
@bigtreetech Could you please close this unneeded ticket. Thank you

Thread 88 (2020-01-01):

collect2: error: ld returned 1 exit status *** [.pio/build/BIGTREE_SKR_PRO/firmware.elf] Error 1

John2vdw, 2020-01-01:
Hi,
my SKR pro v1.1 have been working on this code and a week later without changing the code, doing a rebuild before making changes this error came up.
collect2: error: ld returned 1 exit status
*** [.pio/build/BIGTREE_SKR_PRO/firmware.elf] Error 1

I have saved multiple versions of my settings that worked. Non Compile.
My bigtreetech tft35 does compile.
I used Atom and Visualstudio for compiling, same error on both.
I tried to download a new copy of marlin and still not compiling.
Bigtree_skr_Pro FAILED

alma2122, 2020-01-03:
Hello,
got my board today. I have the same problem, also tested with Atom and Visual Studios...

Ausildis, 2020-01-04:
I found a fix:
According to [this](https://github.com/MarlinFirmware/Marlin/commit/04eab3821e6d95fba81970c02b7ba4e7e32bfd9b) I did the following change to the platformio.ini it's somewhere around the line 650

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

alma2122, 2020-01-05:
This is the report i get. I have no problems with other boards like SKR 1.3 ...

Processing BIGTREE_SKR_PRO (platform: ststm32@>=5.7.0; framework: arduino; board: BigTree_SKR_Pro)
------------------------------------------------------------------------------------------------------------------------------------------------------------

Verbose mode can be enabled via `-v, --verbose` option
CONFIGURATION: https://docs.platformio.org/page/boards/ststm32/BigTree_SKR_Pro.html
PLATFORM: ST STM32 6.0.0 > STM32F407ZG (192k RAM. 1024k Flash)
HARDWARE: STM32F407ZGT6 168MHz, 192KB RAM, 1MB Flash
DEBUG: Current (jlink) External (jlink, stlink)
PACKAGES: toolchain-gccarmnoneeabi 1.70201.0 (7.2.1), framework-arduinoststm32 4.10700.200103 (1.7.0)
Converting Marlin.ino
LDF: Library Dependency Finder -> http://bit.ly/configure-pio-ldf
LDF Modes: Finder ~ chain, Compatibility ~ soft
Found 13 compatible libraries
Scanning dependencies...
Dependency Graph
|-- <U8glib-HAL> 0.4.1
|   |-- <Wire> 1.0
|   |-- <SPI> 1.0
|-- <LiquidCrystal> 1.5.0
|   |-- <Wire> 1.0
|-- <TMCStepper> 0.6.1
|   |-- <SPI> 1.0
|-- <Adafruit NeoPixel> 1.3.4
|-- <LiquidTWI2>
|   |-- <Wire> 1.0
|-- <Arduino-L6470> 0.7.0
|-- <SPI> 1.0
|-- <Servo> 1.1.2
|-- <EEPROM> 2.0.1
|-- <IWatchdog> 1.0.0
|-- <Wire> 1.0
Building in release mode
Linking .pio\build\BIGTREE_SKR_PRO\firmware.elf
c:/users/amann/.platformio/packages/toolchain-gccarmnoneeabi/bin/../lib/gcc/arm-none-eabi/7.2.1/../../../../arm-none-eabi/bin/ld.exe: cannot open linker script file stm32f407xg.ld: No such file or directory
collect2.exe: error: ld returned 1 exit status
*** [.pio\build\BIGTREE_SKR_PRO\firmware.elf] Error 1
=============================================================== [FAILED] Took 14.75 seconds ===============================================================

Environment                     Status    Duration
------------------------------  --------  ------------
megaatmega2560                  IGNORED
megaatmega1280                  IGNORED
at90usb1286_cdc                 IGNORED
at90usb1286_dfu                 IGNORED
DUE                             IGNORED
DUE_USB                         IGNORED
DUE_debug                       IGNORED
LPC1768                         IGNORED
LPC1769                         IGNORED
sanguino_atmega644p             IGNORED
sanguino_atmega1284p            IGNORED
melzi                           IGNORED
melzi_optiboot                  IGNORED
rambo                           IGNORED
STM32F103RE                     IGNORED
STM32F103RC_fysetc              IGNORED
STM32F103RC_bigtree             IGNORED
STM32F103RC_bigtree_NOUSB       IGNORED
STM32F103RC_bigtree_512K        IGNORED
STM32F103RC_bigtree_512K_NOUSB  IGNORED
STM32F103RE_bigtree             IGNORED
STM32F103RE_bigtree_NOUSB       IGNORED
STM32F4                         IGNORED
STM32F7                         IGNORED
ARMED                           IGNORED
STM32F103VE_longer              IGNORED
mks_robin                       IGNORED
mks_robin_lite                  IGNORED
mks_robin_mini                  IGNORED
mks_robin_nano                  IGNORED
jgaurora_a5s_a1                 IGNORED
STM32F407VE_black               IGNORED
BIGTREE_SKR_PRO                 FAILED    00:00:14.755
BIGTREE_BTT002                  IGNORED
teensy31                        IGNORED
STM32F103CB_malyan              IGNORED
chitu_f103                      IGNORED
teensy35                        IGNORED
esp32                           IGNORED
fysetc_f6_13                    IGNORED
linux_native                    IGNORED
SAMD51_grandcentral_m4          IGNORED
include_tree                    IGNORED
========================================================== 1 failed, 0 succeeded in 00:00:14.755 ==========================================================
The terminal process terminated with exit code: 1

Terminal will be reused by tasks, press any key to close it.

Ausildis, 2020-01-05:
> PACKAGES: toolchain-gccarmnoneeabi 1.70201.0 (7.2.1), **framework-arduinoststm32 4.10700.200103 (1.7.0)**

@alma2122, you are using a newer framework package that causes these problems change the highlighted line in my last comment and the error will disappear.

schpuntik, 2020-01-08:
diff --git a/firmware/Marlin-bugfix-2.0.x SKR ProV1.1-Dmeo/platformio.ini b/firmware/Marlin-bugfix-2.0.x SKR ProV1.1-Dmeo/platformio.ini
index fba4189..2caf811 100644
--- a/firmware/Marlin-bugfix-2.0.x SKR ProV1.1-Dmeo/platformio.ini
+++ b/firmware/Marlin-bugfix-2.0.x SKR ProV1.1-Dmeo/platformio.ini
I did it after the changes
@@ -557,7 +557,7 @@ monitor_speed     = 250000
 [env:BIGTREE_SKR_PRO]
 platform          = ststm32@>=5.7.0
 framework         = arduino
-platform_packages = framework-arduinoststm32@>=3.10700.191028
+platform_packages = framework-arduinoststm32@3.10700.191028
 board             = BigTree_SKR_Pro
 extra_scripts     = pre:buildroot/share/PlatformIO/scripts/generic_create_variant.py
 build_flags       = ${common.build_flags}

CadAxeDesign, 2020-01-13:
Me too but no luck so far. I did try amending the highlighted line and it still the same error.

kongkong2004, 2020-01-15:
you need do change in file: buildroot\share\PlatformIO\boards\BigTree_SKR_Pro.json
replace "stm32f407xg.ld" with "ldscript.ld"

Tinchus2009, 2020-03-11:
I have the same error, but none of the propose solutions worked, any other ideas?

oldman4U, 2020-06-08:
Hello John2vdw.

Seems this ticket has not been used for a while, so could you please close it.

Thank you

oldman4U, 2020-06-15:
@bigtreetech Could you please close this unneeded ticket. Thank you

roberth1967, 2020-12-07:
i used on my e3 mini v2.0 the platformio set to STM32F103RC_btt_512K on default_envs

Closed 2020-06-15.

Thread 90 (2020-01-21):

Not an issue, just a question on connectors

jimhiggs, 2020-01-21:
What connector type is needed for the stepper motor sockets? I am using std dupont and am having problems with dodgy connections (are pins too short for duponts?)

theopensourcerer, 2020-01-21:
This image makes it look like they are JST XH 4 pin:

https://github.com/bigtreetech/BIGTREETECH-SKR-PRO-V1.1/blob/master/picture/SKR%20PRO%20V1.1-TOP.png

jimhiggs, 2020-01-21:
Thnks I will get some on order.

i-make-robots, 2021-04-19:
So, @jimhiggs, was it the correct connector? I'm facing the same issue right now.

Closed 2020-01-21.

Thread 92 (2020-01-24):

New SKR 1.1 Pro and BigtreetechTFT35-V.2 problem no printer attached

Shamoon78, 2020-01-24:
The board have 4 x TMC5610 drivers attached to it, the main board is communicating to computer normally all working fine(Stealth chop, end stops, heaters, sensors, I tried troubleshooting the connection issue, by using Bigtreetech latest firmware, on both the TFT display and the SKR board, with no success,I compyl Marlin official bug fix 2 myself with all options on serial ports , 1 for TFT, -1 for USB and all other numbers again evrything worked fine on computer but , no hope with the display connection , try to change the baudrate on both the screen and main board marlin to 250000 or 115200 to match but no success , tried to remove all motor drivers and connection except TFT and no success , tried even all types of displays in Marlin define one at a time nothing worked everything working fine on computer but the screen fail to attach to the board.
Please any suggestion, I am happy to order new Display or board but not sure which one have the problem.   (Sorry for my English ,I know it's not good but still ok to communicate not like my TFT display that failing to communicate).

knockoutperformance, 2020-01-25:
I'm having same issue. Trying to use the 3.5 tft v3, wifi, and sd. Have the 2130's working fine. Sd works and wifi, just tft connect to printer error.

Evovita, 2020-01-25:
I had the "no printer attached" problem on and off. Sometimes it was solved by turning my machine (a custom CoreXY using TMC 2130) off then on again. But I also noticed that recompiling the motherboard firmware and reflashing it to the board would make a difference - I have no idea why. With the configuration below however, the "no printer attached" message now only briefly appears on start up, even after multiple on/off cycles. Note that my printer is called 'EV-2' so you will see mention of that in the files:

[Configuration.zip](https://github.com/bigtreetech/BIGTREETECH-SKR-PRO-V1.1/files/4112419/Configuration.zip)

Shamoon78, 2020-01-25:
@ Evovita, thank you for sharing your files and tyring to help, I tried your configuration with no changes  but the issue still there, the only difference now I have a green led light on close to usb connection ,I think is the Wifi module , that iam not using, not sure though, Is there anyway to test the if the serial connection on mainboard or on screen is defective ?(the serial port I mean the 5 pins only connection labled TFT).

Evovita, 2020-01-25:
@Shamoon78 The green led light close to the usb connection shouldn't be on all the time - at least when the printer is idle. When you flash the firmware on the SKR Pro (via the micro SD card), it will flash a few times then stop. This suggests to me that the firmware might be corrupt and if so, explain why, the TFT won't connect to the board. Another issue could be that the micro SD card isn't working - I had this happen to me, and in the end I had to replace the SD card.

The attached file shows what lights should be on when the SKR Pro is idle with the micro SD card inserted, 12/24V (not USB) power mode set via jumper, and USB flash drive mode set via jumper as per the [SKR Pro V1.1 User manual](https://github.com/bigtreetech/BIGTREETECH-SKR-PRO-V1.1/blob/master/manual/SKR%20PRO%20V1.1%20user%20manual%20v1.1.pdf). **1 blue LED for the SD card, 3 orange lights for the board**.

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

Also, make sure the TFT ribbon cable is correctly connected. At the TFT end it should be connected to the RS232 plug with the single lead connected to the 5V pin (highlighted below, note orientation of the board) - the other pins are combined together on the ribbon cable.

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

You might also want to try connecting to the SKR Pro via _Pronterface_, eliminating the TFT from the equation until such time as you know the board is ok.

Shamoon78, 2020-01-25:
Its not the one that flash close to mcu , its the one close to wifi socket
.

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

Shamoon78, 2020-01-25:
I tried 3 sd card all flashing and reading from computer ok none have issue
.

On Sun, 26 Jan 2020 at 9:18 am, Hardware Loaded <rafiyousif1978@gmail.com>
wrote:

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

Shamoon78, 2020-01-25:
And exactly that what i have like your attached photo but the green light
come on one time only and stay on until i reset the board and only the blue
and 3 red lights are on .

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

Shamoon78, 2020-01-25:
@Evovita , iam not sure if i attached the ribbon cable wrong the first time , that might damage the board hardware ? Or only can corrupt bootloader of mcu , and even if its damaged iam not sure what to order new tft or board iam worry to plug any of them on new ones.😕

Evovita, 2020-01-26:
@Shamoon78 As I said earlier, try connecting to the board using _Pronterface_ (unplug the TFT altogether) - if it works e.g. you can move your axis, heat up bed/extruder etc then you at least know the SKR Pro is unlikely to be the culprit.

Evovita, 2020-01-26:
And...after a few more tweaks to my Marlin firmware that were limited to acceleration settings and adding some comments, and then reflashing the board...the problem is back. Restart several times, no change. Recompile the firmware then reflash again, "no printer attached" quickly disappears. It is as if the delay in applying the firmware may help in the TFT serial port connection. Either way, the inconsistent results is unacceptable. This is unlikely to be a loose/intermittent cable connection issue as I have my plugs held in place with a dab of hot glue.

rndsum, 2020-01-26:
Make sure your baud rate is set to
#define BAUDRATE 115200

Their TFT's can't handle much faster than that.

Shamoon78, 2020-01-26:
As i mentioned in the main post everything is working fine when controlled
by computer even i can print normally through usb port

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

Shamoon78, 2020-01-26:
I Tried that as well does not solve the problem

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

Shamoon78, 2020-01-26:
@ Evovita so you have the issue again but what you mean by "delay in
applying the firmware"?

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

Shamoon78, 2020-01-26:
@ Evovita so you have the issue again but what you mean by "delay in
applying the firmware"?

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

Evovita, 2020-01-26:
Eureka! The problem - at least for me - turned out to be the a **faulty TFT ribbon cable connector at the motherboard end**. Despite making sure it was plugged in snugly numerous times, it appears the pins were not consistently making a solid connection and would therefore periodically disconnect which coincided with me applying firmware updates etc. My temporary fix until I get a new cable/connector is to tape the cable down so it flexes the connector end and thus makes a good (better) connection. After many restarts, it still works AOK and the "No printer attached" message disappears almost instantly every time.

I've already had 2 x BigTreeTech micro USB cards fail on me so it wouldn't surprise me the quality of the TFT ribbon cables is 'variable'.

oldman4U, 2020-01-30:
As far as i know, it is not possible to use the USB, the TFT AND the WIFI at the same time on the board, because only 2 serials can be defined.

-1 is for USB/CDC
1 is for TFT
6 is for ESP-01S

In any case, i would recommend to remove hardware (WIFI) and make a stripped down firmware until the most important parts are working properly. After that, i would add functions based on priority.

Hope this helps

GiovaneMunhoz, 2020-02-01:
@Shamoon78  The problem for me was wrong number on serial port, this is my configs and it works for me, even with esp-01.

Configuration.h
#define SERIAL_PORT 6
#define SERIAL_PORT_2 1

knockoutperformance, 2020-02-04:
got it working with this and using the fork multispi for marlin bugfix:
Configuration.h
#define SERIAL_PORT 1 // tft
#define SERIAL_PORT_2 6 // esp3d
#define BAUDRATE 250000 // both esp3d and tftv3

oldman4U, 2020-06-08:
Hello Shamoon78.

Seems this ticket has not been used for a while, so could you please close it.

Thank you

oldman4U, 2020-10-10:
Please help the community and close the ticket once you do not need it anymore. Thank you

abdulrehaman72, 2020-11-04:
Hi all, I have an issue while using BIGTREETECH SKR-PRO-1.1. After uploading the MARLIN 2.0 in to the board, I checked with each and every motor orientation using Pronterface.exe by connecting with USB (serial port's) . The motors were working fine. Now I'm trying to connect the board through pronterface, it's giving an issue like no serial port is connected. I checked thoroughly, no short-circuit in board, no wrong connections to the board,checked by connecting it with many laptops. Its showing the same issue like ' SERIAL  PORT NOT FOUND '.BL TOUCH is probing fine and input to the board is fine even TFT is glowing but it's not functioning. I tried resetting and rebooting the board still my issue was not resolved yet. My doubt is whether any internal issue with communication chip. I request you to give me a solution for this issue. Will be waiting for your support. Thank you.

Thread 94 (2020-01-27):

SKR 1.1 pro disconnecting and freezes short after turning on

k-rzr, 2020-01-27:
Hello everyone I have some strange issue with my skr 1.1 pro - when I turn on printer everything works fine (sending commands through usb, moving motors etc.) for like 30 seconds to 1 minute, after that it freezes and doesn't respond to anything (touchscreen turns off), neither through usb connection nor using any of the buttons on the printer, lights on the board are on. It happens no matter if it's connected to pc with usb (using pronterface), using only usb power or one form the power supply. I'm using it with tmc 2208, 12v power supply, touchscreen is from BTT TFT24-V1.1, triple-checked all connections. If it matters motors, end-stops, heaters are from anet a6. My board on picture below:

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

oldman4U, 2020-01-28:
Hi k-rzr.

Have you tried to disconnect the USB cable to see if this makes a difference?

oldman4U, 2020-01-28:
Hit Comment and the same time another question came up.

Are you using Dual-Z or 2 Extruders?

k-rzr, 2020-01-28:
I'm using dual Z.
I think I tried yesterday running it with disconnected usb cable but I'm not sure. I'll check it out when I get home.

oldman4U, 2020-01-28:
In case you are using dual-z like me, you can remove the last stepper driver because the Pro provides built-in dual-Z. So you have connector X and Y, each with its own dedicated stepper driver . Then you have 2 (Z) connectors sharing the third stepper driver and another stepper driver for the Extruder. In Marlin you configure a single Z stepper and also all the other dual-Z settings and options can be ignored.

USB i asked, because Cura has an issue, causing a TMC Connection error......

k-rzr, 2020-01-28:
Ok so I checked, it happens even with the unplugged USB cable - the printer after turning on works normally for about 30 seconds, then restarts and about 5 seconds later LCD turns off, LEDs on board are still on and you can't do anything. After turning power off and on printer still does not respond, after some time with no power on it returns to the initial state when it works for a half of a minute. I think I'm gonna examine the board if there's no some short circuits, especially near the mounting bolts.
Removing unnecessary driver didn't improve anything.

k-rzr, 2020-01-28:
Seems like I found the cause - it was my self-made step motor direction reverser that consists of a extension cable and angle 4pin socket XD which is strange because it caused no problems with the standard anet a6 mainboard, right now skr board runs for a few minutes without any issues so far so I'm closing issue

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

Closed 2020-01-28.

Thread 95 (2020-01-29):

35V on motor inputs?

blanosko, 2020-01-29:
Hi, I hope this is the right place to question this. Is it possible to connect say 35V on motor inputs on this board? In manual it says 12V/24V, but I know that it can be just badly written by manufacturer. So is here anyone who tried this and can confirm my assumption that it can?

Thanks

BastR, 2020-01-30:
The only thing that limits the voltage of the motors between the screw connector and the driver pins are the capacitors. They are 35V rated but it's better to leave a safety margin and apply a lower voltage, the information I found on the internet says that you have to leave a 30% margin, that is to say apply a voltage of 24V maximum.

So, you can apply any voltage you want until you leave a sufficient margin below 35V.

blanosko, 2020-01-31:
Really thanks for answer. I think I figured out schematics so I can support your answer.

Here is schematics of main connector on board. There is clearly visible that motor power is connected directly to VMOTO (VM) pin of stepper drivers.
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

And here is schematics of actual stepper driver. So if you look on right top side there is VM pin and only one capacitor (in this case capacitor C7) with value 35V/100uF.

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

Thats for X driver, so for another drivers value of capacitor is the same (100uF), just name of capacitor is diferent:

X - C7
Y - C10
Z - C16
E0 - C8
E1 - C14
E2 - C17

And these capacitors are located under every stepper driver connectors (they are easily visible)

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

So if anyone needed to connect higher voltage then 24V, everything you need to do is desolder the capacitors and solder new ones with higher voltage rating. And you can power motors with whatever voltage you want.

Again, thanks @BastR for his quick reply. Hope this can help to anyone with my problem.

GadgetAngel, 2020-02-01:
@BastR, @blanosko  Have you connected an SSR up to the SKR pro board to power an AC bed?? I am having a hard time seeing how to do an SSR with the Bed power being separate, any suggestions on this subject would be helpful

BastR, 2020-02-01:
@GadgetAngel Yes, I have an SSR connected like that:

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

I had to reverse the positive and negative in the SSR input to make it work. It's "normal", I saw an issues that talked about it on that GitHub.

drmulligan, 2020-02-01:
If I read your schematic correctly, you can just desolder pin 16 on your driver, flip it so it sticks up and does not make contact with the SKR board.  Also solder a pin which goes up through the driver to GND on pin 15 so it connects to both the SKR board and up.  Then wire your cap and >24v power supply to a two pin female connector and plug it in to the top of the driver.  Make sure your >24v power supply line to the drivers is fused.

blanosko, 2020-02-03:
> If I read your schematic correctly, you can just desolder pin 16 on your driver, flip it so it sticks up and does not make contact with the SKR board. Also solder a pin which goes up through the driver to GND on pin 15 so it connects to both the SKR board and up. Then wire your cap and >24v power supply to a two pin female connector and plug it in to the top of the driver. Make sure your >24v power supply line to the drivers is fused.

Yeah, you can just do that. But this board specificaly has 3 independent input rails. So it would be great to make them useful and without wires all over the board.

But yeah, if your board doesnt have this feature (most boards dont) you can do that.

oldman4U, 2020-06-08:
Hello blanosko.

Seems that this ticket is not needed anymore. So could you please close it.

Thank you

oldman4U, 2020-06-15:
@bigtreetech Could you please close this unneeded ticket. Thank you

Closed 2020-06-15.

Thread 96 (2020-01-31):

Sensorless homing + Skr Pro 1.1 + TMC5160 + Marlin 2.0 = is that possible ?

GiovaneMunhoz, 2020-01-31:
Hello guys, i'm trying to setup a sensorless homing on tmc5160 v1.2 (spi) and skr pro, using Marlin 2.0, but I did every single sh*** that I found on google, but the endstops dont trigger, Im about to give you, becouse there's is nothing that I didnt do.

But, if someone has figured out how to make it work, I Will be very happy to know how.

My marlin files: https://drive.google.com/open?id=1FXjLBxjaVRBTd6YxUVsU0fO5yQepG6gC

Edit: Diag pin is conected!

Thanks.

GadgetAngel, 2020-02-01:
@GiovaneMunhoz If you setup Sensorless Homing on all your axis, then by definition of Sensorless homing you will not need to trigger your ENDSTOPs. When you do a M119 all your endstops should show OPEN, that’s assuming you defined Sensorless Homing on X, Y and Z. I hope this helps

GiovaneMunhoz, 2020-02-01:
@GadgetAngel of course my endstop will not trigger, couse' Im using sensorless homing! But when I home any axis, the stallguard dont stop the axis when hit the corner, my machine keeps pushing the axis through the corner even when gets stuck.
So sensorless homing dont work, it dont sense when is on end of course.

Mariu86, 2020-02-01:
You must change the sensitivity for sensorless homing!

GiovaneMunhoz, 2020-02-01:
@Mariu86 I've tried every single sensitivity number possible. From -64 to 64, that is the range that I've found of tmc5160, tell me if im wrong.

GadgetAngel, 2020-02-01:
@GiovaneMunhoz Can you post a link to your Marlin files?? Like put the whole Marlin folder on Google Drive and share it to the public by supplying us with the link to the top Marlin folder. If you do that I could look at your configuration of Marlin and see if something is off.

GadgetAngel, 2020-02-01:
@GiovaneMunhoz Did you connect CLK pin on the TMC5160 to the GND pin on the TMC5160 before pugging them into the SKR PRO V1.1 board?? Here is a file that shows All the Stepper Motor Driver configuration for the SKR PRO board. It was created by @rflulling. Here it is: https://doc-0k-c4-docs.googleusercontent.com/docs/securesc/seim4417k8n16rvc6rl28ib17otc3iek/3ohsos0r5999avqtuin34rmgbvo6bq7t/1580551200000/06483777329211841429/05169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

GiovaneMunhoz, 2020-02-01:
@GadgetAngel I didnt solder CLK pin to GND, on my research I found that is not needed on BTT TMC5160 v1.2, even on v1.2 I still have to do this?

GiovaneMunhoz, 2020-02-01:
@GadgetAngel  Check my marlin files: https://drive.google.com/open?id=1FXjLBxjaVRBTd6YxUVsU0fO5yQepG6gC

GadgetAngel, 2020-02-01:
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

Check with. Multi-Meter to see if the CLK is going to ground. I see conflicting info on weather this fix has been implemented. So depending on when you bought your TMC5160, it could or not be fixed. Again CLK pin on the TMC5160 needs to be going to GND. Just check the CLK pin to ensure this is happening.

GiovaneMunhoz, 2020-02-01:
@GadgetAngel Thanks for the tips, I will check.

What about my marlin configs, is everything ok?

GiovaneMunhoz, 2020-02-01:
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

I did What you said using multi-meter, and all my tmc5160 v1.2 have CLK and GND conected. I used the continuity test to check.

GiovaneMunhoz, 2020-02-01:
@GadgetAngel One question, the only wiring I have to do, is solder the diag pin on stepper driver and plug it on the board, right?

GiovaneMunhoz, 2020-02-01:
Thanks everyone who try to help, Reading about stallguard I saw that stallguard Will only work when stealthchop is disabled and in my case mas enabled, know sensorless homing is working.
Marlin site:
"StallGuard is only active when the driver is in spreadCycle mode."

So I had to disable stealthchop and marlin Will auto switch to spreadcycle and sensorless Will work. Using tmc5160 v1.2 I set sensitivity at 3 or even 2 for X and Y.

Thanks @GadgetAngel for helping.

GadgetAngel, 2020-02-02:
> @GadgetAngel Thanks for the tips, I will check.
>
> What about my marlin configs, is everything ok?

I will look at it tomorrow, I have been testing my stepper drivers on the SKR PRO V1.1 board today. I have A4988, DRV8825, LV8729, TMC2100, TMC2130, TMC2208,TMC2209,TMC5160. I only got the A4988 and DRV8825 today. But I will look at your conf files tomorrow. I have a copy of Marlin already done for my TMC5160. I just have not tested it yet.

GadgetAngel, 2020-02-02:
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

I was not aware of this either, thanks for letting me know

GiovaneMunhoz, 2020-02-02:
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

Dont bother to check those files, I have changed. I Will up again my files with changes that make my print work, maybe help you or someone.

DroneMang, 2020-04-16:
Does anyone on this thread have their current config and configuration advanced files for the SKR pro and TMC5160? I have been working with the 2209's but I can't seem to get above 350 milliamps without strong active cooling and I would like to not have a fan in the case. Thanks!

sn0wrider, 2020-04-21:
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

Hi, can you put works configuration files to google drive?
Best rgs

GiovaneMunhoz, 2020-04-21:
> Does anyone on this thread have their current config and configuration advanced files for the SKR pro and TMC5160? I have been working with the 2209's but I can't seem to get above 350 milliamps without strong active cooling and I would like to not have a fan in the case. Thanks!

Im using tmc5160 with 300-400 mah with no cooling at all, they run very cold. Just lower the mah.

GiovaneMunhoz, 2020-04-21:
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

I gave up of using sensorless, they dont work at all. Im using endstop in all axis.

DroneMang, 2020-04-21:
Here are working config files for an SKR Pro V1.1 with TCM 5160 V1.2 on an FT-6, BLTouch 3.1 in 5V and SW mode, sensorless homing. Sensorless homing works fine.  800 mah for XYZ and sensitivity set  M914 X2 Y4.

[Marlin-2.0.x-5160.zip](https://github.com/bigtreetech/BIGTREETECH-SKR-PRO-V1.1/files/4511154/Marlin-2.0.x-5160.zip)

5V mode may not be necessary, but having probe issues per here: https://github.com/MarlinFirmware/Marlin/issues/17337

so I am trying to diagnose.

sn0wrider, 2020-04-21:
Thank you!!!

DaVincIan, 2024-12-23:
Thanks for everyones contributions. Herewith my experience to get sensorless homing ons SKR Pro V1.2 and TMC 5160 drivers.
I have a CoreXY RepRap printer.

I am up to date with Marlin FW: 2.1.2.5
In no particular order:

All these are in Configuration_adv.h

I had to disable the Quickhome
//#define QUICK_HOME                          // If G28 contains XY do a diagonal move first

I set my Stall sensitivity to 4 for X & Y
   #define X_STALL_SENSITIVITY  4

Disable stealthchop. I disable E stealthchop to improve my extruder torque.
// @section tmc/stealthchop
  #if HAS_STEALTHCHOP
//    #define STEALTHCHOP_XY
//    #define STEALTHCHOP_Z
    #define STEALTHCHOP_I
    #define STEALTHCHOP_J
    #define STEALTHCHOP_K
    #define STEALTHCHOP_U
    #define STEALTHCHOP_V
    #define STEALTHCHOP_W
//    #define STEALTHCHOP_E
  #endif

Closed 2020-02-01.

Thread 98 (2020-02-02):

Can't use TMC2208 in UART mode - can missing UART resistors be the cause?

TheDark, 2020-02-02:
As posted by @AnHardt in https://github.com/bigtreetech/BIGTREETECH-SKR-PRO-V1.1/issues/70#issuecomment-551315083

> The places for the resistors R61, R65, R67, R69, R70, R71 seem to be not populated on all boards.

I have such an unpopulated board. Can the missing resistors be the cause for the TMC2208 drivers not to work, causing "Error: ALL LOW"? Can I just add the resistors to make it work?

The 2208s work perfectly well on a SKR 1.3. Using latest Marlin bugfix 2.0.

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

blanosko, 2020-02-03:
You can take a look on schematic and figure out if there should be a resistor:

You can see that there should be 1K resistors. R70 is for X UART and R71 is for Y:
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

Here are for Z, E0, E1, E2:
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

GadgetAngel, 2020-02-04:
@TheDark and @blanosko Here is a picture of my newly bought SKR PRO V1.1 board, which DOES NOT have the R70, R71, R61, R65, R67, or R69 solder on the board. So without those resistors in place how can UART mode be working?  I connected up my TMC2209 V1.2 to the SKR PRO board and I can turn my stepper motors with TMC2209 in UART mode. How can this work if they are truly NOT connected?? I am missing something here. The TX line have to be connected

blanosko, 2020-02-04:
@GadgetAngel Your motors are working because UART have nothing to do with that. Drivers are controlled through EN, STEP/DIR pins.

UART on these drivers is used to **configure** them (How much current going to motors, Stealthchop treshold, monitoring temperatures. etc).

So we can elaborate:
I have MKS Gen 1.4 board. If I want to use TMC2208 drivers (blk.me branded) I have tu use Y splitter with 1K resistor. Basicaly thats what is in schematics of SKR Pro.
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

So if I disconnect TX line I could only read data from driver not write them. So Iam assuming that if there is no TX line resistors in place you can only read them.

theopensourcerer, 2020-02-04:
@blanosko
> So if I disconnect TX line I could only read data from driver not write them. So Iam assuming that if there is no TX line resistors in place you can only read them.

Not sure if this is relevant or not, but when using Klipper firmware on my MKS Gen 1.4 you only need a single wire and no resistor to both read from and write to the 2208.

blanosko, 2020-02-04:
@theopensourcerer
I was searching for some info about this and aparently it is possible with one wire without resistors. But Iam not sure when it can work and when not. So it would be great if someone with greater knowledge can sort this for once and for all.

theopensourcerer, 2020-02-04:
@blanosko I know it works - I've been using it for nearly a year with no issues.

I recently bought this SKR Pro V1.1 board and am going to use some 2130s I have in SPI. I've been testing it on my bench and I can talk to them OK. Again I am using Klipper f/w.

theopensourcerer, 2020-02-04:
The point is I don't believe it's anything to do with hardware. If Klipper can do it on any random MCU board then so should Marlin presumably.

GadgetAngel, 2020-02-04:
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

Ok, so if I understand this correctly. I can not configure my TMC2209 to run at different Microsteps or switch between Stealthchop and Spreadcycle on the file because the TX pins are not connected?  Has anyone tested this out?  What mode are my Drivers running in? When I did a M122 command during my test, all reagister coming back from the TMC2209 looked OK, and my setup for the driver was what I set it to be. But I could have gotten lucky because I only set it for 1/16th microstepping. I need to go back and see if I can set the parameters differently. I will do that tomorrow and report back what I found. So if I find I can not adjust parameters then SPI mode is the only way one can use the SKR PRO?

blanosko, 2020-02-04:
If you can see output of M122 then connection is OK. You can test if you can change say motor current, save it, reboot board and then try M122 and check if the settings are the new one.

Refer to what @theopensourcerer said. (One wire UART)

theopensourcerer, 2020-02-04:
@GadgetAngel The 2208/9 are supported by Klipper firmware on the SKR Pro. They only need one pin defined for the UART:

https://github.com/KevinOConnor/klipper/blob/master/config/generic-bigtreetech-skr-pro.cfg#L106

GadgetAngel, 2020-02-05:
> @GadgetAngel The 2208/9 are supported by Klipper firmware on the SKR Pro. They only need one pin defined for the UART:
>
> https://github.com/KevinOConnor/klipper/blob/master/config/generic-bigtreetech-skr-pro.cfg#L106

I found it in the Datasheets for the TMC2208/9:
"This mode (UART) allows replacing all control lines like ENN, DIAG, INDEX, MS1, MS2, and analog current setting VREF by a single interface line" https://www.trinamic.com/products/integrated-circuits/details/tmc2209-la/:
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

spattinson, 2020-02-07:
The pins file for the SKR Pro defines the following for UART:
```
#define X_SERIAL_TX_PIN  PC13
  #define X_SERIAL_RX_PIN  PC13

  #define Y_SERIAL_TX_PIN  PE3
  #define Y_SERIAL_RX_PIN  PE3

  #define Z_SERIAL_TX_PIN  PE1
  #define Z_SERIAL_RX_PIN  PE1

  #define E0_SERIAL_TX_PIN PD4
  #define E0_SERIAL_RX_PIN PD4

  #define E1_SERIAL_TX_PIN PD1
  #define E1_SERIAL_RX_PIN PD1

  #define E2_SERIAL_TX_PIN PD6
  #define E2_SERIAL_RX_PIN PD6
```
Clearly the same pin is used for TX and RX so is this an issue or not?
If I "grep X_SERIAL_ *" in the pins/stm32 to see if other vendors have the same setup:
```
scott@n550jk:~/pio/Marlin-bugfix-2.0.x/Marlin/src/pins/stm32$ grep X_SERIAL_ *
pins_BTT_BTT002_V1_0.h:  #define X_SERIAL_TX_PIN  PE2
pins_BTT_BTT002_V1_0.h:  #define X_SERIAL_RX_PIN  PE2
pins_BTT_GTR_V1_0.h:  #define X_SERIAL_TX_PIN  PC14
pins_BTT_GTR_V1_0.h:  #define X_SERIAL_RX_PIN  PC14
pins_BTT_SKR_E3_DIP.h:  #define X_SERIAL_TX_PIN  PC10
pins_BTT_SKR_E3_DIP.h:  #define X_SERIAL_RX_PIN  PC10
pins_BTT_SKR_MINI_E3_V1_2.h:  #define X_SERIAL_TX_PIN  PB15
pins_BTT_SKR_MINI_E3_V1_2.h:  #define X_SERIAL_RX_PIN  PB15
pins_BTT_SKR_PRO_V1_1.h:  #define X_SERIAL_TX_PIN  PC13
pins_BTT_SKR_PRO_V1_1.h:  #define X_SERIAL_RX_PIN  PC13
pins_FLYF407ZG.h:  #define X_SERIAL_TX_PIN  PG13
pins_FLYF407ZG.h:  #define X_SERIAL_RX_PIN  PG13
pins_FYSETC_CHEETAH_V12.h:  #define X_SERIAL_TX_PIN  PA11
pins_FYSETC_CHEETAH_V12.h:  #define X_SERIAL_RX_PIN  PA12
pins_FYSETC_S6.h:  #define X_SERIAL_TX_PIN  PE9
pins_FYSETC_S6.h:  #define X_SERIAL_RX_PIN  PE8
pins_MKS_ROBIN_PRO.h:  #define X_SERIAL_TX_PIN  PF7
pins_MKS_ROBIN_PRO.h:  #define X_SERIAL_RX_PIN  PF8
```
We can see it is only BTT boards that have this feature on the stm32 platform, other vendors use different pins for tx and rx.

GadgetAngel, 2020-02-08:
@TheDark Which TMC2208 driver board are you trying to get to work? Can you post a picture of the driver boards’ top and bottom view?  Is it from FYSECT or BIQU?

TheDark, 2020-02-08:
> @TheDark Which TMC2208 driver board are you trying to get to work? Can you post a picture of the driver boards’ top and bottom view? Is it from FYSECT or BIQU?

GadgetAngel, 2020-02-09:
@TheDark post a picture of BIQU TMC2130 from the bottom and top, please

GadgetAngel, 2020-02-09:
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

I am not familiar with THIS Chip. But from the picture I DO NOT see the UART Pin on the driver board. Can you send me a link to this driver board schematic?

TheDark, 2020-02-11:
Here they go!

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

blanosko, 2020-02-12:
You dont have a solder bridge on SPI pad at the bottom of the driver. It cant work in SPI mode if dont have that two pads soldered together.

GadgetAngel, 2020-02-12:
@blanosko if you look very closely he does have the SPI bridged together. BTT uses a 0 Ohm resistor that has a black part in the middle. @TheDark could you take another picture of the BTT TNC2130 but title the TMC2130 a bit so we can see if the two SPI pads are truly bridged together? I also need a shot for a manual I am working on

@TheDark Your jumpers on the SKR Pro V1.1 board for TMC2130 should look like this:
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

blanosko, 2020-02-12:
Yeah, you are correct. There is a resistor. My bad.

GadgetAngel, 2020-02-12:
@TheDark to get the TMC2130 to work in SPI mode the SPI jumper MUST NOT BE IN PLACE.

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

GadgetAngel, 2020-02-12:
@TheDark it looks like you bought the TMC2130 in standalone mode. Double check, is there a 0 Ohm resistor across the two SPI pads. If there is one there then the driver board is set for Stand alone mode:  on page 4 of https://github.com/bigtreetech/BIGTREETECH-TMC2130-V3.0/blob/master/TMC2130-V3.0RM.pdf

blanosko, 2020-02-12:
So BTT 2130 have this inverted. You need open bridge for SPI and closed for STANDALONE. Iam I right? I have waterott drivers and they need solder bridge between pads near CS pin to work in SPI mode.

GadgetAngel, 2020-02-12:
@blanosko Here is the watterott documentation: https://learn.watterott.com/silentstepstick/pinconfig/tmc2130/

It show that the BTT is **THE SAME WAY**, the SPI jumper "CLOSED" is STAND ALONE mode and the SPI jumper "OPEN" is SPI Mode.
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

TheDark, 2020-02-14:
Sorry for the delay in my answers, and thanks all for yours.

There is a jumper in the SPI pads, photos follow. If I remove it can I use the boards as SPI, or is it permanently in standalone mode?

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

GadgetAngel, 2020-02-15:
@TheDark you need to unsolder the jumper and then solder in CFG4 and CFG5 as the manual from BIGTREETECH says to.
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

TheDark, 2020-02-15:
Thanks, I'll try that when I feel confident enough.

I'll probably have to remove the header to be able to remove the jumper without ruining the plastic and the pins. And those RG* pads are so tiny... the chances of me ruining the board will be high.

Regarding the 2208s, apparently Geeetech released some defective batches and maybe mine came from one of those. No serials to check though. The following video shows what happens when I connect them:

https://youtu.be/qIWuZ2AIt0E

Closed 2020-03-19.

Thread 104 (2020-02-11):

Did I just brick the mcu?

Nyxtegida, 2020-02-11:
I recently received my skr-pro-1.1 and from the start it wouldn't respond to pronterface commands.
The board was and still is empty, not even drivers attached.
I tried compiling a new firmware, write it on the sd card, and still nothing.
It was detected as a usb-serial device, connected at 250000 baud rate in pronterface, but failed to respond to any command.
After a few tries with different firmware, it wouldn't even show up when connected to the pc.
Then I tried st-link.
All firmware I used with the st-link were from here: https://github.com/bigtreetech/BIGTREETECH-TFT35-V3.0/issues/20
I was reading something from the mcu, so I tried to write the firmware directly with the st-link.
I got a download complete, but no confirmation from stmcube, and when I tried to read again everything was FFFF.
I also tried to re-write the bootloader in case I deleted it somehow, and I got the same result.
There.

GadgetAngel, 2020-02-11:
@Nyxtegida see closed issue https://github.com/bigtreetech/BIGTREETECH-SKR-PRO-V1.1/issues/72

There is a firmware file to use with ST-Link that might get you back up and running. You will see a link to download the firmware file from one of the conversions. So please read all the post comments to find it

Nyxtegida, 2020-02-11:
I already tried all the firmware, but the problem is that after flashing I get an error that it couldn't verify. Every firmware I tried, the memory banks red FFFFFFFF. As if it didn't write. Otherwise the chip was detected fine.

GadgetAngel, 2020-02-12:
@Nyxtegida i would send back the board @bigtreetech @yangwenxiong

Nyxtegida, 2020-02-22:
Well. It eventually died. I think now its on a permanent state of reset, or that what the st-link says. I got a refund for it so I'm getting another.

Closed 2020-02-22.

Thread 106 (2020-02-14):

flashing failures & bootloader support for long file names

spattinson, 2020-02-14:
I have been reflashing marlin quite a lot recently and have run into issue where I have flashed firmware and changes I have made to marlin have made no effect to printer. The printer looks like it has flashed, the led blinks.
What I believe is happening:
Access the sdcard on your computer, copy firmware.bin to it - your computer creates a FAT long filename for the file despite the fact that the filename is exactly 8.3 format.
Insert card in 3d printer and reset, flashing occurs and firmware.bin is renamed FIRMWARE.CUR by bootloader. The long filename entry is left alone because the bootloader does not support LFN so it becomes orphaned.
Repeat the above a few times and flashing no longer works properly, the filesystem entry for firmware.bin is pointing to the wrong file, probably FIRMWARE.CUR so you end up flashing the same firmware you already had.
Remove card and check file system:
```
scott@n550jk:~/pio/Marlin/.pio/build/BIGTREE_SKR_PRO$ sudo fsck /dev/mmcblk0p1
fsck from util-linux 2.31.1
fsck.fat 4.1 (2017-01-24)
Orphaned long file name part "firmware.bin"
1: Delete.
2: Leave it.
? 1
Orphaned long file name part "firmware.bin"
1: Delete.
2: Leave it.
? 1
Perform changes ? (y/n) y
/dev/mmcblk0p1: 4 files, 101/974732 clusters
```
Recent versions of marlin default to using  the external SD card if you have one so your gcode and eeprom.dat will be on there. the microsd on the board is only used for flashing.
Avoid this problem in a number of ways:
On linux you can ensure the sdcard is mounted "msdos" type, this forces 8.3 format only without long filenames.
regularly reformat the sdcard to get rid of errors.
run check filesystem for errors, or fsck on linux.
update "#define STRING_CONFIG_H_AUTHOR " in configuration.h each time you make changes and check with M115 after flashing - I have not verified this yet, I'd like to see a date/time stamp maybe easier.

Further background info: Long filenames on FAT filesystems are supported by a look up table, for compatibility the 8.3 filename still exists so apps that dont support LFN can still use the sdcard. The look up table maintains cross reference between 8.3 and long filenames.

vover000, 2020-04-01:
Помогите решить проблему.
Дело в том, что при сборке 3Dпринтера, случайно закоротил  проводом нижнюю часть платы SKR PRO v1.1, в результате чего сгорел Микроконтролер  Stm32f407zgt6 который установлен на ней, я нашёл и купил новый Stm32f407zgt6, заменил его.
Теперь проблема прошить правильный файл bootloader.bin.
Проще говоря нужен правильный файл bootloader.bin для этого Микроконтролера.
Материнская плата skr pro сама не пострадала от короткого замыкания, но прошивка Marlin-2.0
прошитая на прямую через uart не работает без этого файла bootloader.bin.

vover000, 2020-04-01:
Help me solve the problem.
The fact is that when assembling a 3dprinter, I accidentally shorted the lower part of the SKR PRO V1.1 Board with a wire, resulting in the burning of the stm32f407zgt6 Microcontroller that is installed on it, I found and bought a new Stm32f407zgt6, replaced it.
Now the problem is to flash the correct bootloader file.bin.
Simply put, you need the correct bootloader file.bin for this Microcontroller.
The skr pro motherboard itself was not affected by a short circuit, but the Marlin-2.0 firmware
stitched directly via uart does not work without this bootloader file.bin

AnHardt, 2020-04-01:
https://github.com/bigtreetech/BIGTREETECH-SKR-PRO-V1.1/issues/25#issuecomment-607009288

Thread 110 (2020-02-25):

SKR Pro v1.1 + TMC5160 + Double X + SensorLessHoming + Motor 24V 1.8deg 2.0A ?...

Uri-34, 2020-02-25:
Good day !
I ask for help in solving the problem !!!
My kit : SCR Pro v1. 1 & TMC5160 x 6 & Motor 24V 1.8 deg 2.0 A x 5 & Motor 24V 1.8 deg 1.5 A & Motor 24V 1.8 deg 3.0 A & Marlin 2.0 !
My task: control 4 motors : X 2Y Z, and two more E1 E2 for my purposes ! I will be very grateful for any help in solving the problem !

Uri-34, 2020-02-25:
Here is a link to the configuration files : https://yadi.sk/d/gGtXFX3MJqUf6Q
I will be grateful for pointing out the wrong points !

tphan26363, 2020-02-25:
I can't point out what is wrong  since I don't have time.  But here is a configuration with mixed TMC2208 and TMC5160 with Dual Z.  You can use it as an example. it should not be too hard.  Just to make sure the jumper on the board set accordingly for your TMC( serial mode or SPI mode)

[Configuration.h.txt](https://github.com/bigtreetech/BIGTREETECH-SKR-PRO-V1.1/files/4252013/Configuration.h.txt)
[Configuration_adv.h.txt](https://github.com/bigtreetech/BIGTREETECH-SKR-PRO-V1.1/files/4252014/Configuration_adv.h.txt)
[pins_BIGTREE_SKR_PRO_V1.1.h.txt](https://github.com/bigtreetech/BIGTREETECH-SKR-PRO-V1.1/files/4252015/pins_BIGTREE_SKR_PRO_V1.1.h.txt)

Uri-34, 2020-02-27:
Good day ! Unfortunately, the firmware with your configuration files is not compiled ! Maybe you didn't send all the changed files ?

Uri-34, 2020-02-27:
I would like to understand the nuances of configuring TMC drivers... ! :)

tphan26363, 2020-03-19:
it just an example .  it can not apply to your case.  But  I mark all the
places that need to change.  you can follow that and do your own.  The
hardware detail is not the same

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

Uri-34, 2020-03-19:
Good day !

I've dealt with everything except sensorless !
Who can tell if you need to solder DIAG1 on TMC5160 ?
As far as I understand this is a necessity !?

Best regards.

Uri-34, 2020-03-20:
Good afternoon! All the existing problems have been solved for this day ! :) Thank You ...

Uri-34, 2020-03-20:
Go on ...

oldman4U, 2020-06-08:
Hello Uri-34.

Could you please close this ticket.

Thank you

oldman4U, 2020-06-15:
@bigtreetech Could you please close this unneeded ticket. Thank you

Thread 111 (2020-03-04):

SKR PRO 1.1 + TCM5160 with debug pin added "Bad Response"

yakumoklesk, 2020-03-04:
Hi. I have downloaded the bigtreetech branch for SKR-PRO-V1.1. I've soldered a pin on my TCM5160 diag hole. I am using TCM5160 driver mode, not standalone, and configured the pins. Also had set the TCM library dependency for the repository, although for some reason keeps downloading another that is version 0.6.2. In case I "force" to use the 0.4.5 from the repo, the compilation fails instantiation TCM5160Stepper constructor.

I really do not know what to do. I at least would like to know if in order to get a correct response to the M122 comand in the pronterface, I need to have the motors connected to the board, or is only enought to have the drivers and the 24 volts connected into Power and Motor power.

Thanks in advance.

[PlatformAndConfig.zip](https://github.com/bigtreetech/BIGTREETECH-SKR-PRO-V1.1/files/4287757/PlatformAndConfig.zip)

oldman4U, 2020-06-08:
Hello yakumoklesk.

Have you been able to solve the reported issue in the meantime?

Please let us know, thank you

oldman4U, 2020-06-15:
@bigtreetech Could you please close this unneeded ticket. Thank you

evandene, 2020-11-25:
Dear yakumoklesk,
where you able to solve the TMC5160/SKR Pro problem?
If so, can you tell me how?

Thread 112 (2020-03-08):

SKR PRO V1.1 + TMC5160. Random freeze while printing from USB/TFT

jukillo, 2020-03-08:
Hello mates,

I have been looking for a solution to this problem for two months.

When I try to print from USB or from BTT TFT24, the printer stops randomly. Motors on, heaters too: bad situation. Printing from S3D i receive Firmware unresponsive error when this happens. If i click on force next, the printer continues.

The only way to finish a job is printing from LCD 12864 SD.
I have tested several buffer configurations, thinking that this is the problem, but nothing changes. Several baudrates too.
Same problem with different versions of marlin 2. (now updated to 2.0.4.4)

Any idea?

Thanks.
Regards.

LegendAlexander, 2020-04-09:
@jukillo
what do you mean "print from usb" I thought the usb drive didn't work. How did you get it working?

davidmarli, 2020-04-22:
same problem here !!
Utmost printing file stop at a moment.
Where do you find the "force next" option ?

jukillo, 2020-04-22:
> @jukillo
> what do you mean "print from usb" I thought the usb drive didn't work. How did you get it working?

Printing from USB = Printing from computer.

@davidmarli , force next option is showed in S3D when you print via USB (from computer).

tphan26363, 2020-04-25:
I having the same problem.  Print Ok using SD card on TFT-35. When print over USB port it's randomly stop and Octorprint report no communication.  How ever I can see that the temperature still report correctly.  Use fake acknowledgement, I some time can get it moving again .  How ever it always report:
Error:Line Number is not Last Line Number+1, Last Line: 132
This is look like  the communication over USB port was having a problem and can't  get correct information from the USB port.  Also I can some time see that the printer suddenly trying
to move to a position that way out side the print bed...  This could be a result from noisy USB combine with bad error checking or timing problem in the planner

jukillo, 2020-04-25:
At least you can print in standalone using TFT-35.. Not I..

daviddominguez, 2020-05-09:
I have the same issue. Have you found the problem?

jukillo, 2020-05-10:
Nope.
I have given up.. and i know that more people have this issue, but nobody have solve it.

tphan26363, 2020-05-11:
I use a very bad and long usb cable.. and now it is not stoping any more. Good and high quality cable don’t work. Short cable don’t work. Now it’s time to look for cheap low quality cable...

jukillo, 2020-05-11:
I know that my problem is BTT touch communication. This is freezing uart communications randomly.

Printing from 12864 lcd, zero problems.

daviddominguez, 2020-05-11:
Im not using any TFT touch screen plugged on SKR 1.1, just a basic reprap discount screen, but even with this setup, USB connection dies (always) when I start printing through USB from simplify3D or randomly when connected. At least I can use SD card.

jukillo, 2020-05-12:
> Im not using any TFT touch screen plugged on SKR 1.1, just a basic reprap discount screen, but even with this setup, USB connection dies (always) when I start printing through USB from simplify3D or randomly when connected. At least I can use SD card.

SKR pro? what marlin version? What buffer settings you have?

daviddominguez, 2020-05-12:
> > Im not using any TFT touch screen plugged on SKR 1.1, just a basic reprap discount screen, but even with this setup, USB connection dies (always) when I start printing through USB from simplify3D or randomly when connected. At least I can use SD card.
>
> SKR pro? what marlin version? What buffer settings you have?

Yes, SKR 1.1 Pro with default buffer setting on bugfix-2.0.x branch

phlebaspho, 2020-05-26:
In my case, after much A/B testing I realised it was not the TFT35 or pronterface that was losing connection - it was "device connected to Marlin serial port 2" that experienced the the comms loss. Moving the host device (in my case TFT35-E3) to the first serial port in Marlin config.h fixed it.

jukillo, 2020-05-26:
> In my case, after much A/B testing I realised it was not the TFT35 or pronterface that was losing connection - it was "device connected to Marlin serial port 2" that experienced the the comms loss. Moving the host device (in my case TFT35-E3) to the first serial port in Marlin config.h fixed it.

Hum... interesting this.
How did you test it? I will check it this days..

Thanks for info!

jukillo, 2020-05-28:
Seems to work..

#define SERIAL_PORT 1
#define SERIAL_PORT_2 -1

I only tried prints of 1,5h about, but all them finished well.

phlebaspho, 2020-05-29:
I lucked into finding a particularly pathological piece of gcode that would trigger the hang up after about 7 minutes.

Then it was a case of change everything relevant trying to find anything that made it better or worse.

I'm now at 100+ hours of printing without that issue recurring (plenty of other issues with being a bit too aggressive on movement speeds lately).

jukillo, 2020-05-29:
Finally seems that the problem is solved. Im still printing batch series of 1.5h - 5h but all jobs has finished well

Thanks phlebaspho!

daviddominguez, 2020-05-30:
> Finally seems that the problem is solved. Im still printing batch series of 1.5h - 5h but all jobs has finished well
>
> Thanks phlebaspho!

Printing from USB or TFT?

jukillo, 2020-05-31:
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

From TFT.
I havent tried from USB yet.

daviddominguez, 2020-05-31:
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

Its good to know that at least you are able to print for TFT, let me know if you achieve to print from USB. I'm still stuck in this part

phlebaspho, 2020-05-31:
My experience is that I need a firmware  re-compile for that. I keep the TFT on port 1 by default - if I print over USB from pronterface/slic3r that device has the hang ups.

#define SERIAL_PORT -1
#define SERIAL_PORT_2 1

gives me print all day from USB.

#define SERIAL_PORT 1
#define SERIAL_PORT_2 -1

give me print all day from TFT.

Don't have a single build that swings both ways though.

daviddominguez, 2020-06-17:
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

Thanks for your help, but I'm still stuck trying to print from USB, your config doesn't work for me. I'll keep trying combinations.

jukillo, 2020-06-17:
David, do you tried to print from usb disconnecting the tft screen?

daviddominguez, 2020-06-17:
> David, do you tried to print from usb disconnecting the tft screen?

No, should I disconnect it from cables and use the following configuration?:

#define SERIAL_PORT -1
#define SERIAL_PORT_2 1

Thanks in advance

jukillo, 2020-06-17:
If the problems come from the com ports, with this we are sure that only exists one open communication.

Try it. Lost to the river...

daviddominguez, 2020-06-17:
> If the problems come from the com ports, with this we are sure that only exists one open communication.
>
> Try it. Lost to the river...

Same result :( this is quite frustrating.

Thread 114 (2020-03-10):

SKR PRO V1.1 +TFT35 V2.0 + 6 x TMC2130 SPI + Dual Z + Sensorless Homing

BrianS2K, 2020-03-10:
Hello,
I have 2 issues :
1) I have 2 Z motors, I test them individualy (with the 2 jumpers) they works, but when I connect the 2 motors they make an horrible noise and don't move, just vibrate....

2) I enable Sensorless Homing but when I home X or Y, Z move...

I wonder what I'm doing wrong?

Here is the Sensorless Homing code sequence :

#define SENSORLESS_HOMING // StallGuard capable drivers only

  /**
   * Use StallGuard2 to probe the bed with the nozzle.
   *
   * CAUTION: This could cause damage to machines that use a lead screw or threaded rod
   *          to move the Z axis. Take extreme care when attempting to enable this feature.
   */
  //#define SENSORLESS_PROBING // StallGuard capable drivers only

  #if EITHER(SENSORLESS_HOMING, SENSORLESS_PROBING)
    // TMC2209: 0...255. TMC2130: -64...63
    #define X_STALL_SENSITIVITY  8
    #define X2_STALL_SENSITIVITY X_STALL_SENSITIVITY
    #define Y_STALL_SENSITIVITY  8
    //#define Z_STALL_SENSITIVITY  8
    #define SPI_ENDSTOPS              // TMC2130 only
    //#define IMPROVE_HOMING_RELIABILITY
  #endif

BrianS2K, 2020-03-10:
I found the reason of my first issue

But I have allways the second issue (I have others but that'll for after solving this one

janoc, 2020-03-10:
I had the same problem - it is the TMC2130 driver issue. Disable the StealthChop (silent) mode on the Z axis in Marlin and the issue will be gone.

My hypothesis is that the driver expects certain impedance of the motor to be connected for the StealhChop mode to work correctly and when you connect two motors to the same driver this isn't satisfied anymore. And the driver goes nuts ... The classic Allegro A4988 is "dumb" and doesn't have this issue.

Alternatively you can configure the board to run one motor per driver (the dual Z axis setup), however this tends to desynchronize the Z axis motors fairly quickly - again thanks to the TMC2130 step interpolation when using the StealthChop mode.

These Trinamic drivers have unfortunately quite a few problems, it is nothing to do with the SKR Pro board.

BrianS2K, 2020-03-11:
I tried, I didn't change anything but maybe I missed something
I comment :
//#define STEALTHCHOP_Z

Tomorrow I'll try with a A4988 and cross my fingers...

But I saw also this line as I have TMC2130 V3.0 SPI should I also uncomment this ? :
  /**
   * Software enable
   *
   * Use for drivers that do not use a dedicated enable pin, but rather handle the same
   * function through a communication line such as SPI or UART.
   */
  //#define SOFTWARE_DRIVER_ENABLE

janoc, 2020-03-13:
My configuration is here:
https://github.com/janoc/BIGTREETECH-SKR-PRO-V1.1/tree/mendel90/firmware/Marlin-bugfix-2.0.x%20SKR%20ProV1.1-Dmeo/Marlin-2.0.xSKR%20ProV1.1-Demo/Marlin

Out of top of my head things that could cause issues:
- make sure you have 800mA current selected (in Configuration_adv.h)
- **do make sure you have heatsinks on the drivers** - super important because these drivers get really hot and throttle the motor current otherwise
- disable StealthChop as you did. I have it turned off on all axes and the extruder too.
- disable StallGuard and sensorless homing to make sure it is not getting triggered.
- enable MONITOR_DRIVER_STATUS and TMC_DEBUG. Check the messages/status in the serial console. If the driver is overheating or has some problem, you will see it there.

>But I saw also this line as I have TMC2130 V3.0 SPI should I also uncomment this ? :
No. I don't have it enabled neither. If that was required your motors wouldn't do anything at all because the drivers would never get enabled.

BrianS2K, 2020-03-15:
Hello,
I followed your advice, disabled everything, swaped drivers and I have always the issue.
When I use Single Z motor (Jumpers on the second Z port)

[SKR PRO V1.1 Single Z.mp4.zip](https://github.com/bigtreetech/BIGTREETECH-SKR-PRO-V1.1/files/4334019/SKR.PRO.V1.1.Single.Z.mp4.zip)

When I use Dual Z motor

[SKR PRO V1.1 Dual Z.mp4.zip](https://github.com/bigtreetech/BIGTREETECH-SKR-PRO-V1.1/files/4334018/SKR.PRO.V1.1.Dual.Z.mp4.zip)

janoc, 2020-03-15:
Uh, not sure what did you record those videos with because I had to use 3 different video players to play them - one was showing only a black screen and had sound, another showed only a static image with sound and third one showed video but no sound ...

That noise that you have when you connect two motors to a single driver is exactly the same what I had. For me disabling the StealthChop and setting the current to 800mA (also check the trimpot on the driver itself!) has resolved the problem.

Make sure  you don't attempt to run too high microstepping neither - e.g. I am at stock 16 microsteps and that you have followed the troubleshooting section here:

https://marlinfw.org/docs/hardware/tmc_drivers.html

Other things to try are replacing the steppers with something that has smaller inductance and/or increasing the operating voltage - e.g. Prusa runs these at almost 28V instead 12. However, that's an expensive and rather invasive solution, depending on how your machine is built.

If that doesn't fix it, then you have basically two options - either give a separate driver to each motor (the board has support for that) or swap the driver for something else, e.g. the A4988. This problem is unrelated to the SKR Pro.

BrianS2K, 2020-03-19:
Hello,

I tried with A4988 and the problem was the same so went back to the TM2130...
But I found a partial solution of the problem :
I checked the Z estep and they were at 4000 => changed to 400 and it turns.
unfortunatly whether I do UP or Down it only goes up ????
And I also have a horrible noise as long as the stepper is not automatically deactivated after 2 minutes ...

I start thinking possible that it is a mainboard issue :-(

janoc, 2020-03-20:
Ah that Z estep at 4000 is waaay too high. Normal 200 step/rotation motor and 16 microsteps has 200*16 = 3200 for a leadscrew with 1mm pitch. With my leadscrews that have 2mm pitch but 8mm lead, I have only 400 (200*16/8 = 400). So yes, that could well cause a problem because the motor is simply unable to keep up with the changing current from the driver.

The interesting noises the motors make when idle (it sounds like "psssshhh...shhh") are due to the Trinamic drivers. I was surprised by it too. There are some videos on Youtube on how to tune the parameters of the spread cycle mode so that it is not so noisy.

The motor noise and the torque issue has zero to do with the motherboard because there is nothing on it that has any impact on that. That's all motor drivers & Marlin setup.

The rotation direction problem is also most likely due to your Marlin build. But check whether the DIR pin on the driver sockets isn't shorted to something else by accident and that you have put the jumpers configuring the board for the different drivers correctly, especially if you were swapping things around for the Allegro driver.

BrianS2K, 2020-03-22:
Hello,
Thanks for all those informations and you're noise description is right :-D
I din't put the jumpers on the motherboard, it cames factory configured for 6x TMC2130.
I checked the pins and they are OK
Where in Marlin can I found the direction configuration ?

janoc, 2020-03-22:
> I din't put the jumpers on the motherboard, it cames factory configured for 6x TMC2130.

Hmm, then I do wonder. The documentation shows clearly that for testing with the Allegro driver you need to put in a jumper and for configuring the TMC2130 in SPI mode, you need to put 4 jumpers per motor in a different place and remove that one for the Allegro driver.

Are you really sure you have it set up correctly? My board came preconfigured for the TMC2130 in SPI mode, with the jumpers in place because I have ordered the drivers with it. But I haven't been testing different drivers in it.

See the manual here, page 7: https://github.com/bigtreetech/BIGTREETECH-SKR-PRO-V1.1/blob/master/manual/SKR%20PRO%20V1.1%20user%20manual%20v1.1.pdf

If these jumpers are wrong, then all bets are off.

The STEP/DIR pins are defined in:
Marlin/src/pins/stm32/pins_BTT_SKR_PRO_V1_1.h

However, I don't recommend messing with that, there is no reason for that to be wrong. You can always put a multimeter/oscilloscope probe on the DIR pin and see whether the value changes when you change direction of movement.

Charly333, 2020-04-04:
Hi, had the same issues when i first swapped Z roods to Pitch 2mm Lead 2mm.  Had to have M203 below Z10  and with M92 Z1616  - on MKS, SKR 1.3 and SKR 1.0 Pro.

I´ve now switched to Pitch 1mm Lead 1mm and have to have M203 below Z3 and M92 Z3232 . In my start gcode before UBL Bed leveling I reduce to Z2 and raise after leveling back to Z3. This gives me a  Standard Deviation: 0.002713 mm on M48 Z-Probe repeatability Test.

Thread 115 (2020-03-11):

How to flash bootloader?

chrstrvs, 2020-03-11:
Hi!

I accidentally shorted a IO pin to 5v and fried the processor. The rest of the board appears to be working, so I'm thinking of swapping the processor for a new one, but I need to flash the bootloader to it.
I understand that I need a ST Link programmer, but how do I hook it up to the SKR Pro board?

Thanks in advance!

Regards,
Christian

GadgetAngel, 2020-03-11:
@chrstrvs Check out this https://github.com/bigtreetech/BIGTREETECH-SKR-PRO-V1.1/issues/72

chrstrvs, 2020-03-11:
>
>
> @chrstrvs Check out this #72

Thanks, that's exactly what I needed!

danandmary, 2020-03-12:
For clarification :
1) Jumper BOOT0 Pin to 3.3V
2) Get and FTDI Adapter,
3) Download https://www.st.com/en/development-tools/flasher-stm32.html
4) Make sure logic voltage switch on FTDI Adapter is 3.3v
5) Connect to SKR Pro 1.1 as follows Connect 3.3v VCC and ground to UART VCC and ground pins
6) Connect FTDI TX to TFT Connector RX1 and FTDI RX to TFT Connector RX1 (For me the UART TX and RX Pins didnt work)
7) Open Demonstrator GUI, select the correct com port click next.  If error appears, check wires
8) If OK, message will confirm connection Click Next again and and Next Again
9) In the next screen click the ... near the downoad to device section and select the .BIN file to upload.
10) Click next and wait.
11) When done, dont forget to remove the BOOT0 jumper.

FYI Marlin firmware does not contain the bootloader, you'll need a copy of firmware which includes the bootloader.

Full Firmware including bootloader : http://cultivate3d.com/pub/media/BTTSKRPro1.bin

chrstrvs, 2020-03-12:
I will probably be using a ST-LINK adapter. Am I right in assuming that I will replace steps 4 to 10 with connecting the ST-LINK adapter to 3.3v, ground and SWD pin and use ST-LINK sw to burn the bootloader?

danandmary, 2020-03-13:
Im sorry I don't have an ST-Link.

npmomchev, 2020-04-03:
Is it possible for someone to share only  **bootloader.bin**  which does not include firmware in self

Thank You

codmpm, 2020-06-01:
As I've obviosly bricked my SKR 1.4, can someone point me to the *bootloader.bin* for it? It's an LPC1769 thus the SKR 1.1 bootloader won't work.

Also its difficult for me to find BOOT0 on the 1.4 board.
When I understood it correctly it should be R28 according to the schematics: https://github.com/bigtreetech/BIGTREETECH-SKR-V1.3/raw/master/BTT%20SKR%20V1.4/Hardware/BTT%20SKR%20V1.4-SCH.pdf
So I have to desolder R28 and pull it's pin low to be able to flash the bootloader.

AnHardt, 2020-06-01:
Dear @codmpm .
Here we are at the BIGTREETECH-SKR-PRO-V1.1 issue tracker. It's using a STM32F407 processor.
LPC-processors are completely out of scope here.

codmpm, 2020-06-01:
Oh, I'm sorry. I did see this when writing my comment.
Thank you!

AnHardt, 2020-06-01:
> I did see this when writing my comment.

And why did you do it anyway?

codmpm, 2020-06-01:
Sorry... *did not* see it.

schnello, 2020-06-20:
> 4. Make sure logic voltage switch on FTDI Adapter is 3.3v

Is this realy 3.3V?
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

c3D-Dan, 2020-06-20:
Yes. Just because there is a Lm7805 offering 5v pins does not mean the logic voltage runs at 5v.  Look at the stm32f4v7 datasheet.

schnello, 2020-06-20:
@c3D-Dan

jeffeb3, 2020-07-04:
@c3D-Dan, Thank you so much for these instructions and .bin file. I managed to bring an skr pro back from the dead, and finding these instructions were key for me. I couldn't get my FTDI dongle to work in windows (I'm not a windows expert), but I did manage to do it in Linux. Here's what I did:

1. Set the Boot0 to 3.3V jumper (it is labeled on the underside)
2. Connect the FTDI Rx to Tx3 (LCD), FTDI Tx to Rx3 (LCD), FTDI GND to GND (I used the LCD pin).
3. Connect the FTDI 3.3V to the 3.3V port near the LCD connector.
4. Installed `stm32flash` (I'm using ubuntu 18.04):
```
sudo apt install stm32flash
```
5. Run the stm32flash with the .bin file you provided, and the port that the FTDI uses:
```
stm32flash -w BTTSKRPro1.bin /dev/ttyUSB0
```
6. It took about a minute, and it confirmed it flashed to 100%
7. Remove the FTDI from the computer, and then undo steps 1 and 2. Don't forget the jumper.

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

Thank you again.

qweritos, 2021-10-01:
@c3D-Dan could you please re-upload the bootloader image and/or update the link?

schnello, 2021-10-01:
@qweritos
https://nextcloud.service-uplink.de/s/ZnYnXwMCPZjrRPL

schnello, 2021-10-13:
@ChrisS1986
I would do it as descriped it here:
https://github.com/bigtreetech/BIGTREETECH-SKR-PRO-V1.1/issues/115#issuecomment-653814967

GadgetAngel, 2021-10-13:
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

I just got my Octopus Pro board in and I own several Octopus V1.1 board too.  All I do to back up the SD Card bootloder is I use the Original (not a clone) ST-LINK-V2 device and hook it to the SWD connector on the Octopus V1.0/V1.1 board.  Then I bring up https://www.st.com/en/development-tools/flasher-stm32.html Software and hit connect to TARGET.  This always works but if you use a clone ST-LINK-V2.  It may not work.

IMHO, you need to spend the money and purchase an ORIGINAL ST-LINK-V2 if you own any Bigtreetech boards. You can find and ORIGINAL ST-LINK_V2 at https://www.amazon.com/ST-LINK-V2-circuit-debugger-programmer/dp/B00SDTEM1I

The ORIGINAL ST-LINK-V2 might cost $50 but it is like any other tool you buy.  You have to have the **right tool to get the job done**.  I have spent $70 (7 clone ST-LINK_V2 @ $10.00 each) on the clones thinking they died on me.  I wish I would had just laid down the $50.00 for the ORIGINAL at the very beginning!  The clones will NOT connect to some Bigtreetech boards if you are using WINDOWS OS (If you are using LINUX that is a different story)!  The ORIGINAL ST-LINK-V2 under WINDOWS OS will always connect to the board.

vwphan, 2022-01-18:
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

This method still worked as of 1/17/2022.  I was re-flashing using Ubuntu 20.04, it took several unsuccessful attempts to get the board to flash.  I had to hold the re-set button for approximately 30 seconds, wait a few seconds, then attempt to flash the board.  It took ~5 minutes to flash.

Good as new.  Thanks a bunch!!

pcipri76, 2023-10-27:
@c3D-Dan could you please re-upload the bootloader image and/or update the link?

qweritos, 2023-10-27:
@pcipri76 https://drive.google.com/file/d/1QW1IjdsDbjqhVf-OXsXqE0a_9XmiENuj/view?usp=sharing

pcipri76, 2023-10-27:
> @pcipri76 https://drive.google.com/file/d/1QW1IjdsDbjqhVf-OXsXqE0a_9XmiENuj/view?usp=sharing

Thank you very much

pullasuti, 2024-08-28:
I've been trying to get this to work, but just can't get stm32flash or Demonstrator to talk to the board. I'm thinking my board is truly dead... if I don't jumper BOOT0, the CPU gets very hot, also no memory card LED, and all the stepper LEDs are dimly lit. When jumpering either BOOT0 or BOOT1, the board does show up as a TTY device under Linux, but that's it.

I've tried it with a USB-TTL adapter and Raspberry Pi GPIO.

Any ideas or just give up and bin it? :)

qweritos, 2024-09-03:
@pullasuti, with a high probability you burned the stm chip, and dimmed LEDs is also a clue. Check 1117 LDO chip, it also gets insanely hot. However, I burned stm many times, but after reflowing&reflashing it always gets back in operation :)

Thread 116 (2020-03-12):

Part Cooling Fan not shared between multiple extruders

Rhage, 2020-03-12:
I have a multi-extruder setup with a single nozzle

The Slicer (Cura 4.5) is set to turn the print cooling fan on starting at layer 2.
When layer 2 begins the third extruder is active and the part cooling fan correctly turns on.

However, as soon as the active extruder changes, to either extruder 0 or 1, the cooling fan turns off and only resumes when the third extruder (number 2) becomes the active extruder again.

This continues for the rest of the print. The print cooling fan turns on only for Extruder 2 and is off for extruder 0 and 1

Any help would be appreciated.

Screenshots of Slicer settings and my Marlin Configuration.h and Configuration_adv.h files are attached

![Slicer_Cooling](https://user-
[Configuration .txt](https://github.com/bigtreetech/BIGTREETECH-SKR-PRO-V1.1/files/4321897/Configuration.txt)
[Configuration_adv.txt](https://github.com/bigtreetech/BIGTREETECH-SKR-PRO-V1.1/files/4321898/Configuration_adv.txt)

images.githubusercontent.com/14357200/76479182-fc960f80-63d8-11ea-96ea-e66d4ddcdd1d.PNG)
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

oldman4U, 2020-06-08:
Hello Rhage.

Have you been able to solve the reported issue in the meantime?

Please let us know

Rhage, 2020-06-08:
Yes, I was. But not in a way I'd probably advise duplicating.

It appears to be a bug/feature (depending on who you ask) of the Marlin 2.0 implementation of the m106 gcode

In my opinion it's a bug. The specification for that command states that when no fan parameter is provided with m106, which is how Cura sends this command with the setup I showed in my screenshots, it is supposed to default to Fan 0.

However, Marlin is defaulting the command with no fan parameter to the currently active tool.

I solved this by editing the Marlin source to always set the fan speed for m106 to all tool fans, which means my printer is no longer running the standard released version of Marlin 2.

oldman4U, 2020-06-09:
Good to hear you have been able to solve the issue.

Would you please be so kind to close this ticket then, by clicking on the Close button right besides the Comment button..

Thank you

Closed 2020-06-09.

Thread 117 (2020-03-22):

SKR PRO 1.1 + TMC5160, Homing is "working" but no other movement

mcmuff91, 2020-03-22:
Hello everyone,
atm I´am working on a big selfmade Delta-printer for Ceramics.
The setup:
- Skr Pro
- TMC 5160 V1.2 BTT (removed the CLK Pin)
- Nema 23, 3 A, 1,8°
- 24 Volt Power supply
- RepRap Full Graphic LCD

The main problems:

- When i send G28 via Pronterface or via the RepRap-Controller the printer starts to home. But one after the other (x,y,z). There is no movement of all three Axis at the same time, so I have to move the Effector to the upper end of the printer. The axes are hitting the endstops and doing a rebump . But after this there is no movement so the safe zone (enabled DELTA_HOME_TO_SAFE_ZONE)

After homing the Printer is not responding to movement commands via Pronterface or the Controller.

Tried multiple Versions of Marlin ( the BTT-Version, 2.04, 2.05).
I have no idea how to fix the Problem.

oldman4U, 2020-06-08:
Hello mcmuff91.

Could you please let us know the status of the reported issue and close this ticket, in case the issue has been solved in the meantime.

Thank you

oldman4U, 2020-06-15:
@bigtreetech Could you please close this unneeded ticket. Thank you

oldman4U, 2020-10-10:
Please help the community and close the ticket once you do not need it anymore. Thank you

evandene, 2020-11-25:
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

Did you get your DELTA Printer to work?

Thread 118 (2020-03-28):

Serial ports are gone

Charly333, 2020-03-28:
Had SKR PRO V1.1 working with 6x 5160 for a couple of month. Now after a restart TFT 35 and Octoprint won´t connect with serial ports any more.

Reflashed firmware that did run before: No serial found, neither by TFT 35 nor Octoprint or PC.
Flashing works, green LED flickers on start and firmware.bin is renamed to FIRMWARE.CUR. Did test several reformatted micro SD cards. Any LED shows the state expected.

First try: ---------------------------------------------------------------------

Reflashed BTT Marlin demo version with
#define SERIAL_PORT -1
#define SERIAL_PORT_2 1
#define  BAUDRATE 115200

The board is found in general. Windows 10 device manager prompts an "STMicroelectronics Virtual Com Port (COM5)" - but pronterface hangs whenever I try to connect the board via Com 5 and prompts this error lines .

Connecting...
[ERROR] Could not connect to COM5 at baudrate 115200:
Serial error: Cannot configure port, something went wrong. Original message: WindowsError(433

Windows Device manager on TMicroelectronics Virtual Com Port prompts: "status - working, no problems" but also knows in events - devide not migrated / still some installations needed.

Even if STM webside states that Win 10 doesn´t need any additional drivers, I installed the BTT STM Drivers but same results.

Second Try ---------------------------------------------------

Adapted newest original Marlin 2.0 with same Serial-Port Settings. After reflashing that firmware, board is not found as with old - former running - Version.

------------------------------------------------

Any idea hot to get it back running?

Reg. Charly

c3D-Dan, 2020-04-14:
Time to replace your stm32f4 cpu or your board.  If you do replace your CPU, you’ll need to initially upload firmware via FTDI adapter.  Details here https://github.com/bigtreetech/BIGTREETECH-SKR-PRO-V1.1/issues/115

dryflow, 2020-05-02:
Had the same behavior, SKR PRO with TMC2209, BL-touch, sensorless homing on XY, fans over EXP2, eeprom on SD, worked several weeks like a charm. Two days ago prints gone bad after a few layers and I wondered why. Thought it could be the nozzle, so I changed it. After this procedure the printer made a few moves, heated up and then nothing else. TFT and Octoprint lost connection.

Make a long story short: The termistor at the hotend had a problem, caused a short circuit. After I changed it and put the Marlin2.0 back everything working like a charm now. No need for replacing the board or the cpu. Maybe worth a try to check cabling and electric components.

oldman4U, 2020-06-08:
Hello Charly333.

Could you please let us know the status of the reported issue. In case the problem has been fixed in the meantime, it would be great if you could close your ticket.

Thank you

Charly333, 2020-06-11:
Had different experiences. Sometimes new Card and reflashing the board brings it back to live - sometimes - on other boards - it doesn´t. Specially the thermistor channels in SKR boards will crash the board if they are getting in contact with some voltage from the heater or so.

Closed 2020-06-11.

Thread 119 (2020-03-30):

No firmware update possible via SD card

chrisdruck, 2020-03-30:
I tried to make a setting in Marlin 2.0 bugfix so that I can describe the epromm and then I loaded the Firmware.bin. Because I could not set a command M500 Now I can no longer load firmware via SD card. Can I delete the firmware from the board. I can run M997 but then no M500

kolbolt, 2020-04-01:
I have been trying to fix or get the BIG-TREE-TECH skr pro V1.1 to work with marlin 2.0x bugfix by following this video on youtube [](https://www.youtube.com/watch?v=VsKHwYtqLz0).

And I got this for an error.

Processing BIGTREE_SKR_PRO (platform: ststm32; board: BigTree_SKR_Pro; framework: arduino)
--------------------------------------------------------------------------------
Verbose mode can be enabled via `-v, --verbose` option
CONFIGURATION: https://docs.platformio.org/page/boards/ststm32/BigTree_SKR_Pro.html
PLATFORM: ST STM32 6.0.0 > STM32F407ZG (192k RAM. 1024k Flash)
HARDWARE: STM32F407ZGT6 168MHz, 192KB RAM, 1MB Flash
DEBUG: Current (stlink) External (jlink, stlink)

PACKAGES:
 - framework-arduinoststm32 3.10700.191028 (1.7.0)
 - toolchain-gccarmnoneeabi 1.70201.0 (7.2.1)
Converting Marlin.ino
LDF: Library Dependency Finder -> http://bit.ly/configure-pio-ldf
LDF Modes: Finder ~ chain, Compatibility ~ soft
Found 17 compatible libraries
Scanning dependencies...
Dependency Graph
|-- <LiquidCrystal> 1.5.0
|   |-- <Wire> 1.0
|-- <TMCStepper> 0.6.2
|   |-- <SPI> 1.0
|-- <Adafruit NeoPixel> 1.3.5
|-- <U8glib-HAL> 0.4.1
|   |-- <Wire> 1.0
|   |-- <SPI> 1.0
|-- <Adafruit MAX31865 library> 1.0.3
|   |-- <SPI> 1.0
|-- <LiquidTWI2>
|   |-- <Wire> 1.0
|-- <Arduino-L6470> 0.8.0
|-- <SailfishLCD>
|-- <SailfishRGB_LED>
|   |-- <Wire> 1.0
|-- <SlowSoftI2CMaster>
|-- <SPI> 1.0
|-- <Servo> 1.1.2
|-- <IWatchdog> 1.0.0
|-- <Wire> 1.0
Building in release mode
Compiling .pio\build\BIGTREE_SKR_PRO\src\src\HAL\STM32\HAL.cpp.o
Compiling .pio\build\BIGTREE_SKR_PRO\src\src\HAL\STM32\HAL_SPI.cpp.o
Compiling .pio\build\BIGTREE_SKR_PRO\src\src\HAL\STM32\Sd2Card_sdio_stm32duino.cpp.o
Compiling .pio\build\BIGTREE_SKR_PRO\src\src\HAL\STM32\Servo.cpp.o
In file included from Marlin\src\HAL\STM32\../../inc/MarlinConfig.h:32:0,
                 from Marlin\src\HAL\STM32\timers.h:25,
                 from Marlin\src\HAL\STM32\HAL.h:121,
                 from Marlin\src\HAL\STM32\HAL.cpp:26:
Marlin\src\HAL\STM32\../../inc/../pins/pins.h:652:6: error: #error "BOARD_BIGTREE_SKR_PRO_V1_1 has been renamed BOARD_BTT_SKR_PRO_
V1_1. Please update your configuration."
     #error "BOARD_BIGTREE_SKR_PRO_V1_1 has been renamed BOARD_BTT_SKR_PRO_V1_1. Please update your configuration."
      ^~~~~
In file included from Marlin\src\HAL\STM32\../../inc/MarlinConfig.h:32:0,
                 from Marlin\src\HAL\STM32\HAL_SPI.cpp:25:
Marlin\src\HAL\STM32\../../inc/../pins/pins.h:652:6: error: #error "BOARD_BIGTREE_SKR_PRO_V1_1 has been renamed BOARD_BTT_SKR_PRO_
V1_1. Please update your configuration."
     #error "BOARD_BIGTREE_SKR_PRO_V1_1 has been renamed BOARD_BTT_SKR_PRO_V1_1. Please update your configuration."
      ^~~~~
In file included from Marlin\src\HAL\STM32\../../inc/MarlinConfig.h:40:0,
                 from Marlin\src\HAL\STM32\timers.h:25,
                 from Marlin\src\HAL\STM32\HAL.h:121,
                 from Marlin\src\HAL\STM32\HAL.cpp:26:
Marlin\src\HAL\STM32\../../inc/SanityCheck.h:1553:4: error: #error "HEATER_0_PIN not defined for this board."
   #error "HEATER_0_PIN not defined for this board."
    ^~~~~
Marlin\src\HAL\STM32\../../inc/SanityCheck.h:1751:8: error: #error "E0_STEP_PIN, E0_DIR_PIN, or E0_ENABLE_PIN not defined for this
 board."
       #error "E0_STEP_PIN, E0_DIR_PIN, or E0_ENABLE_PIN not defined for this board."
        ^~~~~
In file included from Marlin\src\HAL\STM32\../../inc/MarlinConfig.h:32:0,
                 from Marlin\src\HAL\STM32\Sd2Card_sdio_stm32duino.cpp:23:
Marlin\src\HAL\STM32\../../inc/../pins/pins.h:652:6: error: #error "BOARD_BIGTREE_SKR_PRO_V1_1 has been renamed BOARD_BTT_SKR_PRO_
V1_1. Please update your configuration."
     #error "BOARD_BIGTREE_SKR_PRO_V1_1 has been renamed BOARD_BTT_SKR_PRO_V1_1. Please update your configuration."
      ^~~~~
In file included from Marlin\src\HAL\STM32\../../inc/MarlinConfig.h:40:0,
                 from Marlin\src\HAL\STM32\HAL_SPI.cpp:25:
Marlin\src\HAL\STM32\../../inc/SanityCheck.h:1553:4: error: #error "HEATER_0_PIN not defined for this board."
   #error "HEATER_0_PIN not defined for this board."
    ^~~~~
Marlin\src\HAL\STM32\../../inc/SanityCheck.h:1751:8: error: #error "E0_STEP_PIN, E0_DIR_PIN, or E0_ENABLE_PIN not defined for this
 board."
       #error "E0_STEP_PIN, E0_DIR_PIN, or E0_ENABLE_PIN not defined for this board."
        ^~~~~
In file included from Marlin\src\HAL\STM32\../../inc/MarlinConfig.h:40:0,
                 from Marlin\src\HAL\STM32\Sd2Card_sdio_stm32duino.cpp:23:
Marlin\src\HAL\STM32\../../inc/SanityCheck.h:1553:4: error: #error "HEATER_0_PIN not defined for this board."
   #error "HEATER_0_PIN not defined for this board."
    ^~~~~
Marlin\src\HAL\STM32\../../inc/SanityCheck.h:1751:8: error: #error "E0_STEP_PIN, E0_DIR_PIN, or E0_ENABLE_PIN not defined for this
 board."
       #error "E0_STEP_PIN, E0_DIR_PIN, or E0_ENABLE_PIN not defined for this board."
        ^~~~~
In file included from Marlin\src\HAL\STM32\../../inc/MarlinConfig.h:32:0,
                 from Marlin\src\HAL\STM32\Servo.cpp:25:
Marlin\src\HAL\STM32\../../inc/../pins/pins.h:652:6: error: #error "BOARD_BIGTREE_SKR_PRO_V1_1 has been renamed BOARD_BTT_SKR_PRO_
V1_1. Please update your configuration."
     #error "BOARD_BIGTREE_SKR_PRO_V1_1 has been renamed BOARD_BTT_SKR_PRO_V1_1. Please update your configuration."
      ^~~~~
In file included from Marlin\src\HAL\STM32\../../inc/MarlinConfig.h:40:0,
                 from Marlin\src\HAL\STM32\Servo.cpp:25:
Marlin\src\HAL\STM32\../../inc/SanityCheck.h:1553:4: error: #error "HEATER_0_PIN not defined for this board."
   #error "HEATER_0_PIN not defined for this board."
    ^~~~~
Marlin\src\HAL\STM32\../../inc/SanityCheck.h:1751:8: error: #error "E0_STEP_PIN, E0_DIR_PIN, or E0_ENABLE_PIN not defined for this
 board."
       #error "E0_STEP_PIN, E0_DIR_PIN, or E0_ENABLE_PIN not defined for this board."
        ^~~~~
*** [.pio\build\BIGTREE_SKR_PRO\src\src\HAL\STM32\Sd2Card_sdio_stm32duino.cpp.o] Error 1
*** [.pio\build\BIGTREE_SKR_PRO\src\src\HAL\STM32\HAL_SPI.cpp.o] Error 1
*** [.pio\build\BIGTREE_SKR_PRO\src\src\HAL\STM32\HAL.cpp.o] Error 1
*** [.pio\build\BIGTREE_SKR_PRO\src\src\HAL\STM32\Servo.cpp.o] Error 1
========================= [FAILED] Took 12.99 seconds =========================

Environment               Status    Duration
------------------------  --------  ------------
mega2560                  IGNORED
mega1280                  IGNORED
rambo                     IGNORED
FYSETC_F6_13              IGNORED
FYSETC_F6_14              IGNORED
sanguino644p              IGNORED
sanguino1284p             IGNORED
melzi                     IGNORED
melzi_optiboot            IGNORED
at90usb1286_cdc           IGNORED
at90usb1286_dfu           IGNORED
DUE                       IGNORED
DUE_USB                   IGNORED
DUE_debug                 IGNORED
LPC1768                   IGNORED
LPC1769                   IGNORED
STM32F103RC               IGNORED
STM32F103RC_fysetc        IGNORED
STM32F103RC_btt           IGNORED
STM32F103RC_btt_USB       IGNORED
STM32F103RC_btt_512K      IGNORED
STM32F103RC_btt_512K_USB  IGNORED
STM32F103RE               IGNORED
STM32F103RE_btt           IGNORED
STM32F103RE_btt_USB       IGNORED
STM32F4                   IGNORED
STM32F7                   IGNORED
ARMED                     IGNORED
STM32F103VE_GTM32         IGNORED
STM32F103VE_longer        IGNORED
mks_robin_mini            IGNORED
mks_robin_nano            IGNORED
mks_robin                 IGNORED
mks_robin_pro             IGNORED
mks_robin_lite            IGNORED
mks_robin_lite3           IGNORED
jgaurora_a5s_a1           IGNORED
STM32F103CB_malyan        IGNORED
chitu_f103                IGNORED
STM32F401VE_STEVAL        IGNORED
FLYF407ZG                 IGNORED
FYSETC_S6                 IGNORED
STM32F407VE_black         IGNORED
BIGTREE_SKR_PRO           FAILED    00:00:12.986
BIGTREE_GTR_V1_0          IGNORED
BIGTREE_BTT002            IGNORED
teensy31                  IGNORED
teensy35                  IGNORED
esp32                     IGNORED
linux_native              IGNORED
SAMD51_grandcentral_m4    IGNORED
rumba32_f446ve            IGNORED
rumba32_mks               IGNORED
include_tree              IGNORED
==================== 1 failed, 0 succeeded in 00:00:12.986====================

can anyone help me out

oldman4U, 2020-04-01:
Hello Kolbolt.

Would be great if you could start your own ticket instead of using the ticket of another user.

You can find the error in the text you pasted above, where it says:
#error "BOARD_BIGTREE_SKR_PRO_V1_1 has been renamed BOARD_BTT_SKR_PRO_V1_1. Please update your configuration."

So please change the platform.ini file accordingly which should solve this problem.

Hope this helps

oldman4U, 2020-04-01:
@chrisdruck

Sorry that i can not help with your problem

kolbolt, 2020-04-01:
> @chrisdruck
>
> Sorry that i can not help with your problem

Ok

LegendAlexander, 2020-04-09:
you may have done this but did you move the jumper over to usb before starting the motherboard

LegendAlexander, 2020-04-09:
then just clear the sd and add the new firmware

oldman4U, 2020-06-08:
Hi chrisdruck.

Seems this ticket has not been used for a while, so could you please close it.

Thank you

oldman4U, 2020-06-15:
@bigtreetech Could you please close this unneeded ticket. Thank you

oldman4U, 2020-10-10:
Please help the community and close the ticket once you do not need it anymore. Thank you

Thread 121 (2020-04-05):

sensorless probing : not compiling ...

davidmarli, 2020-04-05:
Hi,

Itry to test sensorless probing, but marlin do not want to compile :
Skr pro 1.1 + 2130 spi divers. Marlin 2.0.5
I uncomment     #define SENSORLESS_PROBING
When I try to compil :

#error "SENSORLESS_PROBING requires a TMC stepper driver with StallGuard on Z."

How to fix it ? What am I wrong doing ?

Thank you for your help

Mariu86, 2020-04-06:
You must set the extruder 0 with tmc driver.

davidmarli, 2020-04-07:
Hi,

alreadey done, I have 5 tmc2130 driver.
In marlin, I wrote TMC2130 for driver X,Y, Z E0 and E1.
Still same bug when compiling.

oldman4U, 2020-06-11:
Hello davidmarli.

Could you please let us know the status of this issue? Please attach your config and config.adv file, in case you could not solve it in the meantime.

Thank you

davidmarli, 2020-06-12:
Work

Closed 2020-06-12.

Thread 122 (2020-04-05):

SKR Pro V1.1 Question about two Fans

MikeVanDike, 2020-04-05:
Hi Bigtreetech-Team,
i have a Question for you.
I want to cool my printet Object with two Fans.
How can i realize this?
Is it possible to connect two Fans on one Output (Fan0)? (whats the max Amp fore one Fanoutput?)
I try this and it smels not good :-S
Or can i conncet one Fan on Fan0 and another one on Fan1 and syncronice it in the firmware?
But how can i do this? :-/

LegendAlexander, 2020-04-09:
You may find this video helpful
[https://youtu.be/vweMI8OHxmY](url)

MikeVanDike, 2020-04-15:
I know Edwards Channel and this Video, but it is not helpful for me :-/
How can i define that when Fan0 is on that Fan1 is also on and Fan1 goes every time the same Fan Speed as Fan0?

BunniKiller, 2020-05-12:
you  could run the fans in a series wiring, but they will run at 1/2 speed...
POS volt supply---red wire---fan1---black wire----|---red wire---fan2----black wire----NEG volt supply..

GhostlyCrowd, 2020-05-12:
> you could run the fans in a series wiring, but they will run at 1/2 speed...
> POS volt supply---red wire---fan1---black wire----|---red wire---fan2----black wire----NEG volt supply..

this is a bad idea unless both fans have the EXACT impenitence one will run and the other will most likely spin at all.

The correct way to do this is to use the CORRECT settings in marlin to opwerate extra fans, Look at the Auto Extruder fan configs in the configuration_adv.h  and also  Controller Fan

```#define USE_CONTROLLER_FAN

//#define E0_AUTO_FAN_PIN -1
//#define E1_AUTO_FAN_PIN PE6 //Stepper cooling, turns on with Exturder
//#define E2_AUTO_FAN_PIN -1
//#define E3_AUTO_FAN_PIN -1
//#define E4_AUTO_FAN_PIN -1
//#define E5_AUTO_FAN_PIN -1
//#define E6_AUTO_FAN_PIN -1
//#define E7_AUTO_FAN_PIN -1
//#define CHAMBER_AUTO_FAN_PIN -1

#define EXTRUDER_AUTO_FAN_TEMPERATURE 50
#define EXTRUDER_AUTO_FAN_SPEED 255   // 255 == full speed
#define CHAMBER_AUTO_FAN_TEMPERATURE 30
#define CHAMBER_AUTO_FAN_SPEED 255```

BunniKiller, 2020-05-12:
if one has the file to open and look at it and do the proper "repairs" would be kewl, but sometimes all we are given is the firmware.bin file and I have yet to find a way to open and modify a bin file.  Im really new at this and have way more to learn than I have time... literally... cancer doesnt care about how much time one needs... but Im gonna learn as much as I can :)

MikeVanDike, 2020-05-26:
@GhostlyCrowd
Is it right when i make this

//#define E0_AUTO_FAN_PIN PC8 & PE5
or how can i synchronice it?

BunniKiller, 2020-05-26:
now thats a way I didnt think about..  but it works in ladder logic and
basic, I dont see why it wouldnt work in C++ type of language. Im not sure
of the "and" in C++ is... ( if its an ampersand or the word "and" or a +
sign)
give it a try, if it doesnt work then all thats been lost is some time.
seriously dont believe it will do any physical damage to the hardware.

On Tue, May 26, 2020 at 4:36 AM MikeVanDike <notifications@github.com>
wrote:

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

Thread 123 (2020-04-08):

SKR Pro V1.1 stops while working with octoprint

samgozman, 2020-04-08:
Serial port falls off during printing through an octopoint.
[Detailed video](https://youtu.be/rcAsfghPEvI)
Tried stock firmware and marlin 2.0.5. Octoprint connection is working only with baudrate  115200, and drops while printing.

To others, the problem with this board is:
- sd card never worked on it (No media) (sdsupport on)
- USB never worked

Also, the BigTreeTech TFT35 v3.0 display can never read the SD card and USB (read usb error).
Which leads me to the idea that I don’t have a single way to communicate with the SKR pro.

MikeEitel, 2020-04-21:
I agree that the impossibility to write a new .bin file via usb is a show stopper. Pitty me found that after i bought two complete mcu, lcd, driver combo's. Nice hw but not good supported sw. A shame.
Mike

phlebaspho, 2020-05-26:
In my case, after much A/B testing I realised it was not the TFT35 - or Pronterface it was "device connected to Marlin serial port 2" that experienced the the comms loss. Moving the TFT35 to the first serial port in Marlin config.h fixed it.

I don't have an SDcard issue though - so I can reflash firmware at will - so this might not help you.

oldman4U, 2020-06-09:
Hello samgozman.

Have you been able to solve the reported issues in the meantime?

Please let us know

Thank you

samgozman, 2020-06-10:
@oldman4U The problem is partially solved: SD cards working, but serial port via octoprint or simplify3d is dropping no matter the cable. And USB AM is still a dumb stub without any functionality

oldman4U, 2020-06-11:
Hi.

Great to hear the SD card is working now. Is this the SD card from the board or the TFT?

Yes, the missing USB drive support is a shame and many users would like to see this functionality.

Unfortunately i can not help with Octoprint - i am not using it.

oldman4U, 2020-06-11:
.... and have you tried to change the serial ports, like described here?

https://github.com/bigtreetech/BIGTREETECH-SKR-PRO-V1.1/issues/112

samgozman, 2020-06-14:
Yes, I studied all issues before publish mine. At first, the motherboard didn’t work on the wire at all, then I set it up so that it would at least respond to commands. But the connection falls off when printing in the first minutes after warming up. I tried several different cables, Raspberry pi Zero, Orange Pi Zero, Windows PC, MacOs - no luck.
I tried several combinations of serial ports. On some, the display did not work properly. Now I settled on the following combination:
```
#define SERIAL_PORT 2
#define SERIAL_PORT_2 -1
```

oldman4U, 2020-06-15:
Hi.

Changing the serial port solved the problem. I expect you have see and activated the Octoprint related setting in the TFT firmware:

Keep Serial always On (ONLY SUPPORTED ON TFT24 V1.1, TFT35 V3.0, AND TFT28 V3.0)

Keep UART (Serial communication) alive in Marlin Mode
Allow seamless OctoPrint UART connection to the TFT's UART/serial expansion port no matter which mode the TFT is in.

Options:  0: Disabled    1: Enable
#define SERIAL_ALWAYS_ON 0  // Default: 0 (Disabled)

Thread 125 (2020-04-09):

How Do You Print On A SKR PRO

LegendAlexander, 2020-04-09:
I have seen many comments and posts of the SD card slot not working and the USB port not working. I just want to know how can i print something on this board without having to buy some thing.

First let me say I am not an expert in any of this in fact I am nearly average so when you explain something please make it as simple as possible. My goal with this post is to learn how to print WITH THIS BOARD. Currently all I can do is extrude filament. Amazingly though I got everything else working thanks to the help of this community! I just want to print normal G-code from CURA. Before this main board on the stock ender 3 i would just insert an SD and navigate the lcd and print…done. On this one when I click “Init. Media” nothing happens.

My Setup:

- Standard Ender 3 hardware including display
- Skr pro v1.1 main board
- added another Z stepper motor ( So in total I have 2 Z stepper motors )
- 4x TMC2209 ( UART MODE )
- Marlin 2.0.3 For SKR PRO [https://github.com/bigtreetech/BIGTREETECH-SKR-PRO-V1.1/tree/master/firmware/Marlin-bugfix-2.0.x%20SKR%20ProV1.1-Dmeo/Marlin-2.0.xSKR%20ProV1.1-Demo
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
(url)

Hopefully with all your help I can get this working then ill have a fully functioning printer again! And I would also make a post explaining everything I did to get to this point which I think will help people facing similar problems with this board.

I have access to:

- Atom for Mac
- PronterFace for Mac
- Windows PC
- Mac PC

BunniKiller, 2020-05-12:
try using the bigtreetech_skr_pro_v1.1-master files/folder...
open/extract the zip and look in folder FIRMWARE, then open folder skrprov1.1 - marlinv2.0-12864p-16div-usually, copy the "FIRMWARE.bin" file and put on the SKR Pro board via the SD micro slot... turn on board and let it boot,   Things should work from that point...

and BTW is that a tft 35 video with touchscreen? if it is why are you using the encoder button? The touch screen option is sooo nice.

reipet, 2020-05-30:
I have the same question. I finally got the Board running as I need it and could print through Pronterface already, later will add Octoprint but for now I need the SD-Card Option.

Im using the SKR Pro v1.1. on a Ender5 with Dual-Z and TMC2209, BLTouch and additional Eeprom on the I2C Port. I also have an BTT TFT35 V2.0 but neither SD-Slot is working. I can select both (On-Board and TFT one) from the menu but then its stuck in "Loading"

How you Guys get this Board to print at all? Only via external G-Code stream?

oldman4U, 2020-06-11:
Hello @LegendAlexander.

Could you please let us know the status of the reported issue. Please close this ticket in case the problem has been solved in the meantime.

@reipet. Could you please start a new ticket, so someone can try to help. This ticket seems to be inactive.

Thank you

oldman4U, 2020-10-10:
Please help the community and close the ticket once you do not need it anymore. Thank you

mitchcecg, 2021-01-14:
Did you eve find the answer... I have the same issue ???

Thread 127 (2020-04-14):

How to add a filament runout sensor on skr pro

LegendAlexander, 2020-04-14:
I cant find any probe pins and i tried adding the sensor to the Xmax but it still wont act knowledge when filament is out. Actually i cant get the Xmax to trigger at all.

Aside from that i dont know where to remap the filament runout pin to since it seems there isnt one on the board.

I tried making this #Define Filament_Runout_Pin X_Max_Pin

Any ideas?

SrGeek, 2020-04-20:
plug in an endstops 1st and see if the led light next to the E0 turns on.  If it does the pin works you just have to find the right Marlin changes

AustrianBossFan, 2020-04-21:
i had the same problem today. i'm using a mechanical endstop as filament rounout sensor.
the board has 3,3v on the vcc pins of the endstop connectors. when high the signal pin of the endstop only had 1.5v. although the endstop is labeld as 3-12v it does not work with 3,3v.

for x and y i'm using optical endstops, they work fine with 3,3v.

i ended up using the extension-2 connectors 5V, GND and PE4 pins:
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

you need to change the filament runout pin in pins_BTT_SKR_PRO_V1_1.h:

#ifndef FIL_RUNOUT_PIN
  #define FIL_RUNOUT_PIN PE4
#endif

Baltazart, 2020-04-21:
Marlin 2.0.5.3 SKR-Pro v1.1 + Smart Filament Sensor

"pins_BTT_SKR_PRO_V1_1.h
#ifndef FIL_RUNOUT_PIN
#define FIL_RUNOUT_PIN PE15  //"PE15=Pin E0 X_MAX_PIN" SKR-Pro v1.1, SFS Smart Filament Sensor.
#endif
*****
"configuration.h"
#define FILAMENT_RUNOUT_SENSOR
#if ENABLED(FILAMENT_RUNOUT_SENSOR)
#define NUM_RUNOUT_SENSORS   1
#define FIL_RUNOUT_INVERTING true    //<<< pour moi c'est "true"
#define FIL_RUNOUT_PULLUP  
//#define FIL_RUNOUT_PULLDOWN
#define FIL_RUNOUT_PIN PE15    //<<<<SKR-Pro-v1.1 stock sensor E0 X_MAX_PIN.
*****
#define FILAMENT_RUNOUT_SCRIPT "M600"
#define FILAMENT_RUNOUT_DISTANCE_MM 7
#ifdef FILAMENT_RUNOUT_DISTANCE_MM
#define FILAMENT_MOTION_SENSOR
*****
configuration_adv.h
#define LIN_ADVANCE     //j'ai activer pour "Smart Filament Sensor" BTT SKR-Pro v1.1.
*****
Here is an SFS configuration that works for me 100% and we are entitled to a flashing E0_X_MAX LED.

To0wnn, 2020-06-10:
The PE15 I want to use for filament run out but somehow is does not work. It is assigend correctly in pins.h and using using marlin bugfix 2.0.x and with tft35 v3
Any ideas? With the M119 command i see it is working correctly.
[https://to0wnn.com:5001/sharing/EmN4oMFoo](https://to0wnn.com:5001/sharing/EmN4oMFoo) Here are my configs

oldman4U, 2020-06-11:
Hello @LegendAlexander. Have you been able to solve the reported issue? If so, could you please close this ticket, thank you.

@To0wnn: This ticket seems to be inactive for some time now. Could you please open a new ticket so someone can try to solve your problem.

Thanks

oldman4U, 2020-10-10:
Please help the community and close the ticket once you do not need it anymore. Thank you

Thread 128 (2020-04-15):

Weird behavior after plugging stepper motor

mqt0029, 2020-04-15:
I got mine to work on the test bench, so I took the motors drivers out to put on some heatsinks before actually drives the motors, and I plugged one of them in backward (or upside down I guess, doh!). Now the boards won't boot (TFT says no printer attached, command from ESP wifi doesn't reply anything, tried to reflash the firmware but it doesn't load the firmware.bin into FIRMWARE.cur)

Drivers are TMC2130 on XYZ and TMC2209 on E0,1,2, I plugged the X one in backward.

I've also checked for connectivity, in case I blew something, everything is good. I've also tried to reflash using ST-Link V2, but it says read out protected and I cannot disable it.

Any suggestion as to what to do now?

GhostlyCrowd, 2020-04-29:
you've fried the MCU Time for a new board

oldman4U, 2020-06-11:
Hello mqt0029.

Sounds like a hardware issue. Could you please be so kind and Close this ticket by clicking on the Close button right beside the Comment button.

Thank you

oldman4U, 2020-06-15:
@bigtreetech Could you please close this unneeded ticket. Thank you

Closed 2020-06-15.

Thread 129 (2020-04-16):

Skr pro tmc 2130 :tmc connection error

davidmarli, 2020-04-16:
Hello.
Just biught thé board.
I plug à tft3. 5 v3. 0 on it.
And 5 tmc 2130 spi v3. 0
In marlin I déclare tmc 2130 as driver for x y z e0 and e1.
Disabled all stealthchop and stallguard to test (if i enabled it that s thé same).
When i switch on, tft connectés to thé printer. Température are OK. I can heat thé bed and extruder, but it says tmc connection error and no motors can be driven...
Nothing happens...
Jumpers are OK (i tthink, 4 Jumpers per drivers in spi sockets.)

Thank you for your help...

Ps : marlin 2.0.5.3

kkosa1, 2020-04-16:
search online for "gadgetangel" and you will find a huge document.  starting around page 199 for your issues.  I tried to forward it to you but file was too large.  I followed the guide and all is working fine for me for last few months.  Also be sure to enable M122 function in Marlin via     #define MONITOR_DRIVER_STATUS on line 2265 of bugfix from 4-15-20 in configuration_adv.h  as well as   #define TMC_DEBUG at line 2345 also in configuration_adv.h

________________________________
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

oldman4U, 2020-06-11:
hello davidmarli.

Great to hear that everything works. Could you please help us to keep the ticket system useful by closing unneeded tickets.

Thank you

davidmarli, 2020-06-12:
Thank

Closed 2020-06-12.

Thread 130 (2020-04-17):

Drv8825 drivers not recieving power

SrGeek, 2020-04-17:
I check vfer to adjust but there is no voltage across the driver, attached is a picture of the pins for MS1,MS2,MS3 and D.  Marlin setting changed drivers to drv8825.  need help thanks.  I checked VCC to ground and there is power.  However Vref does not have power and I cannot trip the drivers.  Since the Power out to the bed had the polarity reversed maybe there is something else in the circuit that needs to change.
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

SrGeek, 2020-04-27:
really guys nothing?

oldman4U, 2020-05-11:
hi.

Have you see this guide made by an angel: https://github.com/GadgetAngel/SKR-PRO-V1.1-Stepper-Driver-Jumper-Configuration-Manual

Hope this helps

SrGeek, 2020-05-16:
@oldman4U Yes that’s why I put the pics.  They match the document.  I haven't seen any one resolve this in any of the forums either.  !
Most give up and just wait on the TMC2209 or something similar.  Pretty disappointed

oldman4U, 2020-05-17:
I had a similar problem with A4988 with green pcb. Finally i switched to
2209 with sensorless homing and i love them. You can only hear the noctua
fans and they are well known to be very very quiet.

Hope they will work for you like they do for me!😁

SrGeek <notifications@github.com> schrieb am Sa. 16. Mai 2020 um 07:50:

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

oldman4U, 2020-06-08:
Hello SrGeek.

What is the status of the issue?

SrGeek, 2020-06-13:
Still not resolved.  I got 2130 and 5160, I still cant get board to work.  Driver bad register problems.

SrGeek, 2020-06-13:
Not working is a stretch.  I can heat the bed, turn on the LCD display, turn on fans...but drivers....silent stepper drivers are too silent because they dont turn on.

SrGeek, 2020-06-15:
I have continuity between the power and ground pin of the motor power, once I changed the 15A fuse.  pretty frustrated.

oldman4U, 2020-06-15:
So a broken fuse caused this issue? And you found the issue - this is great!

SrGeek, 2020-06-18:
Motor power + and - are continuous.  My board is fried on all the driver sockets side.  Other than that everything else works, heaters, LCD etc.  My march order of SKR Pro boards never arrived (sad face) and Amazon doesn't sell them anymore.   So l am keeping the board stored somewhere maybe one day the PCB layout will become available and I will find what component  that got fried so I can solder in a new one.    Closing this issue.

oldman4U, 2020-06-18:
Hi. Have tried to change the fuse ?

SrGeek <notifications@github.com> schrieb am Do. 18. Juni 2020 um 02:33:

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

Closed 2020-06-18.

Thread 131 (2020-04-18):

Fan 0 ono more works ...

davidmarli, 2020-04-18:
I sould have done something wrong : the fan0 port osen't work anymore !!!
the led is not very bright.
Only 4V comes out ...
Is there a fuse to change ?
Fan 3 works well ...

Thank you for your help

blondak, 2021-01-25:
Ho, do you solve this issue, it looks i have same one. Thanks

davidmarli, 2021-01-25:
I didn't.
The first fan port is broken.
I use fan1 or fan2.

blondak, 2021-01-25:
Thank you for your quick response, it looks, that this board quiet bad, I also have issues with endstops when using ESP,...

Closed 2020-04-24.

Thread 132 (2020-04-24):

What a Bloody board !!!

davidmarli, 2020-04-24:
Hi, can't get printing with skr pro 1.1 !!!
Always bug.
I tried yet qith marlin 2.0.x bugfix ...
Now nothing is moving : homing failed reset ....

That's really shit ...

What version of marlin do you use and have you managed to uise this board ???

Thnak you and sorry, but that's a week I work on it all day, and always bug ...

GhostlyCrowd, 2020-04-24:
I'm on 2.0.x-Bugfix (bleeding edge) and its working fine for me.

I'd recommend turning off flash eeprom emulation and using SD though.

davidmarli, 2020-04-24:
Now an another bug : I try to print an object.
And about a few couple of minutes all is shifted ....
That's a CoreXY. Befor having this board I had a Re-arm+ramps, and it never failed !!!

Do you think disables eeprom emulation can do something ???

GhostlyCrowd, 2020-04-24:
if its shifted your steppers or drivers are overheating and missing steps. whats your actual hardware.  I am using this board with 2209's with out an issue and I had to switch to sd eeprom because it was bugged for my BLTOUCH

davidmarli, 2020-04-24:
Dont rhinl so.
Tmc2130 voltage 0.7.
Current max in marlin 1000
There is à 12v fan 80mm at full stock. When you touch thé drivers (after 30 min pronting) They are cold...

Now I try baudrate 115200 instead of 250000, my last chance...

GhostlyCrowd, 2020-04-24:
While its plausible that you have a defective board, you've gone from "no moving at all" to "now another bug layer shifting"  it sounds more like software or user error related than the board its self's fault.  My 2130's have had ongoing random layer shifting on marlin for over a year to the point that I went with Klipper on that unit and haven't had a layer shift since.

davidmarli, 2020-04-24:
I think I just find the pb :
I wanted to touch the driver to see how warm they was, and I just touch the motor Y cable and it moves !!! The printer jump steps !!!

My wires are with dupont, and it seems not to connect well on the board !!
What a mess ....

I don't how to improve connnection ...

GhostlyCrowd, 2020-04-24:
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

Try re-crimping them I guess? Not sure what to tell you I have mine connected with Duponts just fine.  This isn't really a bug and the issue tracker isn't the place to voice your frustration in your efforts to get your hardware set up correctly.

davidmarli, 2020-04-24:
Yes? I know, but  I buy that card thinking it was a good board.
But reading the web, I found many users with pbs ...
What does "recrimping" mean ? Enlgish is not my forst langage

davidmarli, 2020-04-24:
Admin can delete the issue...

Closed 2020-04-24.

Thread 133 (2020-04-25):

SKR PRO V 1.1 + TMC2208 UART

BaGRoS, 2020-04-25:
Everything looks like it works.

>SENDING:M122
		X	Y	Z	E
Enabled		false	false	false	false
Set current	700	700	1000	800
RMS current	673	673	994	795
MAX current	949	949	1402	1121
Run current	21/31	21/31	17/31	25/31
Hold current	10/31	10/31	8/31	12/31
CS actual	10/31	10/31	8/31	12/31
PWM scale	12	12	10	14
vsense		1=.18	1=.18	0=.325	1=.18
stealthChop	true	true	true	true
msteps		0	0	0	0
tstep		max	max	max	max
PWM thresh.
[mm/s]
OT prewarn	false	false	false	false
triggered
 OTP		false	false	false	false
off time	0	0	0	0
blank time	24	24	24	24
hysteresis
 -end		-1	-1	-1	-1
 -start		1	1	1	1
Stallguard thrs
DRVSTATUS	X	Y	Z	E
sg_result
stst
olb
ola
s2gb
s2ga
otpw
ot
157C
150C
143C
120C
s2vsa
s2vsb
Driver registers:
		X	0xC0:0A:00:00
		Y	0xC0:0A:00:00
		Z	0xC0:08:00:00
		E	0xC0:0C:00:00
Testing X connection... OK
Testing Y connection... OK
Testing Z connection... OK
Testing E connection... OK

> M119
SENDING:M119
Reporting endstop status
x_min: open
y_min: open
z_min: TRIGGERED

Unfortunately, the stepper motor won't move. Any of them.

BaGRoS, 2020-05-02:
Configuration problem
//#define SOFTWARE_DRIVER_ENABLE

Closed 2020-05-02.

Thread 135 (2020-04-28):

Double carriage and stallguard

abelsata, 2020-04-28:
Hi i am having trouble with dual carriage using tmc2130
When I try to activate dual carriage stallguard mode does not work on x.
If someone with an idex or who knows what may be happening would guide me, I would appreciate it.
my files are:

[Configuration .txt](https://github.com/bigtreetech/BIGTREETECH-SKR-PRO-V1.1/files/4548733/Configuration.txt)
[Configuration_adv.txt](https://github.com/bigtreetech/BIGTREETECH-SKR-PRO-V1.1/files/4548734/Configuration_adv.txt)

oldman4U, 2020-05-04:
Good morning.

Dual carriage on which axis?

abelsata, 2020-05-09:
Double carriage on x axis

oldman4U, 2020-05-11:
Sorry, but i can not help you. I hope someone else has a similar setup and can help.

onichan88, 2020-07-04:
Hello Abelsata, as I told you in the telegram group, you have to link the stallguard pin of the second extruser with the endstop signal of X_MAX with the cable that comes with the driver.

To not use of the cable, you can config the pins file of skr pro in the firmware of the skr pro v1.1 but I have to prove because I haven’t set that file OK.

But with the cable it works.

You can use M914 to see if the endstop its open and not trigered to see if it works. If it isn’t connected correctly, you will see that endstop as triggered.

I will post again when I get it working only modifying the pins file.

The problem is very similar to the problem with delta printer and stallguard.

oldman4U, 2020-08-26:
@abelsata

Could you please close this ticket in case you do not need it anymore. Thank you

Closed 2020-09-13.

Thread 137 (2020-05-09):

SKR PRO 1.1 - Can't flash the firmware.bin with SD Card

SevCr, 2020-05-09:
Hi.
Just purchased the above card with TFT35 and TMC2208 drivers.
Screen says printer not connected. Downloaded new firmware for screen with new icons, which has updated ok, but it is not talking to board.
Downloaded latest Marlin Nightly Build for the board. Compiled in VSC, copied to sd card, but nothing is happening. I put the card in, power up, screen still "not connected", can not connect SKR board to laptop via USB either. Installed USB drivers from SKR Github.
Still nothing. Can someone please give me a hand with this.
Thanks

oldman4U, 2020-05-09:
Hello SevCR.

Could you please take a picture which shows the connections you made between the SKR and the TFT.

Please also describe how you try to update the firmware and maybe you would like to attach the firmware here to your ticket.

I have a spare board where I can try things out, so I can check for you.

SevCr, 2020-05-10:
Hello oldman4U and thank you for response.

I have connected the screen following the diagram from github, this is quick sketch:
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

Regarding the flashing it goes like that:
1. Downloaded latest Nightly build from marlin 2.0 bugfix
2. Compiled in VSC with SKR Pro 1.1 build enviroment
3. Copy firmware.bin to SD Card
4. With SKR off plug in SDcard
5. Power up (tried both USB and 24V dc)
6. SKR comes on, screen comes on (note, I have read somewhere that an LED shoud be flashing - I have plenty of leds on, but none are flashing)
7. TFT displaying "No printer attached"
USB connection to PC not working - cant see any devices, Pronterface cant see any COM ports active.
I have installed USB drivers from Github:
STM_VCOM_1.3.1.rar
I have tried that many times, different USB cables, ports, with steppers plugged in and without, with steppers drivers plugged in and without.
[firmware.bin.txt](https://github.com/bigtreetech/BIGTREETECH-SKR-PRO-V1.1/files/4605661/firmware.bin.txt)
Added .txt as I couldnt attached the file here, when flashing it was just firmware.bin
I have this board for a couple of days and was unsuccesful in getting it to work.
I you can help I will be most grateful. Thanks
Sev

SevCr, 2020-05-10:
Pictures of card and screen:

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

oldman4U, 2020-05-10:
Hi.

Thank you for the pictures and the file.

I renamed the firmware.bin.txt file from you to firmware.bin, copied it on my SDcard and put it into my board. Once I powered it up, the firmware led started to flash green for about 10 sec. and stopped then. This means that the firmware has been loaded and I got it confirmed, because me TFT could not connect to the board any more (because I use 115200 Baudrate). So I changed the baud rate on the TFT to the 250000 shown on your fist picture and voila, connection established.

This means I can confirm that the firmware you sent to me can be loaded to an SKR Pro v1.1 and that a TFT display using 250000 baudrate can be used.

Before we go further we have to make sure that the firmware update all works on your machine. For this, no display and no USB connection has to be available, so please disconnect the display the USB cable and the two red cables currently connected to Hot Bed. Instead connect one + and - from your 12V or 24V power supply to the + and - labeled Power.

Take the firmware.bin file you attached to this ticket and copy it onto your SDcard. Put it into the SKR and try again to update the firmware.

Attached you can find a screenshot showing the LED which should flash during update.

Btw, are you using the SDcard which came with the SKR or another card or have you reformatted the card?

I would also recommend to change the two USB jumpers back to USB port, because USB drive doe snot work at the moment.

Please let me know
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

SevCr, 2020-05-10:
Hi.
Thanks a lot for comprehensive instructions.

I have tried that

> please disconnect the display the USB cable and the two red cables currently connected to Hot Bed. Instead connect one + and - from your 12V or 24V power supply to the + and - labeled Power.

Ive tried 2 different sd cards (one that came with board too), also tried formatting these.
I left it for about 20-30 seconds each time, but when I checked sd card it was the same file there. Shouldnt there be renamed file "FIRMWARE"?

Also the led you mentioned does not flash at all. For all the times I tried it never flashed.

I put the jumpers back to USB as you recommended, although those were like that for many trials I had before, and just changed them recently.

Does it mean the board is faulty?

Thanks for your help.

oldman4U, 2020-05-10:
Once the firmware is flashed, the file firmware.bin is renamed too firmware.CUR, but the led must flash during upload. The funny thing is, that you can rename the .CUR to bin and you can "use" it again.

For me this sounds like a faulty board.

;-(

SevCr, 2020-05-10:
Thanks a lot for your assistance. I had feeling someting is wrong with board.

> Once the firmware is flashed, the file firmware.bin is renamed too firmware.CUR
That is what I thought.

Anyway, I will get it exchanged and start again.

Once again thanks a lot!

oldman4U, 2020-05-10:
Hope you have more luck with the next board.

BunniKiller, 2020-05-12:
what worked for me was ...  ( SKR Pro V1.1 with a the TFT35 E3 V3 video) I had to download the version
BIGTREETECH_SKR_PRO_V1.1_Master.zip and extract it. Once I extracted, I opened folder " FIRMWARE", then opened SKRPROV1.1_MARLIN_V2.0_12864_16div-usually folder. Inside that folder is the FIRMWARE.bin file...  copy that to a TF ( SD Micro) card and insert it into the SKR PRO board and turn on machine, let it boot and activate the file. The TFT35 should boot and allow it a few seconds for the "Printer not found" message to go away... everything works on my unit except for the stepper motors...  but Im not done with tweaking the TMC5160 drivers.  Its really odd to watch the printer go thru its paces ( watch the timer and percentages count down) and not have steppers working. Basically like having the steppers unplugged :)

BunniKiller, 2020-05-12:
on a side note, once you have the issue above solved, you can use the USB port on the TFT35 to transfer files to be printed...

oldman4U, 2020-05-12:
Hi BunniKiller - again;-)

The problem is, that even without the TFT or anything else connected to the board, the firmware SevCR sent to me and which works fine with my SKR, does not update his board at all. The ability to connect the display or stepper motors or something else would have followed, once the board accept the firmware update.

oldman4U, 2020-05-26:
@SevCr

Have you got a new board in the meantime?

SevCr, 2020-05-26:
@oldman4U
Hi. Thanks a lot for your message. Due to problems getting SKR Pro 1.1 I am returning the faulty board and replacing it with SKR GTR 1.0

Would you have any recommendations as to the firmware or any particular settings for this board? I am upgrading Tronxy S5Pro (Core XY) and would like in the future to fabricate and install tool changer for 3 or 4 heads., but for now I want to get the printer to run as is.

New board just arrived and I have so far connected it to PC and TFT and it connects through Prontaface and the screen is connected to board as well, so it seems this one is working. Havent yet tried uploading new firmware, as I suppose I need to rebuild it to different board.

While searching internet for answers for my previous issue with the SKR Pro I have come acrross some info regarding running Klipper on SKR. Would that be good idea? I have read that Klipper is good for high performance fast printing. Do you have any experience with that?

Any advice will be much appreciate. Thanks a lot once again for your involvement.

oldman4U, 2020-05-26:
Hi SevCr.

Good to hear you got a new board. Unfortunately I have no experience with the GTR, nor have I ever tried Klipper. I am just a beginner with some knowledge related to the hardware I own, and because I got so much help from other users here, I try to give a little bit back. But because your issue is "solved" you may want to close this ticket and start new tickets for the GTR. I am sure there are others which can help you;-)

Happy printing

Closed 2020-05-31.

Thread 138 (2020-05-11):

LJC18A3-H-Z/BX with skr pro V.1.1

bananafell3r, 2020-05-11:

bananafell3r, 2020-05-11:
Hi guys, i tryied to use this sensor LJC18A3-H-Z/BX with SKR PRO V1.1 in new marlin and the red light is always ON (clear light) but when i try to go home, the red light becomes dark red (that's ok) but the z axis doesn't stop, it goes down... i have activate in marlin this feature:

#define Z_MIN_PROBE_USES_Z_MIN_ENDSTOP_PIN
#define FIX_MOUNTED_PROBE

how i can salve this issue?
I have connected the black cable in PG8 (Z MIN ENDSTOPS)
and the brown and blue in gnd and 12V.

bananafell3r, 2020-05-11:
This is my problem

https://drive.google.com/file/d/1VMj-ehpRwcDDY5n6_ybFmMqRmnI9LKbX/view?usp=drivesdk

oldman4U, 2020-10-10:
Please help the community and close the ticket once you do not need it anymore. Thank you

Thread 139 (2020-05-12):

HOT BED out terminals backwards

BunniKiller, 2020-05-12:
Just a heads up, the terminals ( screws) for the HOT BED output are marked opposite of the polarity that is actually being produced. I caught this by suprize.. I installed a relay for a 120VAC bed heater and the input on the relay required a DC volt input ( polarity sensitive), the relay wouldnt kick in even tho the relay led on the board showed it was on... I pulled out the volt meter to see how much voltage was being supplied to the HOT BED out terminals and found it to read -24v a.k.a. reversed polarity. So I swapped the leads on the screws and wala, bed heater relay is all happy and working now...  so, the boards polarity marking is wrong... it should read " - hot bed + "

oldman4U, 2020-05-12:
Hello BunniKiller.

This topic has been discovered right after the board has been released: https://github.com/bigtreetech/BIGTREETECH-SKR-PRO-V1.1/issues/57

It would be great, if you could close your ticket.

Thank you

BunniKiller, 2020-05-12:
Im new at this... how do I close it?

BunniKiller, 2020-05-12:
never mind i found the answer

Closed 2020-05-12.

Thread 140 (2020-05-12):

E0 don't work with all other axis working

George0023, 2020-05-12:
So, I’m trying to set up my new custom 3d printer with skr 1.1 pro, I got 3 axes working but for some reason, I can't get E0 working (I did disable cold extrusion). I tested the motors and drivers and they all work fine. So I thought maybe there is something wrong with the board, so I swapped everything to E1 and it still doesn't work. Please help.

oldman4U, 2020-05-13:
Hi George.

Stupid question. And you assigned a stepper motor driver to E0...

Happened to me, that i assigned a thermistor to the chamber instead of the bed....

What a difference a line makes - sometimes

Georg

George0023, 2020-05-14:
the heater for the hot end heat up correctly so, and when I press the extruder button I do feel the motor energize. so that shouldn't be a problem. Also, I cant get UART with tmc2208 fysetc by working with the printer. So I end up switching to ramps 1.4, and everything works fine, probably a board problem.

Closed 2020-05-14.

Thread 142 (2020-05-19):

CoreXY not printing square

DaVincIan, 2020-05-19:
I have a CoreXY printer that is 400 mm cube.

I'm driving the stepper motors with TMS2130 drivers. Everything is working fine, BLTouch homing, WiFi, SD card, ect. and 12896 LCD Bigtreetech LCD.

Currently I have Marlin 2.0x with Configuration 2.05.

I perform the SOP, homing X, Y, Z (in centre of bed). For testing, I move to X10, Y10. When I move to X10 Y370, the extruder "drifts" (moves) the left (<X10) by about 10 mm. I looks as if it only starts at Y > 200 mm. Moving X10 Y10  to X370 Y10 is no problem.

When I move from X370 Y10 to X370 Y370, it drifts to the right (>X370).

I checked acceleration, velocity, jerk. No effect. I checked the TMC drivers (swopped them out). Ii even tried DRV8825 drivers. No difference.

When I move the extruder at 45 degrees (then only one motor is activated) and yes, only one stepper is turning. The second stepper stays fixed.

I would really appreciate any comments.

DaVincIan, 2020-05-20:
For all interested parties, I managed to solve the problem. It was a belt  with a broken core, causing it to stretch. Actually in my case both belts had a broken core.

Closed 2020-05-20.

Thread 144 (2020-05-24):

SKR pro 1.1, TMC2208 UART, unable to set micro steps permanently.

DarkShadowsX5, 2020-05-24:
M122 reports that the micro steps is set to 8 but i set them to 32 in firmware.
01:11:13.042 : msteps		8	8	8	8
01:11:13.074 : tstep		        max	max	max	max
previously it reported that they were set to 256 before soldering the jumper but still moved as if in 1/8th mode.

#define X_MICROSTEPS 32
set on each driver in use. each have the jumper soldered and the single red jumper on uart mode next to the driver on the SKR pro 1.1 board.
my steps in configuration.h are currently set to 80 for xy but it moves 20mm instead of 5mm.
(i will set it to a proper 160 so it moves 10mm for 10mm when its working. )

not sure what i can do at this point. Maybe im missing something for proper UART. the documentation and video tutorials are all over the place with all the changes. everything seems out of date.

for the jumpers i soldered on the driver, there was 2 options and i chose this
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

DarkShadowsX5, 2020-05-25:
Upon further investigation i found that hitting the reset button on the tft24 screen board fixes the issue BUT when i do a full power reset and wait for the led to turn off. its reset to 1/8th mstep movement again. hit the reset on screen board and its at 32 msteps....

something must be conflicting causing it to boot in 1/8th msteps but be overwritten to what you set the drivers at in Configuration_Adv.h with a soft reset. so the issue is only temporally corrected.

someone who knows marlin code more intricately may be able to permanently fix the issue.

MarciV2, 2020-10-17:
I have the same issue on my E0-driver slot.
It's not the stepper driver but the slot on the board (at least for me).
Also looking for a solution...

DarkShadowsX5, 2020-10-17:
@MarciV2
i dont know what exactly caused it to finally work correctly but it takes my micro step changes without a fuss now.
i reset it and reprogrammed it a bunch is all i could say on that. the reset button on my LCD panel had the most helpful impact in getting it to work temporary. there might be something in the firmware your overlooking for E0.
i'm sorry i forgot all that i changed at this point that might have fixed it for good.

i recommend keeping E0 at 16 micro-steps. it has the least impact on print quality compared to 32 micro steps on xyz

I had to change a lot of setting to get my printer working correctly and smoothly.
nothing i changed had anything to do with the memory or Eprom. I can give you my firmware files but it likely wont work well with your printer. I have a 5 year old acrylic frame prusa clone. I'm just offering it as something to look over and compare.

MarciV2, 2020-10-17:
@DarkShadowsX5 The weird thing is, that suddenly the board doesn't even connect the driver anymore...
I've already contacted the BTT support too because the fan pins don't work either...

I have set all of my axis to 1/16 ustepping and sometimes e0 changes to 1/8 while e1 gets set to 1/256 which the drivers (TMC2209) don't even support.

DarkShadowsX5, 2020-10-18:
you might have an actual hardware issue with the stepper drivers. did you try swapping them around to see if the problem moved?

as for the fans its a bit off topic but this is my settings.
the fan pins were a pain to setup in firmware.

in pins_BTT_SKR_PRO_V1 i have the fans pins as:
#define FAN_PIN        PC8
#define FAN1_PIN      PE5
#define FAN2_PIN      PE6

#define E0_AUTO_FAN_PIN      FAN_PIN

in configuration_adv.h, i have
#define E0_AUTO_FAN_PIN PE5

not sure if this change was necessary but
#define FANMUX0_PIN  PE5

i had EXTRUDER_AUTO_FAN_TEMPERATURE working for FAN1_PIN at 50c
without doing these changes i was getting heat creep and E0 skipping issues. one time it was so bad i had to change the bowden tube adapter because it jammed up.

Closed 2022-01-07.

Thread 145 (2020-05-24):

Z mechanical endstop not working with X/Y Sensorless

rhukster, 2020-05-24:
I've spent hours scouring the web looking for a solution to this with no luck.  Let me outline my configuration:

I'm building a BLV MGN Cube printer with SKR Pro 1.1.  It has a triple-z axis setup that i'm going to level with a TH3D EZABL Pro sensor.  However, even before I get to fully testing the sensor, I'm stuck getting the Z endstop to detect being triggered using a simple OMRON mechanical switch.

This issue is that I have X/Y axes configured with sensorless homing  with 2209s (diag pin intact), and my Z0, Z2 (E1) and Z3 (E2) drivers, also 2209s (diag pin de-soldered).  The endstop lights next to the extruder connectors are completely off for X/Y/E0, and are dim for Z1, Z2, Z3.

Because I have my Z endstop inverted in Marlin, when I plugin in the endstop the Z1 light turns on, and when i trigger my the endstop by hand (which is connected to Z_MIN endstop on the board), the Z1 light turns off.  So it seems the board itself is registering the endstop being triggered (even if it's inverted at the moment).

However, while doing this, the `M119` command always reports the end stop is `open`:

```
[...]
Send: M119
Recv: Reporting endstop status
Recv: x_min: open
Recv: y_min: open
Recv: z_min: open // not activated by hand (board light on)
Recv: ok
[...]
Send: M119
Recv: Reporting endstop status
Recv: x_min: open
Recv: y_min: open
Recv: z_min: open // activated by hand (board light off)
Recv: ok
```
I've tried pulling all the drivers, and also removing all stepper cables, so only the 1 single Z-endstop cable is attached, and the problem still remains! It seems to me that either there is a physical issue with the board (strange as the light on the board is changing properly), or it's some weird Marlin thing that I've set by accident? I'm using the very latest Marlin `2.x-bugfix` branch that I merge daily so that is 100% fully up to date as of right now.

BTW, sensorless homing on X and Y is working just fine with `G28 X Y`, no issues there at all!

Attached are the configuration files.

Any help with this would be greatly appreciated!

[Configuration-Files.zip](https://github.com/bigtreetech/BIGTREETECH-SKR-PRO-V1.1/files/4674537/Configuration-Files.zip)

GhostlyCrowd, 2020-05-24:
Andy, have you followed the correct guidelines for TMC 2209's and cut the proper pin off the stepper driver for the Z so it allows the limit switch to work?

rhukster, 2020-05-24:
Yes, as I originally stated, i have de-soldered (removed) the diag pins on all 3 of the Z-Axis 2209s.  The X, Y and E 2209s still retain their pins.. XY is working fine for sensorless homing. I don't believe the endstop lights on the board would illuminate at all if this was not the case?

GhostlyCrowd, 2020-05-25:
Sorry missed that on mobile i just assumed it was the easiest answer. Ive had a look at your configs nothing is glaring at me.  I'd probably post a bug report on the Marlin bugfix main repo.

rhukster, 2020-05-25:
I just want to make sure it's not a physical board issue before I post on the Marlin repo, but that was definitely my next stop if folks like yourself who are familiar with the SKR Pro, couldn't find any obvious issues. Thanks!

GhostlyCrowd, 2020-05-25:
> I just want to make sure it's not a physical board issue before I post on the Marlin repo, but that was definitely my next stop if folks like yourself who are familiar with the SKR Pro, couldn't find any obvious issues. Thanks!

Just to be clear so i understand, youre using a probe for levelling, the probe is NOT the z endstop, youre using a limit switch as z endstop and the BTT SKR board is showing the proper led configuration for open and trigger of the endstop on z?

If the above is all correct i think you have found an actual bug.

rhukster, 2020-05-25:
I intend on using the probe, but it's not connected right now.  Right now i just have a mechanical endstop plugged into the Z_MIN on the board.  So I have configuration in the files for the probe, but have not gotten that tested yet.

I originally tried the probe connected to the same Z_MIN (as you are supposed to configure it as it uses it's own controller box).  It did trigger on the EZABL Pro control board correctly (lights up), and also triggered the SKR Pro Z endstop light.  So basically it did exactly the same thing as the mechanical switch.  However, both the mechanical switch and the EZABL triggering still did not show any change via the `M119` command. So I don't think this is probe related as there's not any special probe pins required here.

It seems like the board is seeing the endstop being triggered just fine, but Marlin is not able to detect this via `M119`.  I am using the stanard Z_ENDSTOP pin (`PG8`)

rhukster, 2020-05-26:
Was my own fault! I had the endstops connected to Signal + V, instead of Signal + Ground.

Closed 2020-05-26.

Thread 148 (2020-05-31):

Downloading .bin file via usb

MikeEitel, 2020-05-31:
I tried to download a new  firmware.bin file on a running marlin 2.5.3 marlin.
I have not been able to do this.
It is a pain in my diy deltas to exchange the sd for every new version.
What do i wrong?
Thx Mike

P. S.
2x  skr pro with 6x tmc and tft 3.5

oldman4U, 2020-06-02:
Hi. What is the size of the firmware you try to upload?

More details what exactly does not work could also help.

Thank you

MikeEitel, 2020-06-02:
Can not remember but it is no matter of size.
When i write directly on the sd it works perfect.
I can not access the sd via ubs on the mks pro only. And i know generally how to do. As doing the same process with mks sbase works perfect.

AnHardt, 2020-06-02:
> What do i wrong?

Absolutely nothing.
It does not work now.

Up to now this is not implemented for the STM32F4xx boards.
There are shy tries at https://github.com/stm32duino/Arduino_Core_STM32/pull/586 to prepare the MMC/CDC composite device for the used framework. But this is currently for SDIO only. Until a SPI version will reach Marlin another year will be gone.

MikeEitel, 2020-06-02:
That is a shame.
The board is nice.
But producing a board based on a chip that has not full sw support for the intented main market. That does not earn my respect.
Mike

oldman4U, 2020-06-02:
Maybe you will ask for other missing features like usb stick support or
print from sd card. Simple led support or filament runout sensor
connectors. - nope. But you get superb power handling, three controllable
fans and ESP01-S FW update through the board.

Hope this helps

Mike Eitel <notifications@github.com> schrieb am Di. 2. Juni 2020 um 11:20:

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

MikeEitel, 2020-06-02:
Does that mean that ESP01-S can write the firmware.bin to the onboard sd, so i do not have to dissasamble my printer for every change?

And sorry, i stick to my opinion: upgrade of the firmware via usb is a basic feature since long time. As an producer neglecting such a basic functionality is in my eyes not state of the art customer orientation

AnHardt, 2020-06-02:
The other way around. SKR-PRO-V1.1s boot-loader can update a connected ESP01-Ss firmware from the onboard SD-card.

oldman4U, 2020-06-02:
Hi Mike.

We all would love to see better USB and SD card support. At least the
possibilities and what does not work should be defined much better.

Mike Eitel <notifications@github.com> schrieb am Di. 2. Juni 2020 um 13:48:

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

oldman4U, 2020-06-08:
Hi Mike.

Do you still need this ticket? If not, could you please be so kind and close it.

Thank you

MikeEitel, 2020-06-08:
To be honest
I'm verry tempted to let it in, as missing possibility is a main design feature. A customer oriented supplier should take such sw related drawbacks into acount!
You won't buy a fine sportscar when forced to fuel it by can just behind the rear seats.
The board itself is very nicely made hw, and i guess would have high sales potential. But my impression is that BTT does not do enough for firmware support to assist the marlin comunity. Myself will probaly not think good about btt everyytime i do upgrade on my two fully equipped 6axis boards.

MikeEitel, 2020-06-08:
But to be no too nasty i will close this not solved request

oldman4U, 2020-06-08:
Hi Mike.

I agree with you and I am not working for BTT or get paid by them. I am just a user who tries to clean up the tickets so someone new can find a topic before he starts a new ticket.

AnHardt, 2020-06-08:
Recently there was some movement.
https://github.com/stm32duino/Arduino_Core_STM32/pull/1088
https://github.com/MarlinFirmware/Marlin/pull/17222
https://github.com/MarlinFirmware/Marlin/issues/18157

So maybe i was a bit to pessimistic. (But still a long way to go.)

MikeEitel, 2020-06-08:
Thx Anhardt and oldman4u
I'm aware of the progress in Marlin. Looking nearly every day whats going on.
It's this situation that good peoples like you are trying to solve problems, and not a company like BTT what has to be clearly stated.

Again Big thx for you
Mike

oldman4U, 2020-06-08:
Hi Mike. Feel free to be people like Anhardt and me😁

Mike Eitel <notifications@github.com> schrieb am Mo. 8. Juni 2020 um 15:13:

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

Sineos, 2020-06-08:
See here for a potential work around I'm using: https://github.com/OctoPrint/OctoPrint/issues/3522

Closed 2020-06-08.

Thread 149 (2020-06-11):

24v fan

drmshady, 2020-06-11:
hi

can I use 24v fan and hot end heater
thank you

oldman4U, 2020-06-11:
Hello drmshady.

This depends on your power supply. The SKR supports 3 different power inputs for Motor, Main and Bed and you can connect 12V OR 24V to each of the inputs. In case you connect a 24V power supply to the MAIN input, you will get 24V on the Fan and hot end output - in case you connect 12V, you will get 12V on the outputs.

Please let me know if you ned any additional information

drmshady, 2020-06-12:
Thank you
I have 24v power supply, so I think  it is ok

oldman4U, 2020-06-12:
It is. I need a downconverter to drive my 12v noctua fans.

Please do not forget to close your ticket once you don’t need it anymore.

Thank you

drmshady <notifications@github.com> schrieb am Fr. 12. Juni 2020 um 09:06:

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

pedrovanzella, 2020-09-11:
@oldman4U how did you hook up the buck converter to power your 12V Noctua Fans on a 24V Power Supply?

oldman4U, 2020-09-11:
Hi.

I connected the converter to the power supply output which also feeds the mainboard main input.

In another setup i used the 24v fan out and connected two fans in a row. But this does not work so well.

Closed 2020-06-12.

Thread 151 (2020-06-27):

MicroSD card reader no longer recognises any cards

Malaquitte, 2020-06-27:
Hi,

The micro SD port on the motherboard suddenly stopped working. The TFT35 screen displays the following message "Read onboard SDCard error". I tried a lot of different sdcards, with different format type, never mind. I am now completely stuck because I have no way to flash the firmware on my motherboard.

Any ideas are welcome...

oldman4U, 2020-06-27:
So this happened after a firmware update?

Malaquitte, 2020-06-28:
Maybe, to tell the truth, my last flash was a few days ago and since I use the TFT35 usb port to print, I didn't realize it immediately.

oldman4U, 2020-06-28:
And firmware you can still upload?

Malaquitte <notifications@github.com> schrieb am So. 28. Juni 2020 um 10:16:

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

Malaquitte, 2020-06-28:
none anymore, that's the problem. No matter what file I have on a card, the message is always the same.

oldman4U, 2020-06-28:
Turn the printer off. Disconnect the TFT from the mainboard. Compile a firmware.bin file, copy it onto a SD card and insert the card into the SD card slot of the mainboard. Turn the printer on. Can you see the firmware update LED flash on the mainboard for approximately 10 seconds, before it stops flashing?

Malaquitte, 2020-06-29:
It's perfect, I managed to flash my motherboard and by plugging my screen I can now flash again.
Thanks for the advice, I would never have thought to incriminate the screen...
That said, it's hard to understand it, sometimes the screen stays black under the Marlin interface after a flash, sometimes the .bin file is not deleted but I see the green led blinking!

oldman4U, 2020-06-29:
So there is some improvement, that's great.

Please let me know in case there is anything else I can help you with. In case everything works fine, please help us to keep this system usable by closing this ticket

Thank you

Closed 2020-06-29.

Thread 152 (2020-06-28):

SKR Pro v1.1 TMC2209v1.2 does not sensorless homing

Majestix1970, 2020-06-28:
Hi all,

I have a problem with my new SKR Pro v1.1 and my  TMC2209 v1.2 Driver.

The driver have been used fully functionally in my old SKR 1.4Turbo. After switching the board using the old Marlin 2.0.5.4 configuration sensorless homing stopped working because it does not move at all when doing G28.
First I thought I need to readjust the sensitivity, but reducing it from the old values (x=130 y=190) to x=54 and y=100) it started to move but bumps hard into the end position with about 3 sec of making noise...
If I adjust the new values  eg. by +1 to X=55 it stops moving again... same for y.
Then I thought it might be the TMC current. I changed it from the default Marlin value 800mA to 1100mA for all stepper drivers. Unfortunately did not help either.

Any ideas what the issue might be?
Printer is an cartasian Geeetech i3 Pro C Prusa clone.
Was working perfectly with the SKR1.4Turbo...
TMC2209 also work perfectly with the SKR1.4 Turbo.

Hope you can help.
Best regards
Majestix1970

Majestix1970, 2020-06-28:
[Configuration_and_Configuration_adv.zip](https://github.com/bigtreetech/BIGTREETECH-SKR-PRO-V1.1/files/4842881/Configuration_and_Configuration_adv.zip)

Majestix1970, 2020-06-28:
here are my .h files...

Majestix1970, 2020-06-29:
sorry closed it unintentionally....

oldman4U, 2020-06-29:
Hi.

I use the same board and driver and it works perfectly. I am sure we do not use the same motors and maybe also other factors are different, so there is not a lot to say - but it does work in general. I saw huge difference depending on the stiffness of the belts and i use 200mA for sensorless homing.

Hope this helps

Majestix1970, 2020-06-29:
Hi oldman4u
Thanks for your reply...
My motors are simple NEMA17 driven with 24V
Belt strength I did check already
and overall the exact same mechanical setting is working fine with the SKR 1.4 Turbo😂
I assume I got a faulty board.. Grrr

oldman4U, 2020-06-29:
I have 2 SKRs in the meantime, one for testing and one in my printer;-)

So what are you going to do next?

Majestix1970, 2020-06-30:
I am requesting an HW replacement of the SKR Pro 1.1 board
I do not see any issue with my configuration!

The board is also behaving completly unpredictable. One time the same sensitivy setting makes the print bed hit hard the end position. Next time it does not move at all because it is too sensitive.

oldman4U, 2020-07-01:
Sounds good and makes sense.

Last question. Are you using 12V or 24V and which power supply are you using?

Majestix1970, 2020-07-01:
Hi
I use 24V and a regulate switched Power supply with 15A.

Why?

oldman4U, 2020-07-01:
I saw some other tickets in the past, where a broken or cheap power supply also caused random issues.Maybe i can find some time to update to your Marlin version, which version are you using at the moment? 2.0.5 or the latest and greatest from GitHub?

oldman4U, 2020-07-11:
Hi. Any news regarding the reported issue?

oldman4U, 2020-08-03:
@Majestix1970

Please close this ticket in case you do not need it anymore

Thank you

oldman4U, 2020-08-26:
Have you replaced the board in the meantime?

Majestix1970, 2020-08-26:
Hi Oldman4U,
have returned the board and closed the ticket.
Thanks for your help

oldman4U, 2020-08-26:
Perfect!

Hope you have more luck with another board.

Closed 2020-08-26.

Thread 153 (2020-07-02):

C62 and C67 are too large and cause too-slow crystal start to use system bootloader in DFU mode

zbrozek, 2020-07-02:
The older system bootloader (BOOT0 set high, BOOT1 set low) present on the STM3240xxx series only waits 780 microseconds for the crystal to start. The SKR Pro 1.1 comes with 22 pF capacitors that over-load the crystal such that it can't start quickly enough to enable USB support within the system bootloader.

I replaced these capacitors with 12 pF capacitors and now the startup is fast enough that the SKR Pro 1.1 is able to enumerate as a USB DFU device.

mqt0029, 2020-08-09:
Can someone @bigtreetech verify this is an issue with USB enumeration? Is this why my SKR Pro V1.1 USB-A port to OctoPi or Pronterface never worked no matter what I tried?

zbrozek, 2020-08-09:
@mqt0029 This is only relevant if you're trying to use the DFU bootloader, which is unlikely if you're thinking about OctoPi. Also presumably you meant the USB-B connector?

mqt0029, 2020-08-09:
Apologies was typing it up halfway through trying to get OctoPi to work with this board. And yes I meant the USB-B connector. So far trying all the firmware flashes which claims to have bootloader or USB serial does nothing. #115 .bin reads all F in ST-Link Util, #72 brings it back to where it all started, and scrambling 1, -1, and 6 in latest Marlin, latest bugfix, and BTT Demo for SERIAL_PORT only works with ESP-01 and TFT 35 V2.0, USB Virtual COM never came up and error out in Windows.

Sorry for the wall of text. It is a long shot, but at this point I'm beginning to suspect everything possible.

1300371, 2024-11-08:
I think I'm facing the same issue with a brand new SKR PRO V1.2.
I'am unable to switch the board in DFU Mode :

````
[   73.378996] usb 1-1.3: new full-speed USB device number 4 using xhci_hcd
[   73.465795] usb 1-1.3: New USB device found, idVendor=0483, idProduct=5740, bcdDevice= 2.00
[   73.465834] usb 1-1.3: New USB device strings: Mfr=1, Product=2, SerialNumber=3
[   73.465853] usb 1-1.3: Product: BLACK_F407VE CDC in FS Mode
[   73.465870] usb 1-1.3: Manufacturer: STMicroelectronics
[   73.465885] usb 1-1.3: SerialNumber: 205839853950
[   73.507782] cdc_acm 1-1.3:1.0: ttyACM0: USB ACM device
[   73.507873] usbcore: registered new interface driver cdc_acm
[   73.507881] cdc_acm: USB Abstract Control Model driver for USB modems and ISDN adapters

# Putting jumper to BOOT0 and push reset button

[  110.587343] usb 1-1.3: USB disconnect, device number 4
[  112.818473] usb 1-1-port3: Cannot enable. Maybe the USB cable is bad?
[  113.109970] usb 1-1.3: new full-speed USB device number 6 using xhci_hcd
[  113.954292] usb 1-1-port3: Cannot enable. Maybe the USB cable is bad?
[  113.961401] usb 1-1-port3: attempt power cycle
[  115.114205] usb 1-1-port3: Cannot enable. Maybe the USB cable is bad?
[  115.962191] usb 1-1-port3: Cannot enable. Maybe the USB cable is bad?
[  115.969244] usb 1-1-port3: unable to enumerate USB device
````

I'm trying to upload Onstep firmware for a telescope gotomount project with `dfu-util`

zbrozek, 2024-11-08:
You're definitely suffering the same problem. SKR Pro 1.2 did not change these capacitor values from SKR Pro 1.1. C62 and C67 are 22 pF and ought to be 12 pF. You can fix the issue by replacing those two capacitors.

I do not believe that BTT monitors Github issues or makes product changes based on findings within them.

1300371, 2024-11-08:
I'm not a specialist but if i understood well:
I change these capacitor and i will be able to see USB device of type `STM32 Bootloader` ?

zbrozek, 2024-11-08:
That's correct!

1300371, 2024-11-08:
Will give a try : it's very very tiny 😨 🤞

1300371, 2024-11-17:
Well, I changed the capacitors : still no DFU mode 😭

zbrozek, 2024-11-17:
Looks like you ordered smaller capacitors than what comes on the board, making the swap slightly more challenging. Did you set the BOOT0 jumper to get it to start in DFU mode?

1300371, 2024-11-17:
> Looks like you ordered smaller capacitors than what comes on the board, making the swap slightly more challenging. Did you set the BOOT0 jumper to get it to start in DFU mode?

Yes

zbrozek, 2024-11-22:
Try using an oscilloscope to see how long it takes the oscillator to start up.

1300371, 2024-11-22:
😞 Don't have one.
As I mentioned, i'm not experimented that much ...
Have you an advice ? I know some mini oscillope exists  ( 40 € on Aliexpress) : is it valuable ?

Thread 154 (2020-07-04):

Ymax endstop is not working

zacomposites, 2020-07-04:
hi guys.

i am struggling to make y max endstop works. reason its ymax and not y min is because the y homing direction not right so i change it to 1, ive inverted everything on ymax endstop still when i check m119, nothing is triggered.

oldman4U, 2020-07-04:
Hi. Which version of the firmware are you using?

zacomposites, 2020-07-04:
Marlin bugfix 2.0.

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

oldman4U, 2020-07-04:
And do you have physical endstops or are you using sensorless homing?

You may want to check this: https://github.com/bigtreetech/BIGTREETECH-SKR-PRO-V1.1/issues/103#issuecomment-599070627

zacomposites, 2020-07-04:
I have physical endstop. Using 2208 driver uart. The board doesnt have +y
endstop like mks board etc. Does it mean i can only use min and not max?

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

oldman4U, 2020-07-05:
Hi

I use senseless homing on min and software on max. Maybe you can change an unneeded endstop to be used as max, but i do not know. Have you tried to change the y endstop pins like described in the link i sent to you?

zacomposites, 2020-07-05:
It Works!!! :) swap the Y min max value. Thanks !! 1 issue sorted. now my z axis doesnt want to move. all limit switch working fine. any idea?

oldman4U, 2020-07-05:
I learned from the best. Gurmeet.

But the z axis moved before? Also 2208?

zacomposites <notifications@github.com> schrieb am So. 5. Juli 2020 um
22:17:

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

oldman4U, 2020-07-05:
Just saw you closed the ticket. Seems all good. ;-)))

Thank you and happy printing

zacomposites <notifications@github.com> schrieb am So. 5. Juli 2020 um
22:17:

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

zacomposites, 2020-07-05:
Hm.. before i compiled with cheetah from kay3d using similar build size
printer. Z axis does work.  Problem is that it uses 2 z motor..

My printer is the cr3040. It does have dual z ball screw but really its
just single motor with belt attached to both.

So..yeah.  now it doesn't want to work

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

oldman4U, 2020-07-05:
So, please reopen your ticket or start a new one. This ticket is closed...

The SKR Pro v1.1 can be setup in Marlin using a single Z and you can simply remove the jumpers from the second z Axis and connect a motor there. It will move both motors automatically.

AnHardt, 2020-07-06:
```cpp
//
// Limit Switches
//
#define X_MIN_PIN                           PB10
#define X_MAX_PIN                           PE15
#define Y_MIN_PIN                           PE12
#define Y_MAX_PIN                           PE10
#define Z_MIN_PIN                           PG8
#define Z_MAX_PIN                           PG5
```
When using 'endstop interrupts' `Y_MAX_PIN` (PE**10**) conflicts with `X_MIN_PIN` (PB**10**). The STM32 hardware allowes only one interrupt per end-**number**. All registers (A to J) share the same interrupt vector.

Either disable 'ENDSTOPINTERRUPTS' or swap Y_MAX_PIN with an other and connect the switch there.

Closed 2020-07-05.

Thread 155 (2020-07-06):

Z homing not in center of the bed and Z motor not moving.

zacomposites, 2020-07-06:
Hi GUys, my homing direction and endstop are working fine now for X and Y. now to sort out Z axis. after X and Y homing done, the hotend goes to opposite direction all the way to other end and crush. does not goes to center of the bed and start probing(bltouch v3.1)

heres my setting for z safe homing

#define Z_SAFE_HOMING

#if ENABLED(Z_SAFE_HOMING)
  #define Z_SAFE_HOMING_X_POINT X_CENTER  // X point for Z homing when homing all axes (G28).
  #define Z_SAFE_HOMING_Y_POINT Y_CENTER  // Y point for Z homing when homing all axes (G28).
#endif

oldman4U, 2020-07-06:
Hi.

Does Z work properly without Z_SAFE_HOMING?

What is the size of your printing bed and what have you defined in config file?

zacomposites, 2020-07-06:
i havent tried to remove z safe homing

/ Direction of endstops when homing; 1=MAX, -1=MIN
// :[-1,1]
#define X_HOME_DIR -1
#define Y_HOME_DIR 1
#define Z_HOME_DIR -1

// @section machine

// The size of the print bed
#define X_BED_SIZE 310
#define Y_BED_SIZE 310

// Travel limits (mm) after homing, corresponding to endstop positions.
#define X_MIN_POS 0
#define Y_MIN_POS 0
#define Z_MIN_POS 0
#define X_MAX_POS X_BED_SIZE
#define Y_MAX_POS Y_BED_SIZE
#define Z_MAX_POS 440

/**
 * Software Endstops
 *
 * - Prevent moves outside the set machine bounds.
 * - Individual axes can be disabled, if desired.
 * - X and Y only apply to Cartesian robots.
 * - Use 'M211' to set software endstops on/off or report current state
 */

oldman4U, 2020-07-06:
Besides the Z_MAX_POS, we use identical settings. I even have #define Z_SAFE_HOMING also defined.

But i use a Marlin from April at the moment, and there the settings are a bit different:

oldman4U, 2020-07-06:
#define Z_SAFE_HOMING

#if ENABLED(Z_SAFE_HOMING)
  #define Z_SAFE_HOMING_X_POINT ((X_BED_SIZE) / 2)    // X point for Z homing when homing all axes (G28).
  #define Z_SAFE_HOMING_Y_POINT ((Y_BED_SIZE) / 2)    // Y point for Z homing when homing all axes (G28).
#endif

zacomposites, 2020-07-06:
Hi Oldman4U

Thanks for this . just tried now, hm.... no change, x and y perfect, but z is not in the center. hm.............. any other suggestion?

oldman4U, 2020-07-06:
I am slowly running out of ideas. You could try v2.0.5.3 like i use it.

zacomposites, 2020-07-06:
ok. will do now. :)

oldman4U, 2020-07-11:
Hi. Any news regarding the reported issue?

oldman4U, 2020-08-03:
Hi @zacomposites.

What is the status of the reported issue?

Please do not forget to close this ticket, in case ou do to need it anymore.

Thank you

zacomposites, 2020-08-03:
Ok will do. I changed and use the skr 1.4 turbo board

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

oldman4U, 2020-08-04:
And the new board already works properly?

zacomposites, 2020-08-04:
I use it on my cr20pro. Not on my cr3040, but uses latest marlin not bugfix
nor cheetah.

I notice one of the driver tmc 2208 uaet is not working. Out of 5 that i
received. So i swap it. And the the motor move..

So today am getting new driver from biqu. I will use the same. Hopefully it
will work. Last time i was trying with marlin bugfix and cheetah.

I will try with new marlin.

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

oldman4U, 2020-08-04:
Seems you have no luck with hardware!😜

Closed 2020-08-05.

Thread 157 (2020-07-25):

SKR PROv1.2 FYSETC TMC2209v3.0 by UART

Roman-ru, 2020-07-25:
Hello, how to connect UART FYSETC 2209v3.0 to SKR PROv1.2

oldman4U, 2020-07-25:
Hi. Could you please check if this helps. https://github.com/GadgetAngel/SKR-PRO-V1.1-Stepper-Driver-Jumper-Configuration-Manual

Roman-ru, 2020-07-26:
No, it doesn't help, there's no Fysetc 2209v3.0

oldman4U, 2020-07-26:
Ok, sorry. In this case i can not help because i use btt tmc2209 with this
board.

I would recommend to use the bugfix Marlin from their github page and start
with the basic functions and add advanced features later on.

Hope someone uses the same stepper driver and can help.

Roman-ru <notifications@github.com> schrieb am So. 26. Juli 2020 um 07:46:

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

Roman-ru, 2020-07-26:
Thank you anyway.

oldman4U, 2020-07-26:
Make sure to desolder the diag pin in case you are not using sensorless homing  and set the jumpers on the mainboard for UART. Then you can set all other functions in software. Maybe you follow the BTT 2209 guideline from the document above and make sure the FYSTETC is setup for UART too.

Roman121275, 2020-07-26:
Not working, no connection. Sending M122 connection error.

oldman4U, 2020-07-27:
It is ANOTHER MAINBOARD but describes you driver:

https://3dwork.io/en/complete-guide-skr-v1-4-and-tmc2209

Roman121275 <notifications@github.com> schrieb am Mo. 27. Juli 2020 um
00:03:

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

Roman121275, 2020-07-27:
Yes, I saw it, but I can't figure out where to put the jumper on my board

oldman4U, 2020-08-03:
Hi.

Any news regarding the reported issue?

Roman-ru, 2020-08-04:
Hello, there is nothing new, I ordered a Bigtreetech 2209 and will receive
it today.

вт, 4 авг. 2020 г., 04:51 oldman4U <notifications@github.com>:

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

Roman121275, 2020-08-04:
Hello, there is nothing new, I ordered a Bigtreetech 2209 and will receive it today.
--
Отправлено из Mail.ru для Android вторник, 04 августа 2020г., 04:51 +09:00 от oldman4U  notifications@github.com :

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

oldman4U, 2020-08-04:
This is great. Let me know how it works

Roman-ru, 2020-08-10:
Work without problems

oldman4U, 2020-08-10:
👍🏻

Roman-ru <notifications@github.com> schrieb am Mo. 10. Aug. 2020 um 16:22:

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

markosko, 2020-09-15:
![Uploading 119476093_655038585156787_6097819317527174056_n.jpg…]()
In case someone have same problem with combination of SKR Pro and Fysetc TMC2209 v3.0, no need for soldering or cable wiring, uart jumper as normal, then another jumper on board between RX and TX lines, and under board jumper in middle row on left side as shown in image, M122 shows every connection ok.

oldman4U, 2020-09-15:
👍🏻

@gadgetangel is this something for you?

Roman-ru, 2020-09-15:
Yes,thank you!

вт, 15 сент. 2020 г., 18:14 oldman4U <notifications@github.com>:

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

Closed 2020-08-10.

Thread 158 (2020-07-29):

Can you hook up neopixels to this board?

NovaViper, 2020-07-29:
Hi, Im wondering if you can attach 60 neopixels to the board, I have them being powered externally as shown in the photo
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

oldman4U, 2020-08-03:
Hi.

There is an old three which covers your question here: https://github.com/MarlinFirmware/Marlin/issues/15355

I hope this helps

Please let me know

oldman4U, 2020-08-13:
Hi.

Any news? Have you been able to connect the Neopixel?

Please let us know

NovaViper, 2020-08-14:
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

Hey sorry for the delay! I haven't had a chance to hook up the board because I've been busy trying to get ready for college

oldman4U, 2020-08-14:
Ok. So what are the next steps?

oldman4U, 2020-09-30:
Please help the community and close the ticket once you do not need it anymore. Thank you

NovaViper, 2020-10-01:
I finally got around to getting the neopixels hooked up to the board last night, but to my dismay, it seems the pixels require some sort of level shifter to get them to work properly (setting different colors seem to cause this weird flickering where the LEDs flash different lights periodically despite not telling it to do so). But it does seem like getting a neopixel (or any sort of LED) is possible with this board, however since there isn't a 3.3V signal anywhere, a level shifter is needed. Im currently working on getting a level shifter and im gonna close the issue.

Closed 2020-10-01.

Thread 160 (2020-08-09):

USB Device Descriptor Request Failed

mqt0029, 2020-08-09:
Board: SKR Pro v1.1 (not sure if it's any different from v1.2?)

Firmware: Marlin release 2.0.6, Marlin master branch, Marlin bugfix, BTT provided Marlin on this repo

The problem: USB detected the device but throw "USB Device Descriptor Request Failed" out of the box. TFT35 V2.0 still connects, M503 from TFT (and ESP-01 web UI still works when using combination 1 and 6 for serial ports), but no USB to OctoPi or Pronterface.

What I tried:
- Installed Virtual COM driver provided from this repo, no change
- Try different bootloader: **#25** and **#72** (**WORKS** - out-of-box state, USB error), **#115** (**DOESN'T WORK** - can't flash, file's all F).
- Scramble SERIAL_PORT configurations between -1, 1, and 6, using single or both #define statement:
```
#define SERIAL_PORT -1    // or 1, or 6 while #define SERIAL_PORT_2 is commented out
```
```
#define SERIAL_PORT -1    // or any unique combination between -1, 1, and 6
#define SERIAL_PORT_2 1
```
- Disconnect everything, remove all jumpers except microSD, power (tried both Vin and USB), and USB/HOST jumpers, same result

Tools I used: FTDI breakout set to 3.3V, and an ST-Link V2

Any suggestion about where to go from here? I read a few more issues of people having close but not really the same problem, so I'm not sure if I should reference to those as well.

oldman4U, 2020-08-09:
Hi. Marlin currently supports  a maximum of two serial ports but you try to connect three serial devices. You can have usb OR WIFI besides the TFT but not all three.

Hope this helps

mqt0029, 2020-08-09:
Please read the description again, I only enabled TFT or WiFi to proof that the firmware wasn't at fault. To clarify, I always define one of the serial port for USB serial, which I believe to be -1 on SKR Pro, which means at all time, one of these two lines must be -1.
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

oldman4U, 2020-08-09:
Yes. -1 has to be activated for usb connection.

Could you attach your configuration files here so i can test with my board

mqt0029, 2020-08-09:
Here's the config. I'm running TMC (2130s on XYZ and 2209 on E) so I enabled TMC but I doubt TMC section has anything to do with the USB Serial.

[Configuration.zip](https://github.com/bigtreetech/BIGTREETECH-SKR-PRO-V1.1/files/5048550/Configuration.zip)

oldman4U, 2020-08-10:
Hi.

It is already very late here and I wanted to give you a quick answer.

I tested the USB connection on my printer and it did not work . which surprised me, because I did most of the configuration like PID tuning using Printrun and USB connection.

So I took a brand new SKR Mainboard and connected it out of the box with the USB cable which came with the mainboard, started Printrun, clicked connect and voila - it worked.

Tomorrow I will try to install the firmware on my "production machine" which has stepper motors and thermistors and a 24V power supply attached.

Attached is the OLD firmware which came with the mainboard. May you wanna give it a try even it is v2 bug fix.

[FIRMWARE.bin.zip](https://github.com/bigtreetech/BIGTREETECH-SKR-PRO-V1.1/files/5053647/FIRMWARE.bin.zip)

mqt0029, 2020-08-11:
Thanks for helping and the information. I'll run it through and see if USB pops up. Could you also provide the configs files, since I'm running multiple TMC drivers?

oldman4U, 2020-08-11:
Like I wrote, this is the firmware from the SD card which came with a board which I bought a few months ago (spare). Unfortunately there are no binaries, but in case this also works for you you can expect that the problem is really in software and that your hardware is fine in general.

oldman4U, 2020-08-11:
Please find attached the config files of Marlin bug fix v2 from today 11.8.2020

I changed in platformio.ini:
default_envs = BIGTREE_SKR_PRO

In Configuration.h
Serial Port -1
and 1
#define BAUDRATE 115200
[Archive.zip](https://github.com/bigtreetech/BIGTREETECH-SKR-PRO-V1.1/files/5057779/Archive.zip)

as well as
#define MOTHERBOARD BOARD_BTT_SKR_PRO_V1_1

I can connect via USB using Printrun.

Hope this helps

oldman4U, 2020-08-13:
Hi.

Any news?

mqt0029, 2020-08-13:
Apologies for the delay I am currently away from the setup. I will update as soon as I get back.

oldman4U, 2020-08-19:
I would disconnect everything except the usb cable and try the configuration like i wrote above. This works withy my two mainboards.

mqt0029, 2020-08-19:
Already did, the board was empty (no display, no ESP, no stepper drivers) with all it's original jumpers in place. Nothing. Probably time to move on. Thanks for the help.

Closed 2020-08-19.

Thread 162 (2020-08-18):

Extruder only turning one direction

22norbi, 2020-08-18:
Hi, I have been trying to use the BTT SKR Pro v1.1 for soem time now however was am not able to get the Extruder to work. I have tried the 2208 and now the DRV8825 and the motor turns in one direction for the first second or two then it turns into the opposite direction automatically for the rest of the extrusion.

Here are my two configuration files that I am using:
[Configuration.h.txt](https://github.com/bigtreetech/BIGTREETECH-SKR-PRO-V1.1/files/5091191/Configuration.h.txt)
[Configuration_adv.h.txt](https://github.com/bigtreetech/BIGTREETECH-SKR-PRO-V1.1/files/5091193/Configuration_adv.h.txt)

Here is a video to illustrate the problem
[ExtruderError.zip](https://github.com/bigtreetech/BIGTREETECH-SKR-PRO-V1.1/files/5091224/ExtruderError.zip)

Any assistance to get this resolved will be appreciated as I have been searching the net without any success of finding a solution. I have also replaced the cable and motor on the extruder and tested different stepper drivers. They all provide the same results, maybe it is something in my configuration that is incorrect.

oldman4U, 2020-08-24:
Hi.

What happens, when you do a manual UNextrude or extrude? Does it move in different directions initially?

nk-111, 2020-08-24:
Hi, yes both manual and printing the extruder first second it moved correctly then it automatically reverses and "UNextrude" every-time

oldman4U, 2020-08-24:
Have you tried to remove everything except what is absolutely needed and
tried to extrude using pronterface?

Has this working before?

nk-111 <notifications@github.com> schrieb am Mo. 24. Aug. 2020 um 14:10:

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

oldman4U, 2020-08-24:
Remove everything and try to extrude using pronterface.

Has this been working before?

oldman4U, 2020-08-28:
Any news?

nk-111, 2020-09-01:
Hi, I had to setup everything, thank you for the suggestion, however also with pronterface I had the same challenge. I think I have something wrong in my configuration settings, not sure.

oldman4U, 2020-09-02:
Finally this is most likely an hardware issue. If it would run wrong in a
single direction it would be easy to fix. But in your case it starts right
and changes the direction after that. I am not aware of a setting which in
the firmware which could cause this.

🥴

nk-111 <notifications@github.com> schrieb am Di. 1. Sep. 2020 um 16:28:

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

oldman4U, 2020-09-02:
You could try to turn around the extruder cable on one side 180 degrees.

oldman4U, 2020-09-07:
Hi.

Any news?

oldman4U, 2020-09-09:
you tried to deactivate

#define E0_AUTO_FAN_PIN 255

oldman4U, 2020-09-14:
@22norbi

Could you please reply with the latest news or close this ticket.

Thank you

oldman4U, 2020-09-30:
Please help the community and close the ticket once you do not need it anymore. Thank you

oldman4U, 2020-10-10:
Please help the community and close the ticket once you do not need it anymore. Thank you

Thread 163 (2020-08-24):

SKR Pro + TMC5160 + PT100 using MAX31865+ BTT TFT35 v2 = no attached printer

code505, 2020-08-24:
I'm having issue working this configuration
`#define SERIAL_PORT -1
#define SERIAL_PORT_2 1`

I'm using this guide to connect MAX31865 in software SPI configuration:
[https://drive.google.com/file/d/1zOky07F_R_DO_-XxZx6C3xULqhuxYMOi/view?usp=sharing](url)

once I change TEMP_SENSOR_0 to  -5, I got the no attached printer, otherwise TFT is working

any thoughts

oldman4U, 2020-08-25:
Please send pictures showing the connection between tft and mainboard. Check the baudrate setting of mainboard and tft.

code505, 2020-08-25:
that is the picture, the reset wire is the last on the left,

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

the baudrate is 115200 on both the board and the TFT

what I want to emphasise on, is that when I put,
 TEMP_SENSOR_0 1 >>>> TFT is working with no issue
if
TEMP_SENSOR_0 -5 >>>> TFT show no printer attached

oldman4U, 2020-08-25:
Maybe then it would be good to start a ticket in the general TFT Firmware
repository. Seems TFT related and not SKR.

code505 <notifications@github.com> schrieb am Di. 25. Aug. 2020 um 19:02:

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

oldman4U, 2020-08-25:
Saw you opened the ticket, great. Reading your answer again i am not sure if this is SKR or TFT any more, but there are more users watching, so it is always a good idea to start a ticket there. Hope someone can help.

May i ask you why you are using this temp sensor and not a common one?

code505, 2020-08-25:
thank you so much for your cooperation, I installed V6 hotend and I thought it is a good idea to upgrade to pt100 for more consistant heat management and for carbon fiber printing

oldman4U, 2020-08-26:
You are welcome.

I believe there are many parameters in a 3D printer which vary too much in
a very short time to give you accurate results which makes such a precise
measurement unnecessary.

PETG based carbon filament is my favorite material. Best results with a .6
Nozzle, approximately 240 degrees and VERY VERY slow print speed. Usually
60-80mm. Carbon 10mm. But the results are worth. 😁

code505 <notifications@github.com> schrieb am Di. 25. Aug. 2020 um 21:50:

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

oldman4U, 2020-08-26:
Forgot. NO Fan!!! Very important.

code505 <notifications@github.com> schrieb am Di. 25. Aug. 2020 um 21:50:

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

AnHardt, 2020-08-26:
Back to the problem.

When there is any configuration for the serials where communication is possible - keep that.
When the communication fails when `TEMP_SENSOR_0 -5` but not with `TEMP_SENSOR_0 0` something with the MAX31865-system is wrong. The protection systems detect a MIN_TEMP_ERROR, a MAX_TEMP_ERROR or maybe a communication error and sends Marlin into KILL_STATE - stopping all communication.

Checklist:
How many wires has the PT100/1000 sensor?
Is the MAX31865-module prepared for that number of wires?
If the sensor has 3 wires use only two different colour ones and prepare the module according to that. Marlin does not support 3_WIRE_MODE!
Is the sensor connected to the module?
To witch of the SPI-busses is the module connected to?
Is Marlin configured to use the same buss?
Are the buss-wires not to long, not broken, connected to the right pins? Don't cross MISO and MOSI like you'd do with serials RX and TX.
Check the last tree points also for SS.

Finally correct the `400` to a '430' in `temperature.cpp` at about line 1378 (there is only one occurrence)
```
            #if ENABLED(MAX6675_IS_MAX31865)
              max31865.temperature(100, 400)  // 100 ohms = PT100 resistance. 400 ohms = calibration resistor
            #else
```

If all that does not help try to check the hardware with different software like https://github.com/adafruit/Adafruit_MAX31865/blob/master/examples/max31865/max31865.ino

AnHardt, 2020-08-27:
As far i can see the hardware SPI variants in the above guide can't work.
The software uses the 'default SPI bus' (SPI = SPI1) where the onboard SD-Card is connected to.
The wires shall be connected to the TMC-SPI bus (SPI3).
That compiles but can't work.

GadgetAngel, 2020-08-28:
#

>

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

## Please educate me, so I can correct the guide.  (To restate what you have written and to ensure I understand): You state that Marlin 2.0.6 can not work on SPI3.  Marlin 2.0.6 will only use SPI1 for hardware SPI for ANY MCU. Is this correct?

#### As far as I am aware, the Hardware SPI is a master slave communication protocol. The SKR PRO V1.1 has three SPI buses on the MCU. SPI1 is the SD card reader; SPI2 is EXP2 and SPI3 is the Stepper Motor Driver Sockets.

## Are you also saying that Marlin 2.0.6, does not allow the user to use Hardware SPI because at this time Marlin does not support Adafruit BUSIO? So the ONLY WAY to even use Adafruit’s  MAX31865 is by using Software SPI?

AnHardt, 2020-08-28:
The BTT SKR PROs have 3 SPI-buses. Marlin, in general, is able to use all of them.
It's Adafruit_MAX31865 library what does not allow to select an other than the default SPI-buss (here SPI = SPI1).
Hardware SPI for the MAX31865 is currently only possible if connected to the onboard-SD-SPI-buss - what results in a mess because there are no connectors.

Even in the newest version of the MAX31865 lib we have no way to specify the "buss".
```
  Adafruit_MAX31865(int8_t spi_cs, int8_t spi_mosi, int8_t spi_miso, int8_t spi_clk);
  Adafruit_MAX31865(int8_t spi_cs);
```
While the underling BussIO now can handle it:
```
  Adafruit_SPIDevice(int8_t cspin, uint32_t freq = 1000000,
                     BitOrder dataOrder = SPI_BITORDER_MSBFIRST,
                     uint8_t dataMode = SPI_MODE0, SPIClass *theSPI = &SPI);

  Adafruit_SPIDevice(int8_t cspin, int8_t sck, int8_t miso, int8_t mosi,
                     uint32_t freq = 1000000,
                     BitOrder dataOrder = SPI_BITORDER_MSBFIRST,
                     uint8_t dataMode = SPI_MODE0);
```
 - last parameter of the first constructor.

In general alone from the SS-pin it's impossible to detect the right buss.

GadgetAngel, 2020-08-28:
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

#### Is it not possible to write a software wrapper that exposes the pointer to the SPI BUS from the  underlying BUSIO Function call?  Is that not what a Constructor does in C++? Marlin is written in which programming language?

## Which MAX31865 amplifier board on the market today can a user of Marlin use to access the correct SPI bus? Is there even one available?

GadgetAngel, 2020-08-28:
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

### Please place your Marlin folder (Zip the folder up) onto google drive and supply us with the shared link to that File.

### It makes no sense that Software SPI is not working for you.

### I will update the Guide to reflect the information about the current state of the Adafruit MAX31865 library

code505, 2020-08-28:
Here is the compressed folder, I really appreciate your cooperation guys.

[https://drive.google.com/file/d/1K1XbNh0lFrJSDPzNua3jOYGHsJ_Dz9JK/view?usp=sharing](url)

GadgetAngel, 2020-08-28:
### @code505 I downloaded the latest Marlin version 2.0.6.1 and made the changes that I have on my printer.  Do you have a filament runout sensor attached on your printer?   Are you using the filament runout port on the TFT screen?

### If you have a filament runout sensor attached please comment out the Marlin sections related to that equipment.  Leave them commented out until we get the MAX31865 in Software SPI mode to work.

### Are you running V2.0.26 firmware on your BTT TFT35 V2.0 screen?

## Here are the differences (that I think are relevant) I found between my setup and yours:

## Differences in Platformio.ini file (your file is on the LEFT, my setup is on the RIGHT)--- I think this is where your problem is:
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

# *** In my opinion: In Platformio.ini file: Change your default_evns to be BIGTREE_SKR_PRO and change include_dir to be Marlin

## Difference in Configuration.h file (you have two screens enabled in Marlin):
### You have Your Stock CR10 Displayed enabled yet the above picture shows no connections to EXP1 or EXP2 connectors:
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
### You have the REPRAP_DISCOUNT_FULL_GRAPHIC_SMART_CONTROLLER enabled in Marlin along with your CR10 stock display:
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

# *** In my opinion: In Configuration.h file, you need to just disable both the REPRAP_DISCOUNT_FULL_GRAPHIC_SMART_CONTROLLER and the CR10_STOCKDISPLAY **_AND_** ensure the Marlin line #define SDSUPPORT  is uncommented.

### Here is a video to watch to connect the BTT TFT35 V2.0 to the SKR PRO V1.1 board: https://youtu.be/9i3Ee6UtC-Q

### In the above video He does not mention enabling any LCD screen in the Marlin firmware download.  All he enables in Marlin Firmware are the following: Stepper Drivers used and enable are A4988 drivers;  SERIAL_PORT is -1;  SERIAL_PORT_2 is 1;.  MOTHERBOARD is BOARD_BTT_SKR_PRO_V1_1     ; In Platformio.ini file: default_envs = BIGTREE_SKR_PRO.  He sets his baudrate on the TFT35 V2.0 screen to 250000

GadgetAngel, 2020-08-29:
## @AnHardt Could I use this device and hack into the SPI Lines for the SKR PRO V1.1 and GTR V1.0 boards? Maybe that would work?
https://www.amazon.com/gp/product/B088WB5L8R/ref=ppx_yo_dt_b_asin_title_o01_s00?ie=UTF8&psc=1

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

AnHardt, 2020-08-29:
Yes - one could.
But it also has no pins to connect the SPI-bus to. So it's has no advantage over soldering wires/pins directly to the mainboard at the SD-Card-slot or the processor. (Maybe the pins at the ESP are a bit larger?)

GadgetAngel, 2020-08-29:
@AnHardt, Thanks for setting me straight on the Adafruit library issue!  I am now fixing the guide so that I will not be giving out bad information.  Just to be clear on another point, the reason my guides provide redundant information is to make it perfectly clear to the user that they have options.

Some people cannot extrapolate one solution into another solution.

My goal is to open up this hobby of 3D printing to more users.  The more people that get involved with 3D printing the better the firmware will get and the MCU boards will get upgraded.

I do not intend for my manuals and guides to be idiot proof.  But I do want to make it easier for people to hook up the devices.  If they have a sort of cook book to follow, they are given a starting point and then learn from there.  Sometimes that is all that is needed to get people to try out a new item.

I never intended my guides and manuals to be insulting.  In fact, if anyone ever finds wrong information in my guide or manuals PLEASE let me know.  I need to learn and then I can fix the guide.  Just like you did with the PT100 Guide.  I really appreciate the input you gave.  Thanks again.

code505, 2020-08-29:
@GadgetAngel
Hi,
I also downloaded Marlin 2.0.6.1, and edited all the configuration including Platformio.ini file,
I have filament run out sensor and I commented out it's setting
installed V2.0.26 firmware on TFT35
I had the cr10s display and I thought I would give it a try without the TFT, but that also didn't work, that why I set the setting for the original cr10s display, but I revert every thing back now
but until now, no luck
one thing to mention, when I set `#define SERIAL_PORT 1` and `#define SERIAL_PORT_2 -1`

the TFT give these messages:
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

code505, 2020-08-30:
I have  PT100 amplifier board (INA826 amp) , and I will connect it using table 21

to which pin should I use for 3.3v supply, ground and signal.

thank you

GadgetAngel, 2020-08-31:
@code505 The easiest way is to use any of the ADC lines on extension-1 heade, get 3.3VDC and GND from power expansion header.

Extension-1 header:
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

Color PIN diagram of SKR PRO V1.1 Board:
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

code505, 2020-08-31:
can I use 3.3v and GND from E1 endstop socket?, I have only one extruder

AnHardt, 2020-08-31:
On this board VREF+ is not different from VCC_3.3V and VDDA is not accessible - so yes for the 3.3V.
On this board we have more or less separate systems for GND and GNDA - so piking GNDA from a unused T input could make more sense to avoid some noise (but for functionality that should not make a difference - in the end they are connected via 0 Ohm R31).

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

GadgetAngel, 2020-09-06:
> can I use 3.3v and GND from E1 endstop socket?, I have only one extruder

yes

GadgetAngel, 2020-09-06:
### @AnHardt You wrote this:

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

## 400 Ohm is the calibration resistor.   So for the Adafruit MAX31865 for PT100 you must change the calibration resistor to 430 in temperature.cpp. If you bought Adafruit MAX31865 for PT1000 you must use max31865.temperature(1000, 4300) in temperature.cpp.  Is this correct?

AnHardt, 2020-09-06:
# **Yes!**

Do you really have to be that loud - always? (big fonts) My eyes are bleeding. :-)

GadgetAngel, 2020-09-09:
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

## @AnHardt Can you find any document showing the 15P cable and which PINS correspond to MOSI, MISO, SCK ?   I have looked and I can not find any document showing which PINS on the extension cable correspond to the SPI lines

AnHardt, 2020-09-09:
One side of the cable is a sd-card with some wires.
The other a sd-card-socket with some wires.
To make that work the wiring has to be straight, one by one, no crossings.
The cable can also be used to extend SDIO connected sockets - not only SPI.

https://www.google.com/search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

GadgetAngel, 2020-09-11:
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

This issue is the SD card socket has 15 pins on the back when I crack it open.  The sd card on the other end has 8 pins.  I agree they should be straight connect but why have 15 pins to 8?  If every other pin was Ground then I would expect 16 pins to 8.  I looked up the part number on the SD card socket: AoSheng100921TF .  It is a patented product from China.  I can not find how they go from 15 pins to 8 pins.  Do you have any idea what they did?

AnHardt, 2020-09-12:
8 pins have 7 gaps. 8+7 = 15. Yes, likely there are GND in between - even if having 3 GND lines together does not make sense - maybe additional GNDs are at the outer lanes. Measuring helps to know exactly.

code505, 2020-09-12:
@GadgetAngel Hi there,

I've used your guide to connect pt100 with amplifier board:

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

I changed TEMP_SENSOR_0 to 21 and TEMP_0_PIN to PF7

now hotend temp is reading 1, not changing
when I change  TEMP_SENSOR_0 to 20
it works but temperature is higher by 3-4 degrees, and it is not stable, some time shooting 10-15 degrees up/down and come back again, this happen within second

using MAX31865, still no luck, :(

GadgetAngel, 2020-09-12:
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

Which Amplifier board are you using? the E3D PT100 Amplifier board or the MAX31865 board?  If you are using the E3D PT100 Amplifier board and connected up as shown in the diagram, then TEMP_SENSOR_0 set to 20 will give you the wrong readings because that conversion table assumes the excitation voltage is set for 5V.  You are using a 3.3VDC supply voltage.   Try creating your own translation table.   Keep your Technique #2&Method#1 wiring but try Technique #8 to generate your own translation table (create a custom thermistor table).

Double check your wiring to and from the PT100 sensor and the PT100 amplifier board are good.

 Check your PT100 sensor: to see if it changes resistance with temperature.  Use your multimeter and measure the resistance of the PT100 sensor at room temperature.  Now place the PT100 Sensor next to your soldering iron so it can read temperature above room temperature.  See if the PT100 sensor resistance changes.

It sounds like you have more than one problem you are trying to overcome.  It sounds like you are getting data back to the MCU, now you just need to figure out why it is stuck at 1.

You can make Marlin show the ADC values it is getting from your Amplifier board by turn on the Marlin variable "SHOW_TEMP_ADC_VALUES".  Please watch this video to understand how to create your own thermistor table (translation table) from scratch: https://www.youtube.com/watch?v=brl1weuD8bs&feature=youtu.be.  The YouTube video is called "Marlin Thermistor Calibration" but it walks you through understanding how Marlin uses the thermistor table.

code505, 2020-09-12:
after doing a search, I think I'm not alone,
https://github.com/MarlinFirmware/Marlin/pull/19246

by the way, I used your guide also to connect smart filament sensor, is it okay to use 5v supply to provide power to the sensor, I think it can be operated ok from 3.3v from the limit switch E0

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

GadgetAngel, 2020-09-13:
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

The BIGTREETECH SFS requires 5V supply but try the 3.3VDC to see if it works,  I have not tried it with 3.3VDC.  If it works, it works

AnHardt, 2020-09-13:
Please update to the complete facts.
Use 20 if module supply is the same for module and ADC-reference. For the SKR PRO, if the module allows, 3.3V / 3.3V. For a 5V processor board, 5V / 5V.
Use 21 if the module gets 5V but the processor 3.3V. Don't use this above ~500°C.

It would make sense to wait until https://github.com/MarlinFirmware/Marlin/pull/19246 or a replacement/followup is merged. Then slightly rephrase, to avoid complete redundancy. A manual should provide a second chance to understand what is going on.

GadgetAngel, 2020-09-14:
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

### I agree, I will state the following:
### Use table 20: When the power supply for the PT100 Amplifier board is equal to the ADC reference voltage for the MCU.

### For SKR PRO V1.1/V1.2, SKR V1.3/V1.4/V1.4 Turbo, GTR V1.0, M5 V1.0 all use 3.3 VDC as the ADC reference voltage for the ### MCU.
### Therefore use table 20 when the PT100 Amplifier board is powered by 3.3VDC

### Use table 21: When the power supply for the PT100 Amplifier board is different to the ADC reference voltage for the MCU.

### The E3D PT100 Amplifier board wants 5V as its power supply. But the SKR PRO V1.1 uses 3.3V as the ADC reference voltage  for the MCU.  My current manual recommends using 3.3VDC for powering the E3D PT100 Amplifier board.  But now that you all have made me aware of this issue with the translation table I would recommend using 5V for powering the E3D PT100 Amplifier board.   In this case, I would also recommend using a 3.6V Zener Diode (reverse biased hookup) to protect the MCU from 5V input.  If the PT100 sensor gets damaged or becomes disconnected from the PT100 amplifier board while the PT100 amplifier board is powered on, a 5V output signal will occur and fry the MCU board.  This type of problem may or maynot happen but I would prefer to protect the MCU board. Therefore, I will update my wiring diagrams so that they show the wiring for the Zener Diode.  Again, Thank you both for making me aware of this issue

code505, 2020-09-14:
Using MAX31865, Is there any changes have to be done in temperature.cpp?? other than the pin assignemtn in pins_BTT_SKR_PRO_common.h

#ifndef MAX31865_CS_PIN
#define MAX31865_CS_PIN TEMP_0_PIN
#define MAX6675_SS_PIN MAX31865_CS_PIN
#define MAX31865_MOSI_PIN PD2
#define MAX31865_MISO_PIN PD5
#define MAX31865_SCK_PIN PE0
#endif

I found this [https://reprap.org/forum/read.php?415,809669](url)
is this applicable for the current Marlin release?

AnHardt, 2020-09-15:
No.
Meanwhile MAX31865 is integrated into Marlin.
That message is from a wile before that. So likely the appended `temperature.cpp` is to old to not cause problems.

code505, 2020-09-15:
I'm still trying to make it work with MAX31865, when compiling I got this:

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

AnHardt, 2020-09-16:
That's a problem in `Adafruit MAX31865 library`.

Use a recent Marlin and compile with PlatformIO. The newer versions of `Adafruit MAX31865 library` are purposely excluded (MAX6675_IS_MAX31865     = Adafruit MAX31865 library@~1.1.0).
Alternatively downgrade the library via Arduinos library manager to `1.1.0`.

GadgetAngel, 2020-09-17:
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

Thread 165 (2020-09-10):

USB serial printing does not work (Linux, slic3r, RepetierHost, SKR Pro V1.2)

Yenya, 2020-09-10:
Hello,

I am trying to configure SKR Pro V1.2 for printing over the USB-serial port from Linux with either slic3r or RepetierHost. Both of these programs work on the same computer correctly with my Arduino Mega + RAMPS 1.4 + Marlin 1.9 setup. With SKR Pro, I can see a new serial port /dev/ttyACM1 created, when I do "`cat /dev/ttyACM1`" and from the other terminal "`echo M105 > /dev/ttyACM1`", I see the correct output "`ok T:-15.00..."` in the first terminal. However, when I try to connect from slic3r's Controller tab, I get about 5 seconds pause, and then "Connection failed. Check serial port and speed." error message. With RepetierHost, it connects to the serial port, but immediately says "6 commands waiting, and no communication except the initial M105 without response" is shown in the log window.

 I have the following in my `Configuration.h`:

```
#define SERIAL_PORT -1
#define SERIAL_PORT_2 1
#define BAUDRATE 250000

```
It might be that the USB serial port emulation inside the STM32 does not handle for example the stop bit, echo, rts/cts, or other serial settings from the Linux host.

I tried the master branch of Marlin as well as the bugfix-2.0.x branch - both behave the same.

Does anybody here print on SKR Pro V1.2 over the USB serial port from Linux?

Thanks,

-Yenya

Yenya, 2020-09-11:
Exploring this further, even Pronterface does not work. When it tries to connect, the following errro message is written to the kernel log:

`cdc_acm 1-10:1.0: failed to set dtr/rts`

When I do "`cat /dev/ttyACM1`", and from another terminal I repeatedly run "`echo M105 > /dev/ttyACM1`", the output looks garbled sometimes:
```

$ cat /dev/ttyACM1
ok T:-15.00 /0.00 B:-15.00 /0.00 P:-15.00 /0.00 @:0 B@:0
echo:Unknown command: "ok T:-15.00 /0.00 B:-15.00 /0.00 P:-15.00 /0.00 @:0 B@:0"
ok
echo:Unknown command: "echo:Unknown comma0 B:-15.00 /0.00M105"
ok
echo:Unknown command: "echo:Unknown commM105"
ok
echo:Unknown command: "echo:Unknown commaM105"
ok
echo:Unknown command: "echo:Unknown commM105"
ok
echo:Unknown command: "echo:Unknown commokM105"
ok
echo:Unknown command: "echo:Unknown commM105"
ok
echo:Unknown command: "echo:Unknown commM105"
ok
echo:Unknown command: "echo:Unknown comhoM105"
ok
echo:Unknown command: "echo:Unknown commM105"
ok
echo:Unknown command: "echo:Unknown commM105"
ok
echo:Unknown command: "echo:Unknown commM105"
ok
echo:Unknown command: "echo:Unknown commM105"
ok
echo:Unknown command: "echo:Unknown comma commM105""
ok
echo:Unknown command: "ok"
ok
ok T:-15.00 /0.00 B:-15.00 /0.00 P:-15.00 /0.00 @:0 B@:0
echo:Unknown command: "echo:Unknown omchok B:-15.00 /0.00 P:-15.00 /0.00 @:0 B@:0"
ok
ok T:-15.00 /0.00 B:-15.00 /0.00 P:-15.00 /0.00 @:0 B@:0

```
There seems to be something horribly wrong with USB serial port emulation on SKR Pro MCU.

oldman4U, 2020-09-14:
Hi.

Would it be helpful for you if I try the same on macOS and Printrun and SKR Pro v1.1?

Yenya, 2020-09-14:
@oldman4U - as far as I can see v1.1 and v1.2 have the same MCU, so yes, it might be helpful to try it under MacOS as well.

I see this repo has even drivers for the serial port for Windows, so it might be that the Windows driver papers over some non-standard behaviour, which other systems with native serial drivers see.

oldman4U, 2020-09-14:
Hi.

I used an a bit older Marlinversion 2.0.5.3 and serial port -1 and 1 as well as 115200 Baudrate. No problem to connect using Printrun and no extra drivers installed. I only tested to connect and more the axis - no actual print tested but I guess this would also work. No drivers installed.

Do you have a reliable 12V or 24V PS connected or USB only?

Anything else I can help with?

Yenya, 2020-09-14:
Does the Printrun attempt to reset the printer with lowering the DTR signal, set/clear the RTS/CTS handshake or something? My guess is that something related to emulating the actual physical serial port fails with SKR Pro.

My test setup has 14V/2A power supply, from which the SKR Pro, TFT35E3, and one stepper on X axis driver are powered. Tried also the USB-only power (no stepper, of course), with and without the TFT35E3. No difference.

Yenya, 2020-09-14:
Another interesting thing - but maybe not related to this issue: when I instruct Marlin to home the X axis, where I have a testing stepper only but no endstop, the homing fails with "kill() called - reset the printer" or something like that. But hitting reset does not help - the TFT display reports "No printer attached". The only thing that helps is to power the whole setup (SKR Pro + TFT) down, wait for a few seconds, and then power it up again.

oldman4U, 2020-09-14:
Sorry, but I do not know what Printrun actually does to connect.

How do you instruct Marlin to home, using the TFT in Marlinmode?

No printer attached when using the touch mode I guess? Hitting Reset where, on the SKR board? Serial cable attached? I have the same display btw.

Yenya, 2020-09-14:
Tried using TFT, and using Pronterface (the rare case I managed to connect). TFT is in Touch mode, connected over Serial 1. Tried both reset buttons, no difference.

Yenya, 2020-09-14:
Another interesting thing is that hitting reset button (any of them) does not result in USB disconnect and reconnect events in the Linux host.

oldman4U, 2020-09-14:
When I reset the SKR board I get this in Printrun:

[ERROR] Can't read from printer (disconnected?) (OS Error 6): Device not configured
[ERROR] Can't write to printer (disconnected?) (SerialException): write failed: [Errno 6] Device not configured

Yenya, 2020-09-14:
Would you mind to re-test with the latest Marlin and my configuration attached to the above mentioned Marlin issue? Or vice versa - could you send me the exact version (git commit hash) of your firmware, and your configuration (and other possible local modifications)?

oldman4U, 2020-09-14:
I can upload. It is a test machine

2.0.6.1 or latest latest bugfix?

Yenya <notifications@github.com> schrieb am Mo. 14. Sep. 2020 um 21:56:

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

Yenya, 2020-09-15:
Either one is welcome, thanks!

oldman4U, 2020-09-15:
Hi.

I just downloaded the Bugfix Marlin from today. Can you send me your configuration files and I will test it.

Yenya, 2020-09-15:
It is attached to the other issue, mentioned above: https://github.com/MarlinFirmware/Marlin/files/5207416/skrpro-config.zip

Thanks!

oldman4U, 2020-09-15:
OK.

So I used the firmware above, changed the env. in PlatformIO.ini and replaced the two config files with yours. Updates the firmware on my SKR Pro v1.1 and even v1.2 was defined (MOTHERBOARD BOARD_BTT_SKR_PRO_V1_2) it took it (led close to the CPU flashed) and I had to change the baud rate to 250000 to get the TFT connected. So everything tells me that the firmware was loaded.

Opened Printrun, clicked on Connect - Printer is now online, and I could control my mainboard.

I use 12/24V Power and of course Host USB selection like shown in the attached picture.
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

For me this works...

Yenya, 2020-09-15:
So maybe it is someting like half-baked serial port emulation, which Printrun does not fully use and thus does not see a problem. Can you test also from Linux?

oldman4U, 2020-09-16:
Or it is a hardware issue....

Unfortunately not, sorry. Otherwise i would have offered from the beginning.

Yenya, 2020-09-16:
HW issue might be the case, altough I can't imagine how would this work, as the serial port is emulated inside the USB connection. Anyway, thanks for checking my configuration.

More observations:
Marlin compiled with RepRap Discount LCD support (`#define REPRAP_DISCOUNT_FULL_GRAPHIC_SMART_CONTROLLER`), and TFT35-E3 connected with ribbon cables in Marlin mode, everything powered from USB only. After power-up, I see Marlin info screen as expected, and the /dev/ttyACM1 serial port appears in the Linux host. When push the RESET button (either on the TFT or on the SKRPro board, they behave the same), the /dev/ttyACM1 device is disconnected from Linux and doesn't come back. Also, the TFT now displays only the "LCD12864 simulator" title only. So it seems that after reset, the Marlin fw does not boot again.

From dmesg output on the Linux host:
```
[1178283.921758] usb 1-10: new full-speed USB device number 67 using xhci_hcd
[1178284.242468] usb 1-10: New USB device found, idVendor=0483, idProduct=5740, bcdDevice= 2.00
[1178284.242470] usb 1-10: New USB device strings: Mfr=1, Product=2, SerialNumber=3
[1178284.242471] usb 1-10: Product: STM32F407ZG CDC in FS Mode
[1178284.242472] usb 1-10: Manufacturer: STMicroelectronics
[1178284.242472] usb 1-10: SerialNumber: 207731745252
[1178284.259523] cdc_acm 1-10:1.0: ttyACM1: USB ACM device
_(here I hit the reset button)_
[1178288.269298] usb 1-10: USB disconnect, device number 67
```

Yenya, 2020-09-16:
Another observation: tried the binary firmware which I got with the SKRPro board - fortunately I saved it beforehand - I am able to connect to it and communicate with it with Slic3r, RepetierHost, and Pronterface. Also tried the SKRPro v1.1 firmware blob for TMC2209 drivers from this repository:

https://github.com/bigtreetech/BIGTREETECH-SKR-PRO-V1.1/blob/master/firmware/SKR%20ProV1.1-Marlin_v2.0-12864p-TMC2209Uart_Drivers-Test/firmware.bin

- this does not work at all over the USB serial connection, the same way as my own compiled firmwares. But maybe the reason is that it is for v1.1.

Another interesting thing is that when I hit the RESET button, the /dev/ttyACM1 device disappears and doesn't come back until power cycle, but when I eject the microSD card and plug it back, the device appears again in few seconds, and the LCD12864 simulator displays the Marlin boot screen and then the info screen.

----

It might be something with the toolchain (compiler/binutils version, libraries, or something like that). @oldman4U - could you please send me the firmware binary you have compiled from my configuration? Either attach it here, or mail it to me - my address is kas @ <my github nickname> .net. Thanks!

oldman4U, 2020-09-16:
Here you are. Just tested the reset on the SKR and it makes the SKR and the TFT reset. After that, the TFT connects properly to the SKR using touch screen (can not test Marlin because i removed the knob.... don't ask;-))

[Archive.zip](https://github.com/bigtreetech/BIGTREETECH-SKR-PRO-V1.1/files/5231607/Archive.zip)

Yenya, 2020-09-16:
I am sorry but I see only Configuration.h and Configuration_adv.h in this zip file. What I want is the resulting firmware.bin compiled on your system with your toolchain. Thanks!

oldman4U, 2020-09-16:
As far as i know this is not allowed. But you can send me your private email or a upload link and i can do so.

Yenya, 2020-09-16:
My e-mail is kas@(my github nickname).net, as I wrote above. Thanks!

oldman4U, 2020-09-16:
It is on the way.

Let me know how it works

Yenya, 2020-09-16:
Got it, thanks! It behaves more-or-less the same as my own FW: after power-up, I see /dev/ttyACM1, after reset it disappears and doesn't come back (and the TFT display reports "No printer attached"), after ejecting the microSD card and plugging it back the device appears again, and the TFT display connects. Connection from slic3r or RepetierHost does not work as before, Pronterface seems to be working correctly (as it does most of the time with my own compiled firmware - I guess my previous problems with Pronterface were in fact related to the reset problem, now I am able to use Pronterface reliably).

So, if I understand it correctly, the reason could be:

- my hardware is faulty
- there is something wrong with serial port emulation in the current Marlin, which breaks the way both slic3r and RepetierHost use the serial port on Linux.

I have also discovered that even though I can connect from Pronterface, I get truncated output from the M43 command. Each time it is truncated at slightly different place, usually somewhere between the PD* and PE* ports. Does this work for you?

oldman4U, 2020-09-16:
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

I have to go, so taking pictures was the fastest way to send you the M43.

Yenya, 2020-09-16:
So, it seems your output is also truncated, albeit at different points than mine.

oldman4U, 2020-09-16:
Where do you see the truncation?

You are welcome

Yenya, 2020-09-16:
Your output ends sometimes with PH1, sometimes with PD0, etc. It should end with the last pin name every time.  Mine is truncated around PD(last) to PD(0 or 1).

oldman4U, 2020-09-17:
I never took care because it works. But you are right.

Do you have a WIFI module?  I use it for this kind of communication.

lamikr, 2020-09-17:
Could it be that the modemmanager or some other software like that is trying to connect simultaneously with the /dev/ttyACM0?

Yenya, 2020-09-18:
Interesting guess, but no - I use XFCE and have no modemmanager running. As far as I can tell, (fuser(1)) nobody has /dev/ttyACM1 opened.

No WiFi module here.

oldman4U, 2020-09-30:
Please help the community and close the ticket once you do not need it anymore. Thank you

Yenya, 2020-10-02:
It seems the same problem - not being able to print over serial port using slic3r and RepetierHost, while Pronterface apparently works - is also on SKR v1.4 Turbo. Keeping the issue open for now.

oldman4U, 2020-10-02:
Ok. Thank you for the update

evandene, 2020-11-25:
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

Did you checked this jumper?

Yenya, 2020-11-25:
Yes, of course.

evandene, 2020-11-25:
Great, I hope you could solve your issue.
I'm struggling with my limit switches on my skr pro 1.2 and my DELTA printer. Tried everything and from BTT 0.0 support.

Thread 169 (2020-09-25):

endstops not working after plugging in a driver (TMC2209)

outtacontrol216, 2020-09-25:
without a driver in the slot the endstop is working fine (red LED is ON and goes off when i trigger the endstop).
When i power off the board and plug in a TMC2009, the red LED is not ON and the endstop for this slot is not working anymore.
setup of the endstops are COM to ground and NC to Signal.
in marlin 2.0 endstop inverting is on false.

thank you for your help

oldman4U, 2020-09-25:
Are you going to use sensor-less homing?
If not, have you removed the diagram pin from the 2209?

outtacontrol216, 2020-09-26:
i am not going for sensor-less homing.
there is absolutely no difference when i remove the DIA pin of the TMC2209.
as is said, the endstops are working and the red LED`s near the driver are ON only when there is no driver in the slot.

outtacontrol216, 2020-09-26:
update: u cutted the wrong pin
https://github.com/bigtreetech/BIGTREETECH-TMC2209-V1.2/blob/master/TMC2209%20problems%20solving.pdf
helped me alot
thank you

oldman4U, 2020-09-26:
👍🏻

Closed 2020-09-26.

Thread 172 (2020-10-09):

Board not accepting firmware (skr pro v1.2)

quad121, 2020-10-09:
When trying to flash firmware to the board using the sd card and 'firmware.bin' file won't install to board.

oldman4U, 2020-10-09:
Which firmware. Sd card size and format. Pictures.

Please

quad121, 2020-10-09:
I am trying to flash 'klipper' to the board using a Sandisk 32gb sd card, which has been formatted in the 'fat32' format (new card).

quad121, 2020-10-09:
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

oldman4U, 2020-10-09:
I would use a card smaller 8GB for firmware flash, best the one which was included. Klipper I do not know. Sorry

oldman4U, 2020-10-09:
But I would try it with the standard Marlin for a test of the hardware.

quad121, 2020-10-09:
Many thanks for your time, I will try and flash the board with marlin and see how it goes.

oldman4U, 2020-10-09:
Let me know.

Paul Harper <notifications@github.com> schrieb am Fr. 9. Okt. 2020 um 13:12:

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

quad121, 2020-10-09:
I will.

quad121, 2020-10-09:
O.K, I've downloaded the latest Marlin and configured and built using VS Code.
The file still never got accepted!

quad121, 2020-10-09:
I can't believe that a large manufacturing firm like Big TreeTech keep on supplying faulty goods?
I have had 2 skr 1.4 turbo mobo' s and both turned out to be faulty, as both had faulty mosfets on the part cooling fan output.

oldman4U, 2020-10-09:
Can you zip you config and advanced and attach it here?

oldman4U, 2020-10-09:
And use the sd card which came with the board.

You can rename the firmware file and try it directly with it.

quad121, 2020-10-09:
[untitled folder.zip](https://github.com/bigtreetech/BIGTREETECH-SKR-PRO-V1.1/files/5355483/untitled.folder.zip)

This file was loosely configured, just to try to see if it would load!
I also did use the SD Card which came with the board

quad121, 2020-10-09:
I also tried the BTT's Firmware also!!!

quad121, 2020-10-09:
There also doesn't seem to be any lights lit either? Ive checked the fuses etc

oldman4U, 2020-10-09:
Yes, please do so...

I mean you have connected almost everything possible, but you should start with the basics and add more stuff later on.

quad121, 2020-10-09:
I've found this, I don't know if it will work but I suppose it's worth a go.

https://www.youtube.com/watch?v=7O_ZOdnM0SU&feature=youtu.be

oldman4U, 2020-10-09:
Maybe you want to check if it takes power from USB first (check the jumper configuration) and also if the fuses are ok.

quad121, 2020-10-10:
While waiting for the ST Link I thought I would connect the printer using Pronterface. Which it does connect! No function of the Axis though
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

quad121, 2020-10-10:
This must be firmware which was installed via the Company!

quad121, 2020-10-10:
Ok, I've sorted the problem out and also have got the firmware to flash also

dzervas, 2021-12-23:
but HOW did you solve it? @quad121

afbenevides, 2022-01-18:
Hi, I would be interested in new solution ideas too if one has? I'm stuck with SKR pro 1.2 too not accepting firmware. Thanks, @dzervas @quad121

afbenevides, 2022-01-18:
Thanks @quad121 the YouTube link + GitHub link did the trick for 2 of them... now I have to investigate the other 2 problem...

I put them here in case it helps someone else:

https://www.youtube.com/watch?v=7O_ZOdnM0SU
https://github.com/P-C-R/SKR_PRO_BOOTLOADER_REPAIR

olijouve, 2022-11-09:
Hello @quad121, what was your issue that used to make the fuses blow immediately after replacing, and how did you fixed it ?

Closed 2020-10-10.

Thread 173 (2020-10-11):

Increasing z-axis offset while running

HorstHardcore, 2020-10-11:
Hi,

I am not sure, if this is the right place for my problem, but I couldnt get help so far. So I want to ask for help here now.

My printer is running with a SKR 1.1 pro with TMC2208 drivers. Both of the z-axis stepper motors are controlled by the same stepper driver, but both motors got their own connector on the mainboard. The problem is, that the longer my printer is running and moving in z-axis, the more tilted my x-axis carriage (where the extruder is mounted) gets.
That means, I calibrate my z-axis, so that the distance between z-axis and print bed is the same on both sides (right and left) and it constantly sets off one side of the z-axis, when the printer is running. And its reproducable. Its about 0,5 mm offset for about 1 or 1,5 hours of print time. When i flip the connectors of stepper motors on the mainboard, it also flips the offset (on which side the offset happens).

Now I am curious, if my mainboard has an electric defect, because i cant imagine that this problem is up to my stepper drivers, because both motors are controlled by the same driver and just to be sure, I already exchanged the driver for the z-axis and this didnt help at all. Or maybe there is a totally different reason for the problem?

I would be very glad, if somebody can help. If further information are neccessary, please ask.

dineshvyas, 2020-10-12:
Keep same arrangement and only swap cables. See if problem persists.

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

oldman4U, 2020-10-27:
@HorstHardcore

Any news?

dineshvyas tried to help, but never got an answer from you.

HorstHardcore, 2020-11-22:
@dineshvyas and @oldman4U I am very sorry for my late answer. I appreciate the help but i had very little time to spend on my printer lately and couldnt test it as much. I swapped the cables and it seems to be better, although i cant say yet, that the problem is completely solved.
Despite having little time to test it properly, I also ran into another problem which prevents me from verifying my assumption. I am sorry.

oldman4U, 2020-11-22:
No reason to be sorry, but if you can not follow the problem it would be best to close the ticket and reopen it once you have time.

Thank you

Closed 2020-11-23.

Thread 175 (2020-10-25):

Caught on Fire

rjdandy, 2020-10-25:
I wired the board to 24VDC for the motors and the board and powered up with no issue. But when i went to connect my computer to the board through USB the processor on the board caught fire, the USB cable melted and my usb ports on my computer were damaged and not longer work.

oldman4U, 2020-10-26:
Hi. How can we help you?

rjdandy, 2020-10-26:
I was wondering if anyone has seen this before or tell me what i did wrong that would have caused this. I am going to order a new board and i don't want this to happen again.

oldman4U, 2020-10-26:
This makes sense.

What kind of power supply do you use? A broken CPU is not very common.

rjdandy <notifications@github.com> schrieb am Mo. 26. Okt. 2020 um 11:57:

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

rjdandy, 2020-10-26:
FYI, I am building a Mostly Printed CNC machine.

When i first powered up the board to check firmware i powered the board through USB and everything was ok as well. Once i got the machine built and wired to the external power supply i moved the jumper between IN and VCC

Padarsey DC 24V 15A 360W Power Supply
https://www.amazon.ca/gp/product/B07CPTHG7N/ref=ppx_yo_dt_b_asin_image_o02_s00?ie=UTF8&psc=1

oldman4U, 2020-10-27:
Looks like a decent power supply. Have you checked the output of it to be 24V?

Especially the SKR Pro is very stable when it comes to power input and internal power management and I have two of them working flawlessly.

I used the USB only for Printrun at the beginning, now I do not use it at all and use WIFI instead. So my experience with USB is very limited I must say.;-(

Hope this helps

oldman4U, 2020-12-22:
Please help the community and close the ticket once you do not need it anymore. Thank you

Thread 176 (2020-10-26):

BIGTREETECH-SKR-PRO-V1.1 + max31865 + tft35 v2.0  "no printer attached"

daniagos, 2020-10-26:
Hi,
i am runnng a skr pro v 1.1
tft 35 v2
tmc2209, uart mode, sensorless homing
marlin 2.0.x, latest release
While trying to change TEMP_SENSOR_0 from 1 to -5 (which indicates i am using a max amplifier) the tft disconnects.

i can't also upload firmware via usb but i need to upload it every time with sd card, quite annoying (i use vscode)

https://drive.google.com/drive/folders/1DBuVxjGbWB0jsPYh_vwEzkzLrf90pklb?usp=sharing

this is the link with the full marlin version i am using, here the tft is not working

GadgetAngel, 2020-10-27:
Please see this following issue:  https://github.com/bigtreetech/BIGTREETECH-SKR-PRO-V1.1/issues/163#issuecomment-680798334

GadgetAngel, 2020-10-27:
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

Please ZIP up the Marlin folder using WINZIP.  The folder takes to long to download uncompressed.  I need to download the ZIP file containing the whole Marlin folder.

GadgetAngel, 2020-10-27:
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

How do you have your MAX31865 wired up to the SKR PRO V1.1 board?

On top of that I really need to see the error message coming from Marlin for the MAX31865 board, but since you are using a TFT screen you will not see the message all you will see in "no printer attached".  Please use a 12864 LCD on EXP2 so you can see what error message Marlin is sending you.  Yes, the 12864 LCD uses both the EXP1 and EXP2 connectors but you just need to clamp on a tap to EXP2 to access the hardware SPI lines (https://www.digikey.com/product-detail/en/te-connectivity-amp-connectors/1658622-1/AKC10B-ND/825411)

But from looking at your firmware files it looks like the Hardware SPI configuration you are using the MAX31865 should work.

To do any more debugging we need to know the exact error message Marlin is sending out.

GadgetAngel, 2020-10-27:
## @daniagos I noticed that in **configuration.h** file you have not **enabled** the Marlin variable **SDSUPPORT**.  I believe you need to enable this parameter.

If you enable SDSUPPORT and get the 12864 LCD we can test to see if the hardware SPI is working on the SKR PRO V1.1 board by seeing if you can use the SD card on the LCD screen.  Without SDSUPPORT the SD card is not supported because the SD_DETECT_PIN is not defined:

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

## With your tft screen, try just enabling SDSUPPORT in configuration.h and see if that change effects the problem.

daniagos, 2020-10-27:
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

this is the wiring setup

is with this connector ((https://www.digikey.com/product-detail/en/te-connectivity-amp-connectors/1658622-1/AKC10B-ND/825411)) possible to attach both lcd and use spi hardware cables?

I enabled sd card pin, and i recieve the error " Printer halted. kill() called! " as soon as it turns on, then disconnects

daniagos, 2020-10-27:
you left me on facebook, now i want to use only one of it, to add the second later, but even with only one it can't work

daniagos, 2020-10-27:
i tried commenting all the "THERMAL_PROTECTION" but nothing changes, i have the same error and then it disconnects

daniagos, 2020-10-27:
I tried to set the "TEMP_SENSOR_0 -3", i still have the same error, but the tft stay connected, i can see bed temperatures.
i disabled all the security features, set min temp to -100, but with "TEMP_SENSOR_0  -5" there is no way to have the tft connected

once i switch back to 1 all runs and the thermocouple works fine.

daniagos, 2020-10-27:
i have the same error even with "TEMP_SENSOR_0 147" and 1047, there is something really strange

daniagos, 2020-10-27:
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

it seem as if the option is disabled even if it is defined correctly

GadgetAngel, 2020-10-28:
> 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
>
> it seem as if the option is disabled even if it is defined correctly

It appears disabled because you have not **enabled** SDSUPPORT in configuration.h file.  Please remove the two forward slashes on the SDSUPPORT line in configuration.h file.

Yes, this connector ((https://www.digikey.com/product-detail/en/te-connectivity-amp-connectors/1658622-1/AKC10B-ND/825411) will allow you to add a third connector to EXP2 which will then allow you to access the hardware SPI lines that the LCD screen uses.  The default hardware SPI bus is used by the EXP2 connector or the LCD screen.  As long as the MAX31865_CS_PIN is different than the SDSS PIN then both can use the same hardware SPI bus.

PUT you MUST enable the Marlin variable SDSUPPORT in configuration.h file.

daniagos, 2020-10-28:
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

As you can see i enabled sd card, but that part still seem disabled.

i can't understand why i have also error if i use pt100 set as "TEMP_SENSOR_0 147", and the pt100 connected to the thermocouple pins, this should work even without spi, right?

GadgetAngel, 2020-10-28:
@daniagos upload your zipped Marlin folder again to your google drive, so I can look at the changes you currently have in your firmware.  You will have to get a new shared link to the new zipped Marlin folder and place the link here in the thread so I can download your Marlin folder.

> i can't understand why i have also error if i use pt100 set as "TEMP_SENSOR_0 147", and the pt100 connected to the thermocouple pins, this should work even without spi, right?

I do not understand what you are trying to do here.  Did you remove or disable the following in pins_BTT_SKR_PRO_common.h when you set TEMP_SENSOR_0 to 147?:
```
#ifndef MAX38165_CS_PIN
  #define MAX6675_SS_PIN                   TEMP_0_PIN
  //#define MAX6675_SS2_PIN                  TEMP_1_PIN // Force hardware SPI to be used making MAX38165_CS_PIN equal to  MAX6675_SS_PIN
  #define MAX38165_CS_PIN                  MAX6675_SS_PIN
#endif
```
Did you change TEMP_0_PIN also? Why are you using a thermocouple? I thought we were hooking up a PT100 and MAX31865 board.  Let's take on problem at a time.  Which situation do you  want to debug?

When I looked at your Marlin folder earlier and I enable SDSUPPORT with the TEMP_SENSOR_0 set to -5 and pins_BTT_SKR_PRO_common.h set as follows

```
#ifndef MAX38165_CS_PIN
  #define MAX6675_SS_PIN                   TEMP_0_PIN
  //#define MAX6675_SS2_PIN                  TEMP_1_PIN // Force hardware SPI to be used making MAX38165_CS_PIN equal to  MAX6675_SS_PIN
  #define MAX38165_CS_PIN                  MAX6675_SS_PIN
#endif
```
the section listed as
```
#if SD_CONNECTION_IS(LCD)

  #define SD_DETECT_PIN                     PF12
  #define SDSS                              PB12

```
was enabled!

So you have changed too many things and now I have no idea what state your Marlin firmware is in.  So again I ask that you upload you current Marlin folder to your google drive so I can help you debug what is going wrong.

Which PT100 cartridge are you using?

How did you hook up the PT100 sensor (or cartridge) to the thermistor port without an amplifier board?

Most PT100 need amplification "The E3D PT100 amplifier board amplifies the signal from the PT100 to a voltage level that your printer controller can read easily and accurately" but the E3D PT100 amplifier board means you would use thermistor table 20 or 21.  I know you can use this PT1000 sensor and use thermistor table 1047 (https://e3d-online.com/products/pt1000-temperature-sensor?_pos=1&_sid=26fb8c09c&_ss=r).

I do not know why your PT100 did not work with table 147 because I do not have all the above information.  Lets stick to trying to get the MAX31865 board (amplifier board) working with hardware SPI and the PT100 sensor connected to the MAX31865 board.

I have never used thermistor table 147 with PT100 temperature sensor on a SKR PRO V1.1 board.

daniagos, 2020-10-28:
i want to debug the e3d pt100 with max amplifier.

starting from stock marlin to see if there are other things that gives me tft error, all security removed, SDSUPPORT enabled

1) i started with "TEMP_0_PIN 1" with a termocouple installation as in stock marlin.
all works fine, no error, temp corrected.
1.1) removed the sensor, it show -15 degrees but still no error as expected

2) i tried to see if there is problem with the pt100 installed as the termocouple, so removed termocouple, installed pt100 in the same 2 pins, set "TEMP_0_PIN 147".
ERROR: printer halted, kill() called

this make me think of a library problem more than a hardware problem

3) i tried to connect the max amplifier

wired it
checked that SDSUPPORT is enabled

wrote in pins

#ifndef MAX38165_CS_PIN
  #define MAX6675_SS_PIN                   TEMP_0_PIN
  //#define MAX6675_SS2_PIN                  TEMP_1_PIN // Force hardware SPI to be used making MAX38165_CS_PIN equal to  MAX6675_SS_PIN
  #define MAX38165_CS_PIN                  MAX6675_SS_PIN
#endif

changed

 #define TEMP_0_PIN  PF4         to      #define TEMP_0_PIN       PE4

And do the other setting on config_adv listed in your picture.
ERROR: printer halted, kill() called.

i think that i don't have the right library installed, on platformio is there only available the "adafruit/Adafruit MAX31865 library@^1.3.0", That is listed in my env and installed, but on the  [features] in platformio i find this:

 max6675_is_max31865 = Adafruit MAX31865 library@~1.1.0

is there something i should correct?

as soon as i can i zip the marlin and upload it on google drive

GadgetAngel, 2020-10-28:
### @daniagos This is my current understanding of the different PT100 thermistor tables in Marlin 2.0.x:

---
### PT100 Thermistor tables and how to use them:

I should use **table "-5"** if I am using a PT100 sensor attached to the MAX31865 board and the SPI bus.

I should use **table "20"** when I use a PT100 sensor attached to a PT100 amplifier board (INA826 amp) AND the power supplied to that PT100/PT1000 Amplifier board (INA826) IS EQUAL TO the ADC reference voltage for the MCU AND there is NO Pull-UP resistor.  --NOTE: For SKR PRO V1.1/V1.2, SKR V1.3/V1.4/V1.4 Turbo, GTR V1.0, M5 V1.0 all use 3.3 VDC as the ADC reference voltage for the MCU. Therefore use table 20 when the PT100/PT1000 Amplifier board is powered by 3.3VDC

I should use **table "21"** when I use a PT100 sensor attached to a PT100 amplifier board (INA826 amp) AND the power supplied to that PT100/PT1000 Amplifier board (INA826) IS DIFFERENT FROM the ADC reference voltage for the MCU AND there is NO Pull-UP resistor.  --NOTE: The E3D PT100 Amplifier board wants 5V as its power supply. But the SKR PRO V1.x (like the GTR V1.0) uses 3.3VDC as the ADC reference voltage for the MCU. If you use 5VDC to power to the PT100 amplifier board, the amplifier can output a maximum signal with 5VDC. To protect the SKR PRO V1.x board (or the GTR V1.0 board, or SKR V1.3 or SKR V1.4 or SKR V1.4 TURBO), use a 3.6V Zener Diode (reverse biased hookup) between the output signal of the PT100 amplifier board and the PT100 amplifier board's ground (to protect the MCU from getting fried from a 5VDC input signal).

I should use **table "147"** when I use a PT100 sensor attached to a PT100 amplifier board (INA826 amp) that uses 5VDC as its input voltage and is wired up to a MCU's analog input PIN which is 5VDC tolerant and has a 4.7k pull-up resistor attached to the analog input PIN.

I should use **table "110"** when I use a PT100 sensor attached to a PT100 amplifier board (INA826 amp) that use 5VDC as it input voltage and is wired up to a MCU analog input PIN which is 5VDC tolerant and has a 1k Ohm pull-up resistor attached to the analog input PIN.

I should use **table "201"** when I have a PT100 sensor attached to a PT100 amplifier board that uses LMV324 amp (used by the 3D printer Overlord V1.1) and the amplifier board uses 5VDC as its input voltage and is wired up to a MCU analog input PIN which is 5VDC tolerant and has NO pull-up resistor attached to the analog input PIN.

I should use **table "1047"** when I have a PT1000 sensor attached to NO AMPLIFIER board and the PT1000 sensor is wired up to a MCU analog input PIN which is 5VDC tolerant and has a 4.7K pull-up resistor attached to the analog input PIN. Here is the PT1000 sensor (https://e3d-online.com/products/pt1000-temperature-sensor)

I should use **table "110"** when I have a PT1000 sensor attached to NO AMPLIFIER board and the PT1000 sensor is wired up to a MCU analog input PIN which is 5VDC tolerant and has a 1K pull-up resistor attached to the analog input PIN.  Here is the PT1000 sensor (https://e3d-online.com/products/pt1000-temperature-sensor)

---

If you look at the processor data sheet for the SKR PRO V1.x or SKR V1.3/SKR V1.4 or SKR V1.4 Turbo or GTR V1.0/M5 V1.0 boards (https://www.st.com/resource/en/datasheet/stm32f407zg.pdf) or (https://github.com/bigtreetech/BIGTREETECH-SKR-V1.3/blob/master/BTT%20SKR%20V1.4/Datasheet/LPC17-32-IC.pdf) or (https://github.com/bigtreetech/BIGTREETECH-SKR-V1.3/blob/master/BTT%20SKR%20V1.4/Datasheet/LPC17-32-IC.pdf) or (https://www.st.com/resource/en/datasheet/stm32f407ig.pdf) you will see the PINs for the thermistor ports **are 5VDC tolerant as long as they are NOT USED for analog input.**  When they are **used for analog input they are ONLY 3.3VDC tolerant**. See note (4) on processor data sheet for SKR PRO 1.x or GTR V1.0/M5V1.0. See note [2] on processor data sheets for SKR 1.3/V1.4 or SKR V1.4 Turbo.  Therefore, you can use a 3.6V Zener Diode (reverse bias hookup) between the analog output pin for the amplifier board and the amplifier board's ground pin to protect the SKR series boards from getting fried:

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

GadgetAngel, 2020-10-28:
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

YES, you only want Adafruit MAX31865 library version 1.1.0.  Un-install Adafruit MAX31865 V1.3.0 library!

Here is the way to tell that you are using the right library.  When you compile the code after the success message appears, scroll to the very top of the output listing and look for the library version the compiler used to create the .bin file:

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

To uninstall the wrong library versions go to the Platformio HOME page and select "Libraries", then select the Installed tab, then in search field type "Adafruit MAX31865". Select the uninstall button for all libraries that are not V1.1.0.

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

Once all MAX31865 libraries of version 1.3.0 are un-installed then just recompile the code. Marlin will see that the Adafruit MAX31865 library is not installed and automatically download the correct version 1.1.0.

GadgetAngel, 2020-10-28:
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

If it works or does not work let me know.

daniagos, 2020-10-28:
it doesn't work neither in this way..

https://drive.google.com/drive/folders/1DBuVxjGbWB0jsPYh_vwEzkzLrf90pklb?usp=sharing

this is the link, there is the zip file of marlin of the actual configuration i tried..

GadgetAngel, 2020-10-28:
@daniagos Try connecting the MAX31865 board up via Software SPI instead of Hardware SPI.  If we get software SPI to work then we at least know the MAX31865 board is working properly.

GadgetAngel, 2020-10-28:
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

I looked at your new configuration files from your google drive:

currently in **configuration.h** file you have:
`#define EXTRUDERS 1`
Which is what we want, we want to try to only get ONE hot end to work on MAX31865 board using hardware SPI.

BUT
currently in **pins_BTT_SKR_PRO_common.h** file you have:
```
#ifndef MAX38165_CS_PIN
  #define MAX6675_SS_PIN                   TEMP_0_PIN
  #define MAX6675_SS2_PIN                  TEMP_1_PIN // Force hardware SPI to be used making MAX38165_CS_PIN equal to  MAX6675_SS_PIN
  #define MAX38165_CS_PIN                  MAX6675_SS_PIN
#endif
```

When you ` #define MAX6675_SS2_PIN                  TEMP_1_PIN`  the temperature.cpp file will try to toggle the MAX6675_SS2_PIN to see if it can gather information off the second MAX31865 board.  So please leave everything the same EXCEPT **comment out** the ` #define MAX6675_SS2_PIN    TEMP_1_PIN` line **in pins_BTT_SKR_PRO_common.h file**.

So I want your **pins_BTT_SKR_PRO_common.h file**:
```
#ifndef MAX38165_CS_PIN
  #define MAX6675_SS_PIN                   TEMP_0_PIN
  // Force hardware SPI to be used making MAX38165_CS_PIN equal to  MAX6675_SS_PIN
  #define MAX38165_CS_PIN                  MAX6675_SS_PIN
#endif
```

I know this might not fix the issue but I would like for you to try this before we have you try to use Software SPI instead for Hardware SPI.  Marlin must be working on the MAX31865 stuff.  I recently got two other users MAX31865 boards to work in software SPI but you are the first user I have worked with trying to get hardware SPI to work.

Where did you buy your MAX31865 board? Did you get it from Adafruit?  Try the above change then let me know if it worked or not and we will talk about trying to use the board in Software SPI.

You see, If the MAX31865 will work in Software SPI then we know the MAX31865 board is working.  The next step would be to open a tick under Marlin firmware to let them know we have a MAX3165 working in Software SPI but we can not get it to work in Hardware SPI mode.

GadgetAngel, 2020-10-29:
@daniagos Look at this: https://github.com/MarlinFirmware/Marlin/issues/5723#issuecomment-554800209

There might be a problem with the speed and mode.  From looking at the Marlin code, from HAL_SPI.cpp the SD card is using SPI mode 0 and from SdFatConfig.h the SD card is using Using SPI_SD_INIT_RATE 5 which sets the init clock at 328KHz for sd-card or 0.328MHz.

For the MAX31865 board, the Adafruit_MAX31865 board in hardware spi mode, the MAX31865 board defaults to SPI MODE 1 (from Adafruit_MAX31865.cpp) and speed of 500000.

So it appears the HAL_SPI.cpp(Marlin\src\HAL\STM32\HAL_SPI.cpp) for the SKR PRO V1.x board is using SPI MODE 0 while the Adafruit_MAX31865 board is defaulting to SPI MODE 1.  We could try and change the SPI MODE 1 (SPI_MODE1) to SPI MODE 0 or SPI_MODE0 and see if that makes it work. But if you do this and then later switch to Software SPI,  you will need to switch the SPI MODE back to SPI_MODE1.

I think you need to send this to the Marlin firmware guys, (open a ticket under https://github.com/MarlinFirmware/Marlin/issues) because I do not think Hardware SPI works for MAX31865 board on the SKR PRO board.  We are now getting beyond my ability to help.

GadgetAngel, 2020-10-29:
@daniagos Use (Appendix M, Analog Procedure using  2 PT100 amplifier boards) Technique number 1 and Technique number 2 that way you do not need to do the hardware hack on the SKR PRO V1.1 board.

GadgetAngel, 2020-10-29:
@daniagos I am going to test your setup when the TFT35 V2.0 arrives in two days.

daniagos, 2020-10-30:
thanks, in those days i make all the trials you suggest, thank you so much

oldman4U, 2020-10-31:
> @daniagos I am going to test your setup when the TFT35 V2.0 arrives in two days.
>
>

Are you buying hardware to be able to help others, Angel!!??

daniagos, 2020-11-01:
hI, I commented the #define MAX6675_SS2_PIN TEMP_1_PIN, no changes of the problem.

i am still in hardware configuration, i tried looking for the spi mode in HAL_SPI.cpp(Marlin\src\HAL\STM32\HAL_SPI.cpp), but my SPI_MODE is SPI_MODE0 from the beginning of all .

I founded this in pins configuration:

#if SD_CONNECTION_IS(LCD)

  #define SD_DETECT_PIN                     PF12
  #define SDSS                              PB12

#elif SD_CONNECTION_IS(ONBOARD)

  // The SKR Pro's ONBOARD SD interface is on SPI1.
  // Due to a pull resistor on the clock line, it needs to use SPI Data Mode 3 to
  // function with Hardware SPI. This is not currently configurable in the HAL,
  // so force Software SPI to work around this issue.
  #define SOFTWARE_SPI
  #define SDSS                              PA4
  #define SCK_PIN                           PA5
  #define MISO_PIN                          PA6
  #define MOSI_PIN                          PB5
  #define SD_DETECT_PIN                     PB11

from what i understand i do not have the right configuration to let sd use hardware spi, so nothing will work, right?

GadgetAngel, 2020-11-01:
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

@daniagos I am still working on it.

Just got in the TFT screen and I just solder together my Adafruit MAX31865 board.

I checked yesterday that the Adafruit MAX31865 board will work with the SKR PRO V1.1 and the TFT35 V2.0.  IT does.

Today is when I work on hardware SPI.

The reason I did it this way was to ensure that both my PT100 sensor and the Adafruit MAX31865 board are in working condition.

I also have my SKR PRO V1.1 board  with BIQU TMC2209 in UART mode on X, Y, Z and E0.

Let me do some more testing and see what I can figure out.

@oldman4U Yes, I did not own a TFT35 V2.0 and I wanted to try it since it does not have the dual mode capability and only has the touch screen.  Neat device.  I even got my logo to come up on the screen.  I like trying out new stuff that is why they call me "Gadget Angel".  I love gadgets!

daniagos, 2020-11-01:
I am trying with software spi mode for one adafruit max31865 right now, i  can't make the adafruit work neither in this case,i have always the same error of printer killed, i really don't know what's wrong with my setting

GadgetAngel, 2020-11-01:
@daniagos I hooked up **my MAX31865 board** as follows:

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

---

**I have the same exact board (SKR PRO V1.1) and drivers (TMC2209 in UART mode) as you do and the TFT (TFT35 V2.0) stays connected!**

I defined my **SERIAL_PORT** and **SERIAL_PORT_2** as follows (remember I just got my TFT35 V2.0 so I compiled the TFT35 screen firmware and updated the firmware for the screen before this test to ensure the screen was not getting into the issue, I highly recommend that you compile your TFT35 firmware and update the firmware on you TFT35 V2.0 screen):

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

Here is **a video of the bootup process**, you can see I never touch the TFT screen and the TFT screen will after about 30 seconds start displaying the temperature for the PT100 sensor:

https://drive.google.com/file/d/1OGdkTxWqfj61Y-6039-VQrJ3G60MO_hF/view?usp=sharing

I connected **pronterface** (http://kliment.kapsi.fi/printrun/) to my board via the USB connection and found I was getting a lot of "Temp measurement errors" but the SKR PRO V1.1 board **was still able to read the PT100 sensor temperature values**.  If you look here https://github.com/MarlinFirmware/Marlin/issues/5723#issuecomment-557290199, Marlin knows of this issue but it did not make the TFT disconnect from the SKR PRO V1.1 board.

Here is are pictures of my hook up:

Green wire is CS of Adafruit MAX31865 board
Purple wire is SDI of Adafruit MAX31865 board
Brown wire is SDO of Adafruit MAX31865 board
White wire is CLK of Adafruit MAX31865 board
Black wire is GND of Adafruit MAX31865 board
Red wire is VIN of Adafruit MAX31865 board

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

To handle the errors you can just set the SERIAL_PORT to 1 and disable SERIAL_PORT_2.  You will still be getting  "Temp measurement errors" but you will not see them on the TFT screen.  **Marlin needs to fix this problem** but as you can see from https://github.com/MarlinFirmware/Marlin/issues/5723#issuecomment-557290199 they are aware that the issue.
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

Thread 177 (2020-10-30):

During print, the printer pauses because it thinks it's out of filament but it's not

bobjones113, 2020-10-30:
Not sure if this is a bug or a feature(?).  I've had a few failed prints now because the printer thinks the filament has run out but it hasn't.  I have a filament sensor(just a simple switch type) and that is always connected.  In the terminal it says the filament had run out, paused waiting for user. I send M108 to resume because I can see there is still filament and also can force filament through the nozzle. It will then heat up the tool again to temp and sits and says paused for user again.  I send another M108 but nothing happens.  I send ten more and nothing happens.  The temperature for the bed and tool stay at temp but no progression.  I have to power cycle the board to continue and fail the print at that point.  I'll post my configs soon.  Any help would be appreciated! Thanks in advance.

oldman4U, 2020-10-31:
Sounds like a problem with the switch or the cable. Remove them and see if it still happens. Depending on your software setup you eventually have to shorten the pins on the mainboard.

bobjones113, 2020-10-31:
I'm thinking it's a board leveling issue.  I think the pressure builds up when the build plate is too high and doesn't allow filament to pass and causing it to think there isn't any filament?

Closed 2020-10-31.

Thread 178 (2020-11-04):

Error Communicating with SKR PRO V1.1

TechnicalWorld2016, 2020-11-04:
I had uploaded marlin 2.0 firmware on my Bigtree tech SKR PRO V1.1 board successfully and connected with pronterface and checked the motor orientations. Next day I am about to do the PID tuning, but the board was not connecting to my PC, no COM port is detected my PC, I have tried to connect with other laptops in my office, but there is no result. The board is getting power on and taking input supply. When I try to press ENDSTOP manually, the respective led near stepper driver is blinking, resulting in normal functionality. But I am unable communicate with the board neither with Pronterface nor with TFT 2.8. I have tried changing the serial_port, Serial_port 2 in marlin and tried to upload the firmware, but no change in the result, finally I am unable to cummunicate with the Board.

If anyone have a solution, please do reply.

AnHardt, 2020-11-04:
Concentrate to the thermal settings. Having them wrong causes a KILL what causes the loss of communication. Messing with the serials will not have any positive effect.

oldman4U, 2020-11-04:
Hi.

In case something works properly but does not do so without changing anything - a hardware issue is most likely.

For USB and TFT connection of this board, you have to activate serial port -1 and 1.

Maybe attaching the Config files could help, but like I said. Most likely a hardware issue and then I would check the fuses first.

TechnicalWorld2016, 2020-11-05:
Hi,
thank you for your suggestions.

Even i thought some hardware issues, the board doesn't have any traces of burns. It seems fine.

oldman4U, 2020-11-05:
Maybe I am wrong or the provided information is not leading into the right direction. Happened to me a few times now, that I changed something which caused an issue somewhere else and it took some time to understand the relationship.

Btw. For this SKR board, the ESP01 based WIFI module replaced the USB connection completely for me.

Please do not forget to close this ticket in case you do not need it anymore.

Thank you

oldman4U, 2020-12-22:
Please help the community and close the ticket once you do not need it anymore. Thank you

AMarinR, 2021-02-07:
hello, I have exactly the same problem, yesterday everything worked fine, and today the board does not connect, not with the pc via usb, not with the screen, nor with the wifi.

any ideas?

AMarinR, 2021-02-08:
I have solved it by flashing the bootloader

SwiftNick, 2021-02-11:
Try enabling DTR/DSR in your comms settings

TechnicalWorld2016, 2021-02-15:
Really great to know. Is it possible to show how to Boot load it pls?

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

jim-thompson, 2021-04-03:
> I have solved it by flashing the bootloader

@AMarinR How did you flash the bootloader and where did you find the bootloader binary?

ElekKecskemeti, 2021-05-17:
I had the same problem. I also found a description and bootloader for my motherboard here. That solved it for me. I hope it helps you too.

[link1](https://github.com/GadgetAngel/BTT_SKR_13_14_14T_SD-DFU-Bootloader/blob/main/Guide%20ST-LINK%20Utility%20on%20Windows%2010%20for%20ST-Link-V2-Clones%20for%20accessin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)
[link2](https://github.com/GadgetAngel/BTT_SKR_13_14_14T_SD-DFU-Bootloader/tree/main/bootloader_bin/backed_up_original_bootloaders)

AMarinR, 2021-05-17:
I followed the instructions in this video

https://youtu.be/7O_ZOdnM0SU

Enviado desde mi iPhone X

El 17 may 2021, a las 9:20, ElekKecskemeti ***@***.***> escribió:

I had the same problem. I also found a description and bootloader for my motherboard here. That solved it for me. I hope it helps you too.

link1
link2

—
You are receiving this because you were mentioned.
Reply to this email directly, view it on GitHub, or unsubscribe.

TechnicalWorld2016, 2021-08-04:
Hi
every one. Thank you very much for your replies so far.

I have purchased an st-link and tried connecting to the Board, All the connections were correct.

I am unable to read or write i.e., unable to access the memory of the board but my board is getting connected to the st-link utility.

I have checked the readout protection, It was set to 1, and it is protected status.

As 1 can be  replaced 0 as mentioned in the community.. I have tried changing 1 to 0 and tried connecting once again but the same problem repeats again ..  And the Readout protection is not changed to 0, it is still 1 as previous.

But as per community guides and manual 1 can be overwrite to 0, Only read out protection 2 is not able to overwrite to 0 or 1 .
but 1 can be overwritten to 0.

But in my case I am unable to do it.
And, finally I am unable to upload the boot-loader again.

Someone please help me in this regard.

Thank you

Thread 180 (2020-11-23):

SKR Pro 1.2   If Limit switches are triggered, no movement response

evandene, 2020-11-23:
Symptom
When the board is fully wired, including BLTOUCH, the axis movements do not respond on triggered limit switches.
When limit switches are triggered, LED's along the stepper connectors do blink on/off accordantly.
When M119 executed all limit switches do stay triggered no matted if activated or not.
configuration files and PIN-file attached
Could somebody please help?
Thanks

[SKR_PRO_1_2.zip](https://github.com/bigtreetech/BIGTREETECH-SKR-PRO-V1.1/files/5582104/SKR_PRO_1_2.zip)

Board SKR Pro 1.2
Delta Printer
PCB limit switches used; VCC GND SIG
TMC2209 DIAG pins removed as advertised by BTT
Driver jumper set for UART (first pin duo)

evandene, 2020-11-27:
Now for three days I was trying to make my DELTA printer to work with the TMC5160 in PSI mode but without luck.
The X-Y-Z movements are okay but the enstops do not work for a DELTA printer
A DELTA printer needs to home to MAX, and that simple doesn't work
No support from BIGTREETECH as always
What a waste of time and money

evandene, 2020-12-12:
I have decided to scrap both my boards, the SKR PRO v1.1 and the SKR PRO v1.2
Both board have hardware flaws, and for both boards none or crappy support from Bigtreetech. Sad but lesson learned.

oldman4U, 2020-12-15:
Have you checked #103?

evandene, 2020-12-15:
Yep I did

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

oldman4U, 2020-12-15:
Last try - 502/500 to clear ERPROM?

Ed van den Enden <notifications@github.com> schrieb am Di. 15. Dez. 2020 um
23:01:

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

evandene, 2020-12-16:
SKR PRO v1.1 and v1.2 do not have an EEPROM but created a soft eeprom with enabling SDSUPPORT
After every new firmware installation one should always rum M502 and M500, and so I did.
Thanks for the good work, but the boards are scrapped now and I will move on with LERDGE K boards now.

oldman4U, 2020-12-16:
Perfect. I own two of them.

Maybe you want to close this ticket once you don’t need it anymore.

Thank you

Ed van den Enden <notifications@github.com> schrieb am Mi. 16. Dez. 2020 um
08:42:

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

oldman4U, 2020-12-16:
Thank you

Happy printing

Ed van den Enden <notifications@github.com> schrieb am Mi. 16. Dez. 2020 um
13:46:

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

Closed 2020-12-16.

Thread 181 (2020-11-23):

NTC 3950 100K Thermistor Wrong Temps

HorstHardcore, 2020-11-23:
With the recent firmware i couldnt get the thermistor working properly. Its a NTC 3950 100K Thermistor and i am supposed to use this entry in FW:

11 : 100k beta 3950 1% thermistor (Used in Keenovo AC silicone mats and most Wanhao i3 machines) (4.7k pullup)

so my entry in FW looks like this:

#define TEMP_SENSOR_0 11

For my older FW this worked as intended. Now, at room temp, the thermistor tells me like 100°C and i cant figure out, what is going wrong.

Old FW was a Marlin 2.0.x bugfix version which is at least 7 months old, new version is the recent one here (2 months old)

Any ideas?

oldman4U, 2020-11-23:
Only GadgetAngel can help you👼

HorstHardcore, 2020-11-24:
I have seen, that there were made changes in all the thermistor tables in the newer FW version. But i cant figure out, if and how this affects me and how i could solve this problem in general. So please @GadgetAngel help me :)

HorstHardcore, 2020-11-25:
Well, i finally found out, what the problem was. And i didnt expect that. I downloaded the latest FW version here and there were some major changes to the arrangement of the pin files for this board. In my older FW, all the pin settings for this board were in just one file. In the newer one, they were (probably because the newer SKR Pro 1.2) seperated into "pins_BTT_SKR_PRO_common.h" and "pins_BTT_SKR_PRO_V1_1.h" and inside of ""pins_BTT_SKR_PRO_common.h" is the problem. Someone made this:

#define TEMP_0_PIN                          PF7   //PF4   // T1 <-> E0
#define TEMP_1_PIN                          PF5   // T2 <-> E1
#define TEMP_2_PIN                          PF6   // T3 <-> E2
#define TEMP_BED_PIN                        PF3   // T0 <-> Bed

But when u check the pins of the 1.1 Pro, u can see, that PF7 is part of the "extension pins" and PF4 is supposed to be the original pin for the thermistor and within the older FW PF4 was set to TEMP_0_PIN. So i changed it back to

#define TEMP_0_PIN                          PF4   // T1 <-> E0
#define TEMP_1_PIN                          PF5   // T2 <-> E1
#define TEMP_2_PIN                          PF6   // T3 <-> E2
#define TEMP_BED_PIN                        PF3   // T0 <-> Bed

Now at least this Problem is solved and my NTC 3950 is working as intended again. Maybe some1 with more knowledge about github could check that, so that other ppl dont run into this problem. I am not sure, if PF7 set to TEMP_0_PIN is the way it should be in here.

GadgetAngel, 2020-12-02:
I just saw you request.  Glad you were able to figure it out without my help.  Yes, the boards have changed.  There must of been a reason for the PIN swap that you experienced.  Sorry you had the frustration.  Merry Christmas!

Closed 2020-12-02.

Thread 183 (2020-12-08):

BIGTREE_SKR_PRO, Oops! Make sure you have the LPC1768 environment selected in your IDE.

jlmxyz, 2020-12-08:
**version used :**
----------------------------------------------------------------------------------------------
```
commit 3327568142f0294fa2b6e69b8b6567fa345ad205 (HEAD -> 2.0.x, origin/HEAD, origin/2.0.x)
Author: Luu Lac <45380455+shitcreek@users.noreply.github.com>
Date:   Tue Dec 1 23:52:09 2020 -0600

    Help hosts when password-locked (#20348)

**product tunning :**
```
-------------------------------------------------------------------------------------------------------------
```
diff --git a/Marlin/Configuration.h b/Marlin/Configuration.h
index db266b524b..6b34ac5b47 100644
--- a/Marlin/Configuration.h
+++ b/Marlin/Configuration.h
@@ -103,13 +103,13 @@
  *
  * :[-1, 0, 1, 2, 3, 4, 5, 6, 7]
  */
-#define SERIAL_PORT 0
+#define SERIAL_PORT 1

 /**
  * Select a secondary serial port on the board to use for communication with the host.
  * :[-1, 0, 1, 2, 3, 4, 5, 6, 7]
  */
-//#define SERIAL_PORT_2 -1
+#define SERIAL_PORT_2 -1

 /**
  * This setting determines the communication speed of the printer.
@@ -127,7 +127,7 @@

 // Choose the name from boards.h that matches your setup
 #ifndef MOTHERBOARD
-  #define MOTHERBOARD BOARD_RAMPS_14_EFB
+  #define MOTHERBOARD BOARD_BTT_SKR_V1_1
 #endif

 // Name displayed in the LCD "Ready" message and Info menu
diff --git a/platformio.ini b/platformio.ini
index 0abb4ac388..e7f10acfe7 100644
--- a/platformio.ini
+++ b/platformio.ini
@@ -18,7 +18,7 @@
 [platformio]
 src_dir      = Marlin
 boards_dir   = buildroot/share/PlatformIO/boards
-default_envs = mega2560
+default_envs = BIGTREE_SKR_PRO
 include_dir  = Marlin
```

---------------------------------------------------------------------------------------
**when I try to build the target, I get the following error :**
---------------------------------------------------------------------------------------
```
Compiling .pio/build/BIGTREE_SKR_PRO/src/src/HAL/STM32/Sd2Card_sdio_stm32duino.cpp.o
In file included from Marlin/src/HAL/STM32/../../inc/../pins/lpc1768/pins_BTT_SKR_V1_1.h:236,
                 from Marlin/src/HAL/STM32/../../inc/../pins/pins.h:394,
                 from Marlin/src/HAL/STM32/../../inc/MarlinConfig.h:34,
                 from Marlin/src/HAL/STM32/HAL.cpp:28:
Marlin/src/HAL/STM32/../../inc/../pins/lpc1768/pins_BTT_SKR_common.h:29:4: error: #error "Oops! Make sure you have the LPC1768 environment selected in your IDE."
   29 |   #error "Oops! Make sure you have the LPC1768 environment selected in your IDE."
      |    ^~~~~
In file included from Marlin/src/HAL/STM32/../../inc/../pins/lpc1768/pins_BTT_SKR_V1_1.h:236,
                 from Marlin/src/HAL/STM32/../../inc/../pins/pins.h:394,
                 from Marlin/src/HAL/STM32/../../inc/MarlinConfig.h:34,
                 from Marlin/src/HAL/STM32/HAL_SPI.cpp:25:
Marlin/src/HAL/STM32/../../inc/../pins/lpc1768/pins_BTT_SKR_common.h:29:4: error: #error "Oops! Make sure you have the LPC1768 environment selected in your IDE."
   29 |   #error "Oops! Make sure you have the LPC1768 environment selected in your IDE."
      |    ^~~~~
In file included from Marlin/src/HAL/STM32/../../inc/../pins/lpc1768/pins_BTT_SKR_V1_1.h:236,
                 from Marlin/src/HAL/STM32/../../inc/../pins/pins.h:394,
                 from Marlin/src/HAL/STM32/../../inc/MarlinConfig.h:34,
                 from Marlin/src/HAL/STM32/Sd2Card_sdio_stm32duino.cpp:23:
Marlin/src/HAL/STM32/../../inc/../pins/lpc1768/pins_BTT_SKR_common.h:29:4: error: #error "Oops! Make sure you have the LPC1768 environment selected in your IDE."
   29 |   #error "Oops! Make sure you have the LPC1768 environment selected in your IDE."
      |    ^~~~~
In file included from Marlin/src/HAL/STM32/../../inc/../pins/lpc1768/pins_BTT_SKR_V1_1.h:236,
                 from Marlin/src/HAL/STM32/../../inc/../pins/pins.h:394,
                 from Marlin/src/HAL/STM32/../../inc/MarlinConfig.h:34,
                 from Marlin/src/HAL/STM32/MarlinSerial.cpp:22:
Marlin/src/HAL/STM32/../../inc/../pins/lpc1768/pins_BTT_SKR_common.h:29:4: error: #error "Oops! Make sure you have the LPC1768 environment selected in your IDE."
   29 |   #error "Oops! Make sure you have the LPC1768 environment selected in your IDE."
      |    ^~~~~
*** [.pio/build/BIGTREE_SKR_PRO/src/src/HAL/STM32/HAL.cpp.o] Error 1
*** [.pio/build/BIGTREE_SKR_PRO/src/src/HAL/STM32/Sd2Card_sdio_stm32duino.cpp.o] Error 1
*** [.pio/build/BIGTREE_SKR_PRO/src/src/HAL/STM32/MarlinSerial.cpp.o] Error 1
*** [.pio/build/BIGTREE_SKR_PRO/src/src/HAL/STM32/HAL_SPI.cpp.o] Error 1
============================== [FAILED] Took 16.24 seconds ==============================

```
------------------------------------------------------------------------------------------

GadgetAngel, 2020-12-10:
In Platformioini file ensure default_envs= BIGTREE_SKR_PRO

In configuration.h ensure MOTHERBOARD BOARD_BTT_SKR_PRO_V1_1

Looks like you have MOTHERBOARD BOARD_BTT_SKR_V1_1.

BOARD_BTT_SKR_V1_1 is not BOARD_BTT_SKR_PRO_V1_1

jlmxyz, 2020-12-10:
OK my mistake, I was misslead by the hit that is given when MOTHERBOARD is set to BIGTREE_SKR_PRO as said in https://github.com/bigtreetech/BIGTREETECH-SKR-PRO-V1.1/blob/master/manual/BIGTREETECH%20SKR%20PRO%20V1.1%20guide%202019%20-%201.pdf while compiling it said that it's deprecated and that I should use BOARD_BTT_SKR_V1_1 instead....
compilation was successfull! thanks, now I can begin tunning for my project!

Closed 2020-12-10.

Thread 187 (2021-01-10):

TMC init error with TMC2209

eeyoredave, 2021-01-10:
Hi there,

I am trying to configure the 1.2 board for use on a Voron 2.4 running Klipper. I seem to have everything going well until I boot up with the motors connected. This is the error I get within Octopi: "Unable to read tmc uart 'stepper_x' register IFCNT Once the underlying issue is corrected, use the "RESTART" command to reload the config and restart the host software. Printer is halted" and when I check the log, I get the "TMC init error".

Have checked the voltages and the jumpers and appears to be correct. But has my motor cables connected wrong way? But the error still occurs after I unplug all the motor cables.

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
)

GadgetAngel, 2021-01-12:
Please check this out maybe it can help: https://github.com/KevinOConnor/klipper/issues/2741

oldman4U, 2021-01-12:
Hi GadgetAngel, long time no "see". Hope you are doing fine!

Maybe not related, maybe it is...: https://github.com/MarlinFirmware/Marlin/pull/20731

Wish you the best

NovaViper, 2021-01-13:
I'm having the same issue on mine aswell! The oddest thing is for me however is that UART+Sensorless homing works perfectly on Marlin

NovaViper, 2021-01-13:
OH! I just fixed the issue! Make sure you *do not* have the `tx_pin` parameter declared! The UART+sensorless homing configuration for TMC2209s should look like this
```
[tmc2209 stepper_x]
uart_address: 0
uart_pin: PC13
run_current: 0.760
hold_current: 0.500
stealthchop_threshold: 250
diag_pin: PB10
driver_SGTHRS: 100
```

eeyoredave, 2021-01-14:
Thanks for the suggestions... I had not used the tx_pin either, so that did not help. I've checked the two suggested threads and it did not help. I have given up for the moment, and gone to a SKR-1.4 turbo board, and it works well with the same TMC2209 chips installed. I have got the printer working with the motors, so I am not sure if it is an issue with the Pro hardware or the firmware.

Was there a GPIO pin setting that I needed to enable on the Pro to get it working? I know for the SKR-1.4 I had to compile the GPIO state as !P2.9 and SKR mini-E3 !PC13, which is the "USB_CONN". But I could not find the corresponding pin on the Pro, perhaps someone can point me to that pin?

GadgetAngel, 2021-01-14:
@eeyoredave please post your config file for klipper

Thread 188 (2021-01-13):

bad temperature bed/hotend 89°/93° even disconnected !!!

trokie, 2021-01-13:
hello, i have a problem
my card does not give me the right temperature, even without connecting the probes, I noticed that by unplugging the two probes that the temperature remained high and remembered my last action, I brushed off my wire on the nozzle, after research I saw that I would apparently create a shunt between the probe is the hotend therefore the problem and good material,I have checked all the resistors and capacitor of the pins t0 / t1 / t2 / t3 they are all good except t2 which gives 288ohm (but I only use t0 / t1) A component is burnt but which one?thank you.

trokie, 2021-01-16:
I had submitted the problem to the brand who confirmed to me that it is the cpu which is faulty, good to change, they will send me another, I will all the same tried the saved it will be used for another Project, I just ordered remains more than.

Thread 189 (2021-01-15):

USB not working with Marlin

StefT7, 2021-01-15:
Hello,
I'm unable to speak with my card using USB cable.
Using this project or last Marlin project, nothing to do, each firmware.bin generated and uploaded has the same problem. I can create and open a connection using powershell commands, I can send M115 command but I can't read any resulting output.
It's not an hardware problem because original firmware stored in SD card well know USB, same test with that firmware was good.
If you look inside this original firmware, you see that it was compiled using BLACK_F407VE card
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

So, is anybody could help me to compil Marlin and make USB working well with BigTree_SKR_Pro?

StefT7, 2021-01-17:
Without any debuging solution I decided to make green led to blink at some break points.
I found that the problem is that lineState propertie is always false. If I don't test lineState value in CDC_connected everything works well.
Someone could tell me how this lineState works?

HTTYD9, 2021-04-28:
Marlin bug fix 2.0.8
TFT 2.0.5.4

Skr Pro v1.1
TFT35 V3.0
TMC2209

I followed instructions but still unable to print from usb pen drive via skr pro v1.1 and when i insert pendrive in TFT35 V3.0 still shows error .

pendrive is formatted to FAT32 , i even try exFAT  but no luck
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

ivanroberto, 2021-05-27:
Hi, I figure it out how it need to be setup:

Put jumpers on HOST, and all options like picture above.

With Marlin 2.0.8.1, in configuration_adv.h, i made more two changes:
#define USB_FLASH_DRIVE_SUPPORT
  #define USE_OTG_USB_HOST

And compile with enviroment: BiGTREE_SKR_PRO_usb_flash_drive
I did this using Platformio

I hope it helped you

svd05, 2022-01-17:
Hi. What you mean when said ?
>  i made more two changes
What you are did more ?
You have the same environments in stm34f4.ini ?
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
If I compiling without flag "DUSBCON" I have error:
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

Thread 190 (2021-01-18):

SKR-PRO-V1.2 with TFT 35 V2 and Marlin 2

JanHH2019, 2021-01-18:
I've searched the net for hours and haven't found anything breakable. I can't get my SKR Pro 1.2 and the TFT 35 V2 to work. No matter what I enter in configuration.h for Marlin 2.0, I always get the message "No printer attched". What do I have to enter for serial_port and serial_port2?

Even my attempts to reach the SKR board via Ponterface from my computer don't really work. I once managed to establish a connection but that only worked once.
if I set serial_port to -1 and turn off serial_port_2 it works with the connection. as soon as I switch on serial_port_2 and no matter what, nothing works anymore.

I'm angry now that I even took a SKR board.

JanHH2019, 2021-01-18:
Now the board seems to be finally over. I can do what I want, I can no longer get in touch with ponterface. the computer recognizes the com port STM Virtual com port, but ponterface no longer connects

JanHH2019, 2021-01-18:
now i have activated the original firmware from the sd card that came with the board. and so the tft35 V2 works and also the connection to the computer and ponterface.
Now the big question is how does the configuration in the marlin have to look like so that it works

oldman4U, 2021-01-18:
Check the ReadMe on the first page of the TFT firmware repository for more information.

JanHH2019, 2021-01-18:
Thanks for this helpful information ....
and yes i read that, but that doesn't help me a bit.

Connect the TFT to the Mainboard
Do the following, to be able to use the touchmode of your screen.

Connect the 5pin serial cable according to the manual of your mainboard.
Define a serial port in Marlin, to activate the port used by the TFT.
Make sure the same BAUDRATE is defined in Marlin and the firmware of your TFT (config.ini)

Unfortunately, it doesn't say which com port the tft connection is in the instructions for the SKR 1.2 Pro

 * Select the serial port on the board to use for communication with the host.
 * This allows the connection of wireless adapters (for instance) to non-default port pins.
 * Serial port -1 is the USB emulated serial port, if available.
 * Note: The first serial port (-1 or 0) will always be used by the Arduino bootloader.
 *
 * :[-1, 0, 1, 2, 3, 4, 5, 6, 7]
 */
#define SERIAL_PORT -1

/**
 * Select a secondary serial port on the board to use for communication with the host.
 * :[-1, 0, 1, 2, 3, 4, 5, 6, 7]
 */
#define SERIAL_PORT_2 1

oldman4U, 2021-01-18:
Try 1

JanHH2019 <notifications@github.com> schrieb am Mo. 18. Jän. 2021 um 23:02:

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

JanHH2019, 2021-01-18:
Ok ...
#define SERIAL_PORT -1
#define SERIAL_PORT_2 1
that is my current attitude and that does not work ....

oldman4U, 2021-01-18:
And baudrate is the same?

Cable?

JanHH2019 <notifications@github.com> schrieb am Mo. 18. Jän. 2021 um 23:18:

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

JanHH2019, 2021-01-19:
the baud rate is the same, the cable seems optically ok.
have now tried a new marlin version. now it works every now and then. have now made several new versions to adjust the direction of the axes and the limit switches. but as I said, sometimes it works and sometimes it doesn't. extremely unreliable and strange system

oldman4U, 2021-01-19:
Most likely a cable problem

JanHH2019 <notifications@github.com> schrieb am Di. 19. Jän. 2021 um 07:43:

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

oldman4U, 2021-01-19:
Or something else connected to the display or mainboard causes this. In software only the serial port and baud rate is relevant for your setup.

JanHH2019, 2021-01-19:
thank you for your help. i found the mistake by accident. the SD card is defective and apparently he could not read the entire bin file. I noticed that because I wanted to rename the .CUR version and he told me that it was a 0 byte file. my attempt to format the SD card failed. with a new sd card it works right away.

oldman4U, 2021-01-19:
Great!

Happy printing

JanHH2019 <notifications@github.com> schrieb am Di. 19. Jän. 2021 um 12:10:

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

Closed 2021-01-19.

Thread 191 (2021-01-18):

SKR_PRO_V1.1 Marlin 2.0 SKR-PRO LAYER SHIFTING

luckyscustomleather, 2021-01-18:
I have installed the SKR-PRO-V1.1 and the TFT35 V3.0 to my Tornado Tevo Printer, managed to get everything working well with the exception of random but constant layer shifting on Y axis.

I have tried modifying the Config files as recommended on various other sites that seem to be having this problem with Marlin 2.0.
I have tried to lower the movement speed by 25%
And still no changes,

Is there ant issues in my configs, or is this a Marlin 2.0 bug, in which case does anyone have Marlin 1.1.9 for a SKR_PRO_V1.1?

I have attached my Config files,
[advanced_configuration.h.txt](https://github.com/bigtreetech/BIGTREETECH-SKR-PRO-V1.1/files/5831860/advanced_configuration.h.txt)
[configuation.h.txt](https://github.com/bigtreetech/BIGTREETECH-SKR-PRO-V1.1/files/5831861/configuation.h.txt)

radek8, 2021-01-20:
You're using a pretty old Marlin.
I would not downgrade to version 1.1.9
I would upgrade to the latest versions.

luckyscustomleather, 2021-01-28:
> You're using a pretty old Marlin.
> I would not downgrade to version 1.1.9
> I would upgrade to the latest versions.

Hi, I am will try this and see what can be done.

radek8, 2021-01-28:
If the Y-axis step is lost, check the current at the Y motor

radek8, 2021-01-28:
800mA, that could be OK

luckyscustomleather, 2021-02-02:
Hello Radek8, thank you I have tried this and the same results, what I have done now is buy some TMC2209 steppers and am now trying to configure these in UART. with Sensor less homing for x and y, I am not sure the SKR-Pro-V1.1. supports these yet properly.

radek8, 2021-02-02:
TMC22069 drivers are great, I have them too :+1:

luckyscustomleather, 2021-02-02:
Are you using them on the skr pro v1.1? If so can you offer some Config settings to get them to work in UART?

radek8, 2021-02-02:
No . I have SKRV1.4
You have to have it right.
- fitted jumpers and on the SKR board
- jumpers on 2209 controllers (if not from production)
- Configured Marlin
Then it must work

radek8, 2021-02-02:
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

radek8, 2021-02-02:
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

radek8, 2021-02-02:
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

radek8, 2021-02-02:
Set motor currents X Y Z E
  #if AXIS_IS_TMC (X)
     #define X_CURRENT 700

uncoment
 #define STEALTHCHOP_XY
  #define STEALTHCHOP_Z
  #define STEALTHCHOP_E
 #define CHOPPER_TIMING CHOPPER_DEFAULT_24V   // or12V?
 #define MONITOR_DRIVER_STATUS
 #define HYBRID_THRESHOLD

  #define X_HYBRID_THRESHOLD     100  // [mm/s]
  #define Y_HYBRID_THRESHOLD     100
  #define Z_HYBRID_THRESHOLD       3
  #define E0_HYBRID_THRESHOLD     30
  #define E1_HYBRID_THRESHOLD     30
  #define TMC_DEBUG

Roman-ru, 2021-03-12:
I have a similar problem, the printer seems to change the steps on the axis y and the detail gives more, although from the beginning the printing starts normally.

Thread 192 (2021-01-21):

Z height incorrect

TimListon, 2021-01-21:
I'm not sure where the right place to get assistance is so I'm starting here. If someone has a recommendation of somewhere else to go I'd appreciate that info as well.

I recently swapped out my board with a Bigtreetech SKR Pro 1.2 and a TFT E3 v3 display with my BLTouch. I've compiled Marlin 2.0 Bugfix and provided a link to the config files below.

[Configuration_adv.h.txt](https://github.com/bigtreetech/BIGTREETECH-SKR-PRO-V1.1/files/5852579/Configuration_adv.h.txt)
[Configuration.h.txt](https://github.com/bigtreetech/BIGTREETECH-SKR-PRO-V1.1/files/5852580/Configuration.h.txt)

The picture is the result of running the following commands:
G28
G28 Z
G1 F60 Z0

The problem is that whenever I home to Z0 the nozzle ends roughly 20-25mm off the build plate.
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

I was able to create a mesh by disabling the steppers and moving the nozzle closer to the bed and then initiating a G29, but if I try to run G29 after G28 the process errors out because it is limited to traveling 20mm to find the build plate. I could increase this but it seems like it should be starting closer to the build plate to begin with.

Perhaps I'm not searching on the right terms to find the answer, but I've been trying to troubleshoot this for about 3 days (on and off).

schnello, 2021-02-02:
Hi.

Take a look at:
#define DEFAULT_AXIS_STEPS_PER_UNIT   { 80, 80, **400**, 96 } // Customized TL

TimListon, 2021-09-24:
I took a break for a while on this, but finally got back around to troubleshooting it.

It appears the problem ended up being that I needed to uncomment the following.
#define USE_PROBE_FOR_Z_HOMING //Customized TL

The printer is now homing correctly and generating its mesh without having to manually move the Z axis closer to the bed.

Closed 2021-09-24.

Thread 193 (2021-02-04):

TFT70 does not connect after reset SKR Pro 1.2

fiveorders, 2021-02-04:
Hello, I am using TFT70 with SKR Pro 1.2 When I reset SKR Pro, TFT does not connect after booting up. It started today. any ideas? Thank you

oldman4U, 2021-02-14:
You can try to connect RS232 only to see if this solves the problem.

oldman4U, 2021-02-25:
Please help the community and close the ticket once you do not need it anymore. Thank you

fiveorders, 2021-02-25:
Same thing happening with the FLY board with 9 stepper drivers. Somehow reset does not function as it should do. I am testing further, will report back later. Closing this now.

EsaJaatinen, 2021-07-07:
Hi

I'm having issues with my SKR pro 1.2 with the reset button also. Everything works ok untill I hit the reset button. After that it seems that Marlin doesn't restart at all.

After reset I can't:
- Get connection to octopi (jumper wires directly to SKR, works normally after off period)
- Win 10 doesn't see stm32 serial port (works normally after off period)
- Hotend cooling fan doesn't start (starts after off period if temperature over threshold)

I'm thinking that either the stm32 or Marlin doesn't start normally.

'ej

EsaJaatinen, 2023-05-27:
Hi

I'm back to the project and still "no printer attached" after hitting the reset button.

I updated Marlin to 2.1.2.1, Octoprint operation works normally, BTT TFT35 find the printer. No connection to either after reset.

Any ideas?

'ej

Closed 2021-02-25.

Thread 195 (2021-03-12):

SKR PRO V1.2 CPU Got Burned

msmorkan, 2021-03-12:
Hi,

I had an SKR PRO V1.2 recently. I tried to configure it using Marlin in this repo. I could not get it working. Then I switched to the Marlin repository (https://github.com/MarlinFirmware/Marlin). I changed drivers to TMC2208 (UART), board to SKR PRO 1.2, increased maximum values of X/Y/Z  and made several changes written in the manual. Then I builded and suprisingly it worked but I have doubt that it is fully correct. Because the orginal firmware (with TMC2209) was 172 KB size, but my firmware is around 103 KB size and this is huge difference.

Then I plugged my step motors and drivers and Bigtreetech TFT43. I have driven X/Y/Z without a problem. heated the bed (60) and nozzle (200) When I tried to extrude some filament. It made and annoying sound wih just vibration no movement. Then it said something like "Printer halted kill called" I resetted both boards and reconnected to board with no problem. After I tried several times I was not able to connect to the mainboard anymore. CPU is getting too hot when I plug the power in proably burned. Also he 3V3 regulator is heating up too much, probably because of burned MCU.

Since TMC2208 drivers are controlled by UART what can cause this problem? We will manufacture 3D printers using SKR PRO so we have to make sure that it wont happen again.

I bought another set of drivers and SKR PRO and I am trying to be very careful to the details.

Here are the 3D printer details:
- 24V 350W power supply (Meanwell)
- Standart hot end.
- double extruder fan
- double cooling fan
- special made extruder block with direct drive
- NEMA17 steppers
- Special made hot bed driven by external mosfet
- 300x300x350 printing area (X/Y/Z)
- CORE XY

In summary here are my questions:
- What can cause burned MCU?
-  In configuration_adv.h file, there is an option with CHOPPER_TIMING and it is set to CHOPPER_DEFAULT_12V. Should I change it to 24V since my power supply is 24V?
- Why the firmware file size is shrinked to 103 KB?
- I sometimes get "unknown command error", how can I prevent screen sending unknown commands to the mainboard?
- For default settings with the given details; Which features should I enable and Which registers should I change to print something without a problem?

Thanks a lot
Have a nice day
Suat

oldman4U, 2021-03-12:
Hi

CHOPPER_DEFAULT_24V is correct in your case.

My experience with this board is very good compared to SKR V1.4, especially when it comes to robustness.

msmorkan, 2021-03-13:
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

Hello,

thanks for the tip. Do you have any thoughts about the other questions?

Thanks

oldman4U, 2021-03-13:
Printer halted I saw from broken thermistor.

Replace mainboard and drivers if you don't know what the problem was.

I use SKR PRO v1.1 with BTT 2208 UART and it works great.

Thread 202 (2021-05-11):

SKR Pro board + TMC2208 Coil Short Circuit

NovaViper, 2021-05-11:
Hey guys, lately on my SKR V1.1 Pro board, I've been getting this strange `coil short circuit` error with my TMC2208 drivers (which are on my Extruder and Z axis). I've gone and checked the wiring and those were fine, motor is fine too. Anyone knows why this is happening?

```
Recv: E driver error detected: 0x1075052576.0000000000000000
Recv: coil short circuit
Recv:         X    Y    Z    E
Recv: Address        0    0
Recv: Enabled        true    true    true    true
Recv: Set current    760    760    760    650
Recv: RMS current    734    734    734    642
Recv: MAX current    1035    1035    1035    905
Recv: Run current    23/31    23/31    23/31    20/31
Recv: Hold current    11/31    11/31    11/31    10/31
Recv: CS actual    23/31    23/31    23/31    20/31
Recv: PWM scale
Recv: vsense        1=.18    1=.18    1=.18    1=.18
Recv: stealthChop    true    true    true    true
Recv: msteps        16    16    16    16
Recv: interp        true    true    true    true
Recv: tstep        222    528    65535    3036
Recv: PWM thresh.
Recv: [mm/s]
Recv: OT prewarn    false    false    false    false
Recv: triggered
Recv:  OTP        false    false    false    false
Recv: pwm scale sum    51    50    42    61
Recv: pwm scale auto    0    0    1    0
Recv: pwm offset auto    47    54    55    92
Recv: pwm grad auto    15    13    21    19
Recv: off time    4    4    4    4
Recv: blank time    24    24    24    24
Recv: hysteresis
Recv:  -end        2    2    2    2
Recv:  -start        1    1    1    1
Recv: Stallguard thrs    100    100
Recv: uStep count    663    870    152    236
Recv: DRVSTATUS    X    Y    Z    E
Recv: sg_result    226    62
Recv: stst        *    *    *    *
Recv: olb
Recv: ola
Recv: s2gb
Recv: s2ga
Recv: otpw
Recv: ot
Recv: 157C
Recv: 150C
Recv: 143C
Recv: 120C
Recv: s2vsa
Recv: s2vsb                    *
Recv: Driver registers:
Recv:         X    0xC0:17:00:00
Recv:         Y    0xC0:17:00:00
Recv:         Z    0xC0:17:00:00
Recv:         E    0xC0:14:00:20
Recv:
Recv:
Recv: Error:Printer halted. kill() called!
Changing monitoring state from "Printing" to "Error"
Send: M112
Send: N11454 M112*36
Send: N11455 M104 T0 S0*37
Send: N11456 M140 S0*98
```

radek8, 2021-08-01:
Check the stepper motor coils.
If the engines are OK. Try to comment in the Marlin configuration
#define CLASSIC_JERK
this will enable Junction Deviation
and you could get rid of the mistake.

Thread 204 (2021-05-30):

skr pro v1.2 + heat bed ender 3 220w 24vdc

dec3003, 2021-05-30:
hello i read in the manual that is maximum 180W power bed with at minima 0.8ohms for resistance from bed,
the bed from ender 3 is a 2.8 ohm 220w 24 vdc
if i calculate Amp:
24/2.8= ~8.6A
if we compare that with a bed 180W 12vdc:
12/0.8= 15A
so we are under max Amp with ender bed configuration

so i can use this heat bed (ender 3 220w)
can you confirm it please

radek8, 2021-05-30:
Used Mosfet WSK220N04 is designed for 220A with ideal cooling.
A 20A fuse is used in the connection.
So your 8.6A is fine.

dec3003, 2021-05-30:
thank you
i just burned one mother board skr pro today an search about the bad thing i have done,
so that's not with the bed ^^

radek8, 2021-05-30:
I also have Ender3
I replaced the board with SKR V1.4 turbo.
It uses the same Mosfet and works well for several months.
What burned down?

radek8, 2021-05-30:
Isn't the problem just in fuse?

dec3003, 2021-05-31:
the stm32f maked some smoke, i heard some sparks,
but at first look i dont found what's happened , i finish to found a burned driver (tmc2130) and a pin burned on the stm32f
i define it in configuration.h it's the z motor who burned, but when i look on the stm32 (mcu) its de pin PA3 who was fondue E1 motor
i wait for my new motherboard for friday and i m a little affraid about make burn it again

i maked an update about motors i changed the z with a tmc and add a tmc on e1, before that was the a4988,

maybe remove drivers, make the update, and put in the driver again is better.

radek8, 2021-05-31:
If you had incorrectly configured stepper motor controllers in Merlin, they could be overloaded with a large current and the controller and board chip could burn out.

dec3003, 2021-05-31:
i think that was happened, i taken a look at my configuration.h i have forgotten the jumper on the E1 driver they was  like a4988

Closed 2021-05-30.

Thread 205 (2021-06-05):

SKR PRO v1.2 Neopixel M150 son't work

dec3003, 2021-06-05:
hello
i try to make working neopixel ws2812b, i put 7 neopixel on th bottom of the hotend  and  20 neopixel on the top 2020 profile
i use the pin PD5
i use a DC-DC Buck 24vdc->5vdc (12A[60W]) to power up a RPI3 (15W) and the Neo-pixel (27*0.6= 18W)
i put a 560 ohms led in serie from PD5 to data IN

in marlin i wrote:
`// Support for Adafruit NeoPixel LED driver
#define NEOPIXEL_LED
#if ENABLED(NEOPIXEL_LED)
  #define NEOPIXEL_TYPE   NEO_GRB // NEO_GRBW / NEO_GRB - four/three channel driver type (defined in Adafruit_NeoPixel.h)
  #define NEOPIXEL_PIN     PD5     // LED driving pin
#define NEOPIXEL_PIXELS 27       // Number of LEDs in the strip. (Longest strip when NEOPIXEL2_SEPARATE is disabled.)
  #define NEOPIXEL_IS_SEQUENTIAL   // Sequential display for temperature change - LED by LED. Disable to change all LEDs at once.
  #define NEOPIXEL_BRIGHTNESS 255  // Initial brightness (0-255)
  #define NEOPIXEL_STARTUP_TEST  // Cycle through colors at startup
// Use some of the NeoPixel LEDs for static (background) lighting
  #define NEOPIXEL_BKGD_INDEX_FIRST  0              // Index of the first background LED
  #define NEOPIXEL_BKGD_INDEX_LAST   7             // Index of the last background LED
  #define NEOPIXEL_BKGD_COLOR { 255, 255, 255, 0 }  // R, G, B, W
  #define NEOPIXEL_BKGD_ALWAYS_ON                   // Keep the backlight on when other NeoPixels are off

 #define LED_CONTROL_MENU
  #if ENABLED(LED_CONTROL_MENU)
    #define LED_COLOR_PRESETS                 // Enable the Preset Color menu option
    //#define NEO2_COLOR_PRESETS              // Enable a second NeoPixel Preset Color menu option
    #if ENABLED(LED_COLOR_PRESETS)
      #define LED_USER_PRESET_RED        255  // User defined RED value
      #define LED_USER_PRESET_GREEN      128  // User defined GREEN value
      #define LED_USER_PRESET_BLUE         0  // User defined BLUE value
      #define LED_USER_PRESET_WHITE      255  // User defined WHITE value
      #define LED_USER_PRESET_BRIGHTNESS 255  // User defined intensity
      //#define LED_USER_PRESET_STARTUP       // Have the printer display the user preset color on startup
    #endif
`

i see the start up test all the led change from color the BKGD get ON in white
but the top neopixel don't light on ,even with command M150

i try the bigtreetech neopixel lib and this one:
NEOPIXEL_LED            = NeoPixel=https://github.com/CommandoreBombardiero/Adafruit_NeoPixel/archive/master.zip

did i do a mistake or this is a knew problem?

Thank you for help

dec3003, 2021-06-06:
founded i respond for people who have same problem
i just use an other PIN : PE4
maybe is a different TIM on chipset

Thread 207 (2021-07-08):

SKR pro reset button issue, Marlin/stm32 doesn't seem to start after pressing it

EsaJaatinen, 2021-07-08:
Hi

I'm having issues with my SKR pro 1.2 with the reset button. Everything works ok untill I hit the reset button. After that it seems that Marlin doesn't restart at all.

After reset I can't:

-    Get connection to octopi (jumper wires directly to SKR, works normally after off period)
-    Win 10 doesn't see stm32 serial port (works normally after off period)
-    Hotend cooling fan doesn't start (starts after off period if temperature over threshold)

I'm thinking that either the stm32 or Marlin doesn't start normally.

Any hints are most welcome.

'ej

EsaJaatinen, 2023-05-28:
I'm still having this issue. Using Marlin 2.1.2.1 without any issues with serial to Octoprint and BTT TFT35 from power on start. No glitches, and long prints work ok. Only after hitting the reset button neither raspi or tft cannot find the SKR pro.

Any ideas?

yavinmaster, 2025-01-05:
I've having the same issue after updating from Marlin 2.0.5 to 2.1.2.

Thread 211 (2021-09-12):

SKR PRO v1.1 and REPRAP_DISCOUNT_FULL_GRAPHIC_SMART_CONTROLLER not connecting

cabbagecreek, 2021-09-12:
I have a board that have been in the drawer a wile. This weekend i decided to update my MKS Gen 1.4 to SKR PRO v1.1

I did everything from scratch with a fresh Marlin "Marlin 2.0 with bug fixes" download.

I have an old "REPRAP_DISCOUNT_FULL_GRAPHIC_SMART_CONTROLLER" from the MKS Gen 1.4 setup that is working.
I followed all tutorials that I can find to setup this old "Marlin style" LCD board.

I can't get any response from the LCD. It is black all the time.

When I install the 2 flatcables and press the encoder wheel i hear a beep from the PC and the USB is disconnected. I need to press reset on the SKR Pro board to get USB connected again.

Can this be a broken SKR PRO v1.1 board?

Before sending my congiguration.h and configuration_adv.h I want to get some parts to serach for.

Have done activating the REPRAP_DISCOUNT_FULL_GRAPHIC_SMART_CONTROLLER by uncommenting and get a build done.
The FW is uploaded with SD card. The 3D printer is working but no REPRAP_DISCOUNT_FULL_GRAPHIC_SMART_CONTROLLER

radek8, 2021-09-16:
Note that the SKR and MKS boards have a rotated cutout in the connector on the EXP 1, EXP2 or EXP3 connectors by 180 °.
Check which pins are powered.

cabbagecreek, 2021-09-19:
Marvelous!!
"Standard is a good thing. That´s why all manufacturers create their own"
This will be an easy task to just pull off the IDC10 sockets on the PCB and then turn 180 degrees,
I will be back with the result of this!

cabbagecreek, 2021-09-21:
I turned the sockets on the LCD 180 degrees and put them back on.
The LCD showed the Marlin logo and the LCD was working again.

Thread 212 (2021-09-21):

Bricked board?

luckyfp, 2021-09-21:
So i decided to flash klipper on skr. Everything was just fine. I flashed firmware on board, changed serial on printer.cfg and it worked. I just wanted to check if everything is good so I heated the bed and hot end to like 40 degrees, and then lost connection. It reconnected and then disconnected again. It shows up this "mcu 'mcu': Unable to connect".
I decided to check serial with ls /dev/serial/by-id/* but it says that there is no such file or directory. So i tried to flash the firmware again but nothing happend, it didn't flash; the blue light is off all te time.
I ordered st-link but im curious if anything else could happend?

sealj553, 2022-01-01:
I have a similar situation. I've been running my SKR PRO V1.2 board with Klipper for around 6 months with no issues. At some point last week klippy could not connect to the board and I discovered that I also lost my board under `/dev/serial/by-id/`. I had changed nothing with the wiring at all for months.
`dmesg` shows:
```
[  291.076704] usb 1-1.4: new low-speed USB device number 3 using xhci_hcd
[  291.177009] usb 1-1.4: device descriptor read/64, error -32
[  291.396975] usb 1-1.4: device descriptor read/64, error -32
[  291.616716] usb 1-1.4: new low-speed USB device number 4 using xhci_hcd
[  291.716988] usb 1-1.4: device descriptor read/64, error -32
[  291.936971] usb 1-1.4: device descriptor read/64, error -32
[  292.057428] usb 1-1-port4: attempt power cycle
```
I tried a different pi, no change. Arduino boards still enumerate.

I reflashed the bootloader over serial as described [here](https://github.com/bigtreetech/BIGTREETECH-SKR-PRO-V1.1/issues/115#issuecomment-653814967) and put a freshly formatted microsd card with klipper. Same results.

I need to debug if it's a problem with the klipper firmware or the bootloader or if the STM32 is fried...

sealj553, 2022-01-01:
`FIRMWARE.CUR` is still created on the microsd card, so it doesn't look like my STM32 is fried

sealj553, 2022-01-01:
I compiled a new version of klipper using USART1 (PA10/PA9) (on the TFT header) instead of USB. After hooking it up to my Pi with a FTDI adapter, it is working again.

fabienlacaze, 2022-12-31:
hi seal 553, same issue for me. can you kindly explain more how to "compiled a new version of klipper using USART1 (PA10/PA9) (on the TFT header)"
thanks

Thread 219 (2022-03-16):

Two new Pro v1.2 board wont flash

Mountain3d, 2022-03-16:
Hello,

I am no stranger to the space, I run a CAD/Printing company in Montana. I've followed the very basic steps to flash probably 1000 boards for myself a folks over the years.

I picked up these two skr pro 1.2 boards for my IDEX builds for the store and neither of them will flash fw. I BTT products usually are a massive gamble as many of the ones I've either had or sold has some stupid problem. However these were the best option fir the budget of these builds.

The task? Simple. Flash my proven builds on to these boards and get them installed. I learned a long time ago especially with BTT products to do a "bench flash" before committing to the install and burial of a mabo.

They aren't shipping with SD cards anymore as I know those as generally the best for fw's

I power down, pop in tf card and power up. Nada. I tried the second board, same same. I'm at a total loss how in the h•e•l•l can I get two mabo's that are trash in the exact same way from two different parts of the globe.

If anyone has any insights I would greatly appreciate the help as these two machines are severely overdue.

TIA!

Mountain3d, 2022-03-28:
I figured it out.

Insert SD card in to computer

Type in "diskpart" one word.

Your SD will the last drive available so let's just say 3 for example
.

Type " select disk 3"

The. Upon the next prompt type "clean"

This will.strip the sD. You can close the window now

Now, type "Disk Part" two words this time.

Down at the bottom scroll to the bottom of the window and you will see an
unallocated drive being your SD you just stripped. Right click, format,
fat32, now type in 7024 in the next window for available space. Finish
Finish format. Load your .bin and flash the board.. its got some space cap
for cards idk how or why but this is the trick. Read what I wrote three
times. Follow the steps.

Food luck!

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

Mountain3d, 2022-03-28:
EDIT

SKIPPED A STEP

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

 THEN TYPE "LIST DISK"******

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

SodiumEx, 2022-03-28:
I did what you said and still no luck

Mountain3d, 2022-03-28:
Can you zoom?

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

SodiumEx, 2022-03-28:
Share your marlin if possible

Mountain3d, 2022-03-29:
If your board isn't converting the .bin to .cur then its not the build. Its
simply not reading the card.

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

SodiumEx, 2022-03-29:
> If your board isn't converting the .bin to .cur then its not the build. Its simply not reading the card.
> […](#)
> On Mon, Mar 28, 2022, 4:28 PM SodiumEx ***@***.***> wrote: Share your marlin if possible — Reply to this email directly, view it on GitHub <[#219 (comment)](https://github.com/bigtreetech/BIGTREETECH-SKR-PRO-V1.1/issues/219#issuecomment-1081215545)>, or unsubscribe <https://github.com/notifications/unsubscribe-auth/AVJDJYWPCT7FKGCQGV4UKADVCIW7NANCNFSM5Q4PYROQ> . You are receiving this because you authored the thread.Message ID: ***@***.***>

It does build to .cur . Just won't do anything after
