bigtreetech/BIGTREETECH-SKR-PRO-V1.1/Schematic/SKR-PRO-V1.1（SCH）.pdf

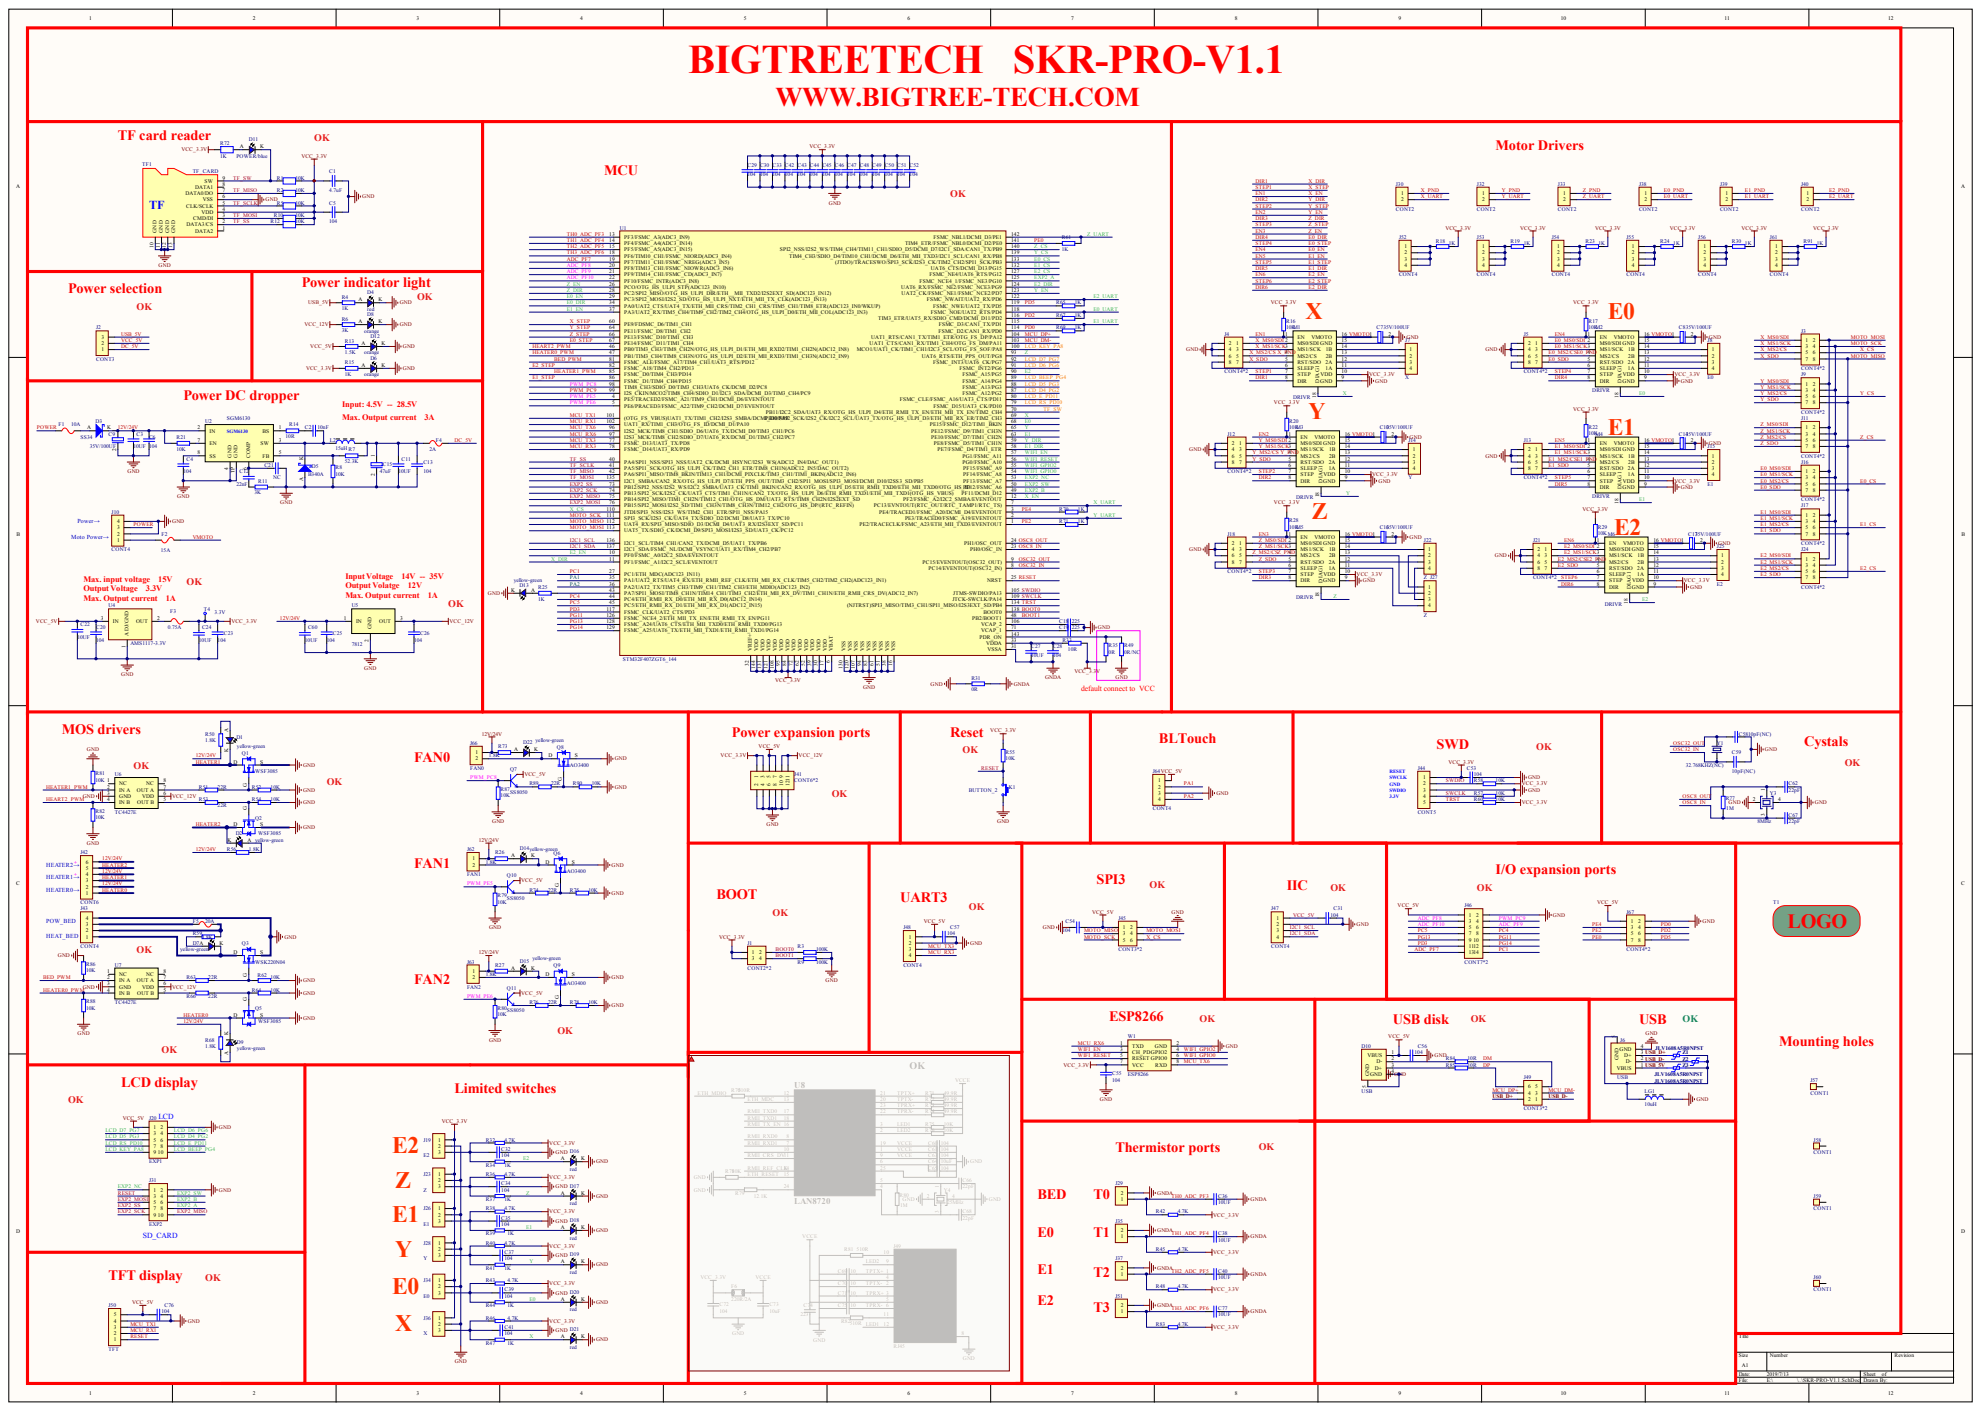
[picture p39: page 1]

WWW.BIGTREE-TECH.COM

Power indicator light Power selection

SWCLK TRST | Z | E2

default connect to VCC
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
