bigtreetech/BIGTREETECH-SKR-PRO-V1.1/SKR-PRO-V1.2/Schematic/SKR-PRO-V1.2.PDF

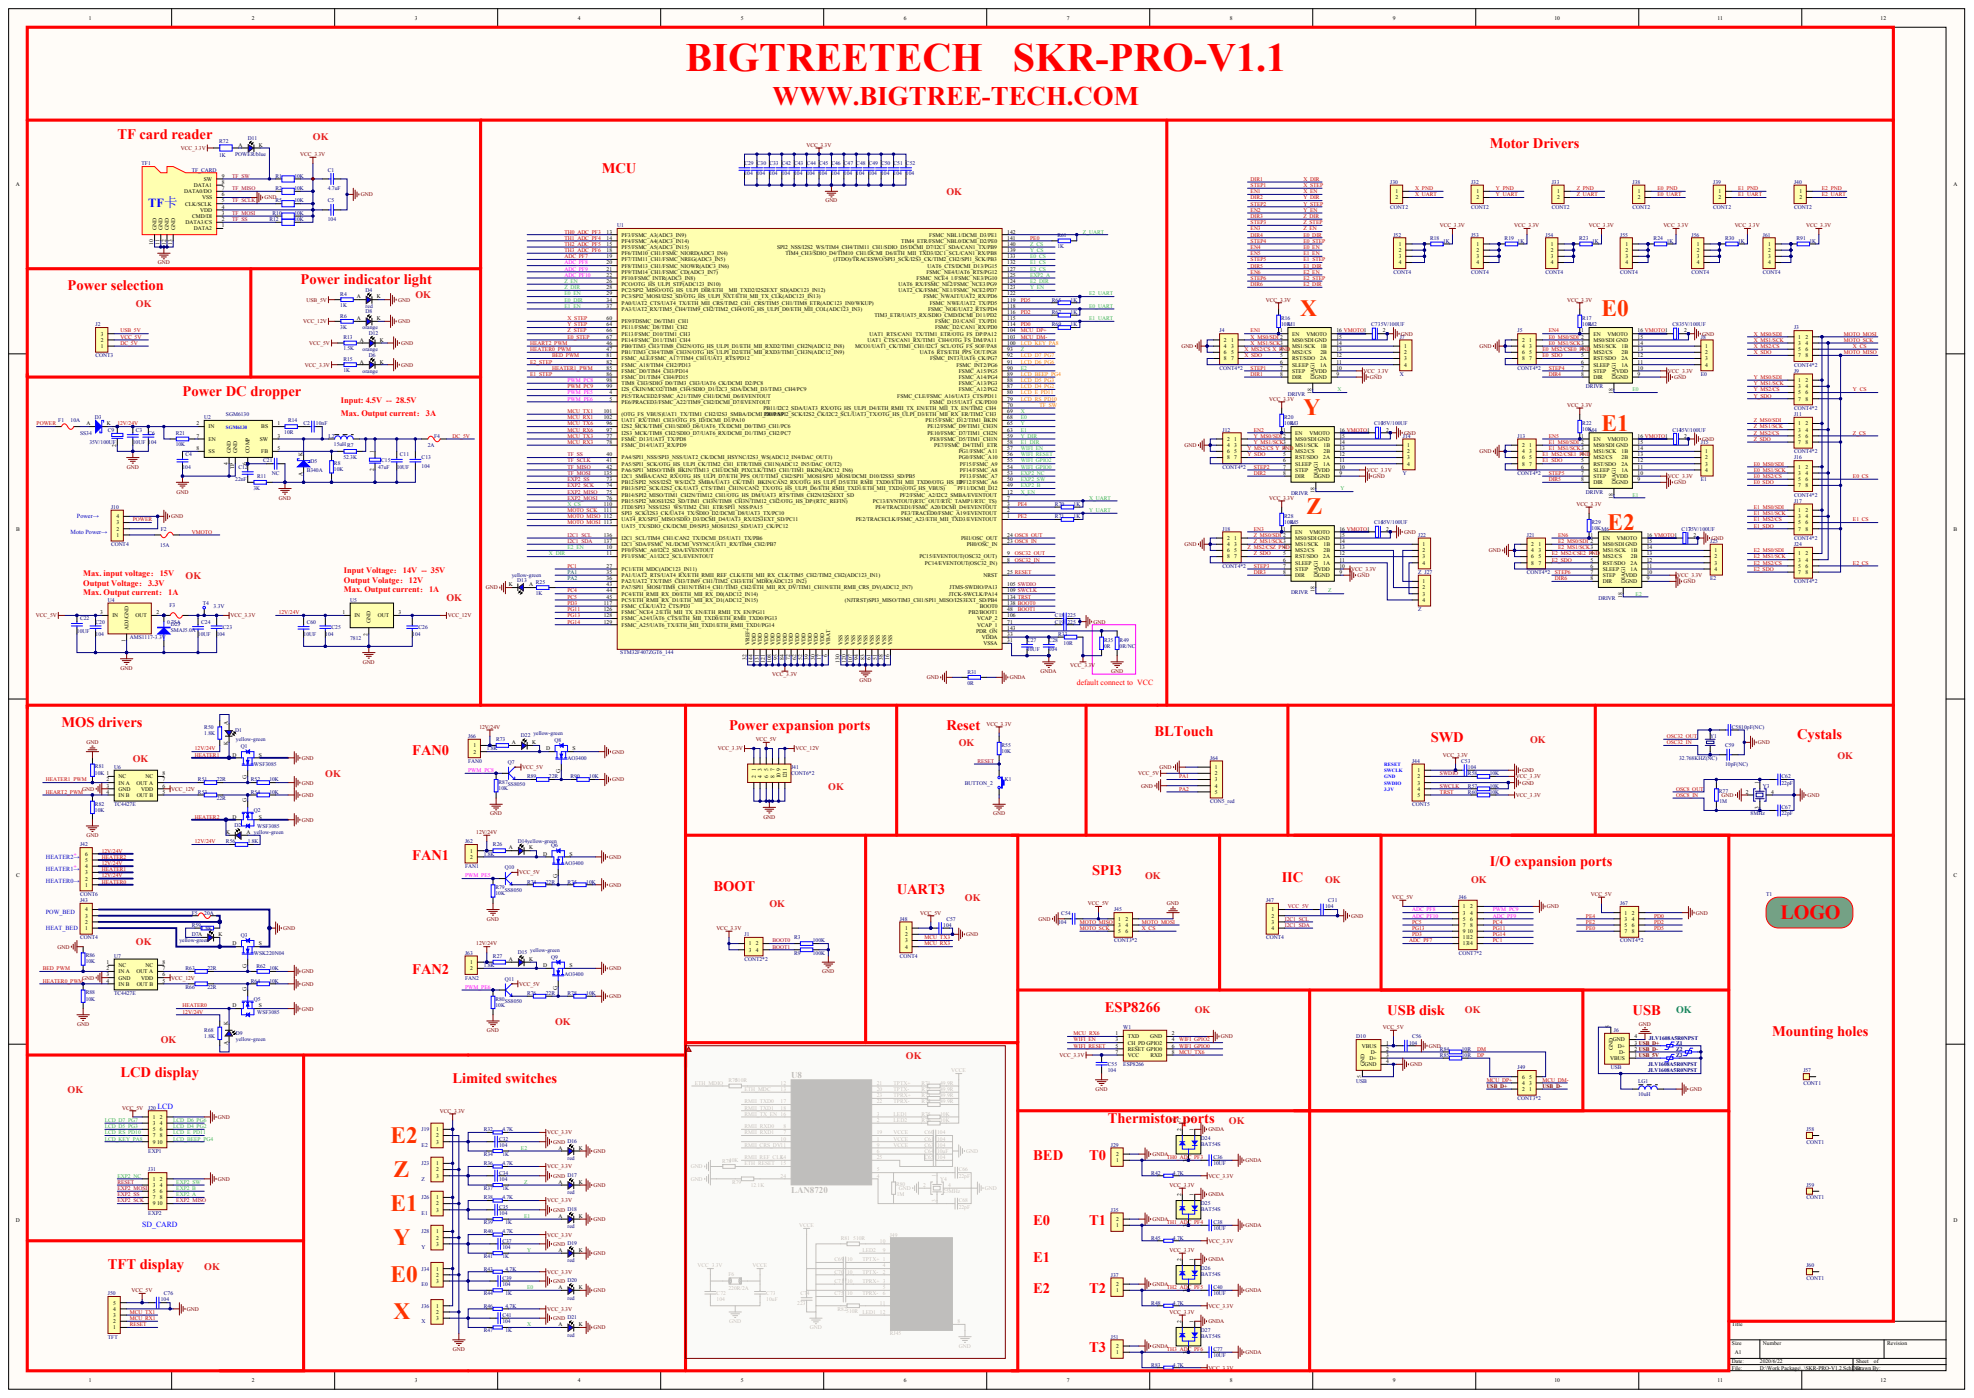
[picture p40: page 1]

WWW.BIGTREE-TECH.COM

Power indicator light Power selection

SWCLK TRST | Z | E2

default connect to VCC

TH3_ADC_PF6 R83 4.7K | VCC_3.3V
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
