bigtreetech/BIGTREETECH-SKR-PRO-V1.1/manual/SKR-PRO-V1.1-Pin.pdf

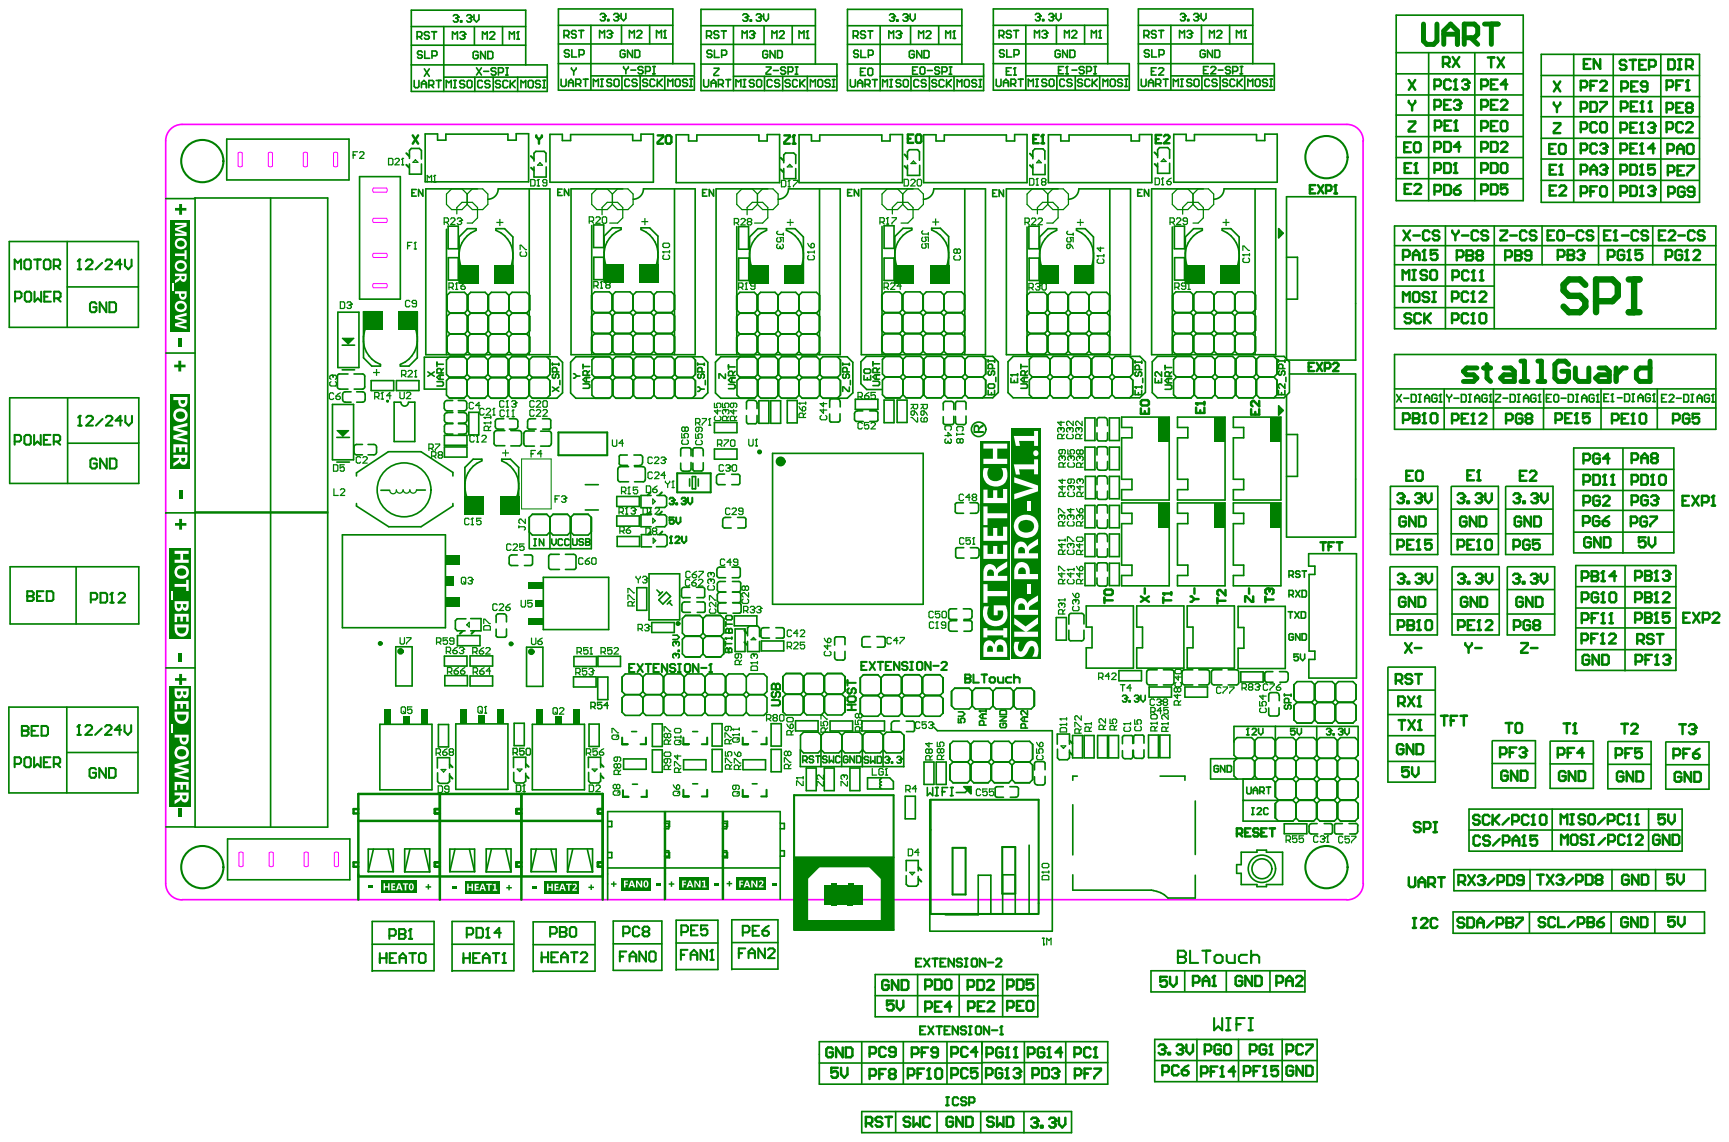
[picture p41: page 1]
