bigtreetech/BIGTREETECH-SKR-PRO-V1.1/SKR-PRO-V1.2/manual/SKR-PRO-V1.2PIN.PDF

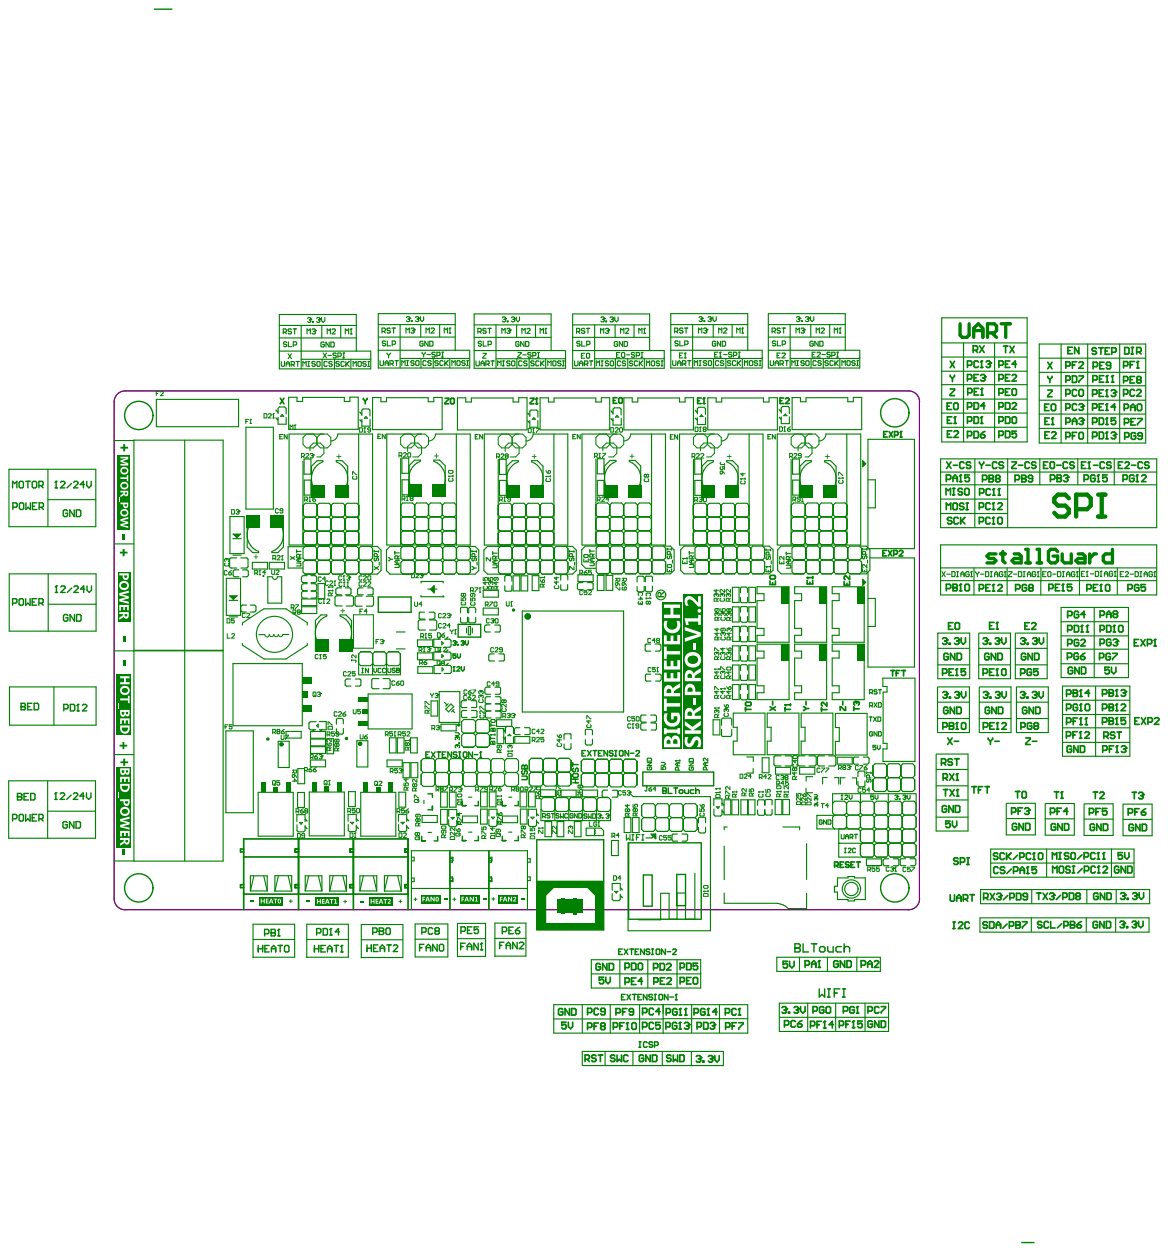
[picture p42: page 1]
