bigtreetech/BIGTREETECH-SKR-PRO-V1.1/(commit log)

2019-07-05 add marlin
2019-07-05 add stl
2019-07-08 add tmc2208/2209 uart
    [Configuration.h, Configuration_adv.h]
2019-07-23 fix stm32 platform verison
2019-09-10 update to lastest Marlin
    [Configuration.h, Configuration_adv.h]
